markjfisher/fujinet-nio-hardware/README.md

# fujinet-nio-hardware
Hardware projects for NIO
