markjfisher/fujinet-nio-hardware/amiga/prototyping-board/fabrication/drill/report.txt

Drill report for zorro-breakout.kicad_pcb
Created on 2026-09-13T18:38:34

Copper Layer Stackup:
    =============================================================
    L1 :  F.Cu                      front
    L2 :  B.Cu                      back

Drill file 'zorro-breakout-PTH.drl' contains
    plated through holes:
    =============================================================
    T1  0.300mm  0.0118"  (136 holes))
    T2  1.000mm  0.0394"  (130 holes))

    Total plated holes count 266

Drill file 'zorro-breakout-NPTH.drl' contains
    unplated through holes:
    =============================================================

    Total unplated holes count 0
