markjfisher/fujinet-nio-hardware/amiga/integrated-a500-r5/review/front-sd/acceptance.md

# R5 single-sided component population accepted

The user approved the front-side C42/C43 candidate. Its reviewed placement,
orientation and labels are now transferred to authoritative R5.

**All 214 footprints are now front-side, enabling single-sided component
population.** Through-hole connectors/headers still require normal underside
soldering; there are no backside-mounted components.

MCP transferred the positions, rotations and labels. Its missing flip operation
was handled with native KiCad Flip for C42/C43 only, as disclosed before editing.
No routing, optimisation, schematic changes or board regeneration occurred.

Independent read-back confirms all 214 footprint records and all other board
objects match the approved candidate, including groups and locks. Only C42/C43
differ from the prior authoritative PCB. Schematic/project/library files remain
byte-identical. Native KiCad reports zero schematic parity issues and the same
reported DRC findings as the approved candidate: four existing J1 hole clearances,
199 capped text-height warnings, one intentional U30 library mismatch, and 499
capped unrouted connections. MCP DRC and audit also ran successfully; audit
findings retain the previously documented bounding-box and boundary limitations.

The approved closeups in this directory remain representative because the
complete footprint geometry and drawings match exactly. Retain the C42/C43
prospective ground vias in verification.json in place of their previous ESP/SD
review sites. No physical vias have been added. Actual copper remains subject
to routing validation.

Evidence: transfer-verification.json. The original verify.py is the pre-transfer
candidate-versus-baseline check; it was run successfully before this transfer
and its historical verification.json is retained.
