markjfisher/fujinet-nio-hardware/amiga/integrated-a500-r5/review/bus-buffers/acceptance.md

# Bus-buffer acceptance and transfer — 2026-11-11

User-approved buffer placement transferred to authoritative R5 via kicad-mcp:
U40–U47, C50–C57 and R50–R53, including reviewed reference positions.
Native KiCad transferred the eight reviewed groups and the reviewed buffer
corridor reservation setting because MCP lacks those operations. No outline,
connector, schematic, net, lock or unrelated footprint changes were made.

Read-back confirms the entire parsed authoritative PCB equals the approved
bus-buffer candidate, including all footprints and non-footprint objects.
[Transfer DRC](../host-protection/transfer-drc.json) exactly matches the accepted
baseline: four J1 hole-clearance errors, 199 text-height warnings, one intentional
U30 library-mismatch warning, 499 unrouted connections, zero parity issues.
See [verification](../host-protection/verification.json) for preservation checks.

Retain the sixteen proposed ground vias and buffer-corridor ownership check.
The current outline is not an absolute limit: propose a modest vertical extension
if later placement needs more room. Approval is required before changing it;
J40's exact mechanical geometry and mating position must remain fixed.
