markjfisher/fujinet-nio-hardware/amiga/integrated-a500-r5/review/indicators/transfer/acceptance.md

# Approved indicator transfer
The user approved the complete LED candidate as-is. Transferred its LED circuit,
11 footprints, service-header/button geometry, labels and groups to authoritative
R5. All 214 footprint S-expressions and all non-net board objects match the
approved candidate; esp.kicad_sch matches byte-for-byte. Other schematic sheets
remain unchanged. No routing.

Used MCP schematic load/save, footprint placement/movement, reference and text
operations, and 24 pad-net assignments. Used native KiCad only for unsupported
new-object identity, library/path binding and group restoration.

Native KiCad DRC with schematic parity: 0 parity issues; 4 existing J1 hole
clearances, 199 reported text-height warnings, 1 intentional U30 library mismatch,
499 reported unrouted connections. Text and unrouted reports are capped; these
counts are not a complete count of affected objects. The approved indicator
candidate already accounts for the additional 0.6 mm reference-height warnings.
Service access remains provisional for enclosure validation.
