markjfisher/fujinet-nio-hardware/amiga/integrated-a500-r4/phase1/board-and-staging.png

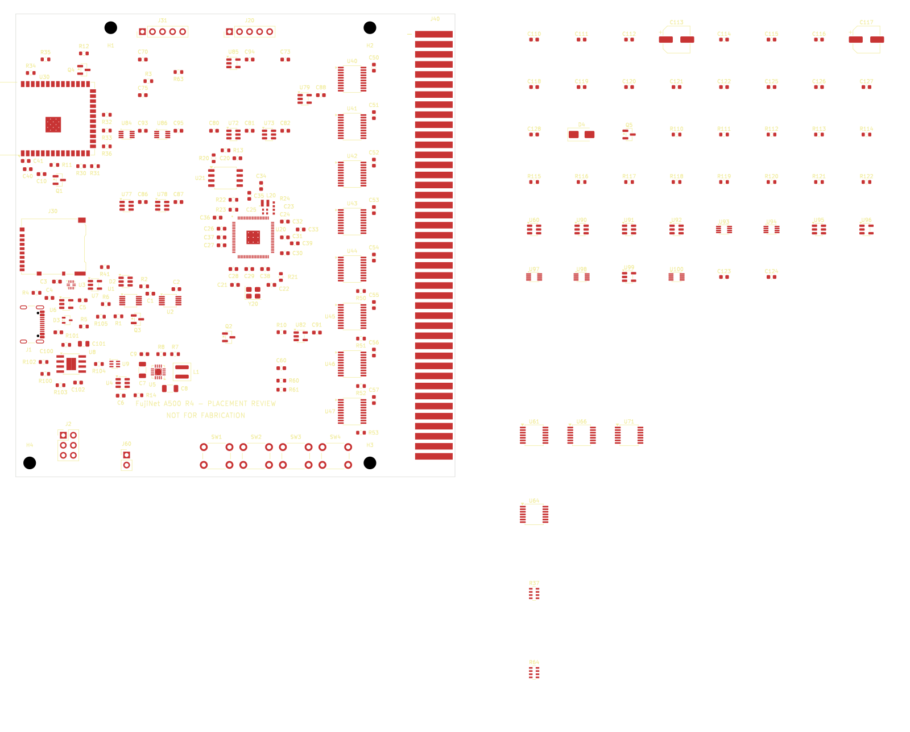
amiga/integrated-a500-r4/phase1/board-and-staging.png
