markjfisher/fujinet-nio-hardware/amiga/integrated-a500-r4/phase1/control-preview.png

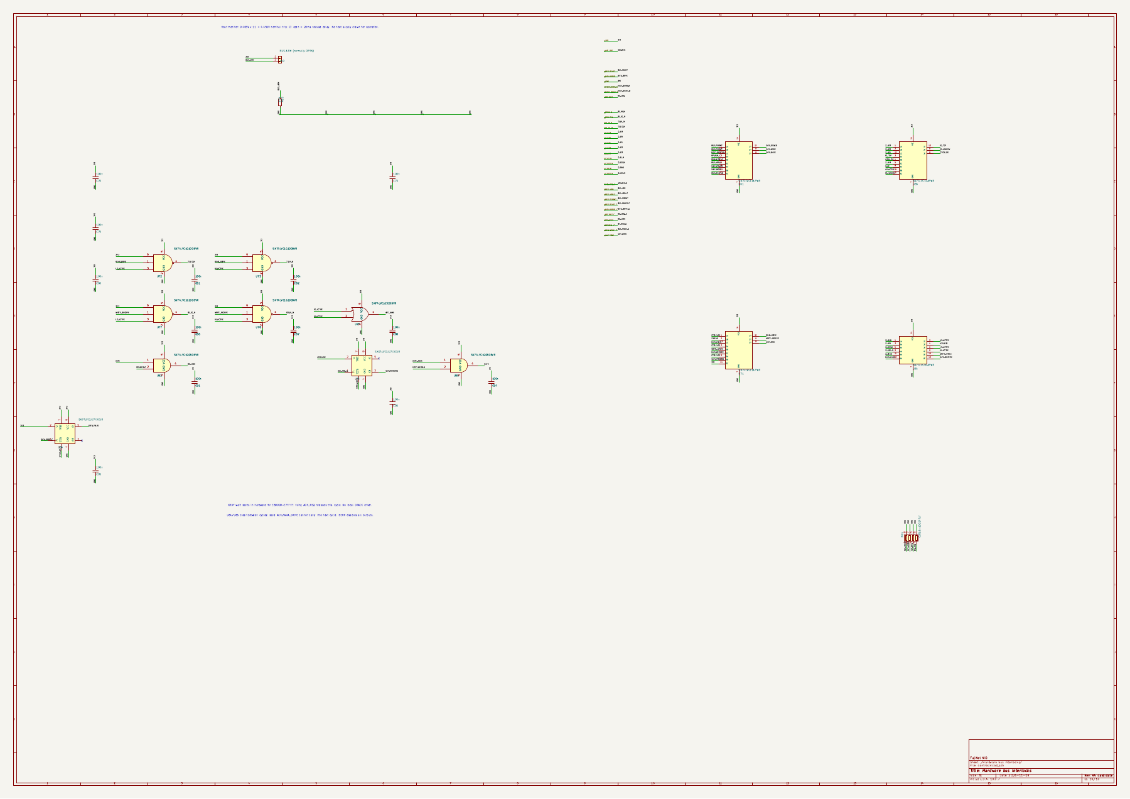
amiga/integrated-a500-r4/phase1/control-preview.png
