markjfisher/fujinet-nio-hardware/amiga/integrated-a500-r4/review/cadmust-integration/caps.png

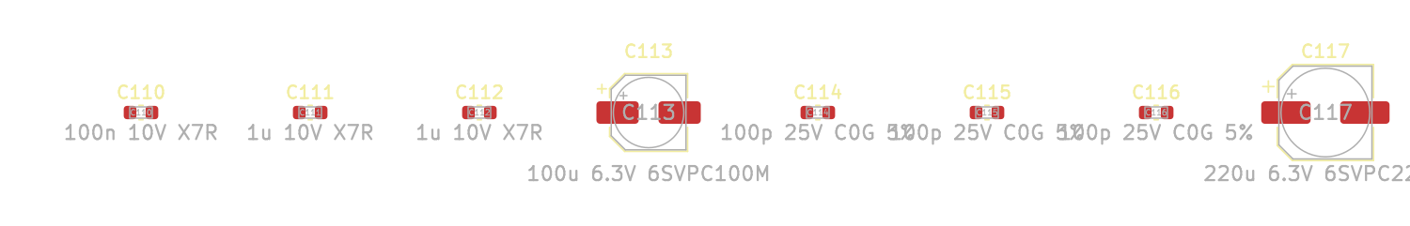
amiga/integrated-a500-r4/review/cadmust-integration/caps.png
