markjfisher/fujinet-nio-hardware/amiga/integrated-a500-r4/review/cadmust-trial-01/comparison.png

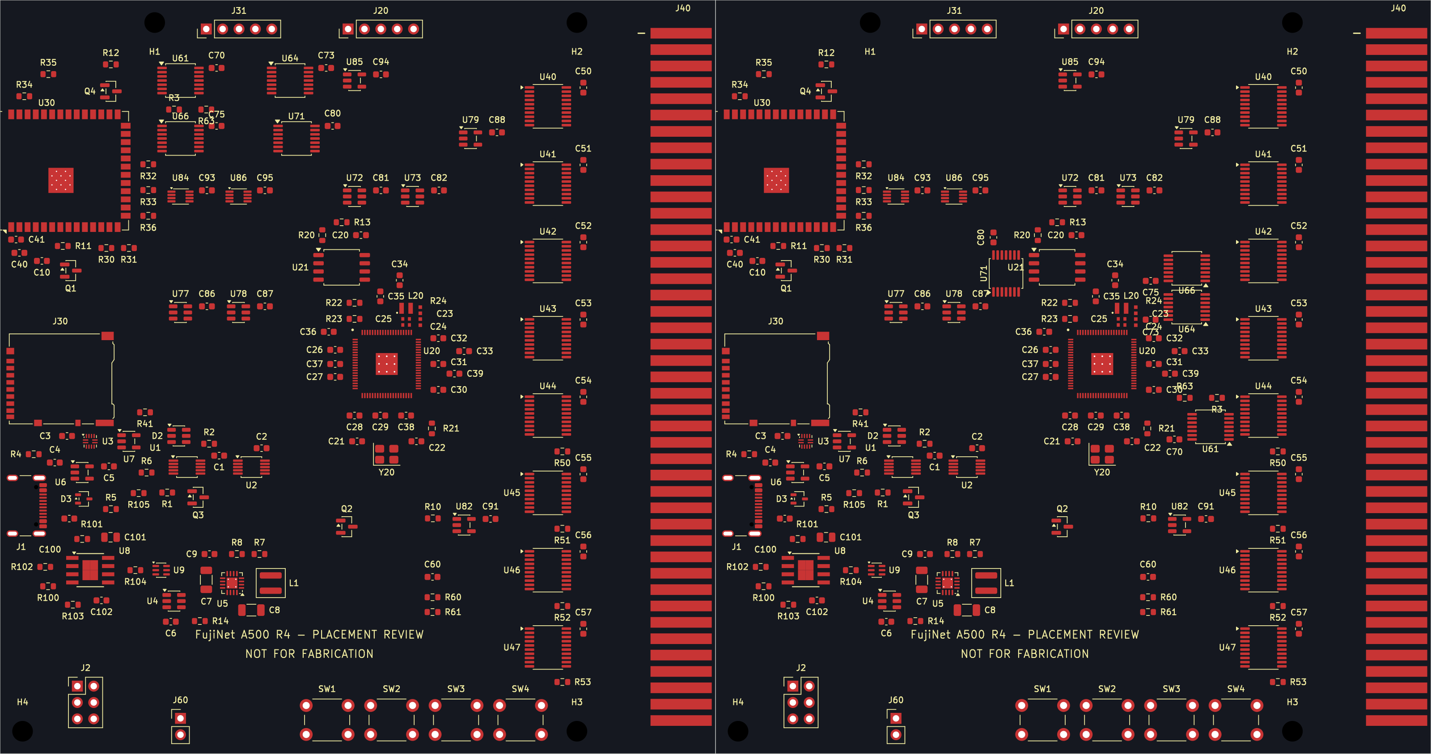
amiga/integrated-a500-r4/review/cadmust-trial-01/comparison.png
