markjfisher/fujinet-nio-hardware/amiga/integrated-a500-r4/review/placement.png

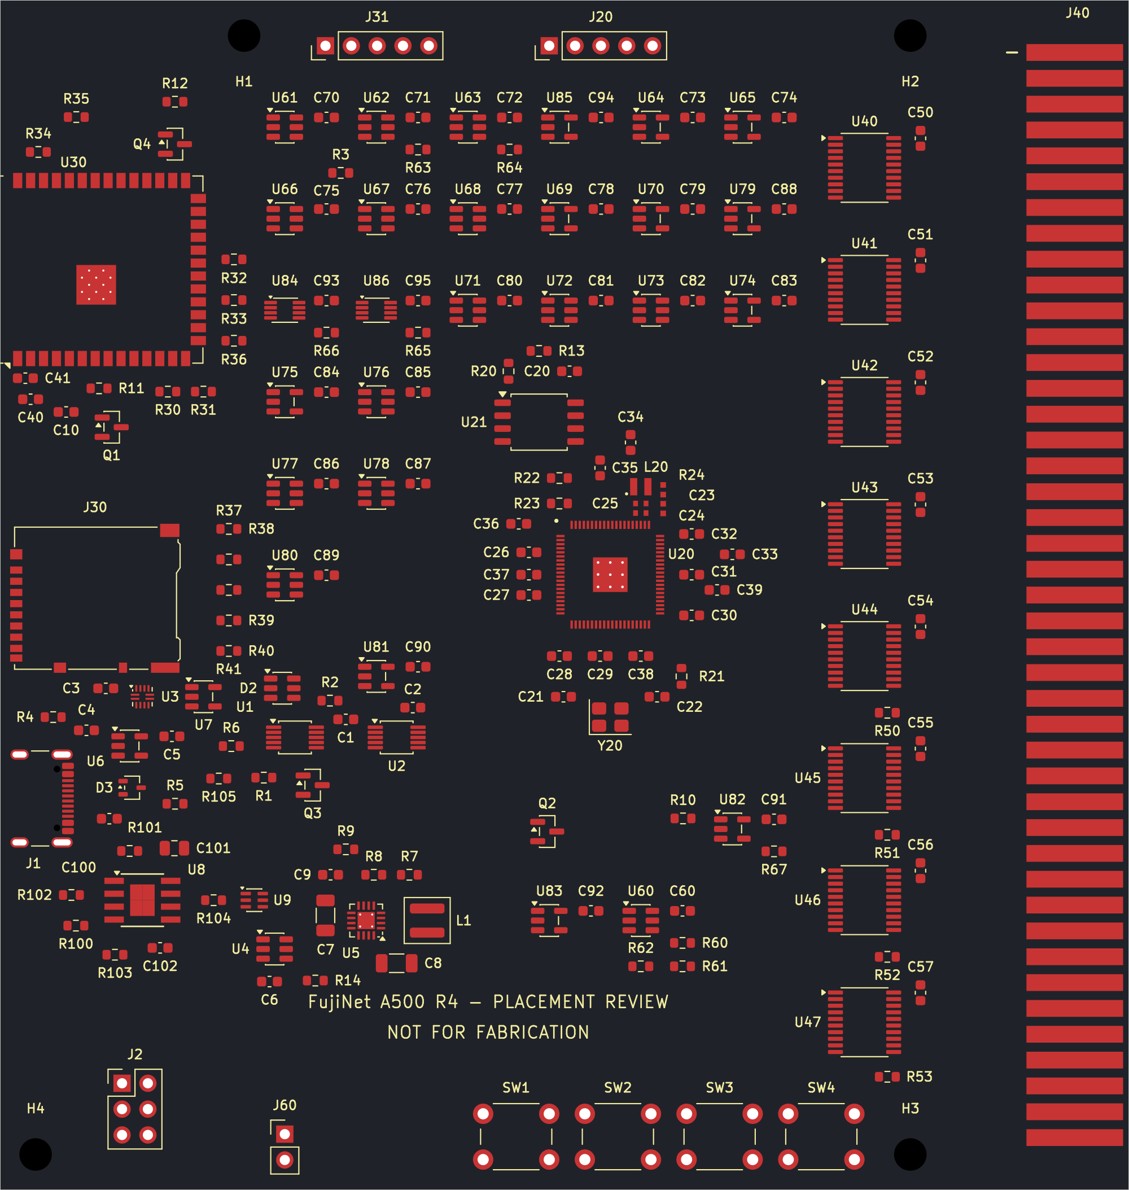
amiga/integrated-a500-r4/review/placement.png
