markjfisher/fujinet-nio-hardware/amiga/integrated-a500-r5/review/bus-buffers/address-pad-nets.png

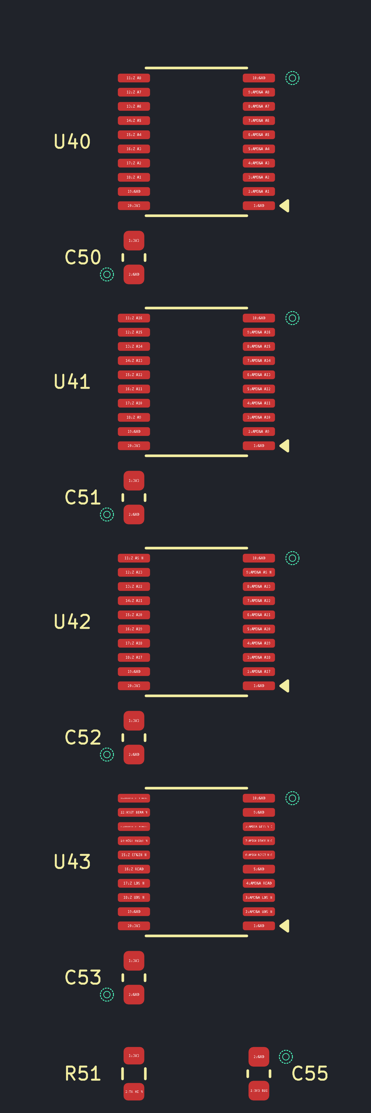
amiga/integrated-a500-r5/review/bus-buffers/address-pad-nets.png
