markjfisher/fujinet-nio-hardware/amiga/integrated-a500-r5/review/control-logic/context.png

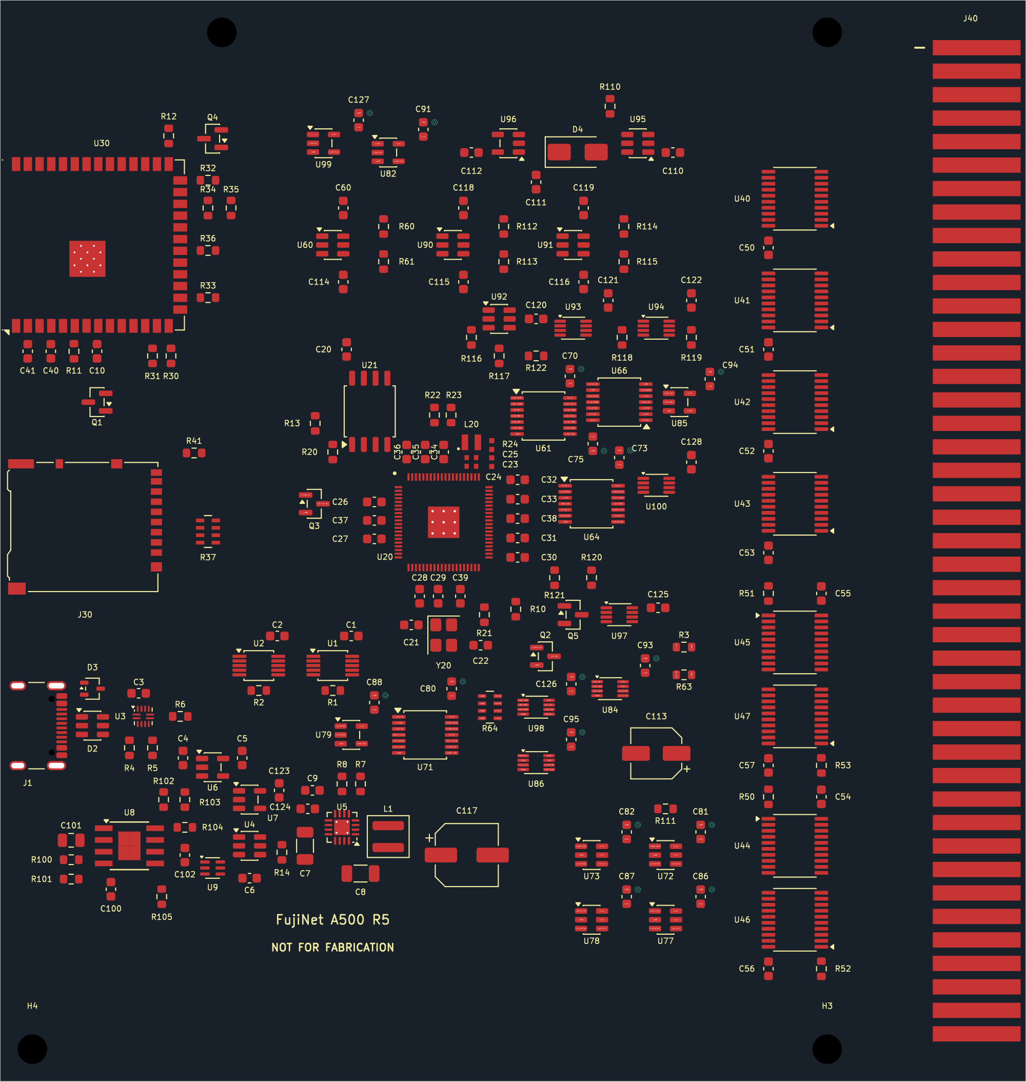
amiga/integrated-a500-r5/review/control-logic/context.png
