markjfisher/fujinet-nio-hardware/amiga/integrated-a500-r5/review/control-logic/enables-pad-nets.png

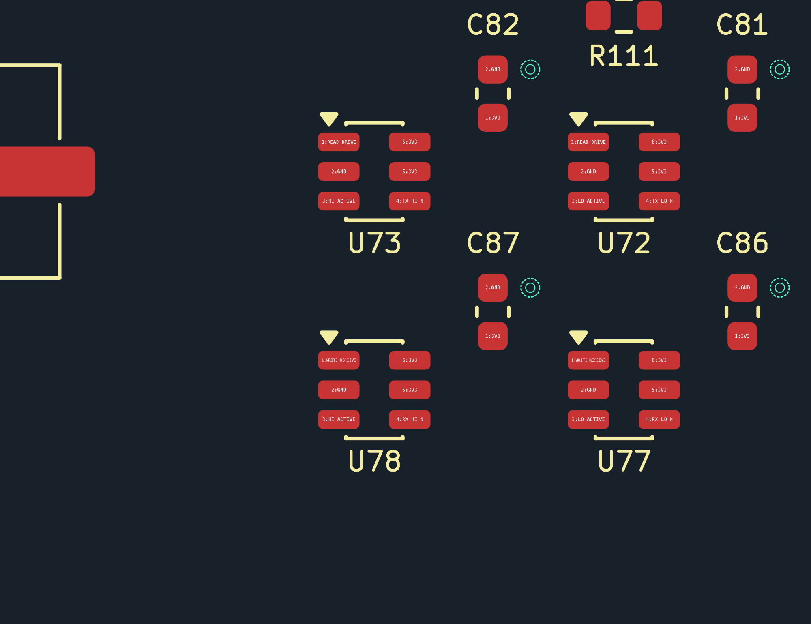
amiga/integrated-a500-r5/review/control-logic/enables-pad-nets.png
