markjfisher/fujinet-nio-hardware/amiga/integrated-a500-r5/review/control-logic/irq-pad-nets.png

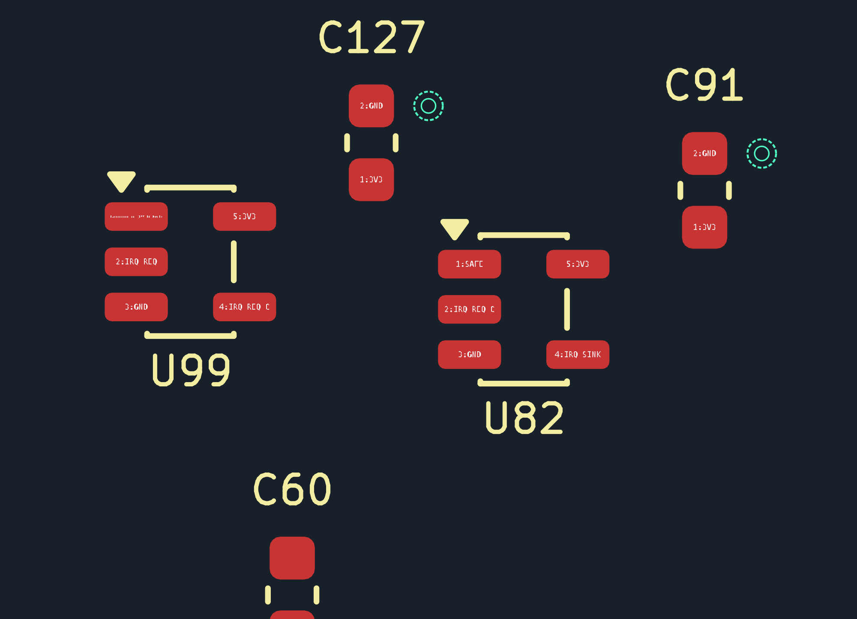
amiga/integrated-a500-r5/review/control-logic/irq-pad-nets.png
