markjfisher/fujinet-nio-hardware/amiga/integrated-a500-r5/review/control-logic/latches-pad-nets.png

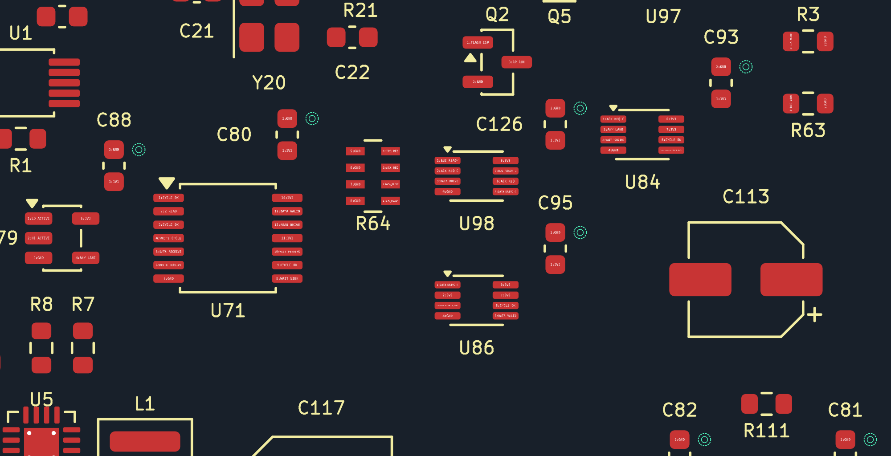
amiga/integrated-a500-r5/review/control-logic/latches-pad-nets.png
