markjfisher/fujinet-nio-hardware/amiga/integrated-a500-r5/review/control-logic/qualifier-pad-nets.png

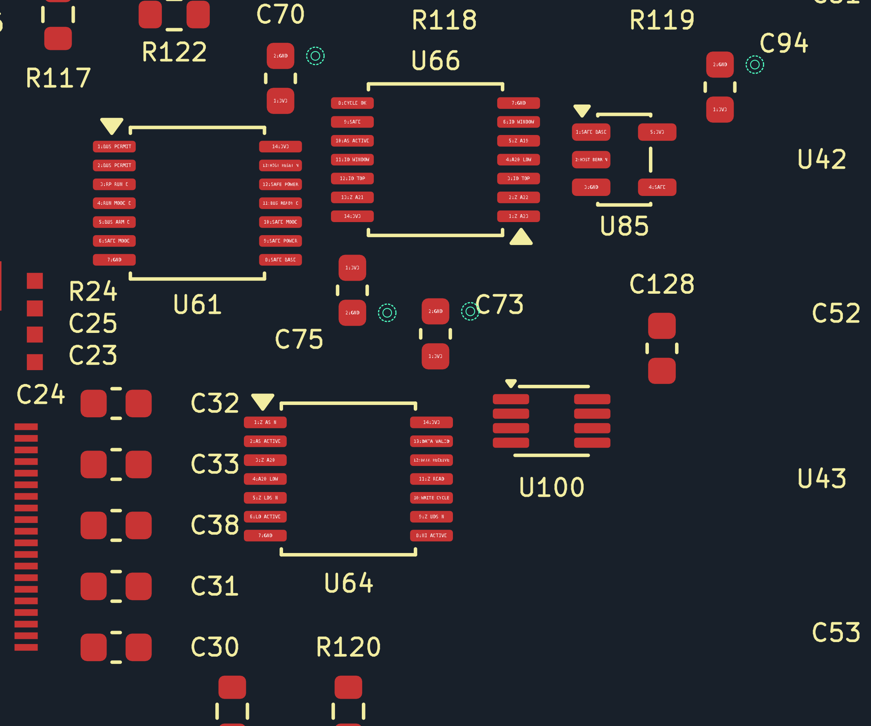
amiga/integrated-a500-r5/review/control-logic/qualifier-pad-nets.png
