markjfisher/fujinet-nio-hardware/amiga/integrated-a500-r5/review/esp-sd/back-pad-nets.png

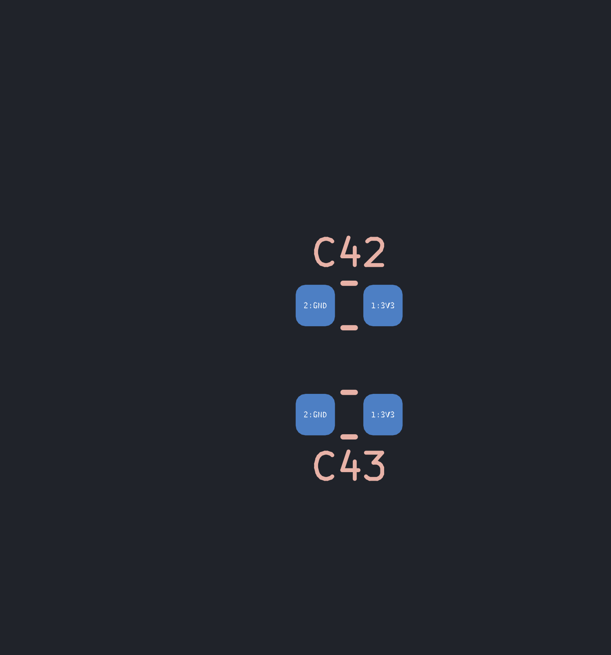
amiga/integrated-a500-r5/review/esp-sd/back-pad-nets.png
