markjfisher/fujinet-nio-hardware/amiga/integrated-a500-r5/review/esp-sd/context.png

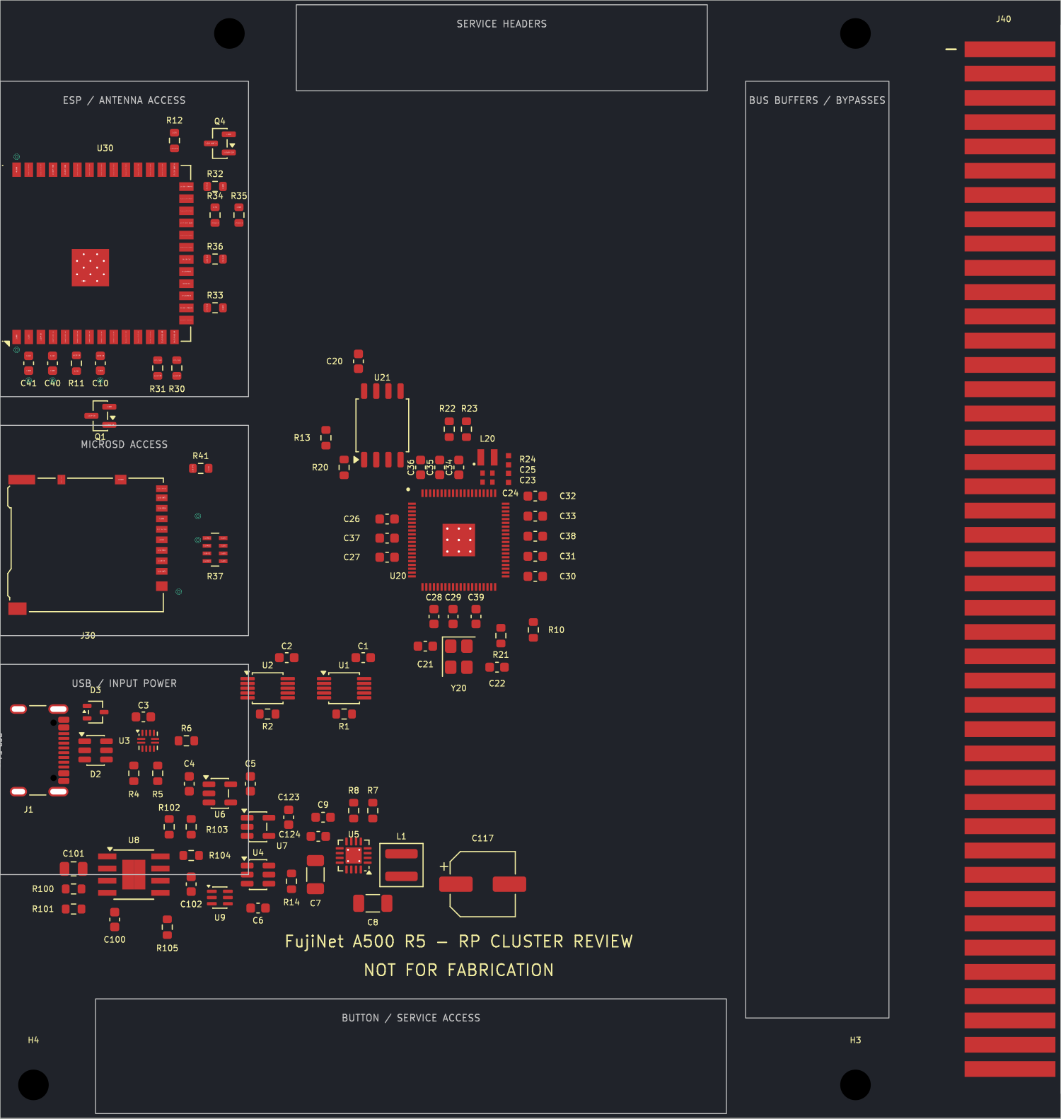
amiga/integrated-a500-r5/review/esp-sd/context.png
