markjfisher/fujinet-nio-hardware/amiga/integrated-a500-r5/review/esp-sd/pad-nets.png

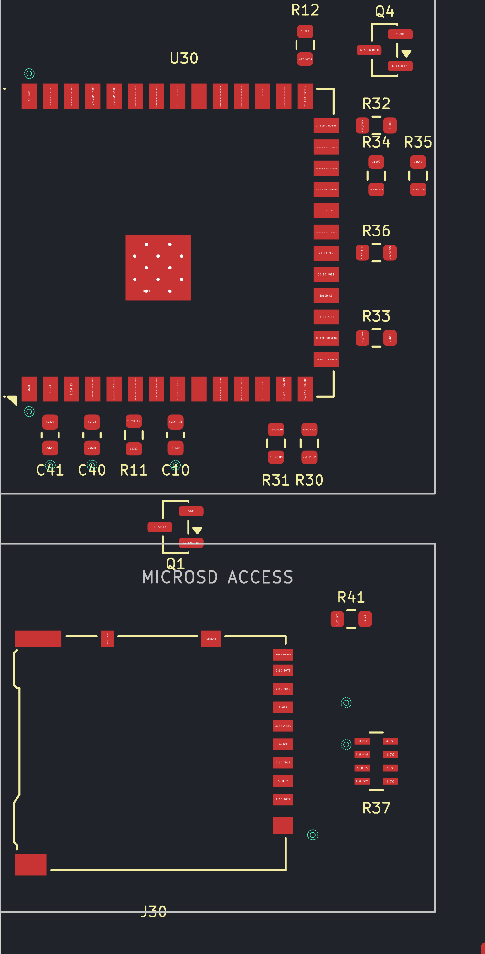
amiga/integrated-a500-r5/review/esp-sd/pad-nets.png
