markjfisher/fujinet-nio-hardware/amiga/integrated-a500-r5/review/front-sd/closeup.png

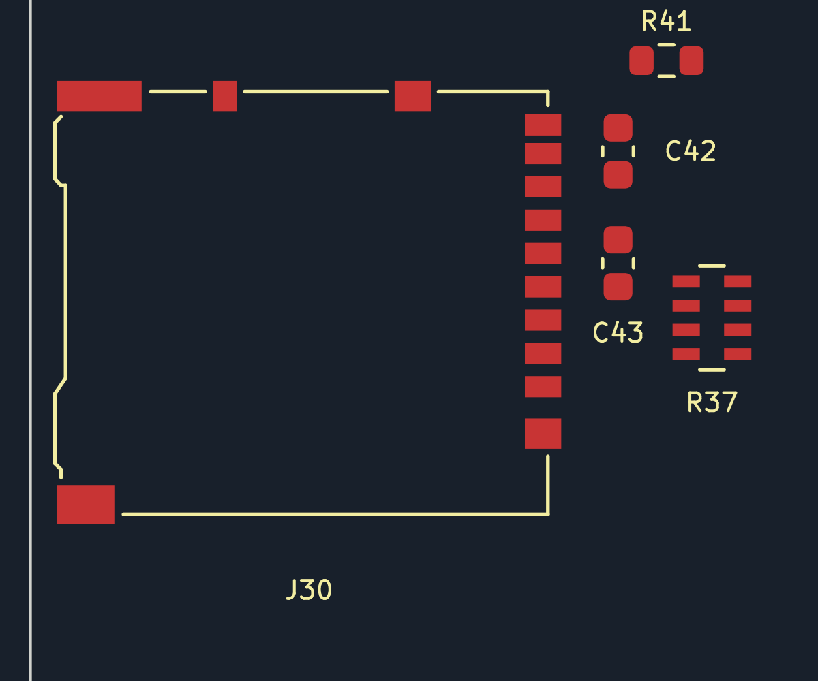
amiga/integrated-a500-r5/review/front-sd/closeup.png
