markjfisher/fujinet-nio-hardware/amiga/integrated-a500-r5/review/host-protection/context.png

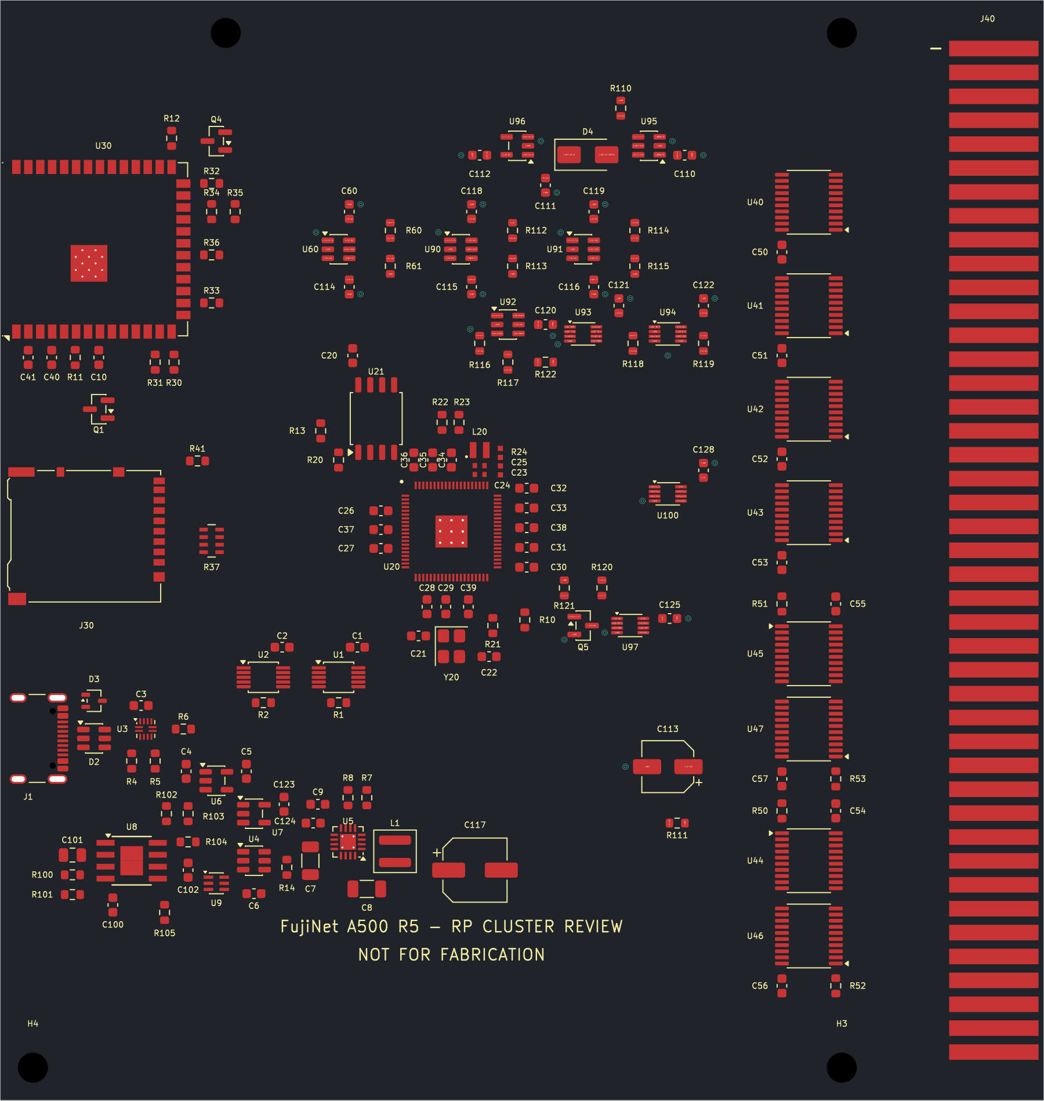
amiga/integrated-a500-r5/review/host-protection/context.png
