markjfisher/fujinet-nio-hardware/amiga/integrated-a500-r5/review/host-protection/hold-up-pad-nets.png

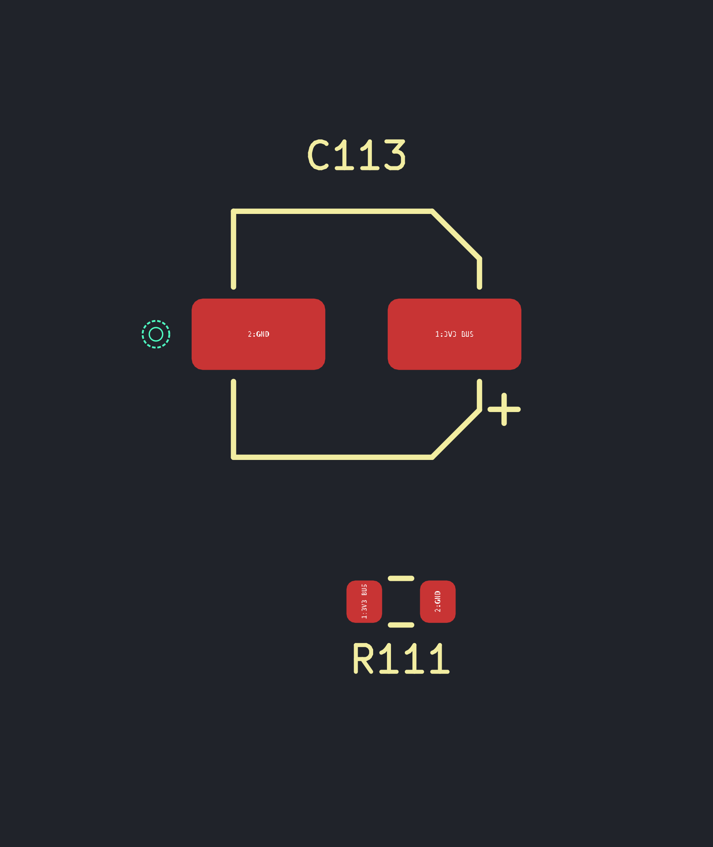
amiga/integrated-a500-r5/review/host-protection/hold-up-pad-nets.png
