markjfisher/fujinet-nio-hardware/amiga/integrated-a500-r5/review/host-protection/reset-pad-nets.png

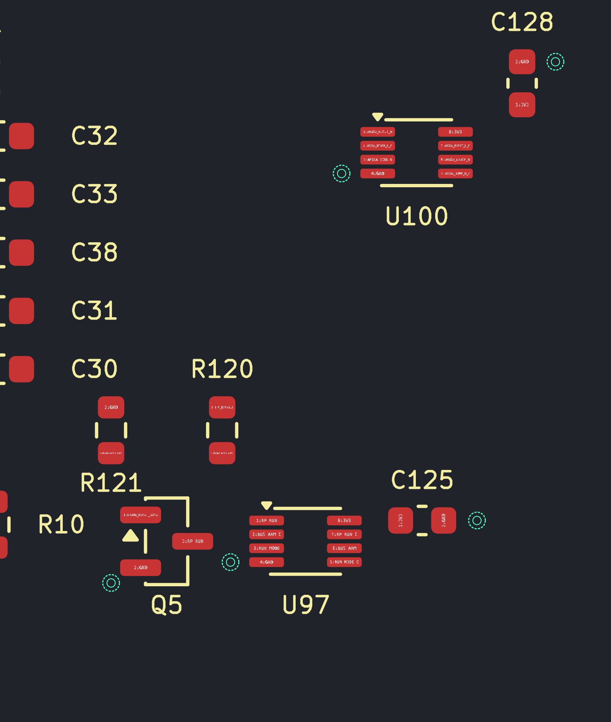
amiga/integrated-a500-r5/review/host-protection/reset-pad-nets.png
