markjfisher/fujinet-nio-hardware/amiga/integrated-a500-r5/review/host-protection/supervision-pad-nets.png

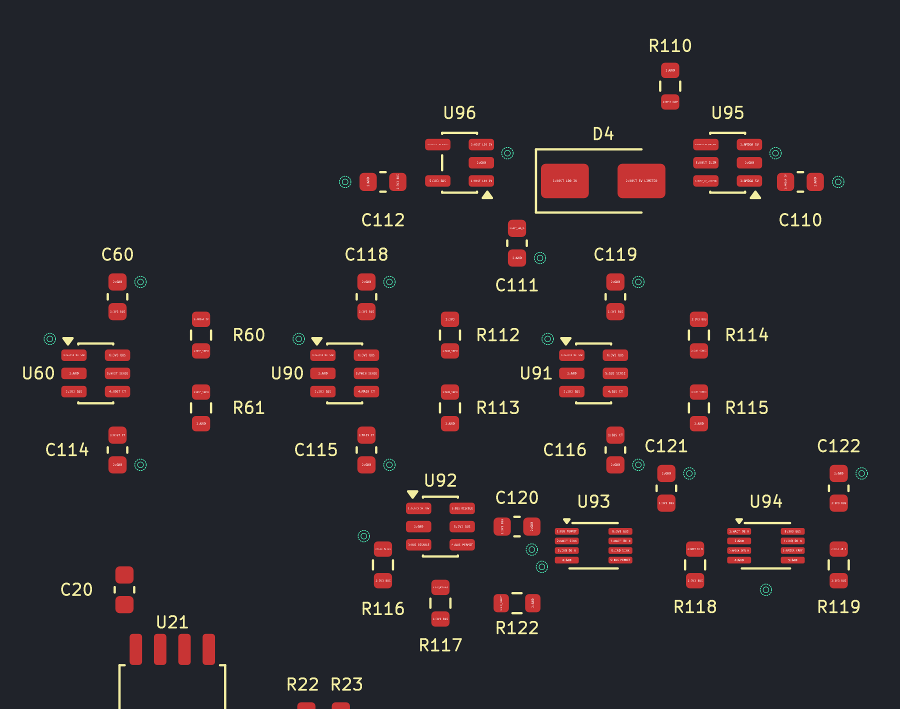
amiga/integrated-a500-r5/review/host-protection/supervision-pad-nets.png
