markjfisher/fujinet-nio-hardware/amiga/integrated-a500-r5/review/indicators/context.png

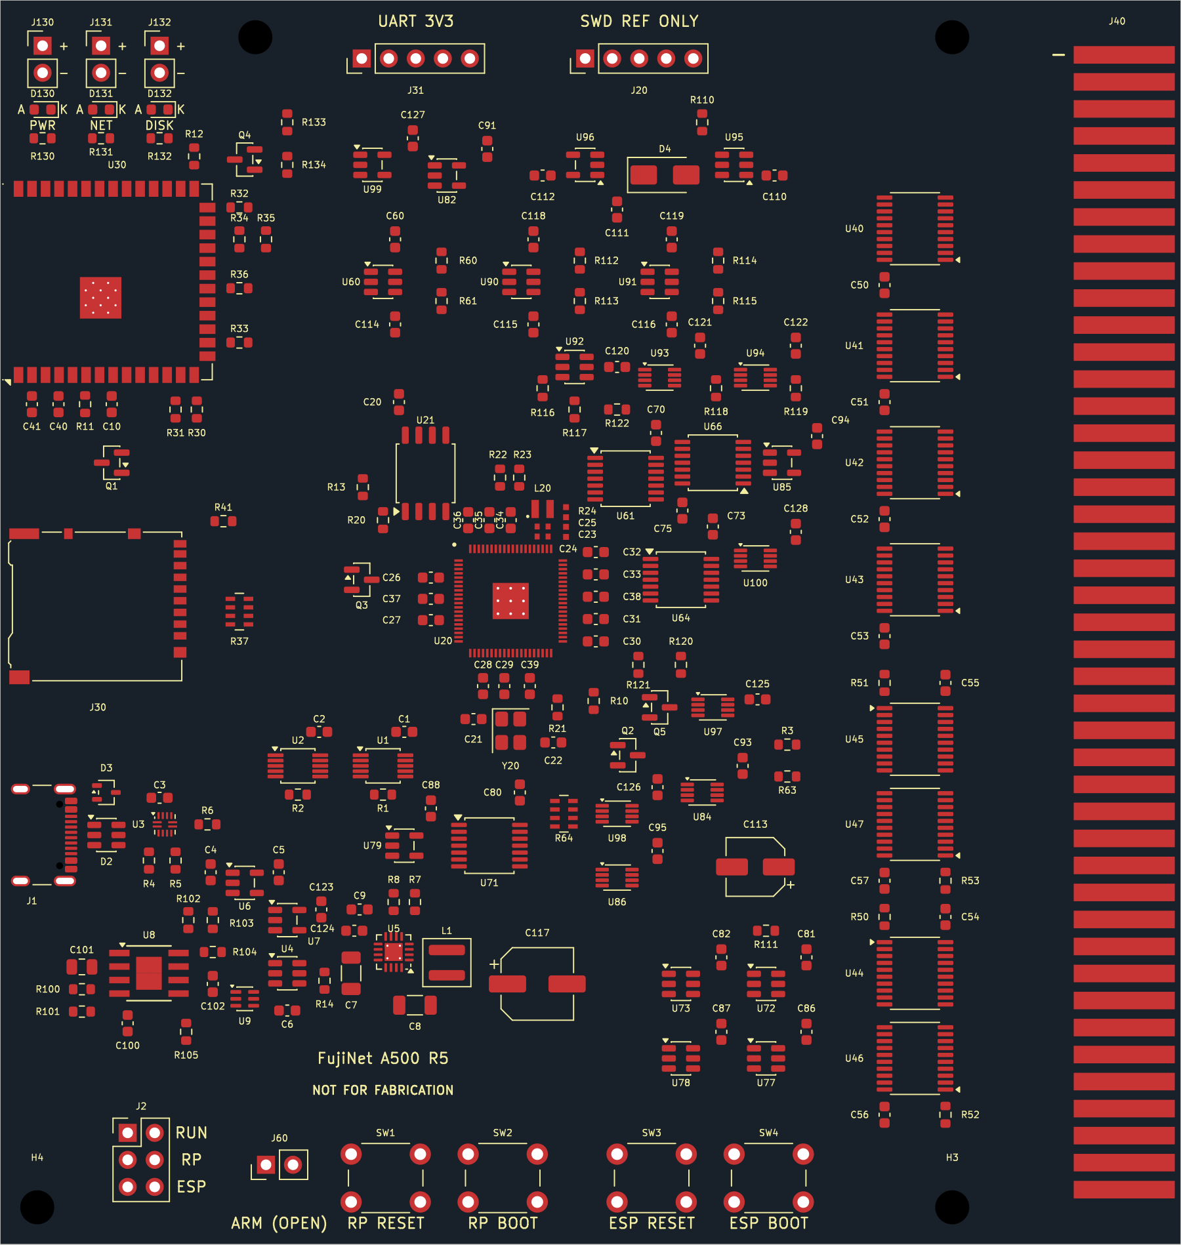
amiga/integrated-a500-r5/review/indicators/context.png
