markjfisher/fujinet-nio-hardware/amiga/integrated-a500-r5/review/indicators/schematic-closeup.png

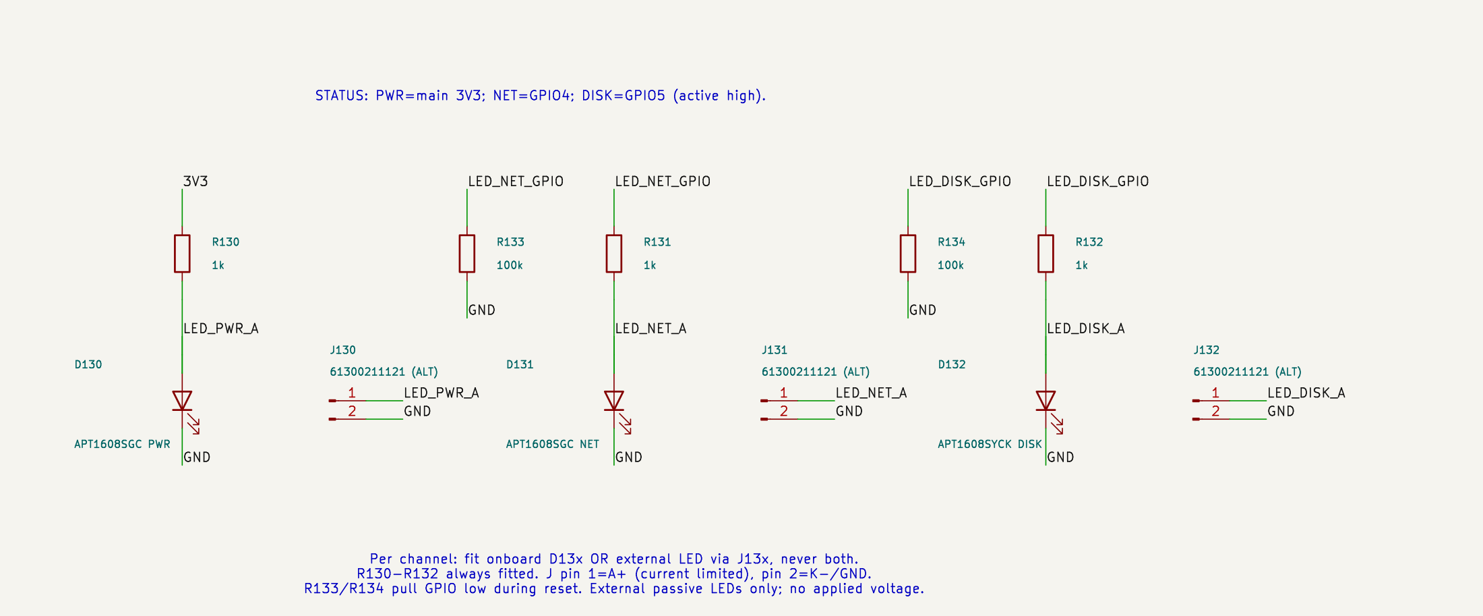
amiga/integrated-a500-r5/review/indicators/schematic-closeup.png
