markjfisher/fujinet-nio-hardware/amiga/integrated-a500-r5/review/milestone-1/overview.png

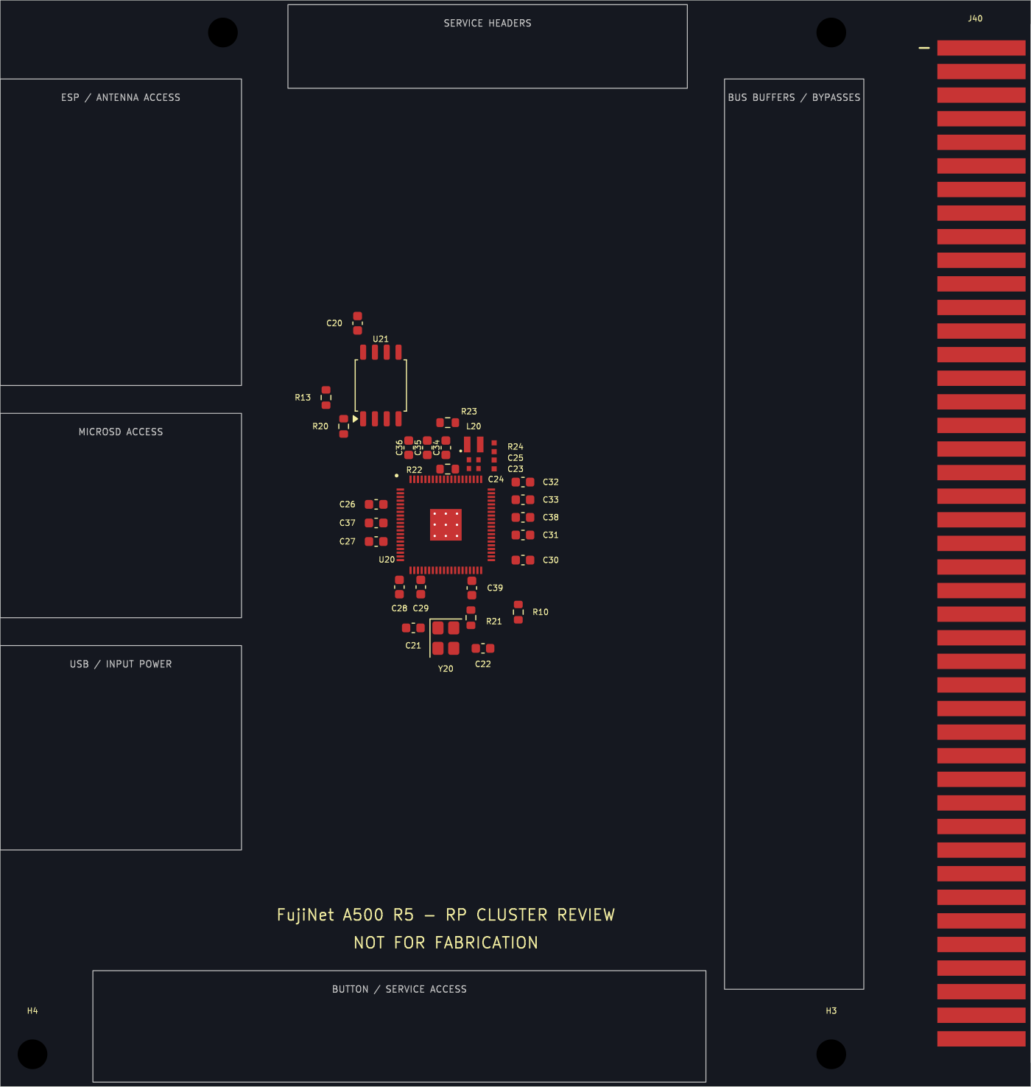
amiga/integrated-a500-r5/review/milestone-1/overview.png
