markjfisher/fujinet-nio-hardware/amiga/integrated-a500-r5/review/pad-refinement/north-pad-nets.png

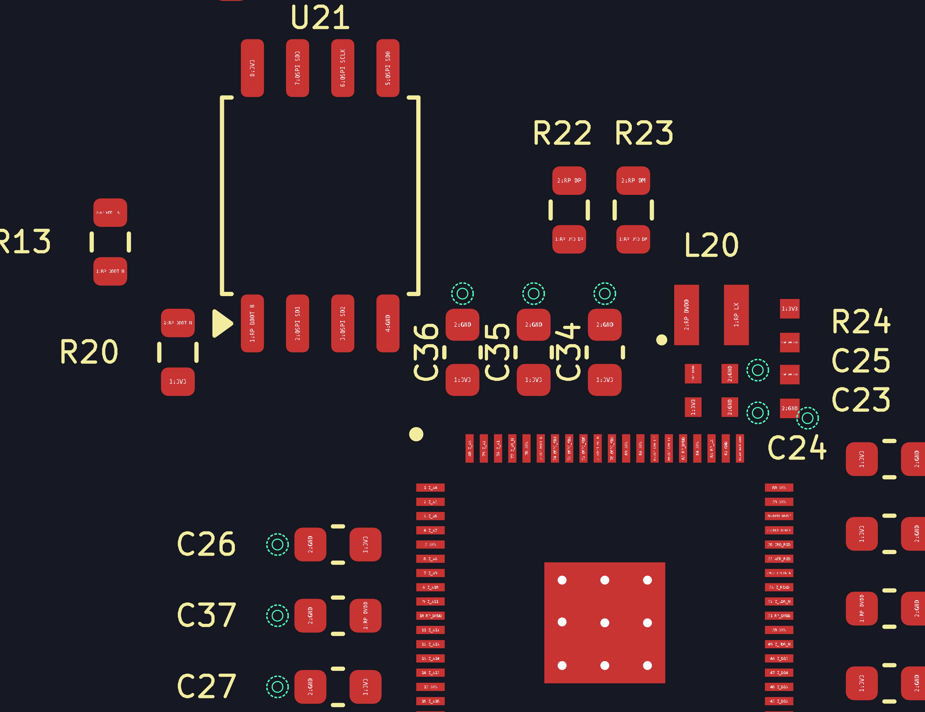
amiga/integrated-a500-r5/review/pad-refinement/north-pad-nets.png
