markjfisher/fujinet-nio-hardware/amiga/integrated-a500-r5/review/pad-refinement/pad-nets.png

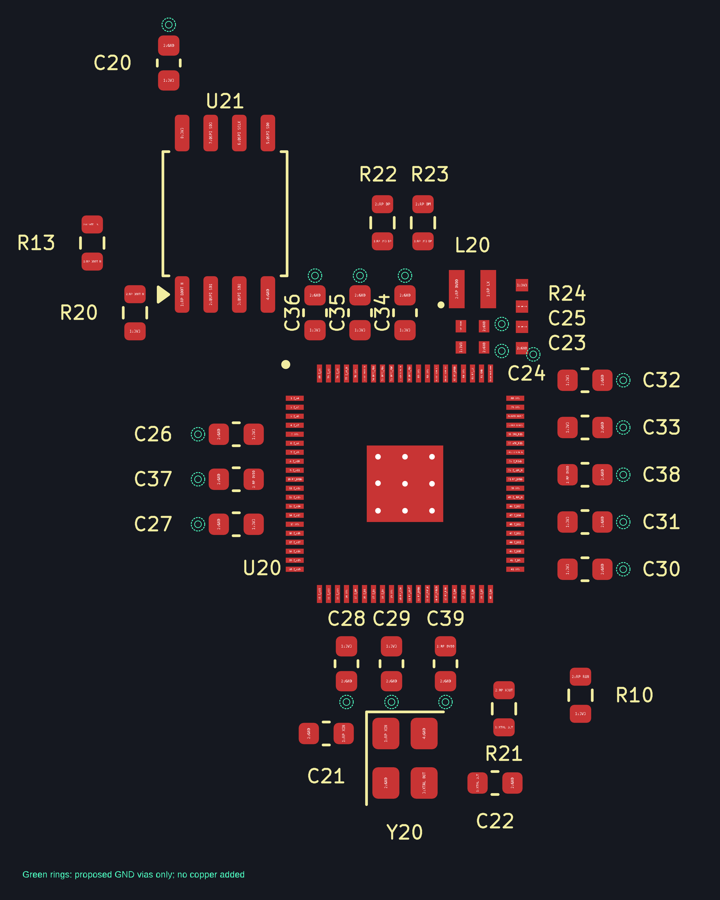
amiga/integrated-a500-r5/review/pad-refinement/pad-nets.png
