markjfisher/fujinet-nio-hardware/amiga/integrated-a500-r5/review/pad-refinement/south-pad-nets.png

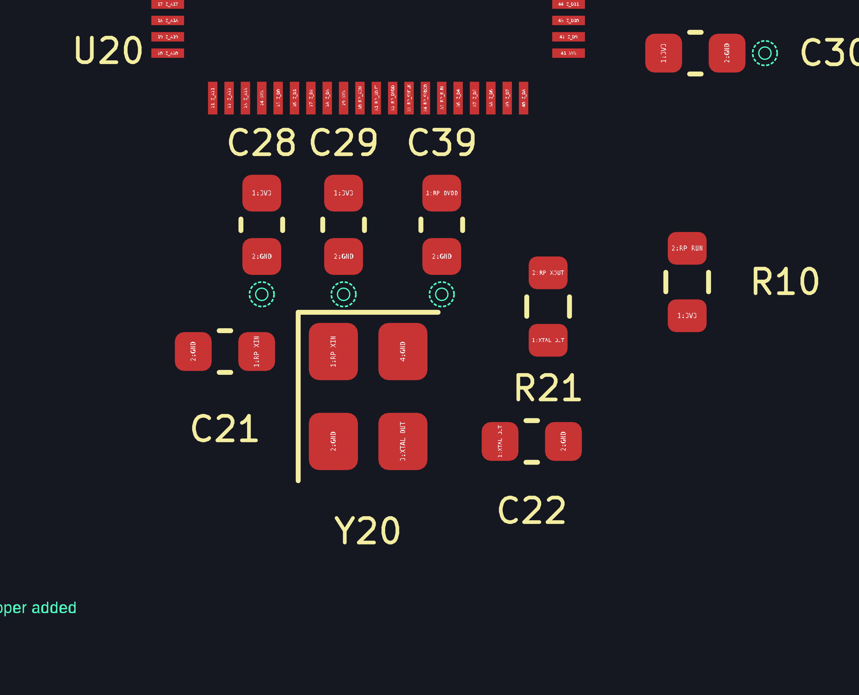
amiga/integrated-a500-r5/review/pad-refinement/south-pad-nets.png
