markjfisher/fujinet-nio-hardware/amiga/integrated-a500-r5/review/service/controls-pad-nets.png

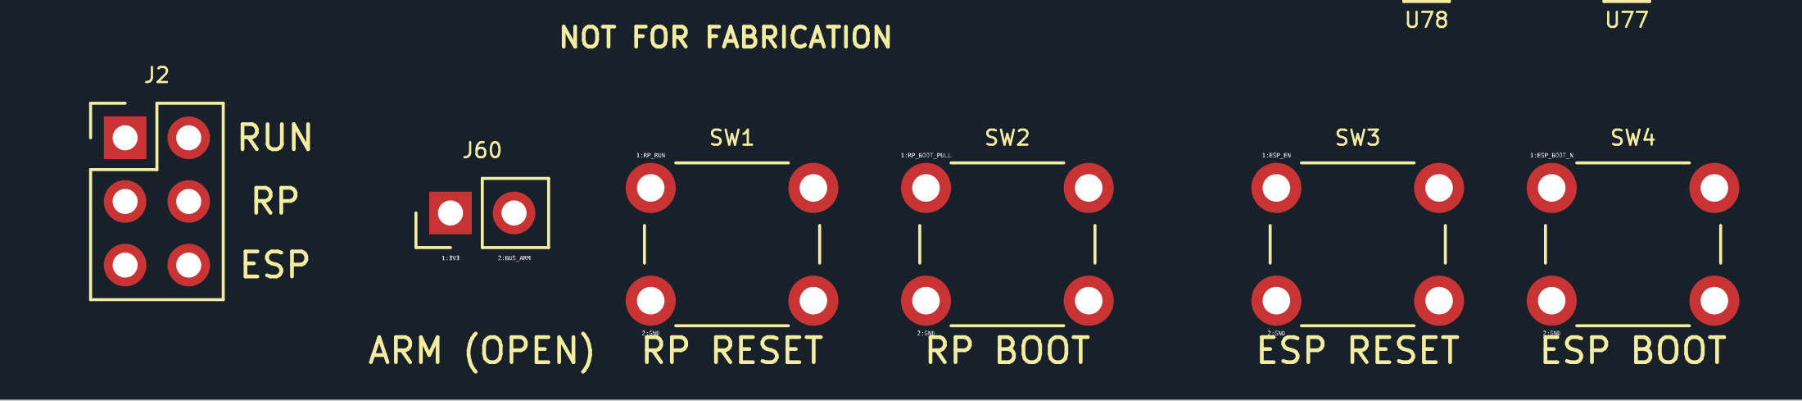
amiga/integrated-a500-r5/review/service/controls-pad-nets.png
