markjfisher/fujinet-nio-hardware/amiga/integrated-a500-r5/review/usb-mux/overview.png

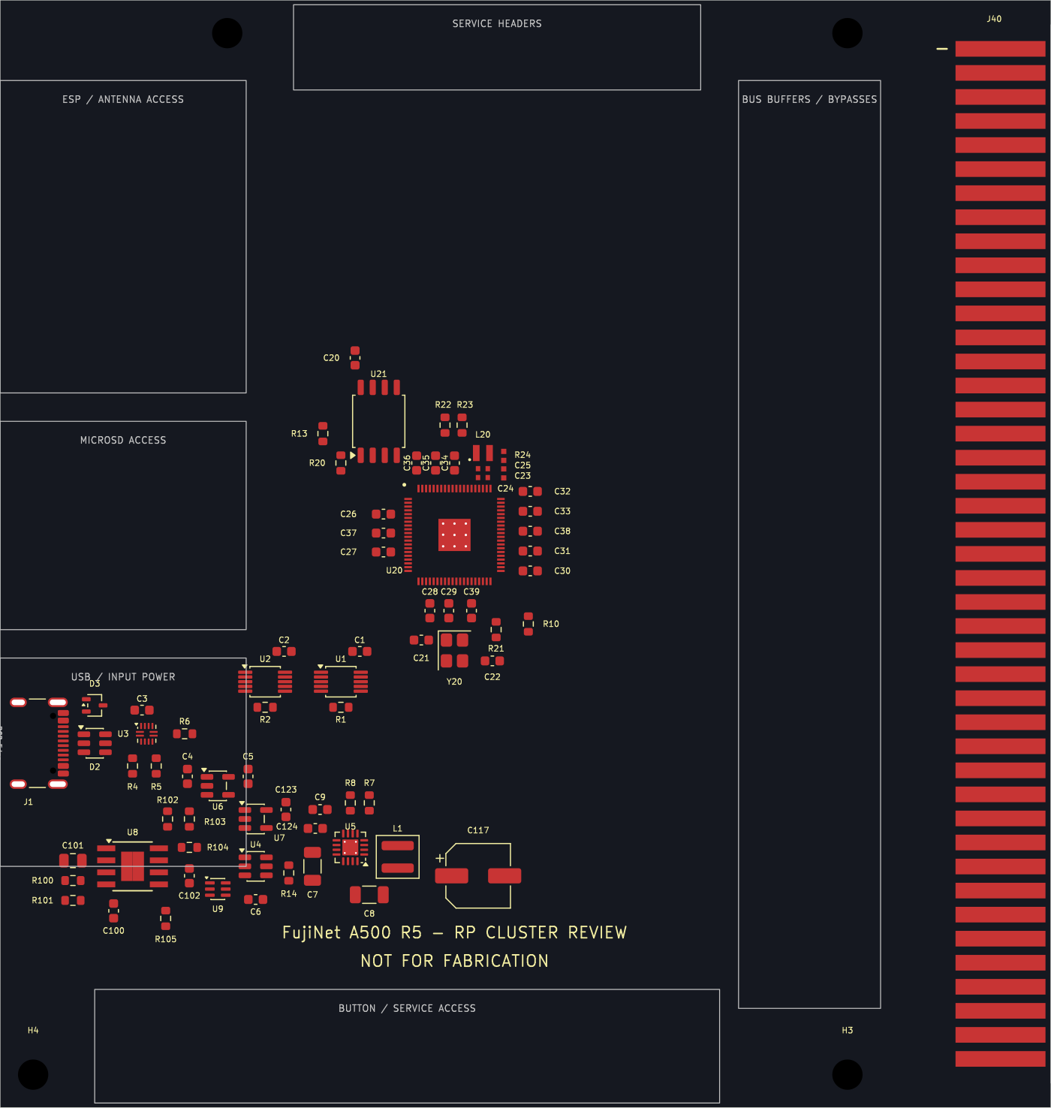
amiga/integrated-a500-r5/review/usb-mux/overview.png
