markjfisher/fujinet-nio-hardware/amiga/integrated-a500-r5/review/usb-power/buck-pad-nets.png

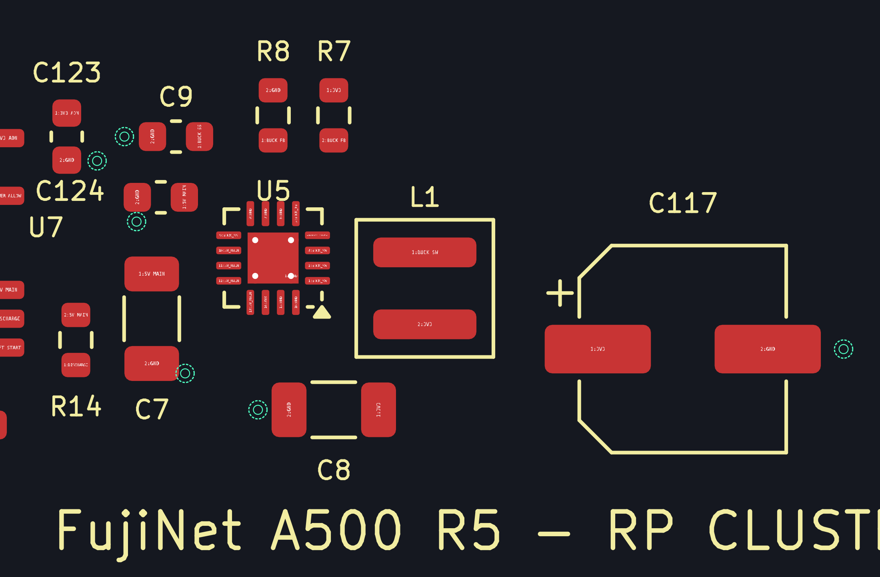
amiga/integrated-a500-r5/review/usb-power/buck-pad-nets.png
