markjfisher/fujinet-nio-hardware/amiga/integrated-a500-r5/review/usb-power/corridor/assessment.png

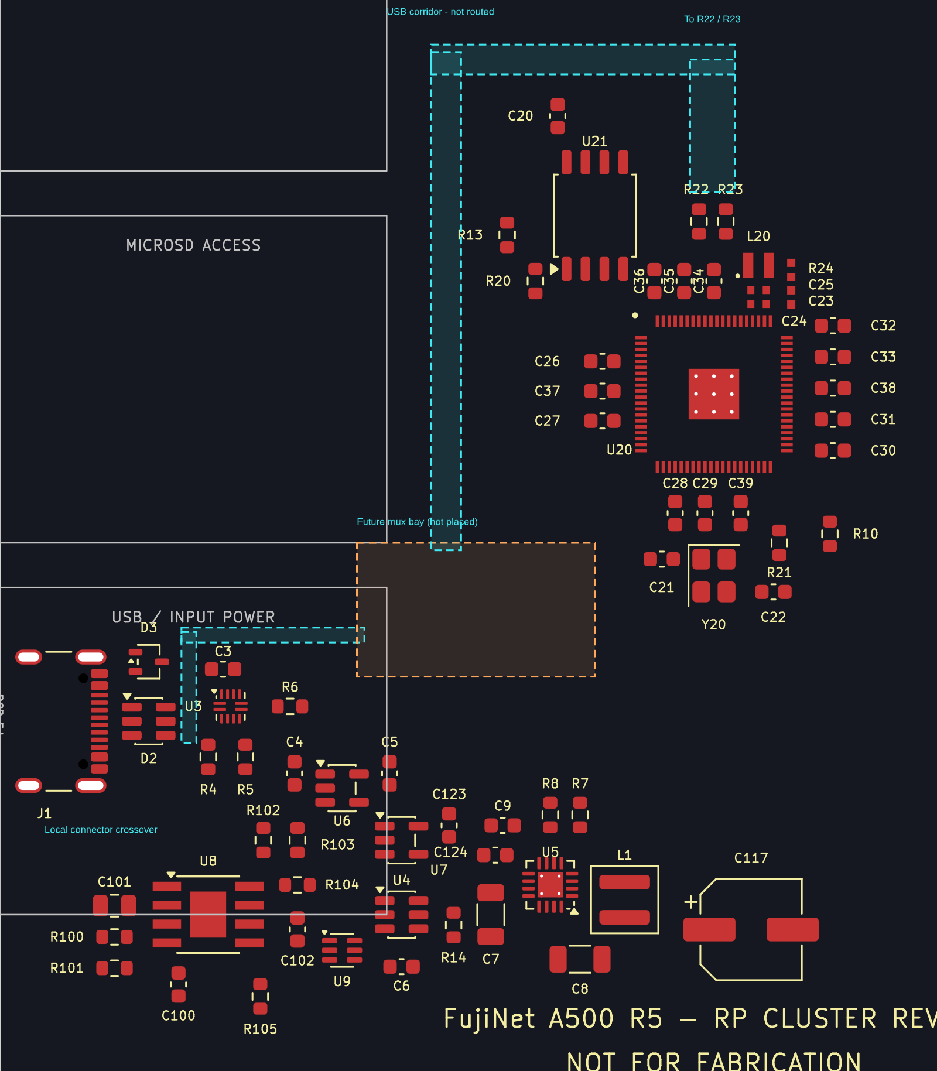
amiga/integrated-a500-r5/review/usb-power/corridor/assessment.png
