markjfisher/fujinet-nio-hardware/amiga/integrated-a500-r5/review/usb-power/input-pad-nets.png

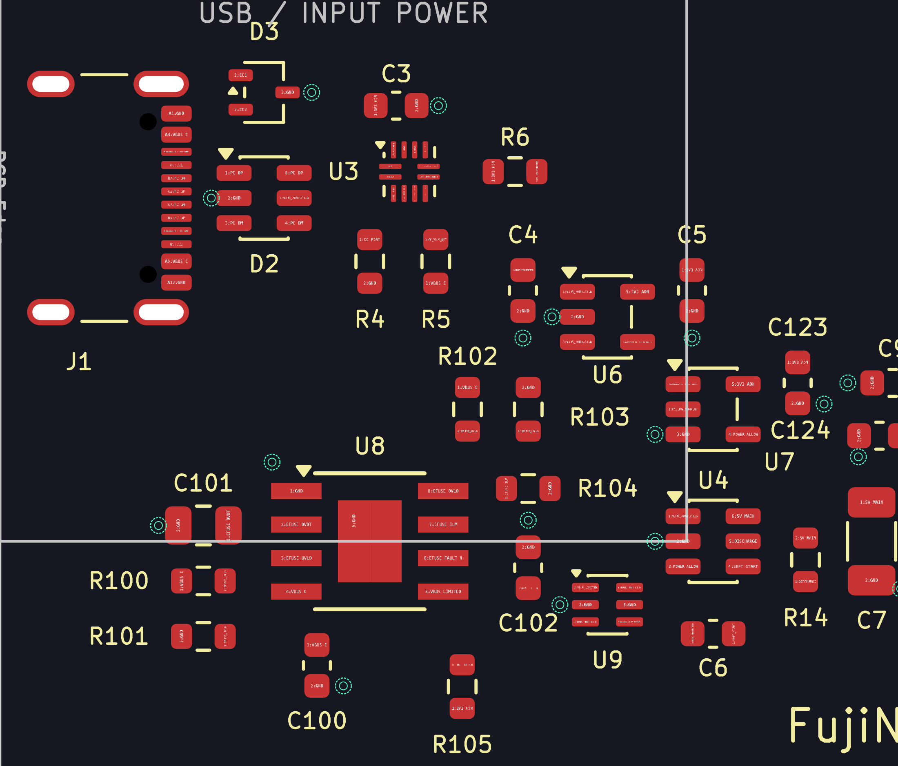
amiga/integrated-a500-r5/review/usb-power/input-pad-nets.png
