markjfisher/fujinet-nio-hardware/amiga/prototyping-board/docs/a5.png

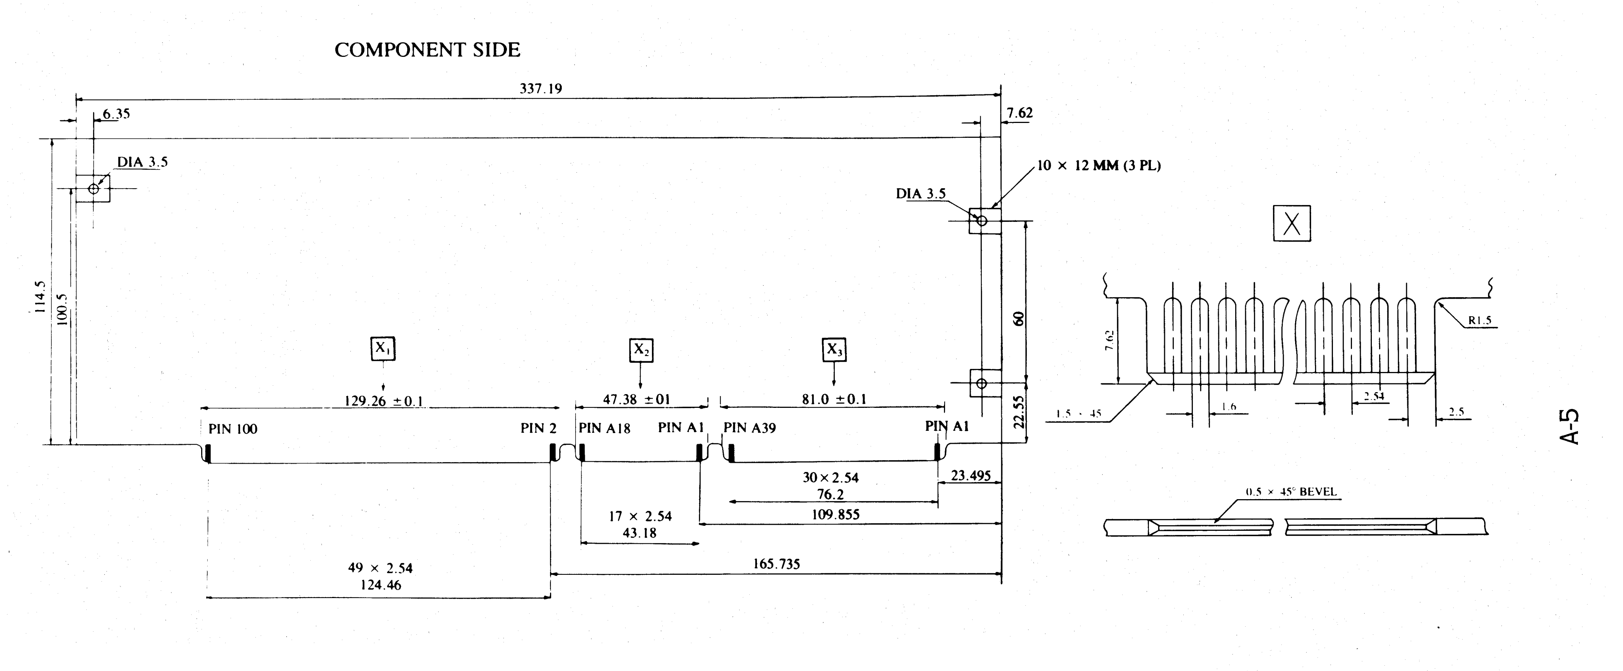
amiga/prototyping-board/docs/a5.png
