markjfisher/fujinet-nio-hardware/amiga/prototyping-board/review/layout-front.png

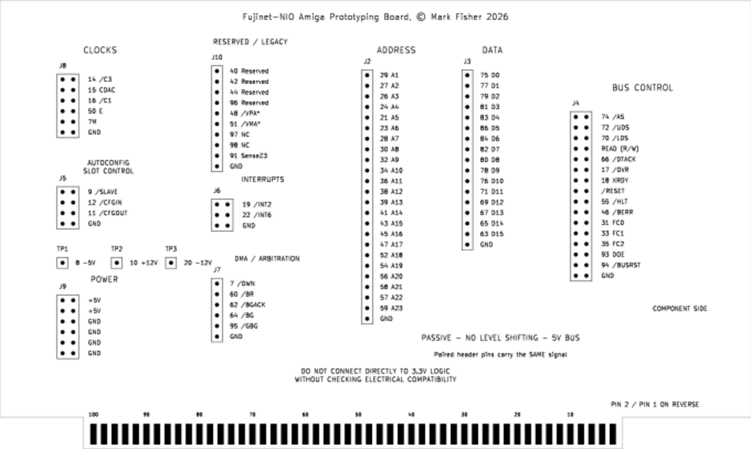
amiga/prototyping-board/review/layout-front.png
