markjfisher/fujinet-nio-hardware/amiga/integrated-a500-r5/review/service/pad-nets.csv

reference | pad | net | x_mm | y_mm
SW1 | 1 | /RP_RUN | 27.0 | 112.0
SW1 | 2 | /GND | 27.0 | 116.5
SW3 | 1 | /ESP_EN | 52.0 | 112.0
SW3 | 2 | /GND | 52.0 | 116.5
J20 | 1 | /3V3 | 49.0 | 9.0
J20 | 2 | /RP2350B and support/RP_SWDIO | 51.54 | 9.0
J20 | 3 | /GND | 54.08 | 9.0
J20 | 4 | /RP2350B and support/RP_SWCLK | 56.62 | 9.0
J20 | 5 | /RP_RUN | 59.16 | 9.0
J60 | 1 | /3V3 | 19.0 | 113.0
J60 | 2 | /BUS_ARM | 21.54 | 113.0
J2 | 1 | /3V3 | 6.0 | 110.0
J2 | 2 | /RUN_MODE | 8.54 | 110.0
J2 | 3 | /3V3 | 6.0 | 112.54
J2 | 4 | /USB routing and physical recovery/FLASH_RP | 8.54 | 112.54
J2 | 5 | /3V3 | 6.0 | 115.08
J2 | 6 | /USB routing and physical recovery/FLASH_ESP | 8.54 | 115.08
SW2 | 1 | /USB routing and physical recovery/RP_BOOT_PULL | 38.0 | 112.0
SW2 | 2 | /GND | 38.0 | 116.5
SW4 | 1 | /ESP_BOOT_N | 63.0 | 112.0
SW4 | 2 | /GND | 63.0 | 116.5
J31 | 1 | /GND | 28.0 | 9.0
J31 | 2 | /ESP32-S3 module and microSD/ESP_TXD0 | 30.54 | 9.0
J31 | 3 | /ESP32-S3 module and microSD/ESP_RXD0 | 33.08 | 9.0
J31 | 4 | /ESP_EN | 35.62 | 9.0
J31 | 5 | /ESP_BOOT_N | 38.16 | 9.0
