markjfisher/fujinet-nio-hardware/amiga/integrated-a500-r5/review/control-logic/pad-nets.csv

reference | pad | net | x_mm | y_mm
C95 | 1 | /3V3 | 55.8 | 84.275
C95 | 2 | /GND | 55.8 | 82.725
U77 | 1 | /Hardware bus interlocks/WRITE_RECEIVE | 64.8625 | 102.05
U77 | 2 | /GND | 64.8625 | 103.0
U77 | 3 | /Hardware bus interlocks/LO_ACTIVE | 64.8625 | 103.95
U77 | 4 | /RX_LO_N | 67.1375 | 103.95
U77 | 5 | /3V3 | 67.1375 | 103.0
U77 | 6 | /3V3 | 67.1375 | 102.05
U84 | 1 | /ACK_REQ_C | 58.599999999999994 | 77.25
U84 | 2 | /Hardware bus interlocks/ANY_LANE | 58.599999999999994 | 77.75
U84 | 3 | /Hardware bus interlocks/WAIT_PENDING | 58.599999999999994 | 78.25
U84 | 4 | /GND | 58.599999999999994 | 78.75
U84 | 5 | unconnected-(U84-Q-Pad5) | 61.400000000000006 | 78.75
U84 | 6 | /Hardware bus interlocks/CYCLE_OK | 61.400000000000006 | 78.25
U84 | 7 | /3V3 | 61.400000000000006 | 77.75
U84 | 8 | /3V3 | 61.400000000000006 | 77.25
U66 | 1 | /Z_A23 | 63.8625 | 48.95
U66 | 2 | /Z_A22 | 63.8625 | 48.3
U66 | 3 | /Hardware bus interlocks/IO_TOP | 63.8625 | 47.65
U66 | 4 | /Hardware bus interlocks/A20_LOW | 63.8625 | 47.0
U66 | 5 | /Z_A19 | 63.8625 | 46.35
U66 | 6 | /Hardware bus interlocks/IO_WINDOW | 63.8625 | 45.7
U66 | 7 | /GND | 63.8625 | 45.05
U66 | 8 | /Hardware bus interlocks/CYCLE_OK | 58.1375 | 45.05
U66 | 9 | /Hardware bus interlocks/SAFE | 58.1375 | 45.7
U66 | 10 | /Hardware bus interlocks/AS_ACTIVE | 58.1375 | 46.35
U66 | 11 | /Hardware bus interlocks/IO_WINDOW | 58.1375 | 47.0
U66 | 12 | /Hardware bus interlocks/IO_TOP | 58.1375 | 47.65
U66 | 13 | /Z_A21 | 58.1375 | 48.3
U66 | 14 | /3V3 | 58.1375 | 48.95
U64 | 1 | /Z_AS_N | 55.1375 | 56.05
U64 | 2 | /Hardware bus interlocks/AS_ACTIVE | 55.1375 | 56.7
U64 | 3 | /Z_A20 | 55.1375 | 57.35
U64 | 4 | /Hardware bus interlocks/A20_LOW | 55.1375 | 58.0
U64 | 5 | /Z_LDS_N | 55.1375 | 58.65
U64 | 6 | /Hardware bus interlocks/LO_ACTIVE | 55.1375 | 59.3
U64 | 7 | /GND | 55.1375 | 59.95
U64 | 8 | /Hardware bus interlocks/HI_ACTIVE | 60.8625 | 59.95
U64 | 9 | /Z_UDS_N | 60.8625 | 59.3
U64 | 10 | /Hardware bus interlocks/WRITE_CYCLE | 60.8625 | 58.65
U64 | 11 | /Z_READ | 60.8625 | 58.0
U64 | 12 | /Hardware bus interlocks/DATA_RECEIVE | 60.8625 | 57.35
U64 | 13 | /Hardware bus interlocks/DATA_VALID | 60.8625 | 56.7
U64 | 14 | /3V3 | 60.8625 | 56.05
U71 | 1 | /Hardware bus interlocks/CYCLE_OK | 37.1375 | 81.05
U71 | 2 | /Z_READ | 37.1375 | 81.7
U71 | 3 | /Hardware bus interlocks/CYCLE_OK | 37.1375 | 82.35
U71 | 4 | /Hardware bus interlocks/WRITE_CYCLE | 37.1375 | 83.0
U71 | 5 | /Hardware bus interlocks/DATA_RECEIVE | 37.1375 | 83.65
U71 | 6 | /Hardware bus interlocks/WRITE_RECEIVE | 37.1375 | 84.3
U71 | 7 | /GND | 37.1375 | 84.95
U71 | 8 | /WAIT_SINK | 42.8625 | 84.95
U71 | 9 | /Hardware bus interlocks/CYCLE_OK | 42.8625 | 84.3
U71 | 10 | /Hardware bus interlocks/WAIT_PENDING | 42.8625 | 83.65
U71 | 11 | /3V3 | 42.8625 | 83.0
U71 | 12 | /Hardware bus interlocks/READ_DRIVE | 42.8625 | 82.35
U71 | 13 | /Hardware bus interlocks/DATA_VALID | 42.8625 | 81.7
U71 | 14 | /3V3 | 42.8625 | 81.05
U73 | 1 | /Hardware bus interlocks/READ_DRIVE | 56.8625 | 95.05
U73 | 2 | /GND | 56.8625 | 96.0
U73 | 3 | /Hardware bus interlocks/HI_ACTIVE | 56.8625 | 96.95
U73 | 4 | /TX_HI_N | 59.1375 | 96.95
U73 | 5 | /3V3 | 59.1375 | 96.0
U73 | 6 | /3V3 | 59.1375 | 95.05
C127 | 1 | /3V3 | 32.799999 | 17.275
C127 | 2 | /GND | 32.799999 | 15.725
C88 | 1 | /3V3 | 34.5 | 80.275
C88 | 2 | /GND | 34.5 | 78.725
U72 | 1 | /Hardware bus interlocks/READ_DRIVE | 64.8625 | 95.05
U72 | 2 | /GND | 64.8625 | 96.0
U72 | 3 | /Hardware bus interlocks/LO_ACTIVE | 64.8625 | 96.95
U72 | 4 | /TX_LO_N | 67.1375 | 96.95
U72 | 5 | /3V3 | 67.1375 | 96.0
U72 | 6 | /3V3 | 67.1375 | 95.05
C94 | 1 | /3V3 | 70.8 | 45.275
C94 | 2 | /GND | 70.8 | 43.725
U78 | 1 | /Hardware bus interlocks/WRITE_RECEIVE | 56.8625 | 102.05
U78 | 2 | /GND | 56.8625 | 103.0
U78 | 3 | /Hardware bus interlocks/HI_ACTIVE | 56.8625 | 103.95
U78 | 4 | /RX_HI_N | 59.1375 | 103.95
U78 | 5 | /3V3 | 59.1375 | 103.0
U78 | 6 | /3V3 | 59.1375 | 102.05
U82 | 1 | /Hardware bus interlocks/SAFE | 34.8625 | 19.05
U82 | 2 | /IRQ_REQ_C | 34.8625 | 20.0
U82 | 3 | /GND | 34.8625 | 20.95
U82 | 4 | /IRQ_SINK | 37.1375 | 20.95
U82 | 5 | /3V3 | 37.1375 | 19.05
C81 | 1 | /3V3 | 69.8 | 94.275
C81 | 2 | /GND | 69.8 | 92.725
Q3 | 1 | /USB routing and physical recovery/FLASH_RP | 27.0625 | 57.05
Q3 | 2 | /GND | 27.0625 | 58.95
Q3 | 3 | /USB routing and physical recovery/RP_BOOT_PULL | 28.9375 | 58.0
U98 | 1 | /BUS_READY | 50.6 | 79.25
U98 | 2 | /ACK_REQ_C | 50.6 | 79.75
U98 | 3 | /DATA_DRIVE | 50.6 | 80.25
U98 | 4 | /GND | 50.6 | 80.75
U98 | 5 | /DATA_DRIVE_C | 53.4 | 80.75
U98 | 6 | /ACK_REQ | 53.4 | 80.25
U98 | 7 | /BUS_READY_C | 53.4 | 79.75
U98 | 8 | /3V3 | 53.4 | 79.25
C73 | 1 | /3V3 | 61.0 | 53.775
C73 | 2 | /GND | 61.0 | 52.225
C126 | 1 | /3V3 | 55.8 | 78.275
C126 | 2 | /GND | 55.8 | 76.725
Q2 | 1 | /USB routing and physical recovery/FLASH_ESP | 52.0625 | 73.55
Q2 | 2 | /GND | 52.0625 | 75.45
Q2 | 3 | /RP_RUN | 53.9375 | 74.5
R3 | 1 | /RUN_MODE | 67.175 | 73.5
R3 | 2 | /GND | 68.825 | 73.5
C70 | 1 | /3V3 | 55.6625 | 44.975
C70 | 2 | /GND | 55.6625 | 43.425
C86 | 1 | /3V3 | 69.8 | 101.275
C86 | 2 | /GND | 69.8 | 99.725
U86 | 1 | /DATA_DRIVE_C | 50.6 | 85.25
U86 | 2 | /3V3 | 50.6 | 85.75
U86 | 3 | unconnected-(U86-~{Q}-Pad3) | 50.6 | 86.25
U86 | 4 | /GND | 50.6 | 86.75
U86 | 5 | /Hardware bus interlocks/DATA_VALID | 53.4 | 86.75
U86 | 6 | /Hardware bus interlocks/CYCLE_OK | 53.4 | 86.25
U86 | 7 | /3V3 | 53.4 | 85.75
U86 | 8 | /3V3 | 53.4 | 85.25
R64 | 1 | /BUS_READY | 47.85 | 81.2
R64 | 2 | /DATA_DRIVE | 47.85 | 80.4
R64 | 3 | /ACK_REQ | 47.85 | 79.6
R64 | 4 | /IRQ_REQ | 47.85 | 78.8
R64 | 5 | /GND | 46.15 | 78.8
R64 | 6 | /GND | 46.15 | 79.6
R64 | 7 | /GND | 46.15 | 80.4
R64 | 8 | /GND | 46.15 | 81.2
C75 | 1 | /3V3 | 58.1375 | 50.725
C75 | 2 | /GND | 58.1375 | 52.275
U61 | 1 | /BUS_PERMIT | 49.9375 | 46.55
U61 | 2 | /BUS_PERMIT | 49.9375 | 47.2
U61 | 3 | /RP_RUN_C | 49.9375 | 47.85
U61 | 4 | /RUN_MODE_C | 49.9375 | 48.5
U61 | 5 | /BUS_ARM_C | 49.9375 | 49.15
U61 | 6 | /Hardware bus interlocks/SAFE_MODE | 49.9375 | 49.8
U61 | 7 | /GND | 49.9375 | 50.45
U61 | 8 | /Hardware bus interlocks/SAFE_BASE | 55.6625 | 50.45
U61 | 9 | /Hardware bus interlocks/SAFE_POWER | 55.6625 | 49.8
U61 | 10 | /Hardware bus interlocks/SAFE_MODE | 55.6625 | 49.15
U61 | 11 | /BUS_READY_C | 55.6625 | 48.5
U61 | 12 | /Hardware bus interlocks/SAFE_POWER | 55.6625 | 47.85
U61 | 13 | /HOST_RESET_N | 55.6625 | 47.2
U61 | 14 | /3V3 | 55.6625 | 46.55
R63 | 1 | /BUS_ARM | 67.175 | 76.5
R63 | 2 | /GND | 68.825 | 76.5
C93 | 1 | /3V3 | 63.8 | 76.275
C93 | 2 | /GND | 63.8 | 74.725
C87 | 1 | /3V3 | 61.8 | 101.275
C87 | 2 | /GND | 61.8 | 99.725
U99 | 1 | unconnected-(U99-NC-Pad1) | 27.862499999999997 | 18.05
U99 | 2 | /IRQ_REQ | 27.862499999999997 | 19.0
U99 | 3 | /GND | 27.862499999999997 | 19.95
U99 | 4 | /IRQ_REQ_C | 30.137500000000003 | 19.95
U99 | 5 | /3V3 | 30.137500000000003 | 18.05
U79 | 1 | /Hardware bus interlocks/LO_ACTIVE | 30.862499999999997 | 82.05
U79 | 2 | /Hardware bus interlocks/HI_ACTIVE | 30.862499999999997 | 83.0
U79 | 3 | /GND | 30.862499999999997 | 83.95
U79 | 4 | /Hardware bus interlocks/ANY_LANE | 33.1375 | 83.95
U79 | 5 | /3V3 | 33.1375 | 82.05
C82 | 1 | /3V3 | 61.8 | 94.275
C82 | 2 | /GND | 61.8 | 92.725
C80 | 1 | /3V3 | 42.8625 | 78.775
C80 | 2 | /GND | 42.8625 | 77.225
C91 | 1 | /3V3 | 39.8 | 18.275
C91 | 2 | /GND | 39.8 | 16.725
U85 | 1 | /Hardware bus interlocks/SAFE_BASE | 66.3625 | 46.05
U85 | 2 | /HOST_BERR_N | 66.3625 | 47.0
U85 | 3 | /GND | 66.3625 | 47.95
U85 | 4 | /Hardware bus interlocks/SAFE | 68.6375 | 47.95
U85 | 5 | /3V3 | 68.6375 | 46.05
