markjfisher/fujinet-nio-hardware/amiga/integrated-a500-r5/review/host-protection/pad-nets.csv

reference | pad | net | x_mm | y_mm
C128 | 1 | /3V3 | 68.8 | 54.275
C128 | 2 | /GND | 68.8 | 52.725
C113 | 1 | /3V3_BUS | 67.2 | 85.0
C113 | 2 | /GND | 62.8 | 85.0
R113 | 1 | /Host interface power guard/MAIN_SENSE | 48.5 | 30.975
R113 | 2 | /GND | 48.5 | 32.625
C112 | 1 | /3V3_BUS | 45.775 | 20.0
C112 | 2 | /GND | 44.225 | 20.0
R122 | 1 | /BUS_PERMIT | 51.175 | 42.0
R122 | 2 | /GND | 52.825 | 42.0
R120 | 1 | /BUS_DISABLE | 58.0 | 65.175
R120 | 2 | /Host interface power guard/GUARD_RESET_BASE | 58.0 | 66.825
D4 | 1 | /Host interface power guard/HOST_LDO_IN | 54.5 | 19.95
D4 | 2 | /Host interface power guard/HOST_5V_LIMITED | 58.5 | 19.95
R110 | 1 | /Host interface power guard/HOST_ILIM | 60.0 | 15.825
R110 | 2 | /GND | 60.0 | 14.175
C110 | 1 | /AMIGA_5V | 66.025 | 20.0
C110 | 2 | /GND | 67.575 | 20.0
C116 | 1 | /Host interface power guard/BUS_CT | 57.1375 | 33.225
C116 | 2 | /GND | 57.1375 | 34.775
C119 | 1 | /3V3_BUS | 57.1375 | 26.775
C119 | 2 | /GND | 57.1375 | 25.225
U93 | 1 | /BUS_PERMIT | 54.6 | 38.25
U93 | 2 | /WAIT_SINK | 54.6 | 38.75
U93 | 3 | /Host interface power guard/IRQ_OE_N | 54.6 | 39.25
U93 | 4 | /GND | 54.6 | 39.75
U93 | 5 | /BUS_PERMIT | 57.4 | 39.75
U93 | 6 | /IRQ_SINK | 57.4 | 39.25
U93 | 7 | /Host interface power guard/WAIT_OE_N | 57.4 | 38.75
U93 | 8 | /3V3_BUS | 57.4 | 38.25
Q5 | 1 | /Host interface power guard/GUARD_RESET_BASE | 55.0625 | 69.05
Q5 | 2 | /GND | 55.0625 | 70.95
Q5 | 3 | /RP_RUN | 56.9375 | 70.0
C111 | 1 | /Host interface power guard/HOST_LDO_IN | 52.0 | 22.425
C111 | 2 | /GND | 52.0 | 23.975
C122 | 1 | /3V3_BUS | 68.8 | 36.775
C122 | 2 | /GND | 68.8 | 35.225
R114 | 1 | /3V3_BUS | 61.5 | 27.175
R114 | 2 | /Host interface power guard/BUS_SENSE | 61.5 | 28.825
C115 | 1 | /Host interface power guard/MAIN_CT | 44.1375 | 33.225
C115 | 2 | /GND | 44.1375 | 34.775
C60 | 1 | /3V3_BUS | 31.137500000000003 | 26.775
C60 | 2 | /GND | 31.137500000000003 | 25.225
C114 | 1 | /Host interface power guard/HOST_CT | 31.137500000000003 | 33.225
C114 | 2 | /GND | 31.137500000000003 | 34.775
U95 | 1 | /AMIGA_5V | 64.1375 | 19.95
U95 | 2 | /GND | 64.1375 | 19.0
U95 | 3 | /AMIGA_5V | 64.1375 | 18.05
U95 | 4 | unconnected-(U95-~{FAULT}-Pad4) | 61.8625 | 18.05
U95 | 5 | /Host interface power guard/HOST_ILIM | 61.8625 | 19.0
U95 | 6 | /Host interface power guard/HOST_5V_LIMITED | 61.8625 | 19.95
U94 | 1 | /Host interface power guard/WAIT_OE_N | 63.599999999999994 | 38.25
U94 | 2 | /GND | 63.599999999999994 | 38.75
U94 | 3 | /AMIGA_INT2_N | 63.599999999999994 | 39.25
U94 | 4 | /GND | 63.599999999999994 | 39.75
U94 | 5 | /GND | 66.4 | 39.75
U94 | 6 | /AMIGA_XRDY | 66.4 | 39.25
U94 | 7 | /Host interface power guard/IRQ_OE_N | 66.4 | 38.75
U94 | 8 | /3V3_BUS | 66.4 | 38.25
R121 | 1 | /Host interface power guard/GUARD_RESET_BASE | 54.0 | 66.825
R121 | 2 | /GND | 54.0 | 65.175
U100 | 1 | /AMIGA_RESET_N | 63.599999999999994 | 55.25
U100 | 2 | /AMIGA_DTACK_N_C | 63.599999999999994 | 55.75
U100 | 3 | /AMIGA_BERR_N | 63.599999999999994 | 56.25
U100 | 4 | /GND | 63.599999999999994 | 56.75
U100 | 5 | /AMIGA_BERR_N_C | 66.4 | 56.75
U100 | 6 | /AMIGA_DTACK_N | 66.4 | 56.25
U100 | 7 | /AMIGA_RESET_N_C | 66.4 | 55.75
U100 | 8 | /3V3 | 66.4 | 55.25
U90 | 1 | /Host interface power guard/GUARD_OK_RAW | 41.8625 | 29.05
U90 | 2 | /GND | 41.8625 | 30.0
U90 | 3 | /3V3_BUS | 41.8625 | 30.95
U90 | 4 | /Host interface power guard/MAIN_CT | 44.1375 | 30.95
U90 | 5 | /Host interface power guard/MAIN_SENSE | 44.1375 | 30.0
U90 | 6 | /3V3_BUS | 44.1375 | 29.05
R119 | 1 | /3V3_BUS | 68.8 | 40.825
R119 | 2 | /Host interface power guard/IRQ_OE_N | 68.8 | 39.175
R116 | 1 | /3V3_BUS | 45.0 | 40.825
R116 | 2 | /Host interface power guard/GUARD_OK_RAW | 45.0 | 39.175
C120 | 1 | /3V3_BUS | 51.225 | 38.0
C120 | 2 | /GND | 52.775 | 38.0
R60 | 1 | /AMIGA_5V | 35.5 | 27.175
R60 | 2 | /Host interface power guard/HOST_SENSE | 35.5 | 28.825
U97 | 1 | /RP_RUN | 59.599999999999994 | 69.25
U97 | 2 | /BUS_ARM_C | 59.599999999999994 | 69.75
U97 | 3 | /RUN_MODE | 59.599999999999994 | 70.25
U97 | 4 | /GND | 59.599999999999994 | 70.75
U97 | 5 | /RUN_MODE_C | 62.400000000000006 | 70.75
U97 | 6 | /BUS_ARM | 62.400000000000006 | 70.25
U97 | 7 | /RP_RUN_C | 62.400000000000006 | 69.75
U97 | 8 | /3V3 | 62.400000000000006 | 69.25
C121 | 1 | /3V3_BUS | 59.8 | 36.775
C121 | 2 | /GND | 59.8 | 35.225
U60 | 1 | /Host interface power guard/GUARD_OK_RAW | 28.862499999999997 | 29.05
U60 | 2 | /GND | 28.862499999999997 | 30.0
U60 | 3 | /3V3_BUS | 28.862499999999997 | 30.95
U60 | 4 | /Host interface power guard/HOST_CT | 31.137500000000003 | 30.95
U60 | 5 | /Host interface power guard/HOST_SENSE | 31.137500000000003 | 30.0
U60 | 6 | /3V3_BUS | 31.137500000000003 | 29.05
R115 | 1 | /Host interface power guard/BUS_SENSE | 61.5 | 30.975
R115 | 2 | /GND | 61.5 | 32.625
R118 | 1 | /3V3_BUS | 61.3 | 40.825
R118 | 2 | /Host interface power guard/WAIT_OE_N | 61.3 | 39.175
U92 | 1 | /Host interface power guard/GUARD_OK_RAW | 46.8625 | 37.05
U92 | 2 | /GND | 46.8625 | 38.0
U92 | 3 | /BUS_DISABLE | 46.8625 | 38.95
U92 | 4 | /BUS_PERMIT | 49.1375 | 38.95
U92 | 5 | /3V3_BUS | 49.1375 | 38.0
U92 | 6 | /BUS_DISABLE | 49.1375 | 37.05
R111 | 1 | /3V3_BUS | 65.175 | 91.0
R111 | 2 | /GND | 66.825 | 91.0
C125 | 1 | /3V3 | 64.425 | 69.25
C125 | 2 | /GND | 65.975 | 69.25
R117 | 1 | /3V3_BUS | 48.0 | 42.825
R117 | 2 | /BUS_DISABLE | 48.0 | 41.175
R112 | 1 | /3V3 | 48.5 | 27.175
R112 | 2 | /Host interface power guard/MAIN_SENSE | 48.5 | 28.825
U96 | 1 | /Host interface power guard/HOST_LDO_IN | 50.1375 | 19.95
U96 | 2 | /GND | 50.1375 | 19.0
U96 | 3 | /Host interface power guard/HOST_LDO_IN | 50.1375 | 18.05
U96 | 4 | unconnected-(U96-NC-Pad4) | 47.8625 | 18.05
U96 | 5 | /3V3_BUS | 47.8625 | 19.95
U91 | 1 | /Host interface power guard/GUARD_OK_RAW | 54.8625 | 29.05
U91 | 2 | /GND | 54.8625 | 30.0
U91 | 3 | /3V3_BUS | 54.8625 | 30.95
U91 | 4 | /Host interface power guard/BUS_CT | 57.1375 | 30.95
U91 | 5 | /Host interface power guard/BUS_SENSE | 57.1375 | 30.0
U91 | 6 | /3V3_BUS | 57.1375 | 29.05
R61 | 1 | /Host interface power guard/HOST_SENSE | 35.5 | 30.975
R61 | 2 | /GND | 35.5 | 32.625
C118 | 1 | /3V3_BUS | 44.1375 | 26.775
C118 | 2 | /GND | 44.1375 | 25.225
