markjfisher/fujinet-nio-hardware/amiga/integrated-a500-r5/review/esp-sd/pad-nets.csv

reference | pad | net | x_mm | y_mm
R31 | 1 | /ESP32-S3 module and microSD/ESP_USB_DM | 10.5 | 41.175
R31 | 2 | /ESP_DM | 10.5 | 42.825
U30 | 1 | /GND | -4.26 | 38.75
U30 | 2 | /3V3 | -2.99 | 38.75
U30 | 3 | /ESP_EN | -1.7199999999999998 | 38.75
U30 | 4 | unconnected-(U30-IO4-Pad4) | -0.4500000000000002 | 38.75
U30 | 5 | unconnected-(U30-IO5-Pad5) | 0.8200000000000003 | 38.75
U30 | 6 | unconnected-(U30-IO6-Pad6) | 2.09 | 38.75
U30 | 7 | unconnected-(U30-IO7-Pad7) | 3.3599999999999994 | 38.75
U30 | 8 | unconnected-(U30-IO15-Pad8) | 4.629999999999999 | 38.75
U30 | 9 | unconnected-(U30-IO16-Pad9) | 5.9 | 38.75
U30 | 10 | unconnected-(U30-IO17-Pad10) | 7.17 | 38.75
U30 | 11 | unconnected-(U30-IO18-Pad11) | 8.44 | 38.75
U30 | 12 | unconnected-(U30-IO8-Pad12) | 9.71 | 38.75
U30 | 13 | /ESP32-S3 module and microSD/ESP_USB_DM | 10.98 | 38.75
U30 | 14 | /ESP32-S3 module and microSD/ESP_USB_DP | 12.25 | 38.75
U30 | 15 | unconnected-(U30-IO3-Pad15) | 13.5 | 36.985
U30 | 16 | /ESP32-S3 module and microSD/ESP_STRAP46 | 13.5 | 35.715
U30 | 17 | /ESP32-S3 module and microSD/SD_MISO | 13.5 | 34.445
U30 | 18 | /ESP32-S3 module and microSD/SD_CS | 13.5 | 33.175
U30 | 19 | /ESP32-S3 module and microSD/SD_MOSI | 13.5 | 31.905
U30 | 20 | /ESP32-S3 module and microSD/SD_CLK | 13.5 | 30.635
U30 | 21 | unconnected-(U30-IO13-Pad21) | 13.5 | 29.365
U30 | 22 | unconnected-(U30-IO14-Pad22) | 13.5 | 28.095
U30 | 23 | /ESP32-S3 module and microSD/ESP_VBUS_VALID | 13.5 | 26.825
U30 | 24 | unconnected-(U30-IO47-Pad24) | 13.5 | 25.555
U30 | 25 | unconnected-(U30-IO48-Pad25) | 13.5 | 24.285
U30 | 26 | /ESP32-S3 module and microSD/ESP_STRAP45 | 13.5 | 23.015
U30 | 27 | /ESP_BOOT_N | 12.25 | 21.25
U30 | 28 | unconnected-(U30-IO35-Pad28) | 10.98 | 21.25
U30 | 29 | unconnected-(U30-IO36-Pad29) | 9.71 | 21.25
U30 | 30 | unconnected-(U30-IO37-Pad30) | 8.44 | 21.25
U30 | 31 | unconnected-(U30-IO38-Pad31) | 7.17 | 21.25
U30 | 32 | unconnected-(U30-IO39-Pad32) | 5.9 | 21.25
U30 | 33 | unconnected-(U30-IO40-Pad33) | 4.629999999999999 | 21.25
U30 | 34 | unconnected-(U30-IO41-Pad34) | 3.3599999999999994 | 21.25
U30 | 35 | unconnected-(U30-IO42-Pad35) | 2.09 | 21.25
U30 | 36 | /ESP32-S3 module and microSD/ESP_RXD0 | 0.8200000000000003 | 21.25
U30 | 37 | /ESP32-S3 module and microSD/ESP_TXD0 | -0.4500000000000002 | 21.25
U30 | 38 | unconnected-(U30-IO2-Pad38) | -1.7199999999999998 | 21.25
U30 | 39 | unconnected-(U30-IO1-Pad39) | -2.99 | 21.25
U30 | 40 | /GND | -4.26 | 21.25
U30 | 41 | /GND | 2.76 | 32.9
R33 | 1 | /ESP32-S3 module and microSD/ESP_STRAP46 | 15.675 | 35.7
R33 | 2 | /GND | 17.325 | 35.7
R35 | 1 | /ESP32-S3 module and microSD/ESP_VBUS_VALID | 19.0 | 26.825
R35 | 2 | /GND | 19.0 | 25.175
R12 | 1 | /3V3 | 12.25 | 17.375
R12 | 2 | /ESP_BOOT_N | 12.25 | 19.025
R36 | 1 | /ESP32-S3 module and microSD/SD_CLK | 15.675 | 30.6
R36 | 2 | /ESP32-S3 module and microSD/SD_CLK_CARD | 17.325 | 30.6
J30 | 1 | /ESP32-S3 module and microSD/SD_DAT2 | 10.925 | 63.275
J30 | 2 | /ESP32-S3 module and microSD/SD_CS | 10.925 | 62.175
J30 | 3 | /ESP32-S3 module and microSD/SD_MOSI | 10.925 | 61.075
J30 | 4 | /3V3 | 10.925 | 59.975
J30 | 5 | /ESP32-S3 module and microSD/SD_CLK_CARD | 10.925 | 58.875
J30 | 6 | /GND | 10.925 | 57.775
J30 | 7 | /ESP32-S3 module and microSD/SD_MISO | 10.925 | 56.675
J30 | 8 | /ESP32-S3 module and microSD/SD_DAT1 | 10.925 | 55.575
J30 | 9 | unconnected-(J30-DET_B-Pad9) | 10.925 | 54.625
J30 | 10 | unconnected-(J30-DET_A-Pad10) | 0.4249999999999998 | 53.675
J30 | SH | /GND | 6.625 | 53.675
R11 | 1 | /3V3 | 2.0 | 42.325
R11 | 2 | /ESP_EN | 2.0 | 40.675
Q1 | 1 | /USB routing and physical recovery/FLASH_RP | 5.4375 | 47.95
Q1 | 2 | /GND | 5.4375 | 46.05
Q1 | 3 | /ESP_EN | 3.5625 | 47.0
Q4 | 1 | /USB routing and physical recovery/FLASH_ESP | 17.9375 | 19.45
Q4 | 2 | /GND | 17.9375 | 17.55
Q4 | 3 | /ESP_BOOT_N | 16.0625 | 18.5
R30 | 1 | /ESP32-S3 module and microSD/ESP_USB_DP | 12.5 | 41.175
R30 | 2 | /ESP_DP | 12.5 | 42.825
R34 | 1 | /3V3 | 16.5 | 25.175
R34 | 2 | /ESP32-S3 module and microSD/ESP_VBUS_VALID | 16.5 | 26.825
R32 | 1 | /ESP32-S3 module and microSD/ESP_STRAP45 | 15.675 | 23.0
R32 | 2 | /GND | 17.325 | 23.0
R41 | 1 | /3V3 | 15.825 | 52.5
R41 | 2 | /ESP32-S3 module and microSD/SD_DAT1 | 14.175 | 52.5
C40 | 1 | /3V3 | -0.5 | 40.725
C40 | 2 | /GND | -0.5 | 42.275
C41 | 1 | /3V3 | -3.0 | 40.725
C41 | 2 | /GND | -3.0 | 42.275
R37 | 1 | /3V3 | 17.35 | 62.2
R37 | 2 | /3V3 | 17.35 | 61.4
R37 | 3 | /3V3 | 17.35 | 60.6
R37 | 4 | /3V3 | 17.35 | 59.8
R37 | 5 | /ESP32-S3 module and microSD/SD_MISO | 15.649999999999999 | 59.8
R37 | 6 | /ESP32-S3 module and microSD/SD_MOSI | 15.649999999999999 | 60.6
R37 | 7 | /ESP32-S3 module and microSD/SD_CS | 15.649999999999999 | 61.4
R37 | 8 | /ESP32-S3 module and microSD/SD_DAT2 | 15.649999999999999 | 62.2
C10 | 1 | /ESP_EN | 4.5 | 40.725
C10 | 2 | /GND | 4.5 | 42.275
