markjfisher/fujinet-nio-hardware/amiga/integrated-a500-r5/review/pad-refinement/pad-nets.csv

reference | pad | full_net | x_mm | y_mm
U21 | 1 | /RP_BOOT_N | 32.095 | 51.5875
U21 | 2 | /RP2350B and support/QSPI_SD1 | 33.365 | 51.5875
U21 | 3 | /RP2350B and support/QSPI_SD2 | 34.635 | 51.5875
U21 | 4 | /GND | 35.905 | 51.5875
U21 | 5 | /RP2350B and support/QSPI_SD0 | 35.905 | 44.4125
U21 | 6 | /RP2350B and support/QSPI_SCLK | 34.635 | 44.4125
U21 | 7 | /RP2350B and support/QSPI_SD3 | 33.365 | 44.4125
U21 | 8 | /3V3 | 32.095 | 44.4125
C31 | 1 | /3V3 | 49.225 | 61.7
C31 | 2 | /GND | 50.775 | 61.7
L20 | 1 | /RP2350B and support/RP_LX | 45.7 | 51.35
L20 | 2 | /RP2350B and support/RP_DVDD | 44.3 | 51.35
C27 | 1 | /3V3 | 35.275 | 61.8
C27 | 2 | /GND | 33.725 | 61.8
C26 | 1 | /3V3 | 35.275 | 57.8
C26 | 2 | /GND | 33.725 | 57.8
C21 | 1 | /RP2350B and support/RP_XIN | 39.275 | 71.1
C21 | 2 | /GND | 37.725 | 71.1
R10 | 1 | /3V3 | 49.8 | 70.225
R10 | 2 | /RP_RUN | 49.8 | 68.575
C22 | 1 | /RP2350B and support/XTAL_OUT | 45.225 | 73.3
C22 | 2 | /GND | 46.775 | 73.3
C28 | 1 | /3V3 | 39.4 | 67.225
C28 | 2 | /GND | 39.4 | 68.775
R24 | 1 | /3V3 | 47.2 | 51.175
R24 | 2 | /RP2350B and support/RP_VREG_AVDD | 47.2 | 52.125
Y20 | 1 | /RP2350B and support/RP_XIN | 41.15 | 71.1
Y20 | 2 | /GND | 41.15 | 73.3
Y20 | 3 | /RP2350B and support/XTAL_OUT | 42.85 | 73.3
Y20 | 4 | /GND | 42.85 | 71.1
C37 | 1 | /RP2350B and support/RP_DVDD | 35.275 | 59.8
C37 | 2 | /GND | 33.725 | 59.8
R23 | 1 | /RP2350B and support/RP_USB_DM | 42.8 | 49.225
R23 | 2 | /RP_DM | 42.8 | 47.575
C29 | 1 | /3V3 | 41.4 | 67.225
C29 | 2 | /GND | 41.4 | 68.775
R21 | 1 | /RP2350B and support/XTAL_OUT | 46.4 | 70.825
R21 | 2 | /RP2350B and support/RP_XOUT | 46.4 | 69.175
C34 | 1 | /3V3 | 42.0 | 53.175
C34 | 2 | /GND | 42.0 | 51.625
C25 | 1 | /RP2350B and support/RP_DVDD | 44.485 | 53.0
C25 | 2 | /GND | 45.515 | 53.0
R13 | 1 | /RP_BOOT_N | 28.1 | 50.125
R13 | 2 | /USB routing and physical recovery/RP_BOOT_PULL | 28.1 | 48.475
C30 | 1 | /3V3 | 49.225 | 63.8
C30 | 2 | /GND | 50.775 | 63.8
C32 | 1 | /3V3 | 49.225 | 55.4
C32 | 2 | /GND | 50.775 | 55.4
C23 | 1 | /RP2350B and support/RP_VREG_AVDD | 47.2 | 53.025
C23 | 2 | /GND | 47.2 | 53.975
C38 | 1 | /RP2350B and support/RP_DVDD | 49.225 | 59.6
C38 | 2 | /GND | 50.775 | 59.6
R22 | 1 | /RP2350B and support/RP_USB_DP | 41.0 | 49.225
R22 | 2 | /RP_DP | 41.0 | 47.575
C39 | 1 | /RP2350B and support/RP_DVDD | 43.8 | 67.225
C39 | 2 | /GND | 43.8 | 68.775
C36 | 1 | /3V3 | 38.0 | 53.175
C36 | 2 | /GND | 38.0 | 51.625
C33 | 1 | /3V3 | 49.225 | 57.5
C33 | 2 | /GND | 50.775 | 57.5
C24 | 1 | /3V3 | 44.485 | 53.94
C24 | 2 | /GND | 45.515 | 53.94
R20 | 1 | /3V3 | 30.0 | 53.225
R20 | 2 | /RP_BOOT_N | 30.0 | 51.575
U20 | 1 | /Z_A4 | 37.1 | 56.2
U20 | 2 | /Z_A5 | 37.1 | 56.6
U20 | 3 | /Z_A6 | 37.1 | 57.0
U20 | 4 | /Z_A7 | 37.1 | 57.4
U20 | 5 | /3V3 | 37.1 | 57.8
U20 | 6 | /Z_A8 | 37.1 | 58.2
U20 | 7 | /Z_A9 | 37.1 | 58.6
U20 | 8 | /Z_A10 | 37.1 | 59.0
U20 | 9 | /Z_A11 | 37.1 | 59.4
U20 | 10 | /RP2350B and support/RP_DVDD | 37.1 | 59.8
U20 | 11 | /Z_A12 | 37.1 | 60.2
U20 | 12 | /Z_A13 | 37.1 | 60.6
U20 | 13 | /Z_A14 | 37.1 | 61.0
U20 | 14 | /Z_A15 | 37.1 | 61.4
U20 | 15 | /3V3 | 37.1 | 61.8
U20 | 16 | /Z_A16 | 37.1 | 62.2
U20 | 17 | /Z_A17 | 37.1 | 62.6
U20 | 18 | /Z_A18 | 37.1 | 63.0
U20 | 19 | /Z_A19 | 37.1 | 63.4
U20 | 20 | /Z_A20 | 37.1 | 63.8
U20 | 21 | /Z_A21 | 38.2 | 64.9
U20 | 22 | /Z_A22 | 38.6 | 64.9
U20 | 23 | /Z_A23 | 39.0 | 64.9
U20 | 24 | /3V3 | 39.4 | 64.9
U20 | 25 | /Z_D0 | 39.8 | 64.9
U20 | 26 | /Z_D1 | 40.2 | 64.9
U20 | 27 | /Z_D2 | 40.6 | 64.9
U20 | 28 | /Z_D3 | 41.0 | 64.9
U20 | 29 | /3V3 | 41.4 | 64.9
U20 | 30 | /RP2350B and support/RP_XIN | 41.8 | 64.9
U20 | 31 | /RP2350B and support/RP_XOUT | 42.2 | 64.9
U20 | 32 | /RP2350B and support/RP_DVDD | 42.6 | 64.9
U20 | 33 | /RP2350B and support/RP_SWCLK | 43.0 | 64.9
U20 | 34 | /RP2350B and support/RP_SWDIO | 43.4 | 64.9
U20 | 35 | /RP_RUN | 43.8 | 64.9
U20 | 36 | /Z_D4 | 44.2 | 64.9
U20 | 37 | /Z_D5 | 44.6 | 64.9
U20 | 38 | /Z_D6 | 45.0 | 64.9
U20 | 39 | /Z_D7 | 45.4 | 64.9
U20 | 40 | /Z_D8 | 45.8 | 64.9
U20 | 41 | /3V3 | 46.9 | 63.8
U20 | 42 | /Z_D9 | 46.9 | 63.4
U20 | 43 | /Z_D10 | 46.9 | 63.0
U20 | 44 | /Z_D11 | 46.9 | 62.6
U20 | 45 | /Z_D12 | 46.9 | 62.2
U20 | 46 | /Z_D13 | 46.9 | 61.8
U20 | 47 | /Z_D14 | 46.9 | 61.4
U20 | 48 | /Z_D15 | 46.9 | 61.0
U20 | 49 | /Z_UDS_N | 46.9 | 60.6
U20 | 50 | /3V3 | 46.9 | 60.2
U20 | 51 | /RP2350B and support/RP_DVDD | 46.9 | 59.8
U20 | 52 | /Z_LDS_N | 46.9 | 59.4
U20 | 53 | /Z_READ | 46.9 | 59.0
U20 | 54 | /Z_CFGIN_N | 46.9 | 58.6
U20 | 55 | /ACK_REQ | 46.9 | 58.2
U20 | 56 | /IRQ_REQ | 46.9 | 57.8
U20 | 57 | /BUS_READY | 46.9 | 57.4
U20 | 58 | /DATA_DRIVE | 46.9 | 57.0
U20 | 59 | /3V3 | 46.9 | 56.6
U20 | 60 | /3V3 | 46.9 | 56.2
U20 | 61 | /RP2350B and support/RP_VREG_AVDD | 45.8 | 55.1
U20 | 62 | /GND | 45.4 | 55.1
U20 | 63 | /RP2350B and support/RP_LX | 45.0 | 55.1
U20 | 64 | /3V3 | 44.6 | 55.1
U20 | 65 | /RP2350B and support/RP_DVDD | 44.2 | 55.1
U20 | 66 | /RP2350B and support/RP_USB_DM | 43.8 | 55.1
U20 | 67 | /RP2350B and support/RP_USB_DP | 43.4 | 55.1
U20 | 68 | /3V3 | 43.0 | 55.1
U20 | 69 | /3V3 | 42.6 | 55.1
U20 | 70 | /RP2350B and support/QSPI_SD3 | 42.2 | 55.1
U20 | 71 | /RP2350B and support/QSPI_SCLK | 41.8 | 55.1
U20 | 72 | /RP2350B and support/QSPI_SD0 | 41.4 | 55.1
U20 | 73 | /RP2350B and support/QSPI_SD2 | 41.0 | 55.1
U20 | 74 | /RP2350B and support/QSPI_SD1 | 40.6 | 55.1
U20 | 75 | /RP_BOOT_N | 40.2 | 55.1
U20 | 76 | /3V3 | 39.8 | 55.1
U20 | 77 | /Z_AS_N | 39.4 | 55.1
U20 | 78 | /Z_A1 | 39.0 | 55.1
U20 | 79 | /Z_A2 | 38.6 | 55.1
U20 | 80 | /Z_A3 | 38.2 | 55.1
U20 | 81 | /GND | 40.8 | 58.8
C20 | 1 | /3V3 | 31.5 | 42.075
C20 | 2 | /GND | 31.5 | 40.525
C35 | 1 | /3V3 | 40.0 | 53.175
C35 | 2 | /GND | 40.0 | 51.625
