markjfisher/fujinet-nio-hardware/amiga/prototyping-board/data/verification.csv

physical_pin | zorro_ii_signal | schematic_net_name | pcb_footprint_pad | header_testpoint_references | category
1 | GND | GND | J1.1 | J2.24;J3.17;J4.31;J4.32;J5.7;J5.8;J6.5;J6.6;J7.6;J8.11;J8.12;J9.5;J9.6;J9.7;J9.8;J9.9;J9.10;J9.11;J9.12;J10.10 | POWER
2 | GND | GND | J1.2 | J2.24;J3.17;J4.31;J4.32;J5.7;J5.8;J6.5;J6.6;J7.6;J8.11;J8.12;J9.5;J9.6;J9.7;J9.8;J9.9;J9.10;J9.11;J9.12;J10.10 | POWER
3 | GND | GND | J1.3 | J2.24;J3.17;J4.31;J4.32;J5.7;J5.8;J6.5;J6.6;J7.6;J8.11;J8.12;J9.5;J9.6;J9.7;J9.8;J9.9;J9.10;J9.11;J9.12;J10.10 | POWER
4 | GND | GND | J1.4 | J2.24;J3.17;J4.31;J4.32;J5.7;J5.8;J6.5;J6.6;J7.6;J8.11;J8.12;J9.5;J9.6;J9.7;J9.8;J9.9;J9.10;J9.11;J9.12;J10.10 | POWER
5 | +5V | +5V | J1.5 | J9.1;J9.2;J9.3;J9.4 | POWER
6 | +5V | +5V | J1.6 | J9.1;J9.2;J9.3;J9.4 | POWER
7 | /OWN | OWN_N | J1.7 | J7.1 | DMA / ARBITRATION
8 | -5V | -5V | J1.8 | TP1.1 | POWER
9 | /SLAVE | SLAVE_N | J1.9 | J5.1;J5.2 | AUTOCONFIG / SLOT CONTROL
10 | +12V | +12V | J1.10 | TP2.1 | POWER
11 | /CFGOUT | CFGOUT_N | J1.11 | J5.5;J5.6 | AUTOCONFIG / SLOT CONTROL
12 | /CFGIN | CFGIN_N | J1.12 | J5.3;J5.4 | AUTOCONFIG / SLOT CONTROL
13 | GND | GND | J1.13 | J2.24;J3.17;J4.31;J4.32;J5.7;J5.8;J6.5;J6.6;J7.6;J8.11;J8.12;J9.5;J9.6;J9.7;J9.8;J9.9;J9.10;J9.11;J9.12;J10.10 | POWER
14 | /C3 | C3_N | J1.14 | J8.1;J8.2 | CLOCKS
15 | CDAC | CDAC | J1.15 | J8.3;J8.4 | CLOCKS
16 | /C1 | C1_N | J1.16 | J8.5;J8.6 | CLOCKS
17 | /OVR | OVR_N | J1.17 | J4.11;J4.12 | BUS CONTROL
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
91 | GND in Zorro-II | SENSEZ3_91 | J1.91 | J10.9 | RESERVED / LEGACY
92 | E7M | CLK7M | J1.92 | J8.9;J8.10 | CLOCKS
93 | DOE | DOE | J1.93 | J4.27;J4.28 | BUS CONTROL
94 | /BUSRST | BUSRST_N | J1.94 | J4.29;J4.30 | BUS CONTROL
95 | /GBG | GBG_N | J1.95 | J7.5 | DMA / ARBITRATION
96 | Reserved | RESERVED_96 | J1.96 | J10.4 | RESERVED / LEGACY
97 | NC | NC_97 | J1.97 | J10.7 | RESERVED / LEGACY
98 | NC | NC_98 | J1.98 | J10.8 | RESERVED / LEGACY
99 | GND | GND | J1.99 | J2.24;J3.17;J4.31;J4.32;J5.7;J5.8;J6.5;J6.6;J7.6;J8.11;J8.12;J9.5;J9.6;J9.7;J9.8;J9.9;J9.10;J9.11;J9.12;J10.10 | POWER
100 | GND | GND | J1.100 | J2.24;J3.17;J4.31;J4.32;J5.7;J5.8;J6.5;J6.6;J7.6;J8.11;J8.12;J9.5;J9.6;J9.7;J9.8;J9.9;J9.10;J9.11;J9.12;J10.10 | POWER
