markjfisher/fujinet-nio-hardware/amiga/integrated-a500-r4/review/schematic.pdf

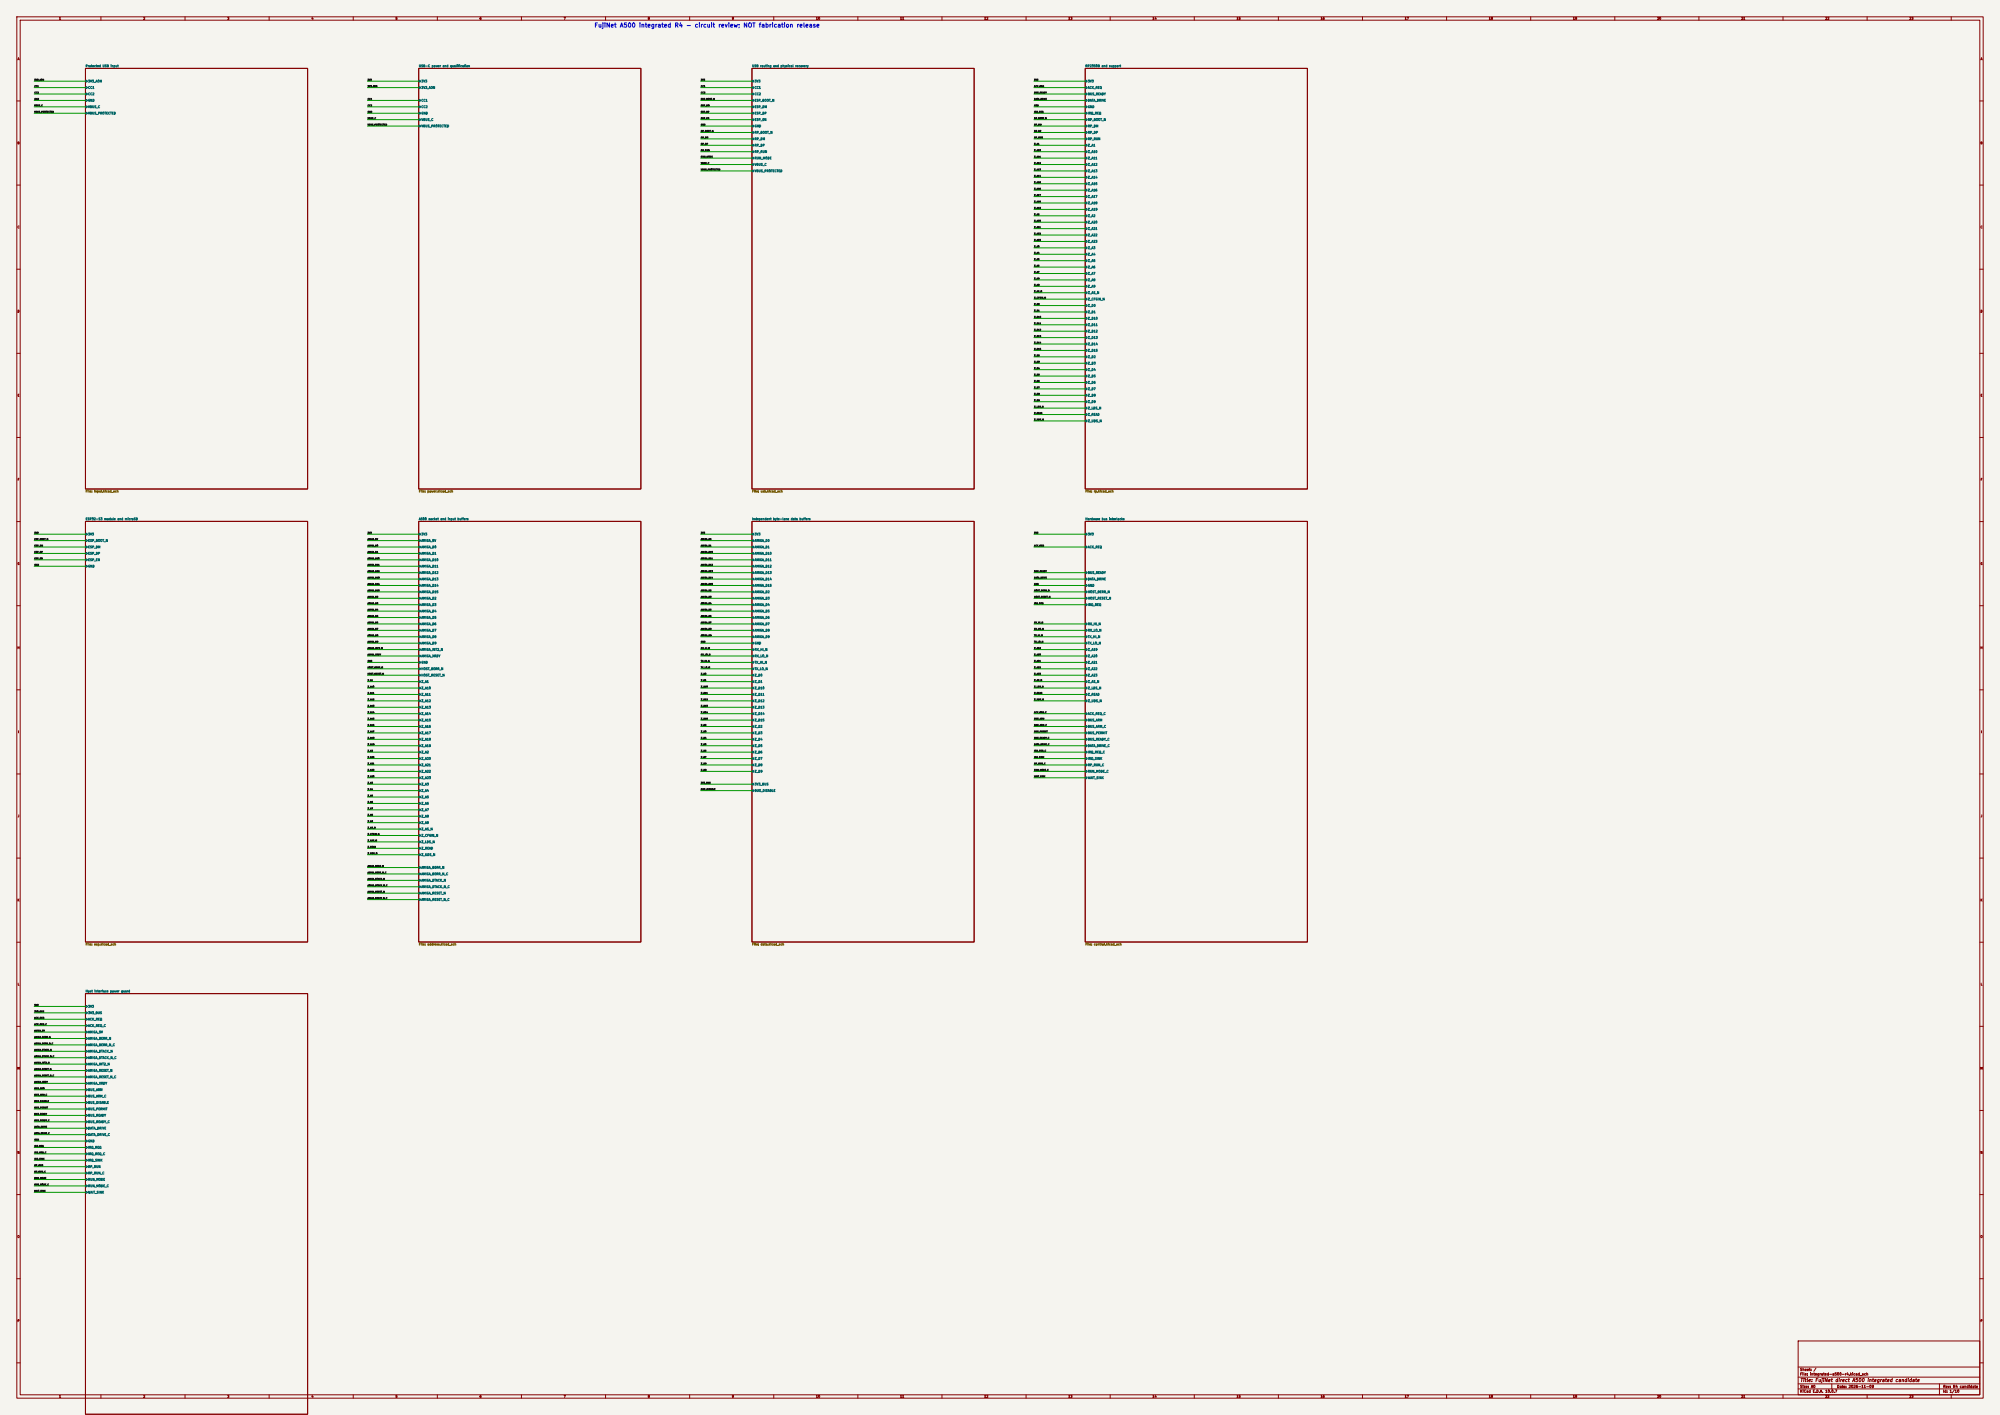
[picture p38: page 1]

FujiNet A500 integrated R4 - circuit review; NOT fabrication release

VBUS_PROTECTED USB-C power and qualification

VBUS_PROTECTED USB routing and physical recovery

A500 socket and input buffers

Independent byte-lane data buffers

Host interface power guard

Sheet: /
File: integrated-a500-r4.kicad_sch
Title: FujiNet direct A500 integrated candidate

Size: A0 | Rev: R4 candidate
KiCad E.D.A. 10.0.7 | Id: 1/10

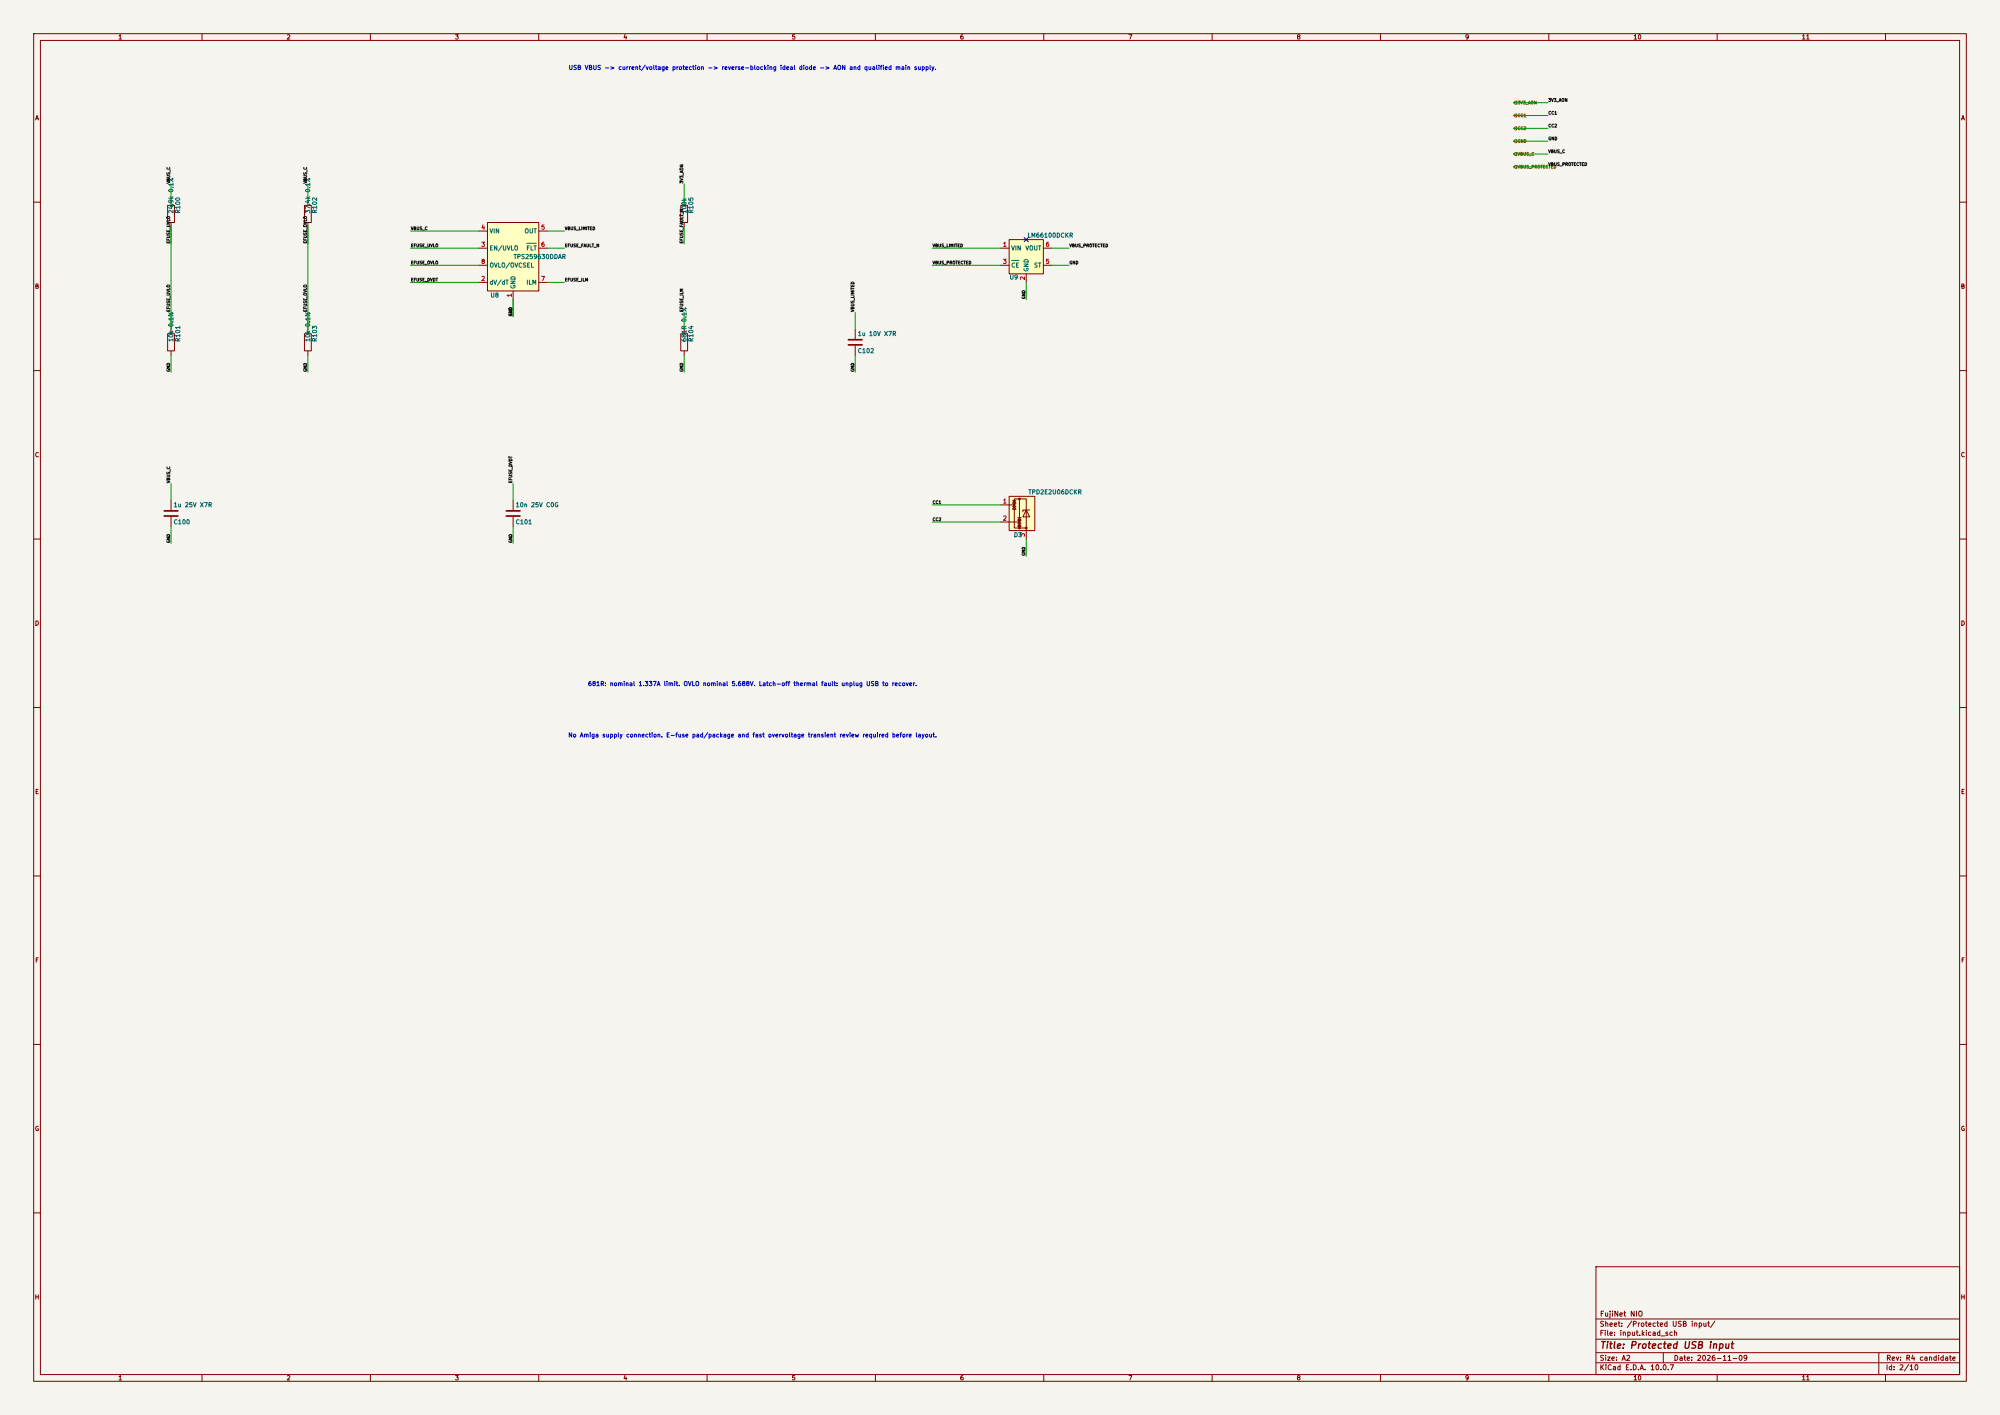
[picture p39: page 2]

USB VBUS -> current/voltage protection -> reverse-blocking ideal diode -> AON and qualified main supply.

CC1 VBUS_LIMITED No Amiga supply connection. E-fuse pad/package and fast overvoltage transient review required before layout. 681R: nominal 1.337A limit. OVLO nominal 5.688V. Latch-off thermal fault: unplug USB to recover.

FujiNet NIO
Sheet: /Protected USB input/
File: input.kicad_sch
Title: Protected USB input

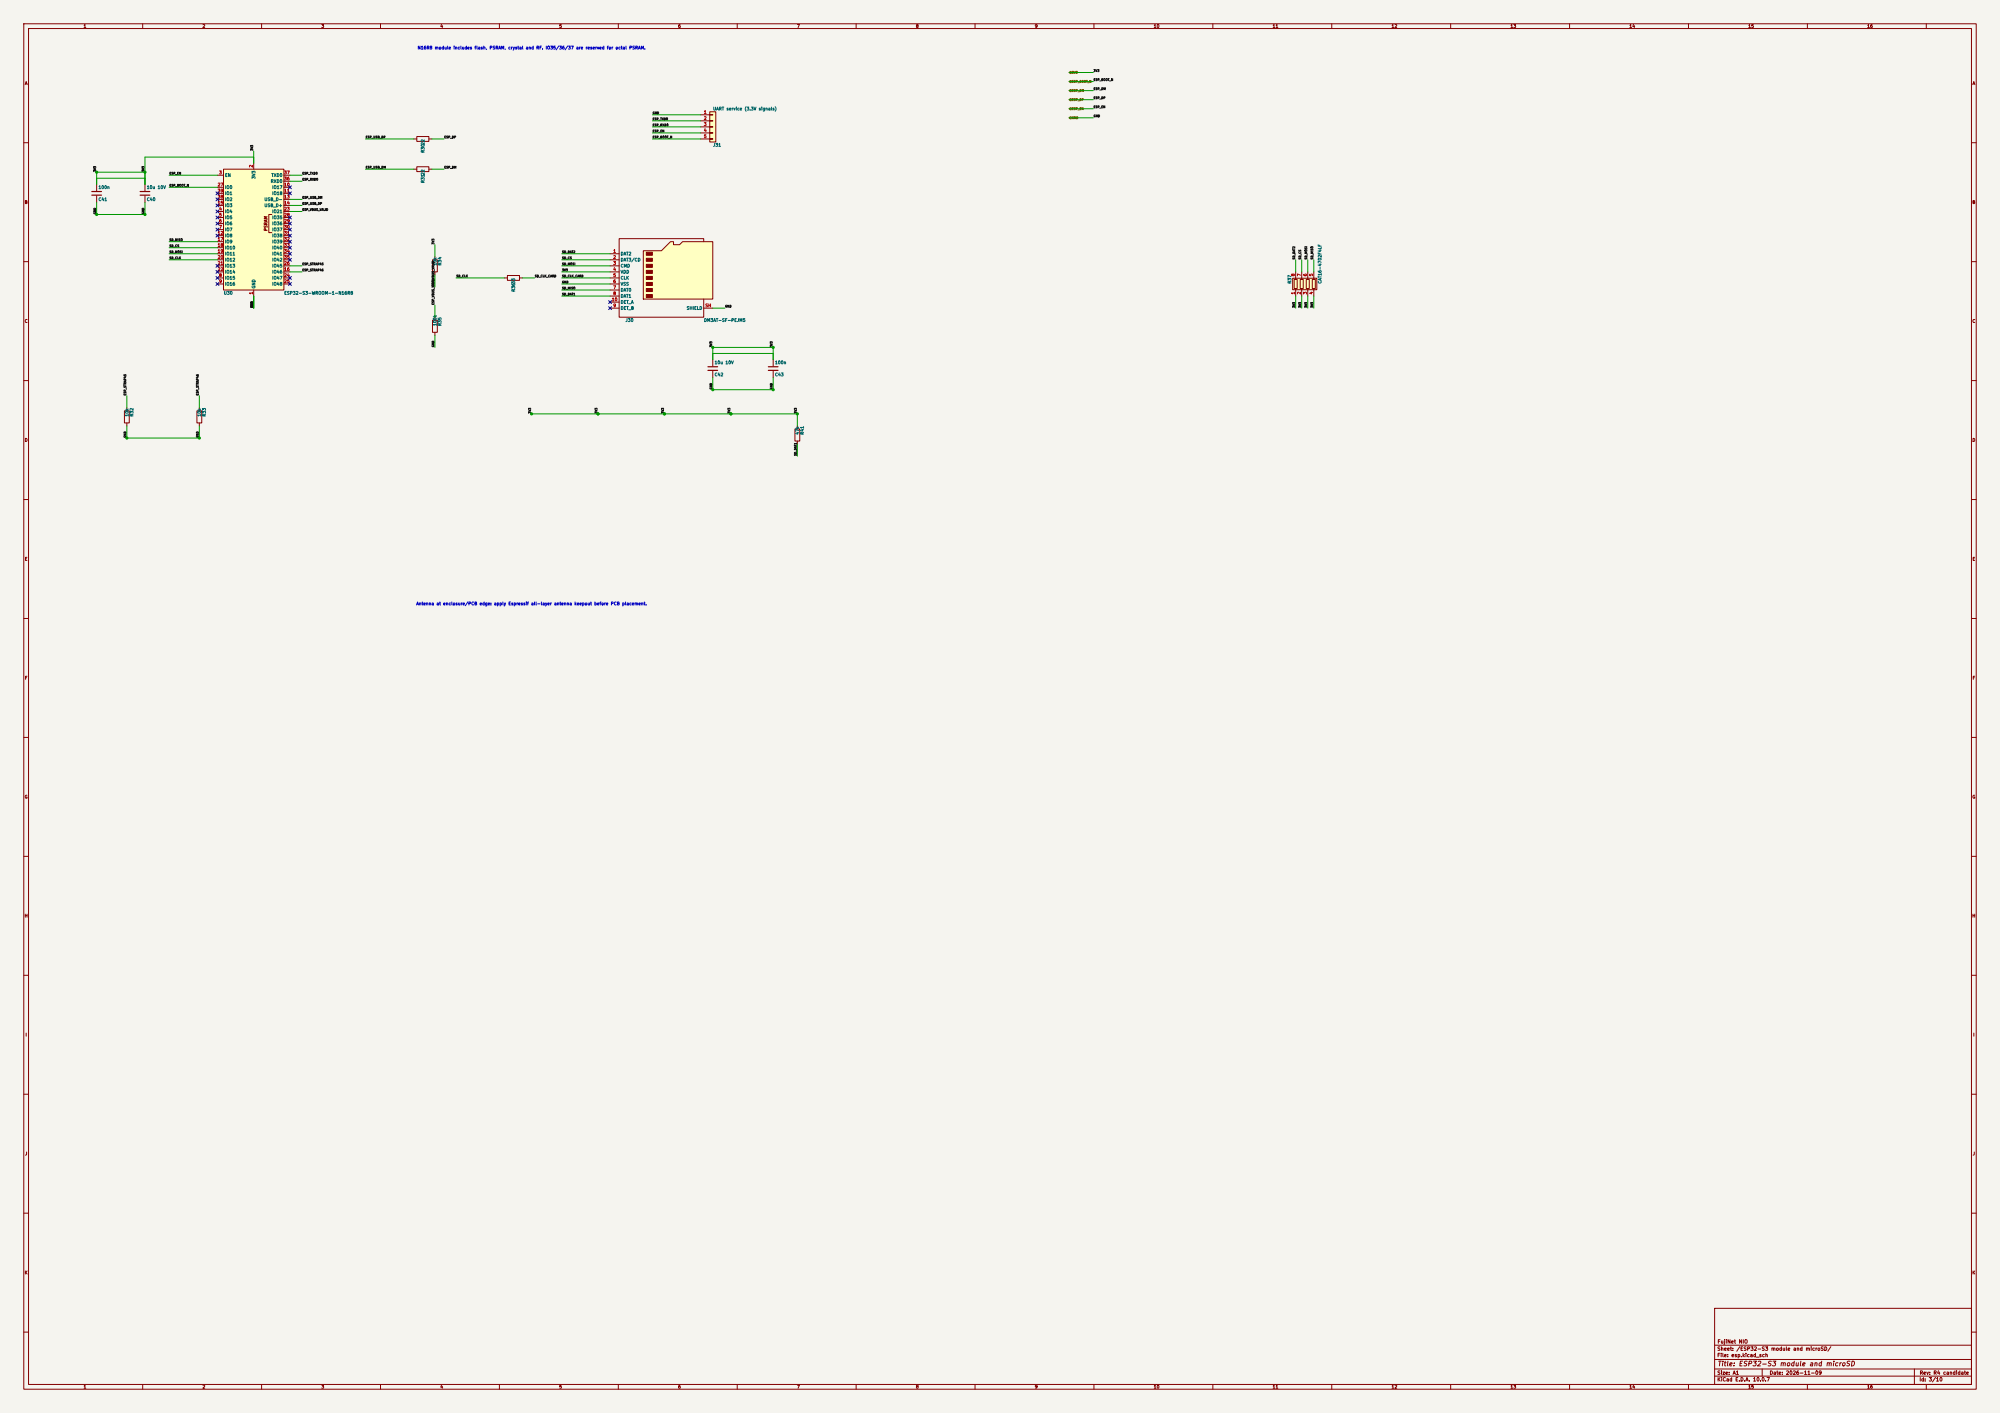
[picture p40: page 3]

N16R8 module includes flash, PSRAM, crystal and RF. IO35/36/37 are reserved for octal PSRAM.

Antenna at enclosure/PCB edge: apply Espressif all-layer antenna keepout before PCB placement.

Sheet: /ESP32-S3 module and microSD/
File: esp.kicad_sch
Title: ESP32-S3 module and microSD

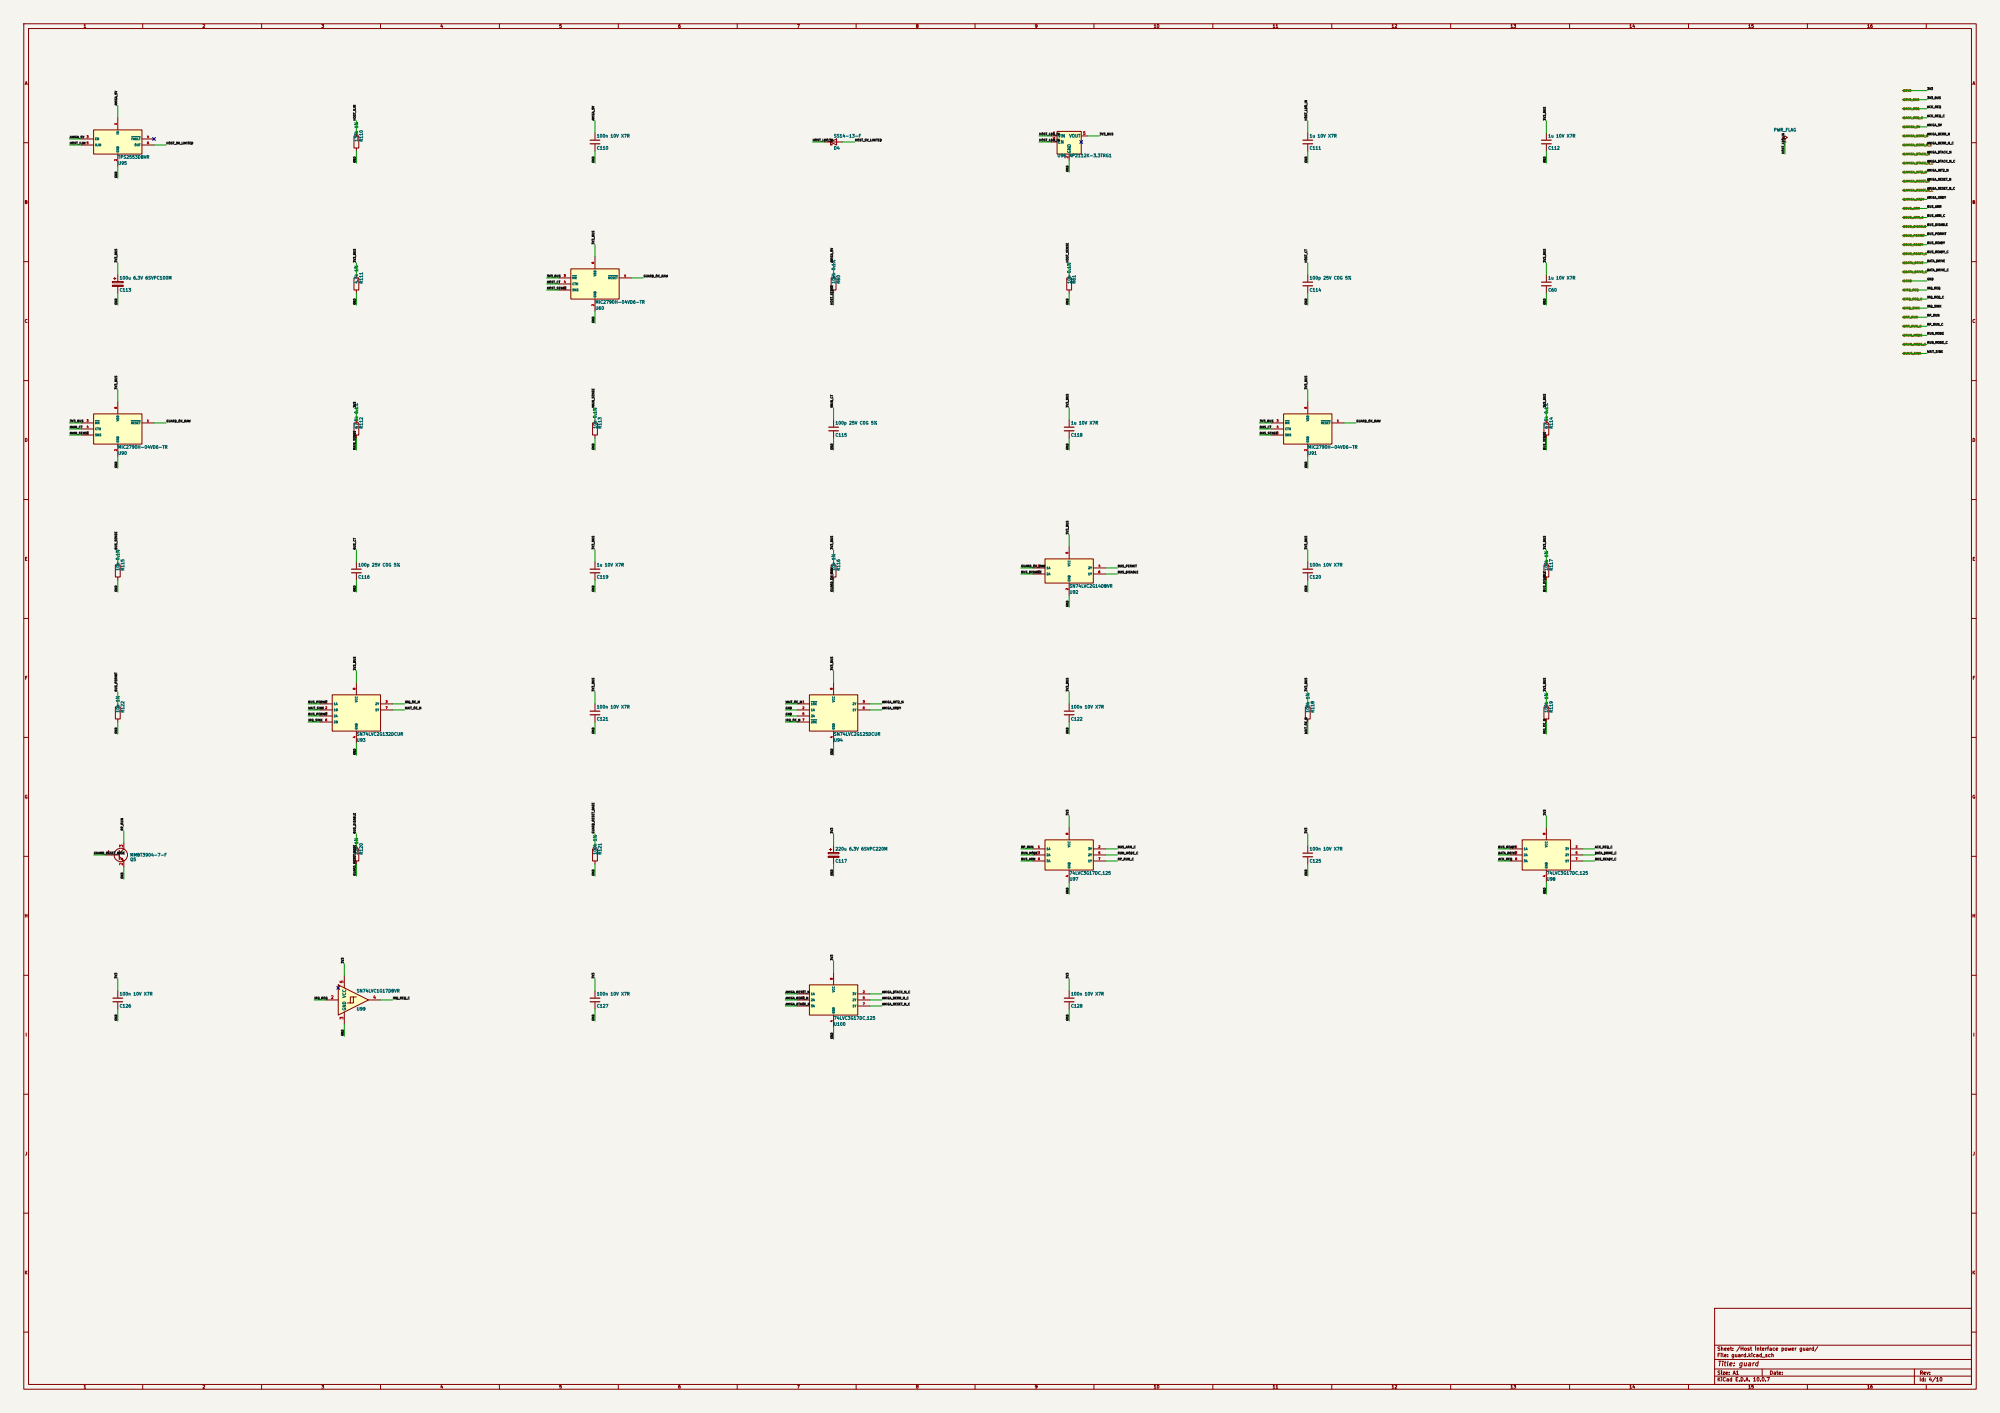
[picture p41: page 4]

Sheet: /Host interface power guard/ 100k R121 1%

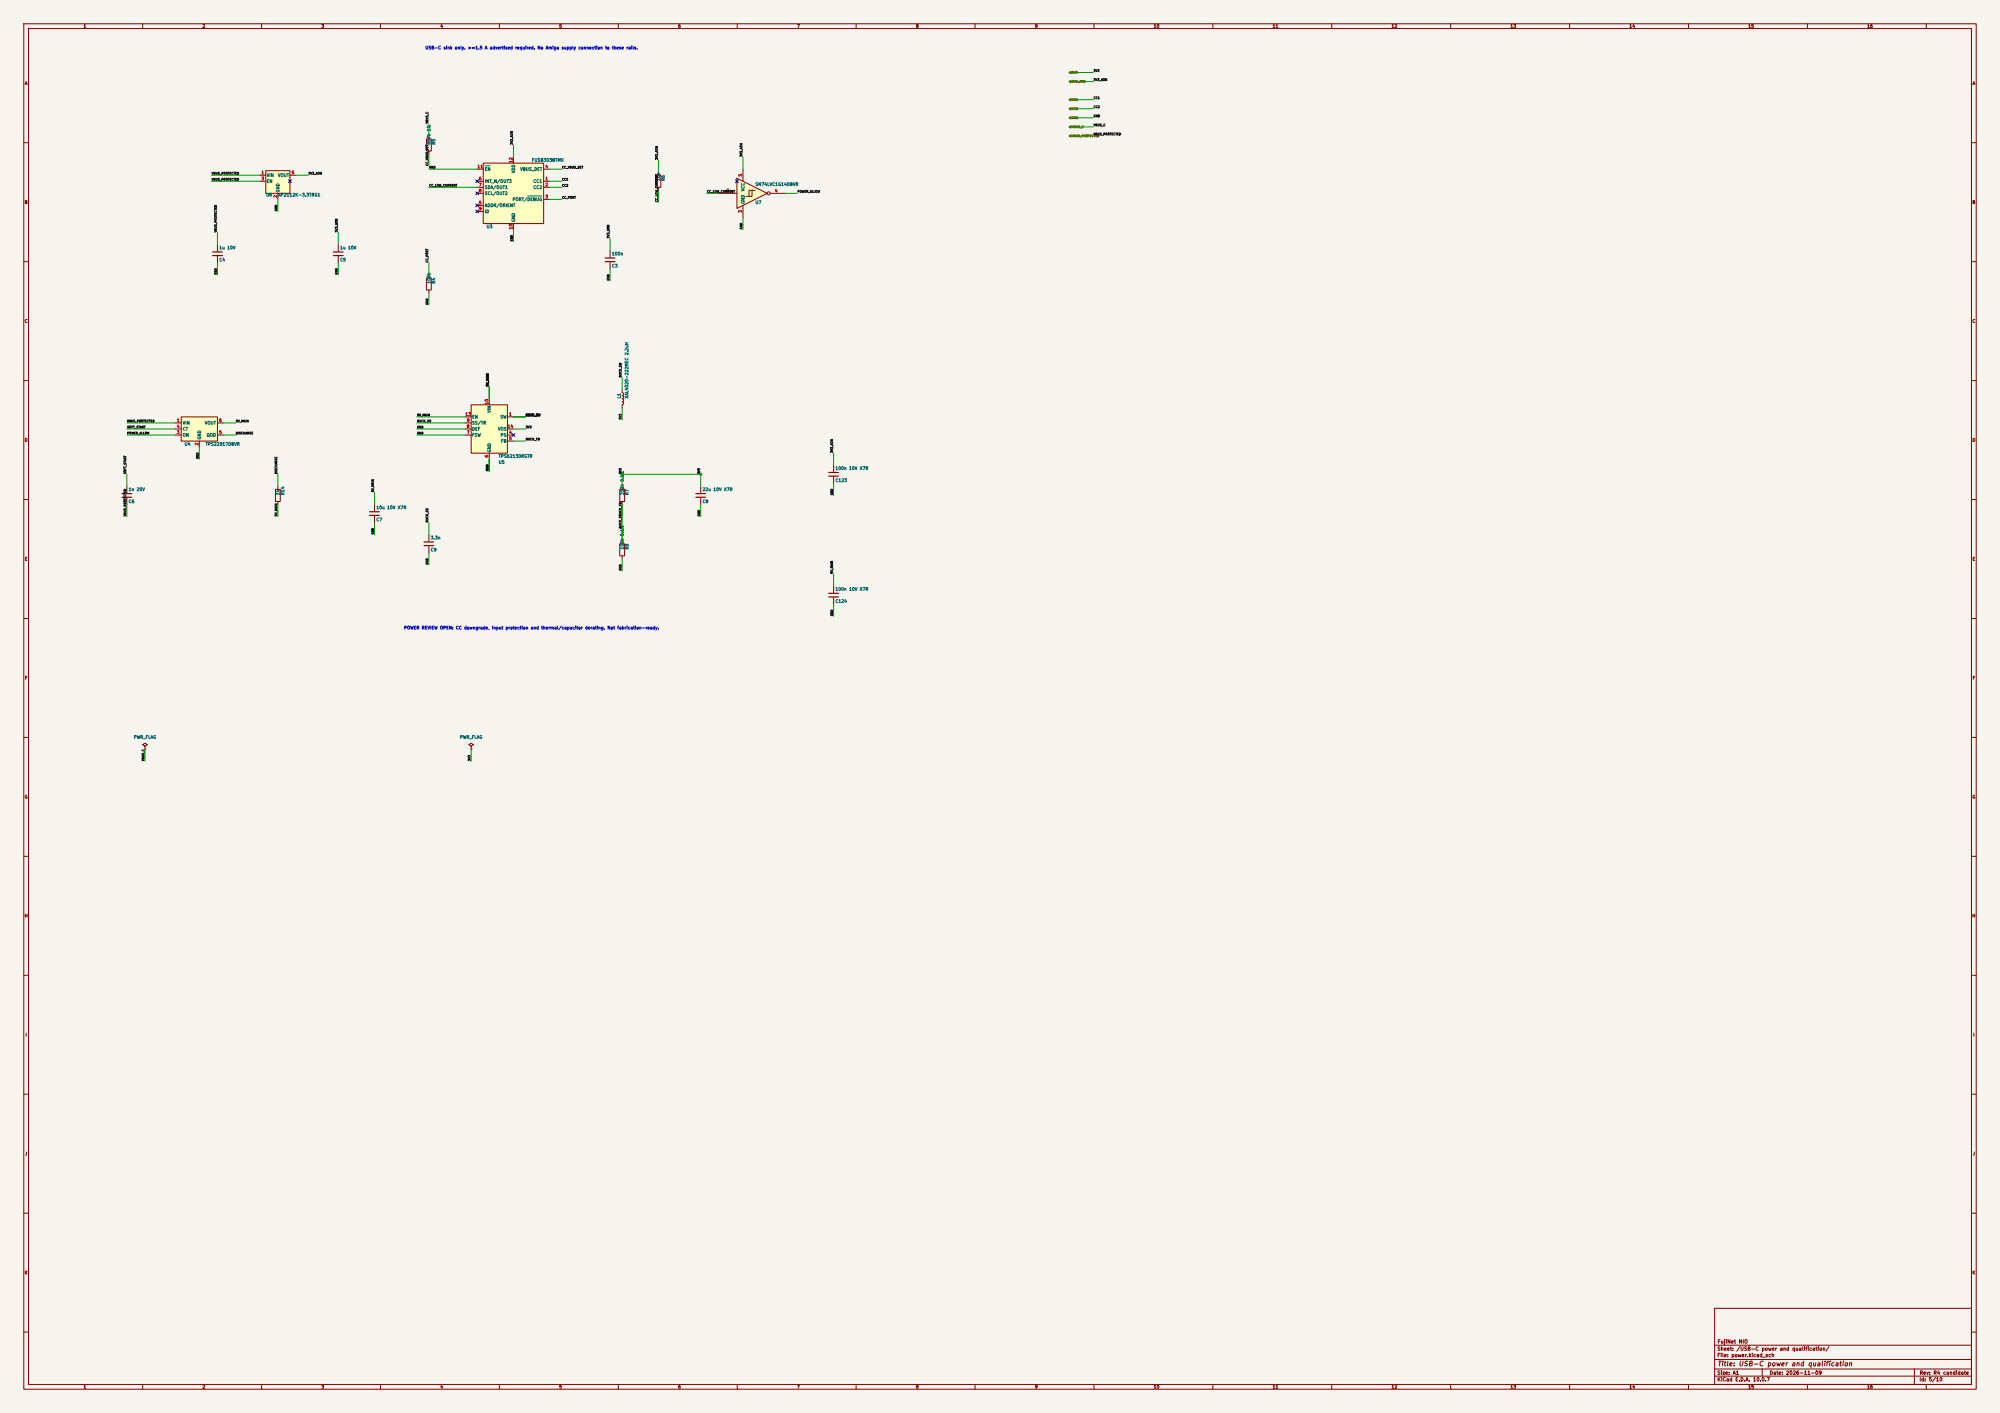
[picture p42: page 5]

USB-C sink only. >=1.5 A advertised required. No Amiga supply connection to these rails.
GND 5V_MAIN

Sheet: /USB-C power and qualification/
File: power.kicad_sch
Title: USB-C power and qualification

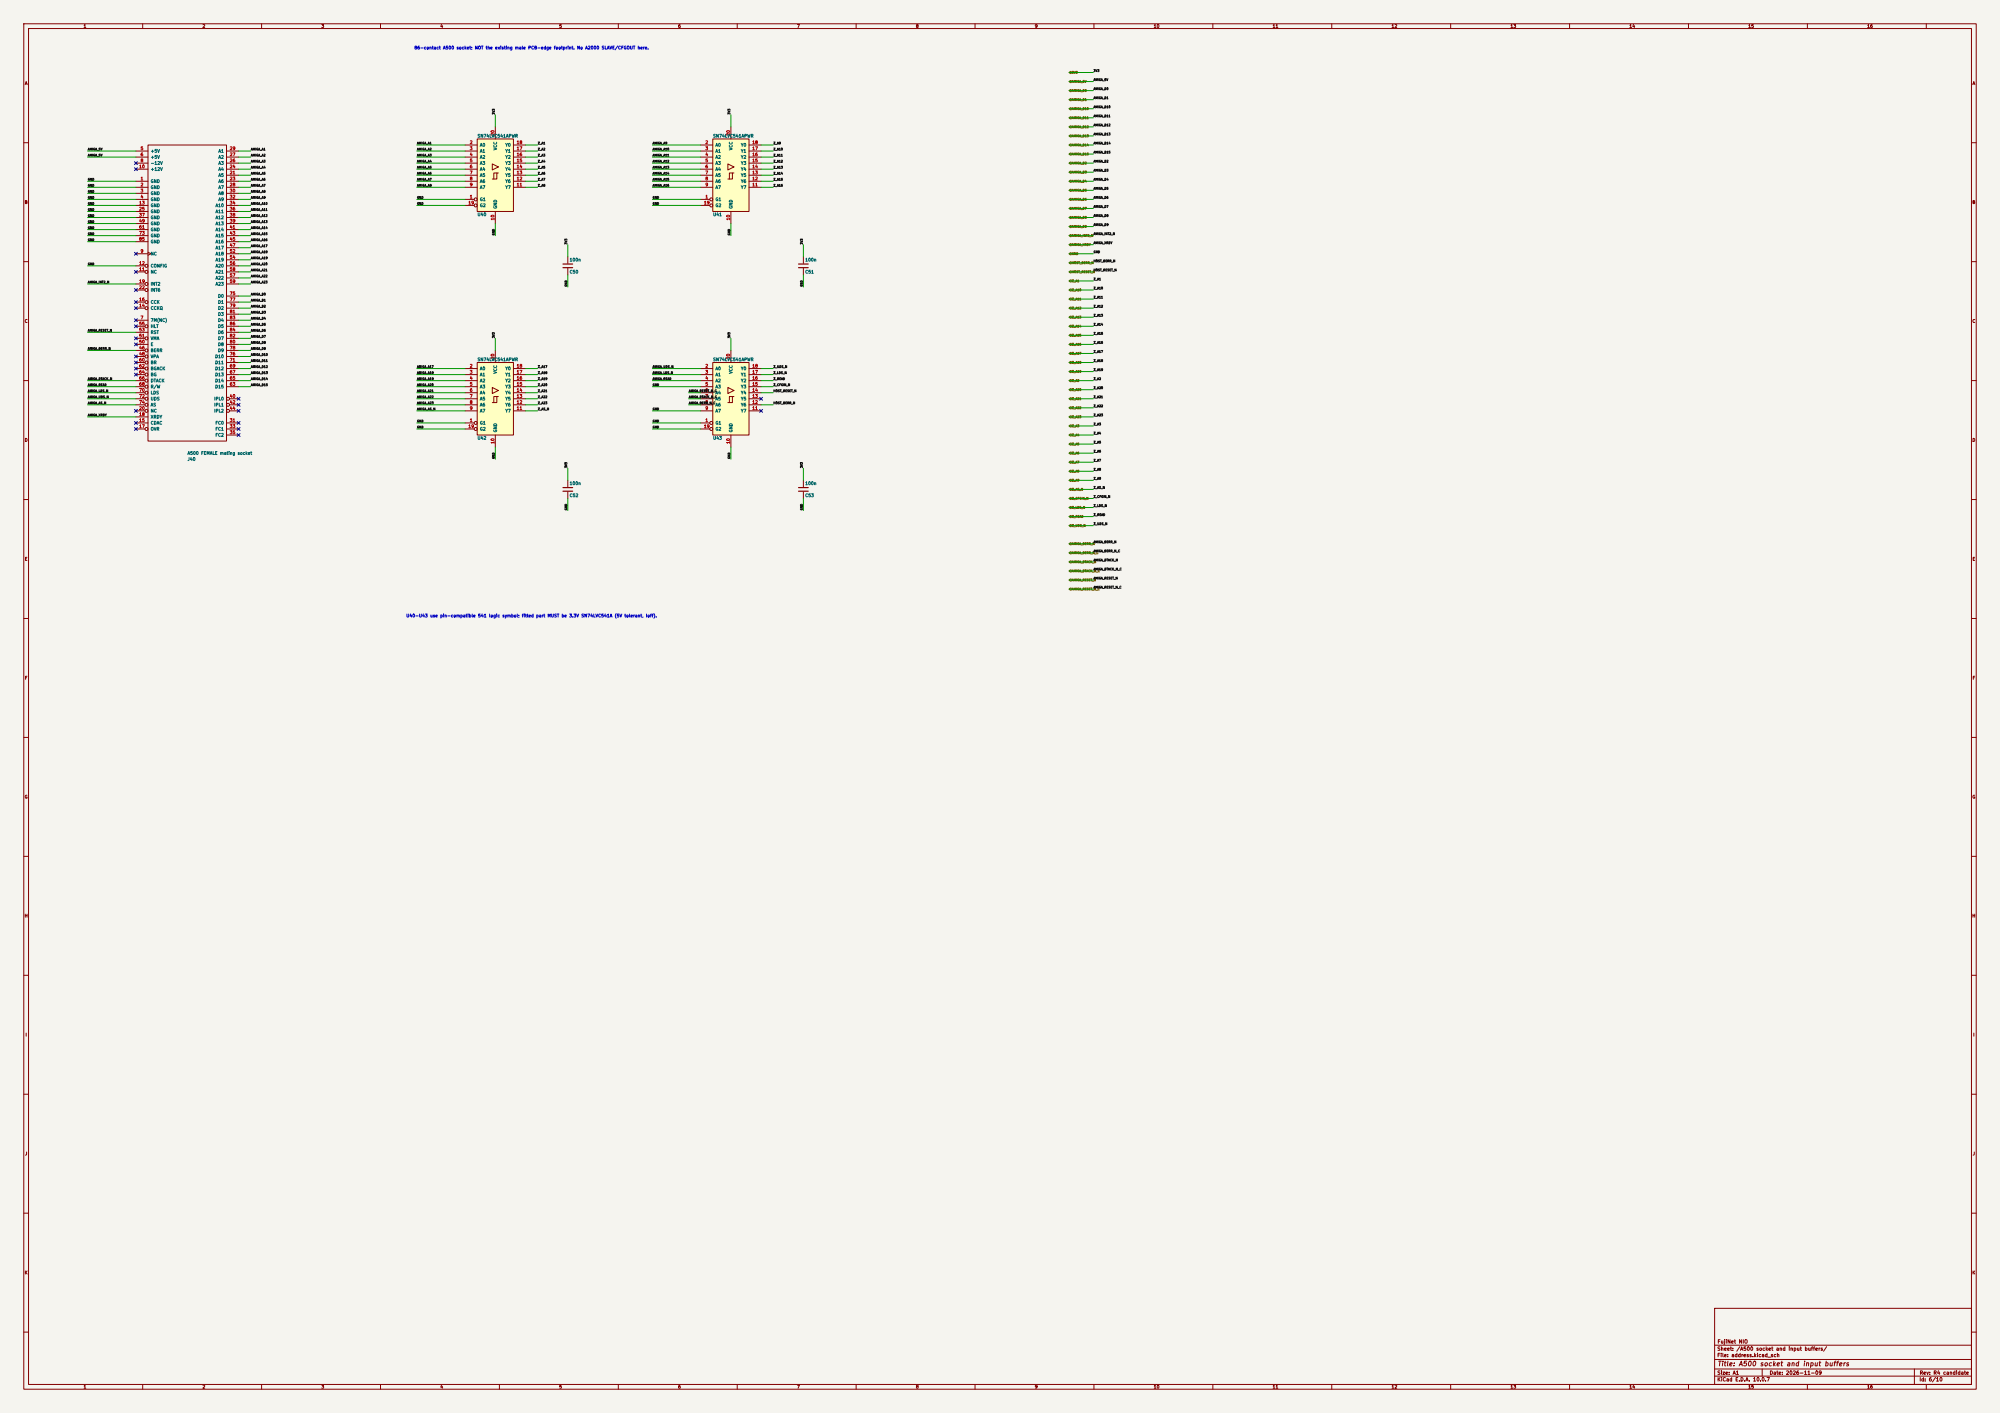
[picture p43: page 6]

U40-U43 use pin-compatible 541 logic symbol; fitted part MUST be 3.3V SN74LVC541A (5V tolerant, Ioff).

Sheet: /A500 socket and input buffers/
File: address.kicad_sch
Title: A500 socket and input buffers

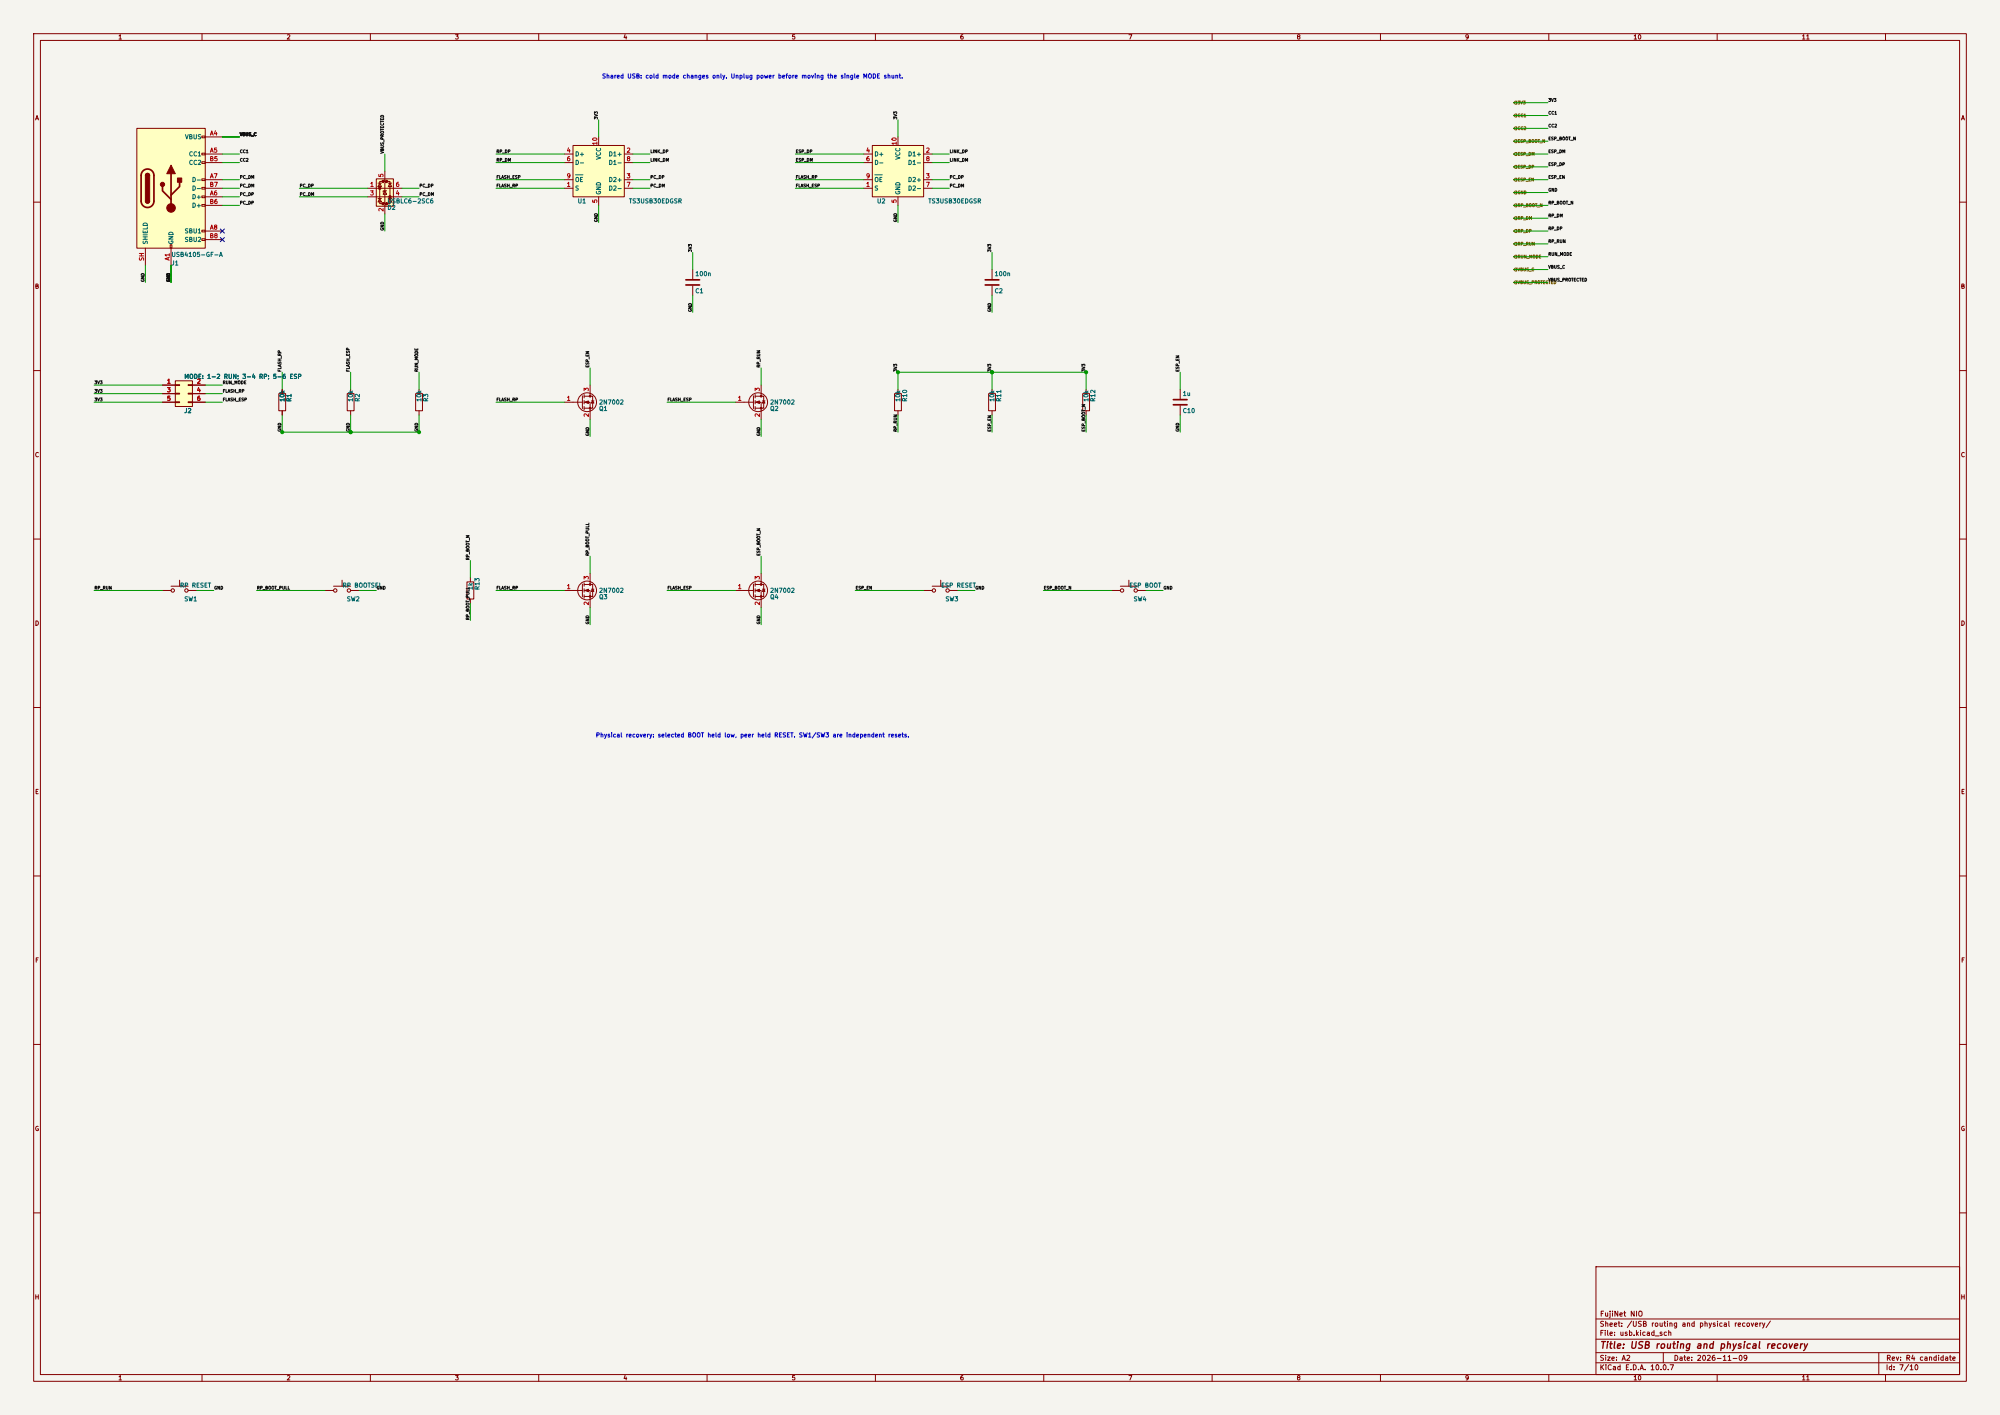
[picture p44: page 7]

Physical recovery: selected BOOT held low, peer held RESET. SW1/SW3 are independent resets.

Sheet: /USB routing and physical recovery/
File: usb.kicad_sch
Title: USB routing and physical recovery

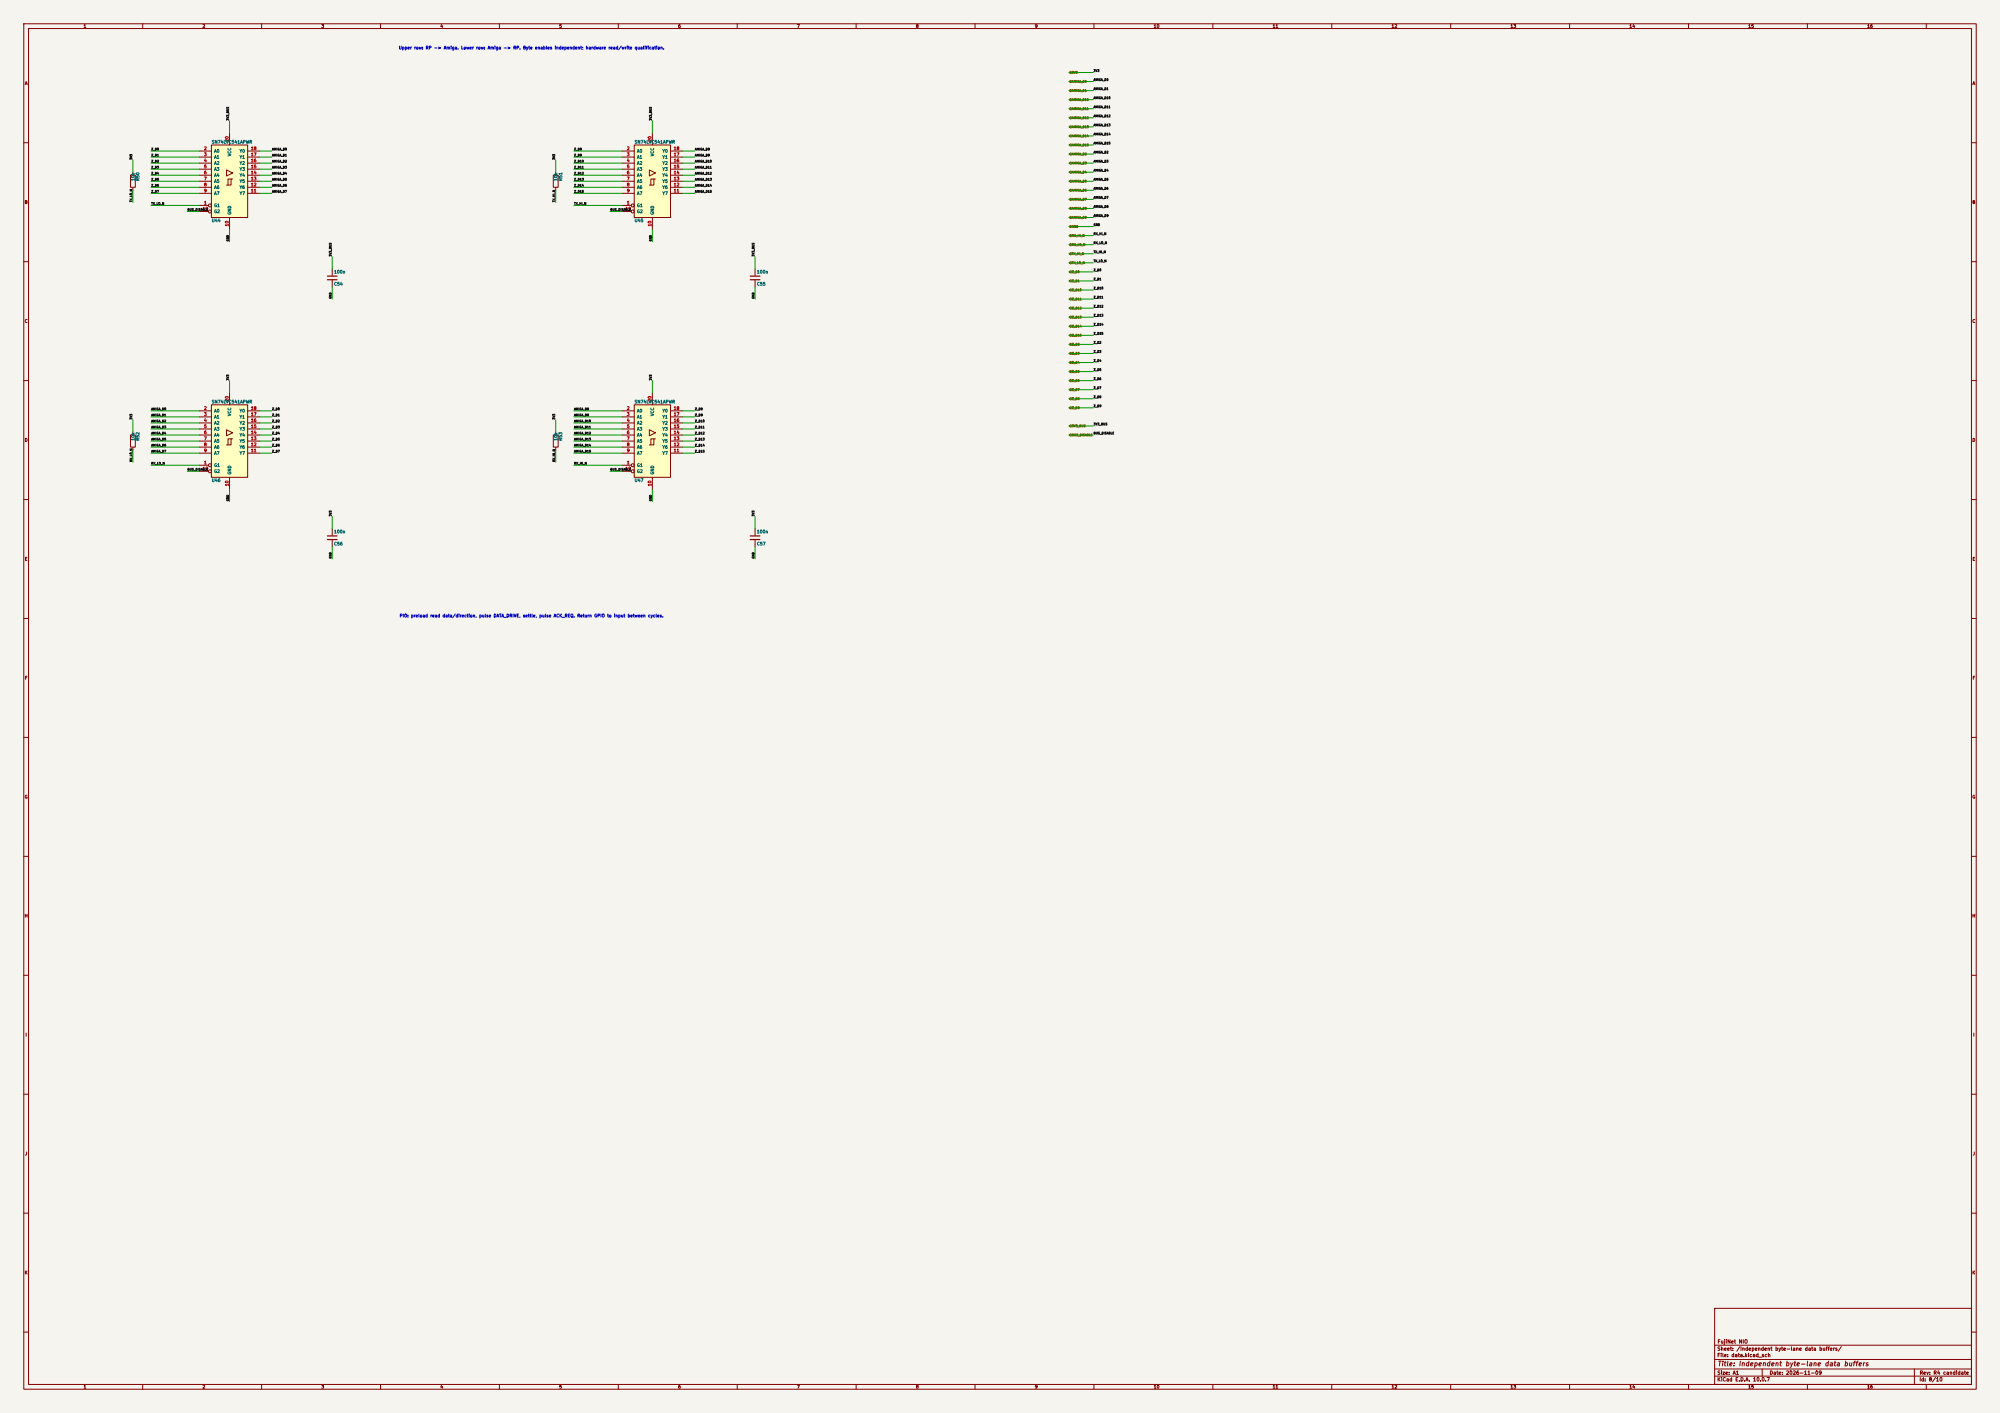
[picture p45: page 8]

Upper row: RP -> Amiga. Lower row: Amiga -> RP. Byte enables independent; hardware read/write qualification.

PIO: preload read data/direction, pulse DATA_DRIVE, settle, pulse ACK_REQ. Return GPIO to input between cycles.

Sheet: /Independent byte-lane data buffers/
File: data.kicad_sch
Title: Independent byte-lane data buffers

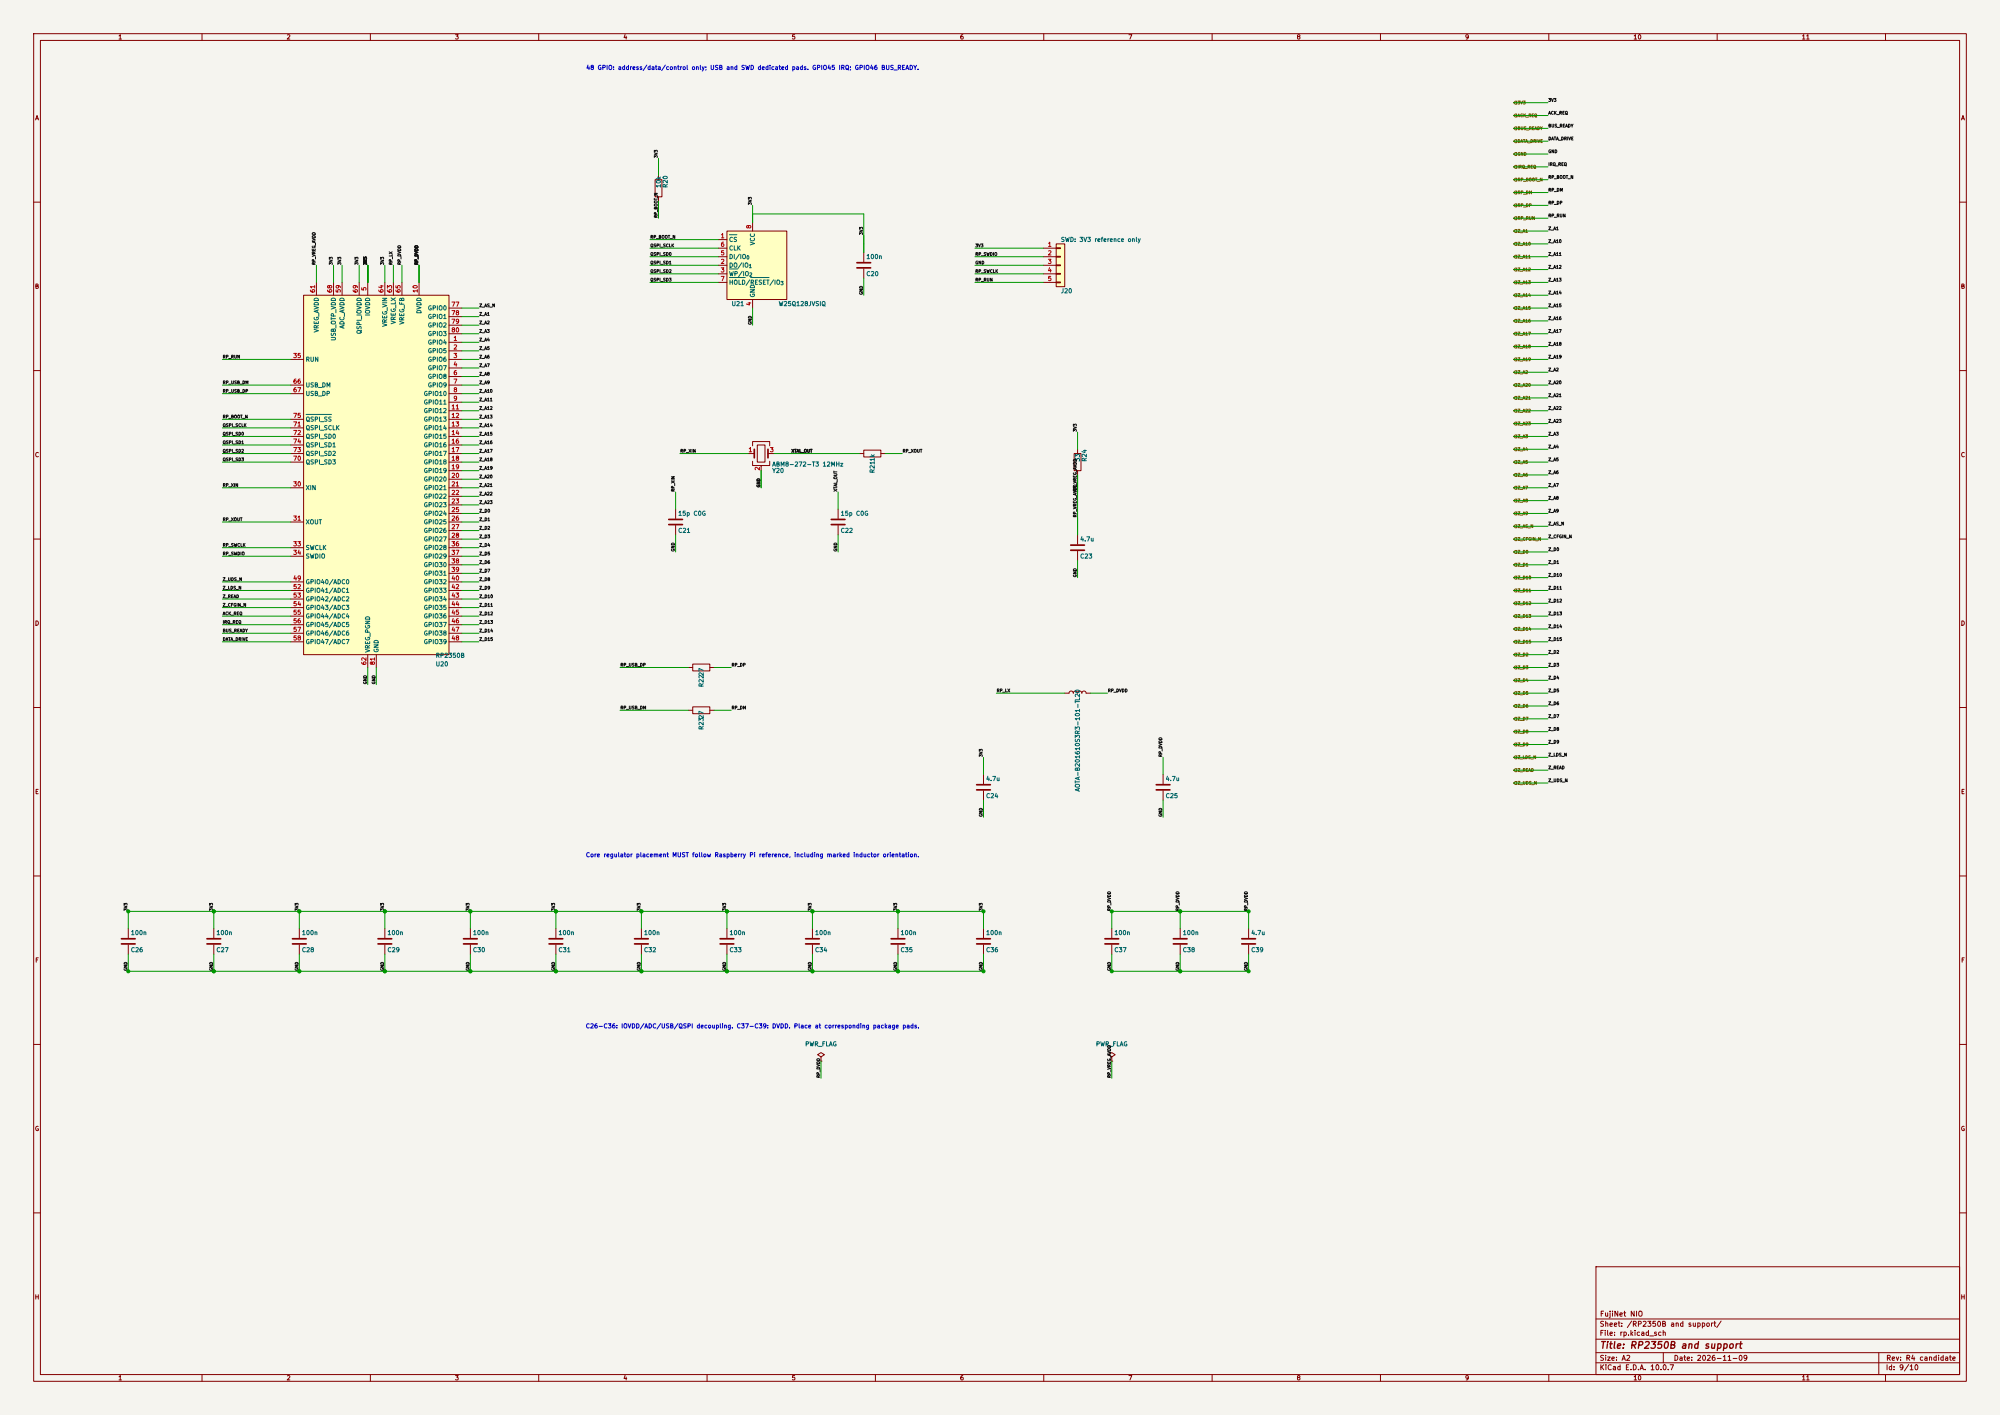
[picture p46: page 9]

48 GPIO: address/data/control only; USB and SWD dedicated pads. GPIO45 IRQ; GPIO46 BUS_READY.
SWD: 3V3 reference only L20 AOTA-B201610S3R3-101-T C36

C26-C36: IOVDD/ADC/USB/QSPI decoupling. C37-C39: DVDD. Place at corresponding package pads.

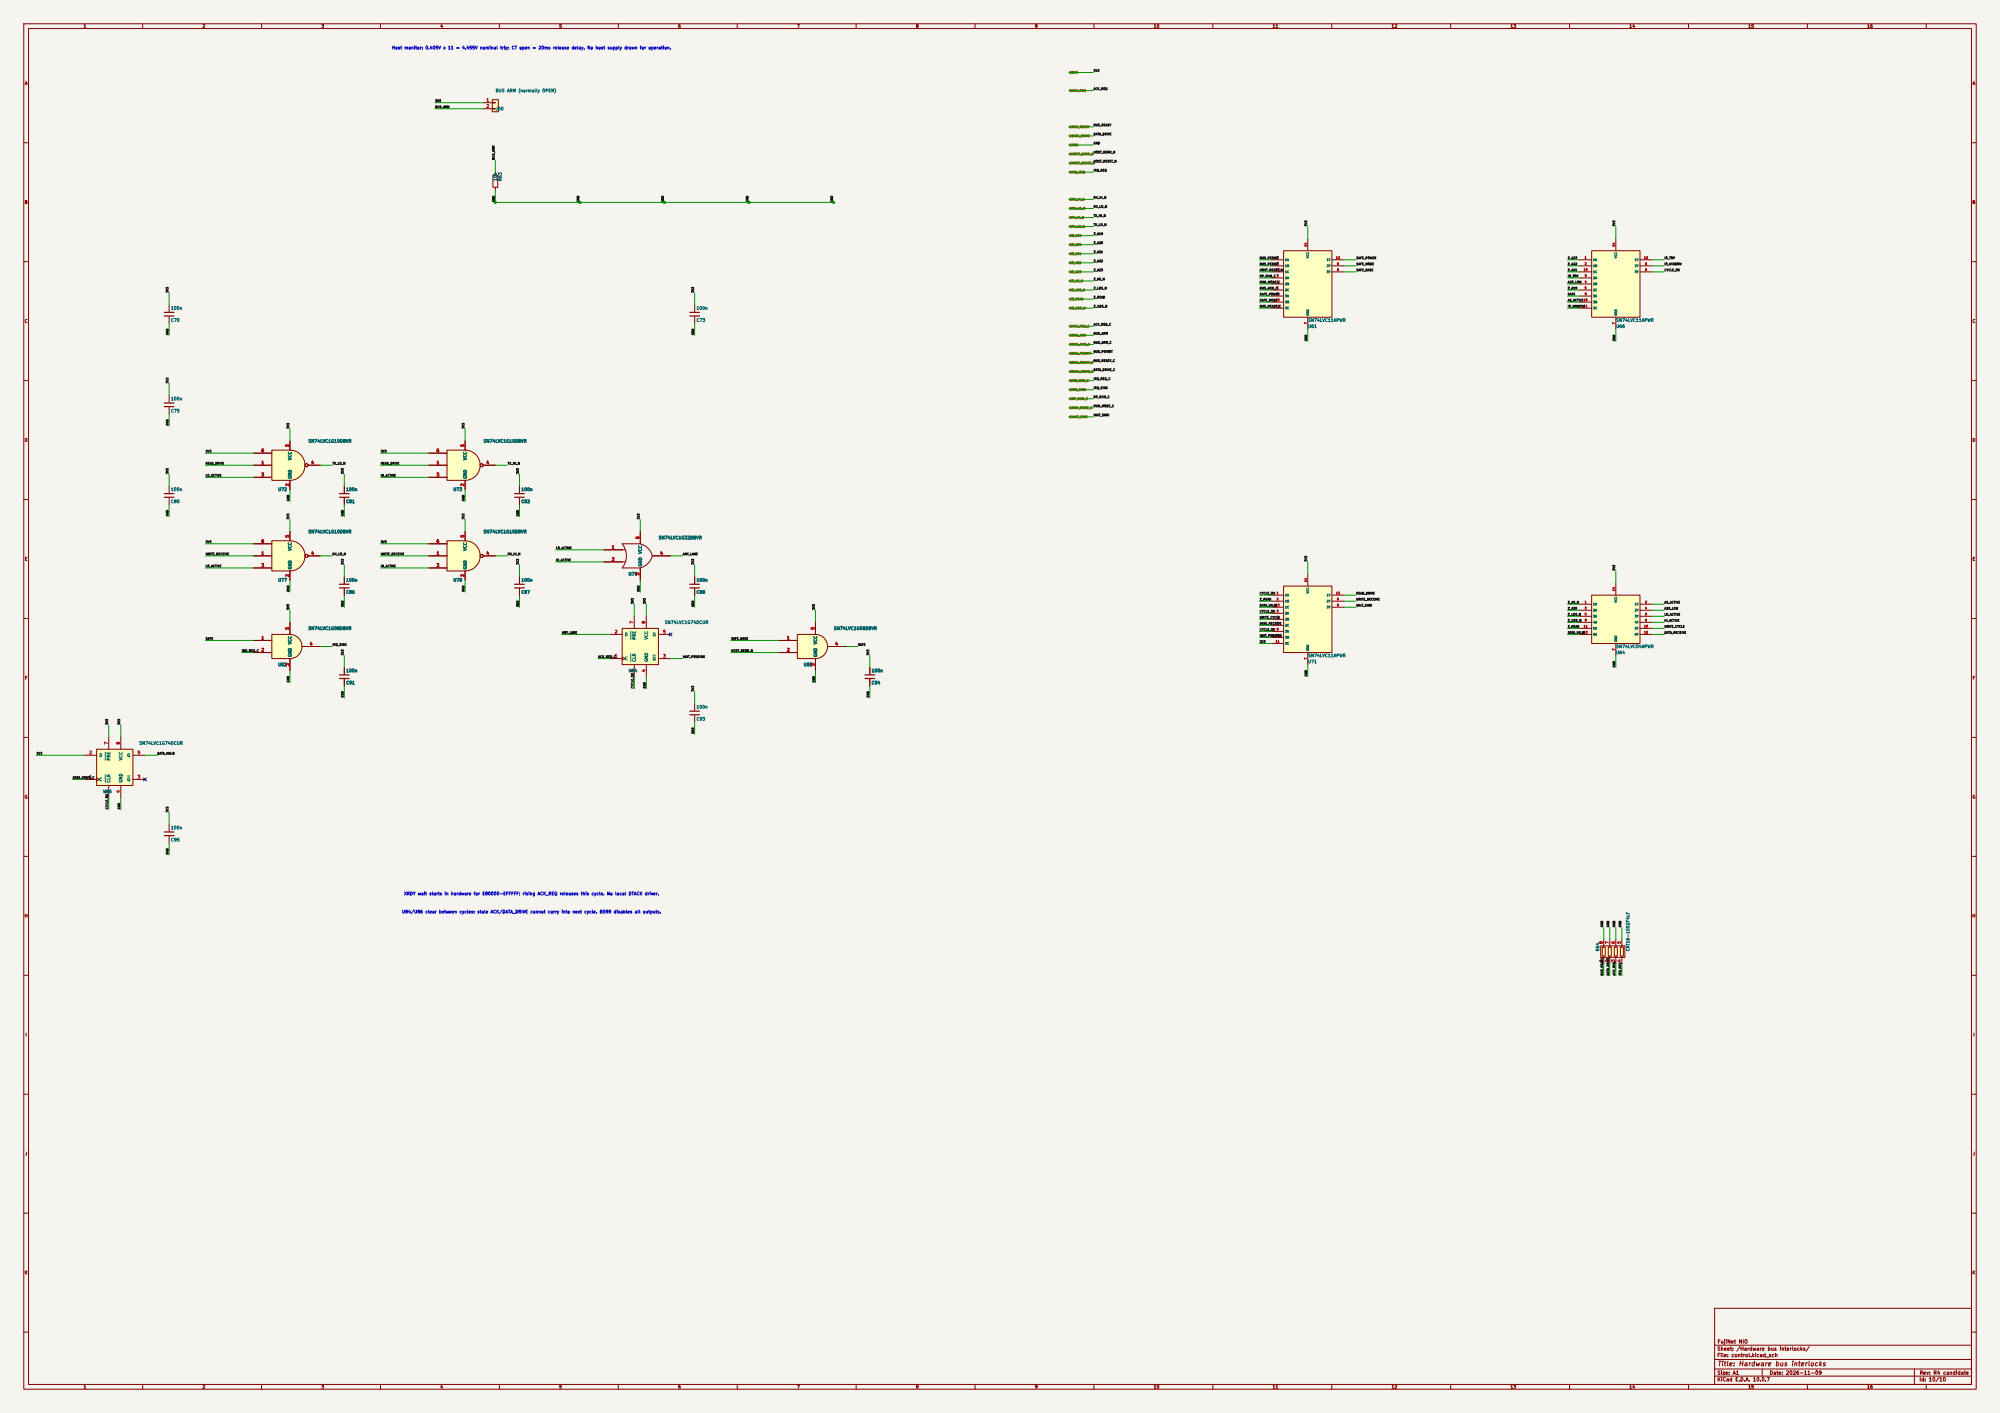
[picture p47: page 10]

Host monitor: 0.405V x 11 = 4.455V nominal trip; CT open = 20ms release delay. No host supply drawn for operation.
SN74LVC1G74DCUR 10k R63

J60 BUS ARM (normally OPEN) C70

XRDY wait starts in hardware for E80000-EFFFFF; rising ACK_REQ releases this cycle. No local DTACK driver.

U84/U86 clear between cycles: stale ACK/DATA_DRIVE cannot carry into next cycle. BERR disables all outputs.

Sheet: /Hardware bus interlocks/
File: control.kicad_sch
Title: Hardware bus interlocks
