markjfisher/fujinet-nio-hardware/amiga/prototyping-board/review/schematic.pdf

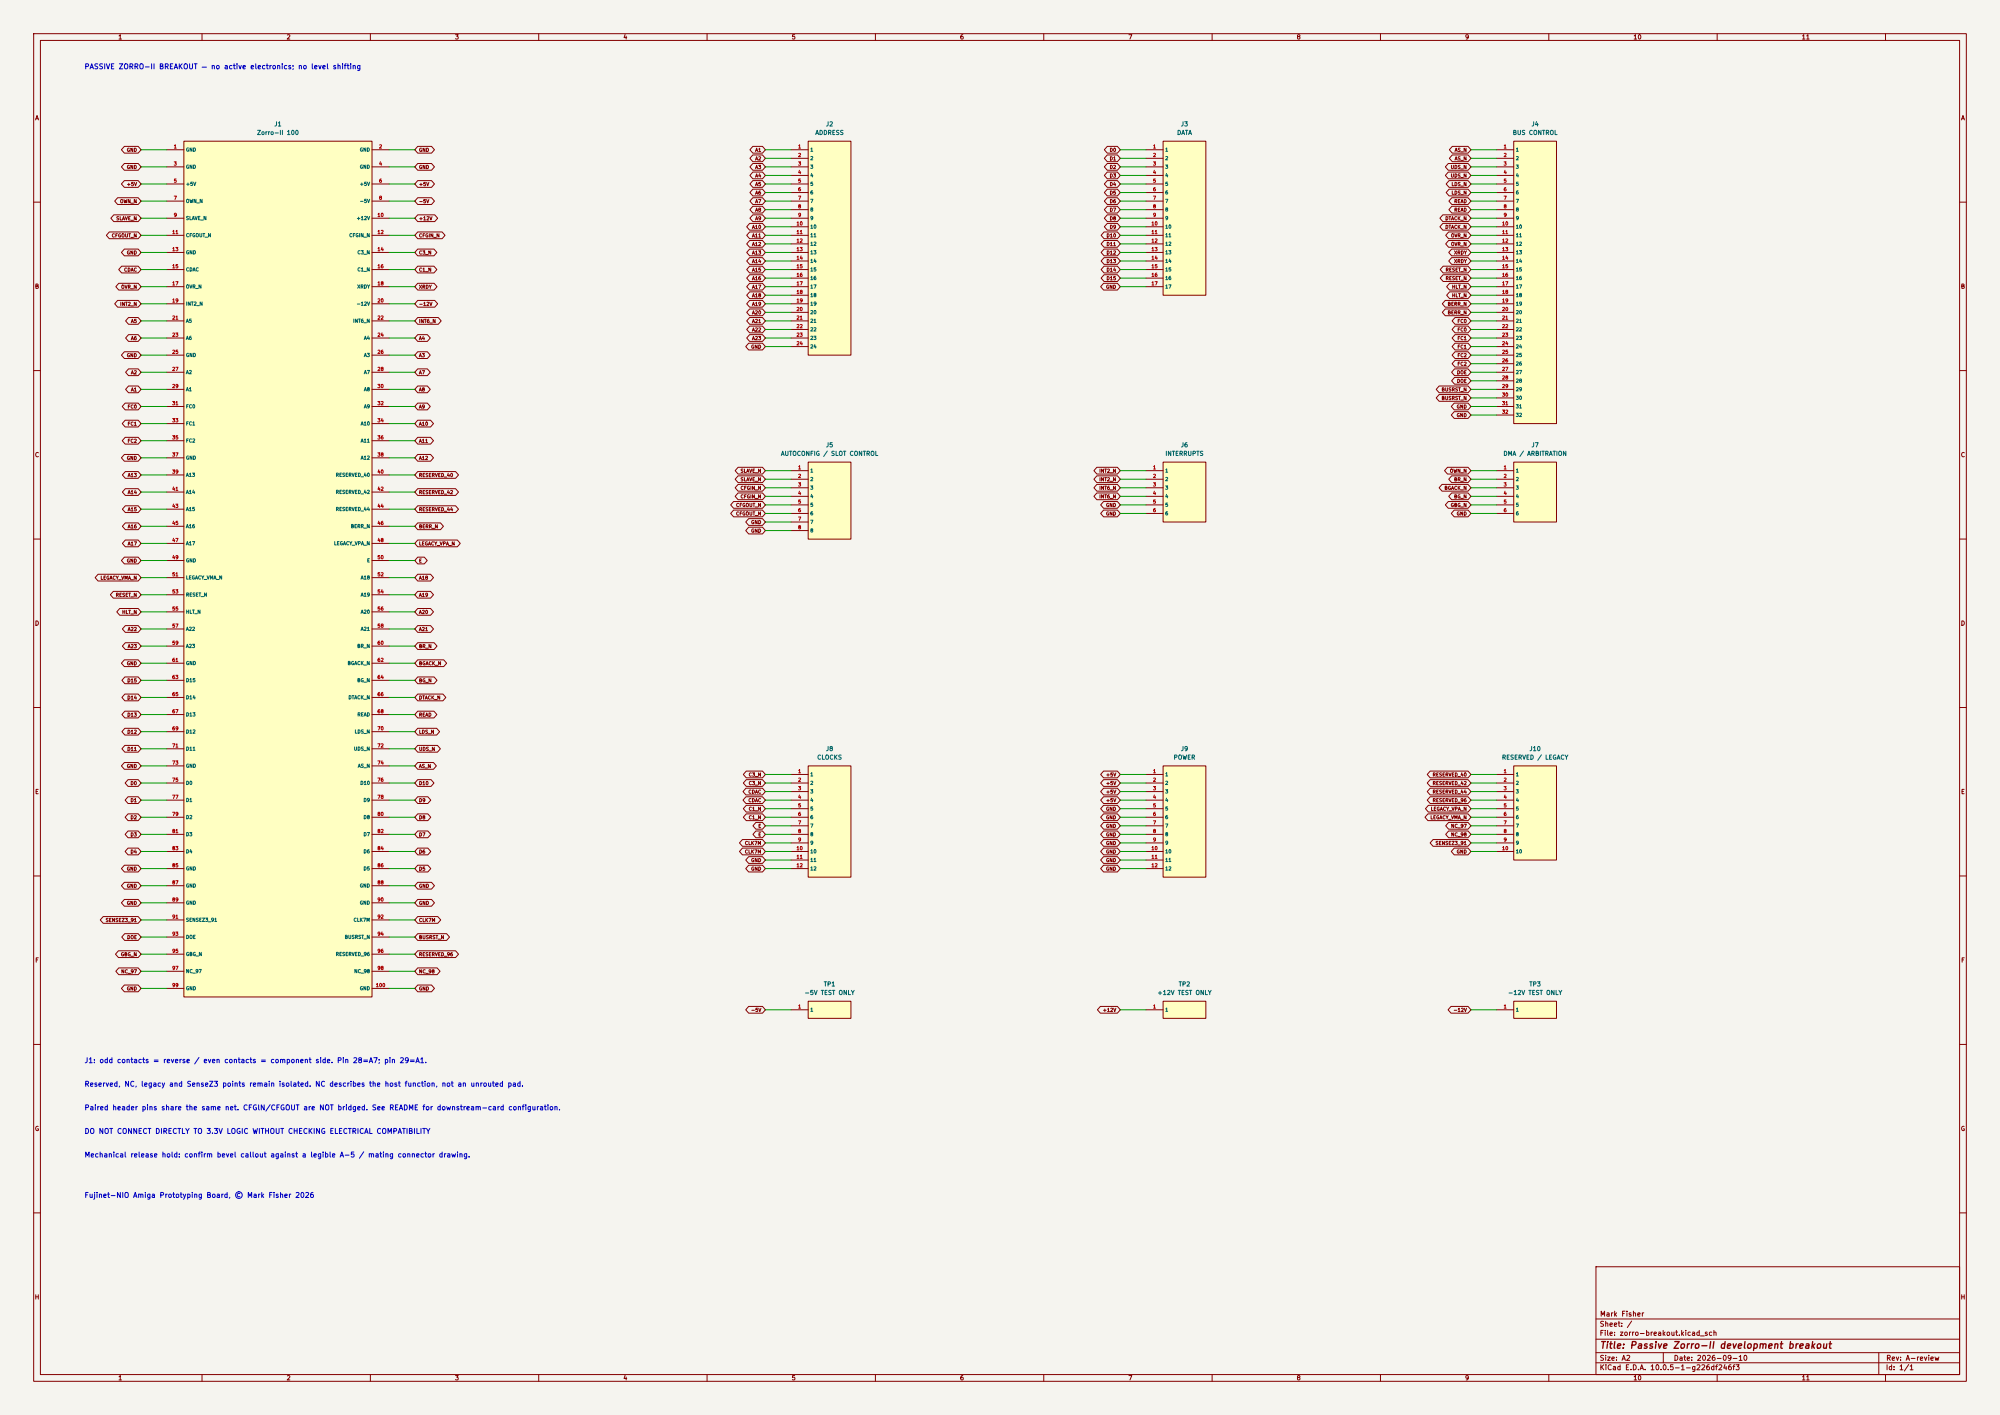
[picture p48: page 1]

PASSIVE ZORRO-II BREAKOUT — no active electronics; no level shifting

A19 Reserved, NC, legacy and SenseZ3 points remain isolated. NC describes the host function, not an unrouted pad.

J1: odd contacts = reverse / even contacts = component side. Pin 28=A7; pin 29=A1.

Paired header pins share the same net. CFGlN/CFGOUT are NOT bridged. See README for downstream-card configuration.

DO NOT CONNECT DIRECTLY TO 3.3V LOGIC WITHOUT CHECKING ELECTRICAL COMPATIBILITY

Mechanical release hold: confirm bevel callout against a legible A-5 / mating connector drawing.

Fujinet-NIO Amiga Prototyping Board, © Mark Fisher 2026

Mark Fisher
Sheet: /
File: zorro-breakout.kicad_sch
Title: Passive Zorro-II development breakout

Size: A2 | Rev: A-review
KiCad E.D.A. 10.0.5-1-g226df246f3 | Id: 1/1
