markjfisher/fujinet-nio-hardware/amiga/integrated-a500-r3/review/schematic.pdf

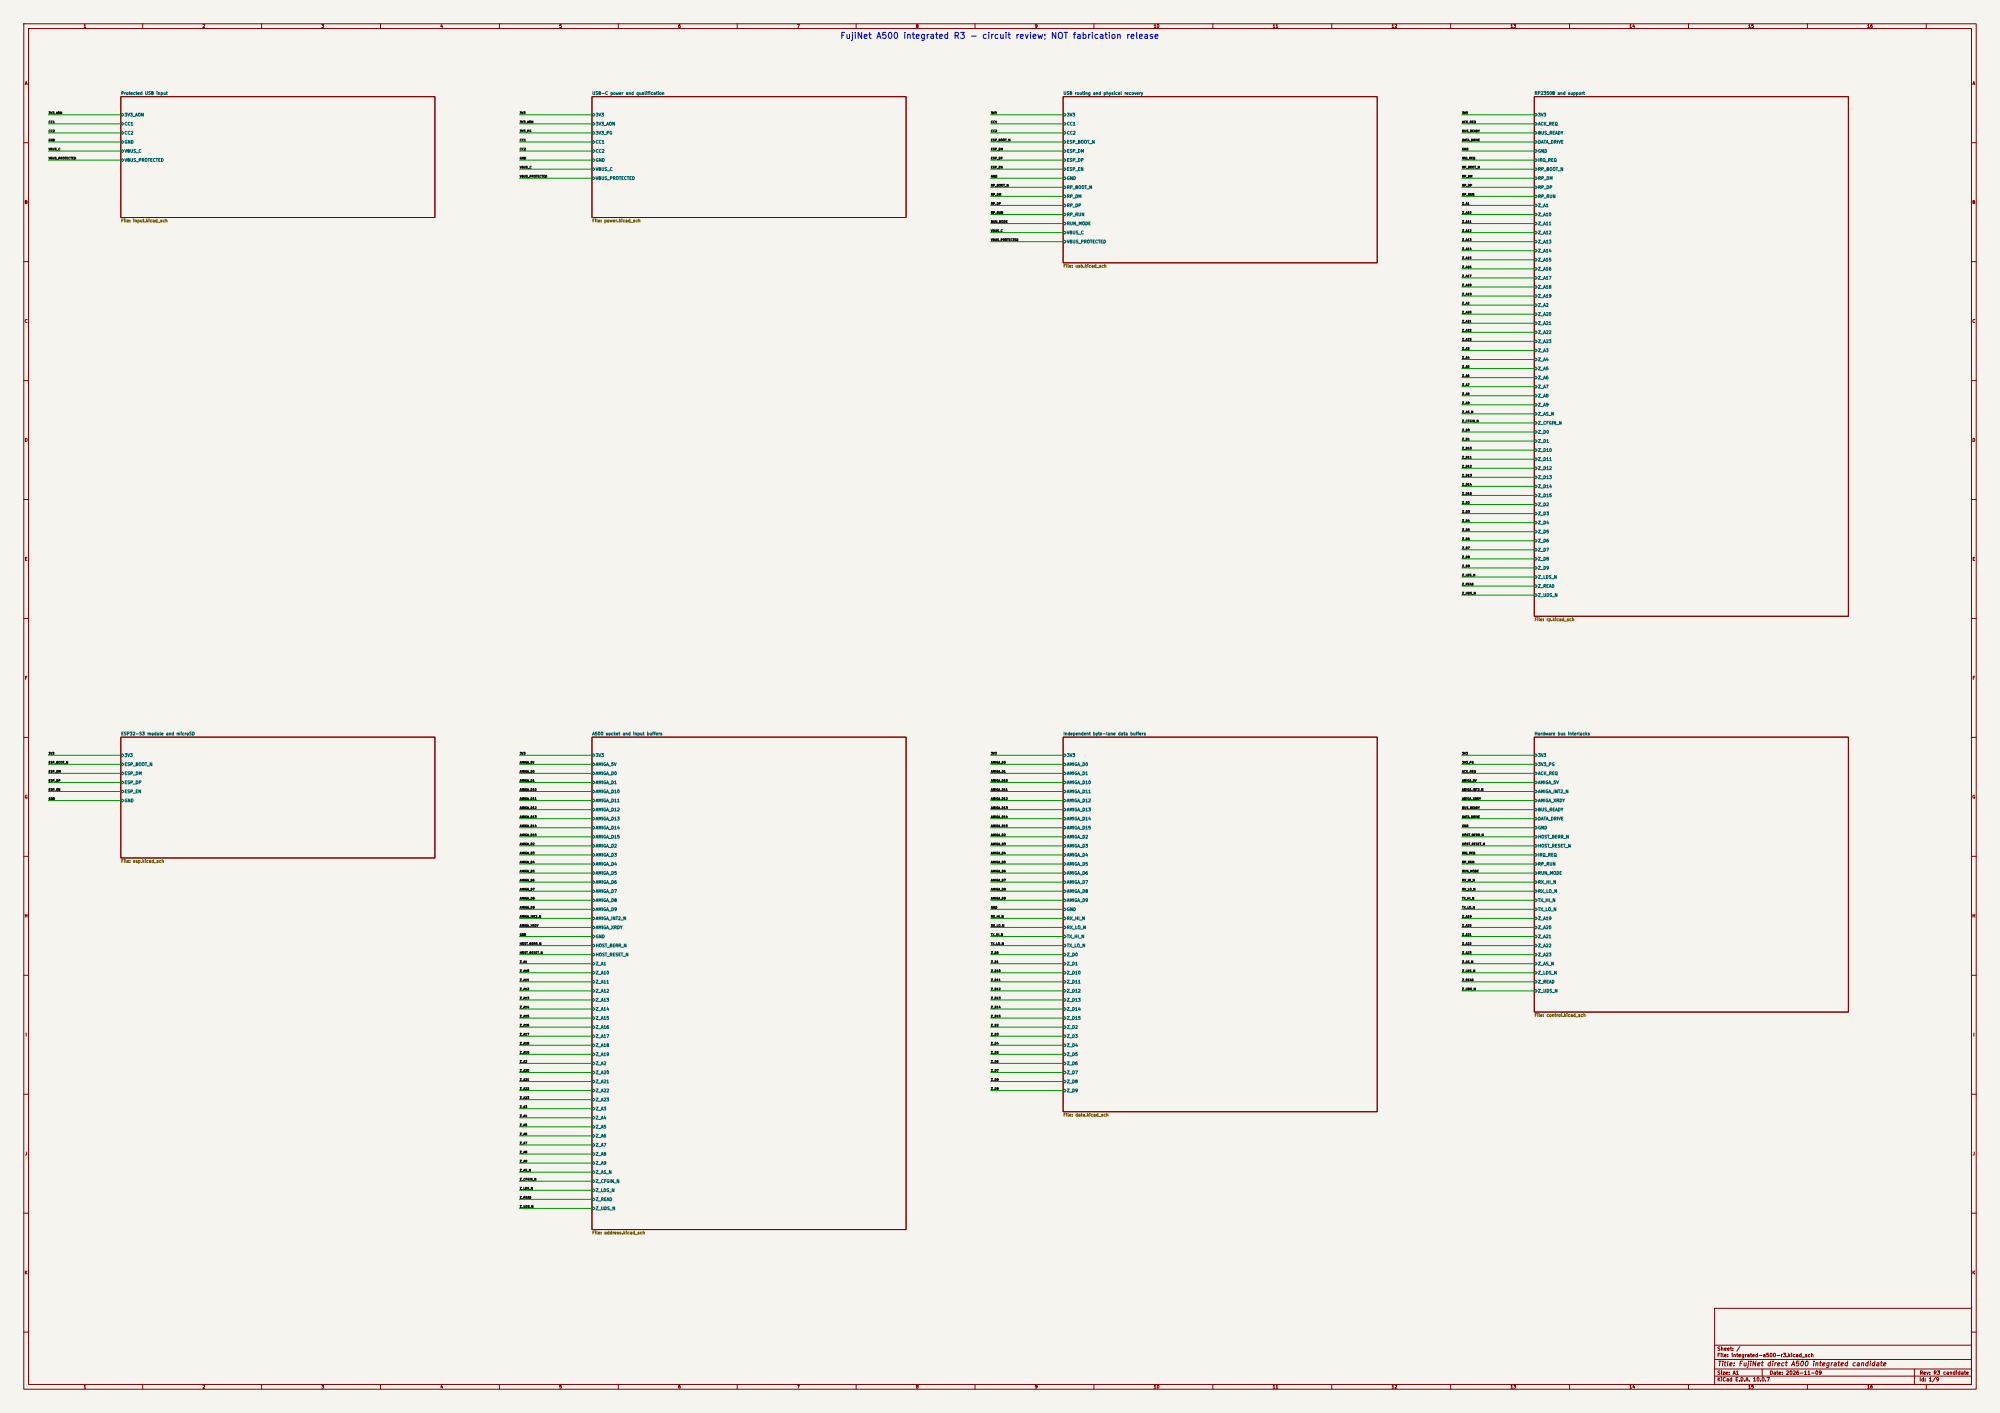
[picture p49: page 1]

Protected USB input File: input.kicad_sch

GND FujiNet A500 integrated R3 - circuit review; NOT fabrication release
VBUS_PROTECTED USB routing and physical recovery File: usb.kicad_sch

VBUS_PROTECTED USB-C power and qualification

A500 socket and input buffers

Independent byte-lane data buffers

Sheet: /
File: integrated-a500-r3.kicad_sch
Title: FujiNet direct A500 integrated candidate

Size: A1 | Rev: R3 candidate
KiCad E.D.A. 10.0.7 | Id: 1/9

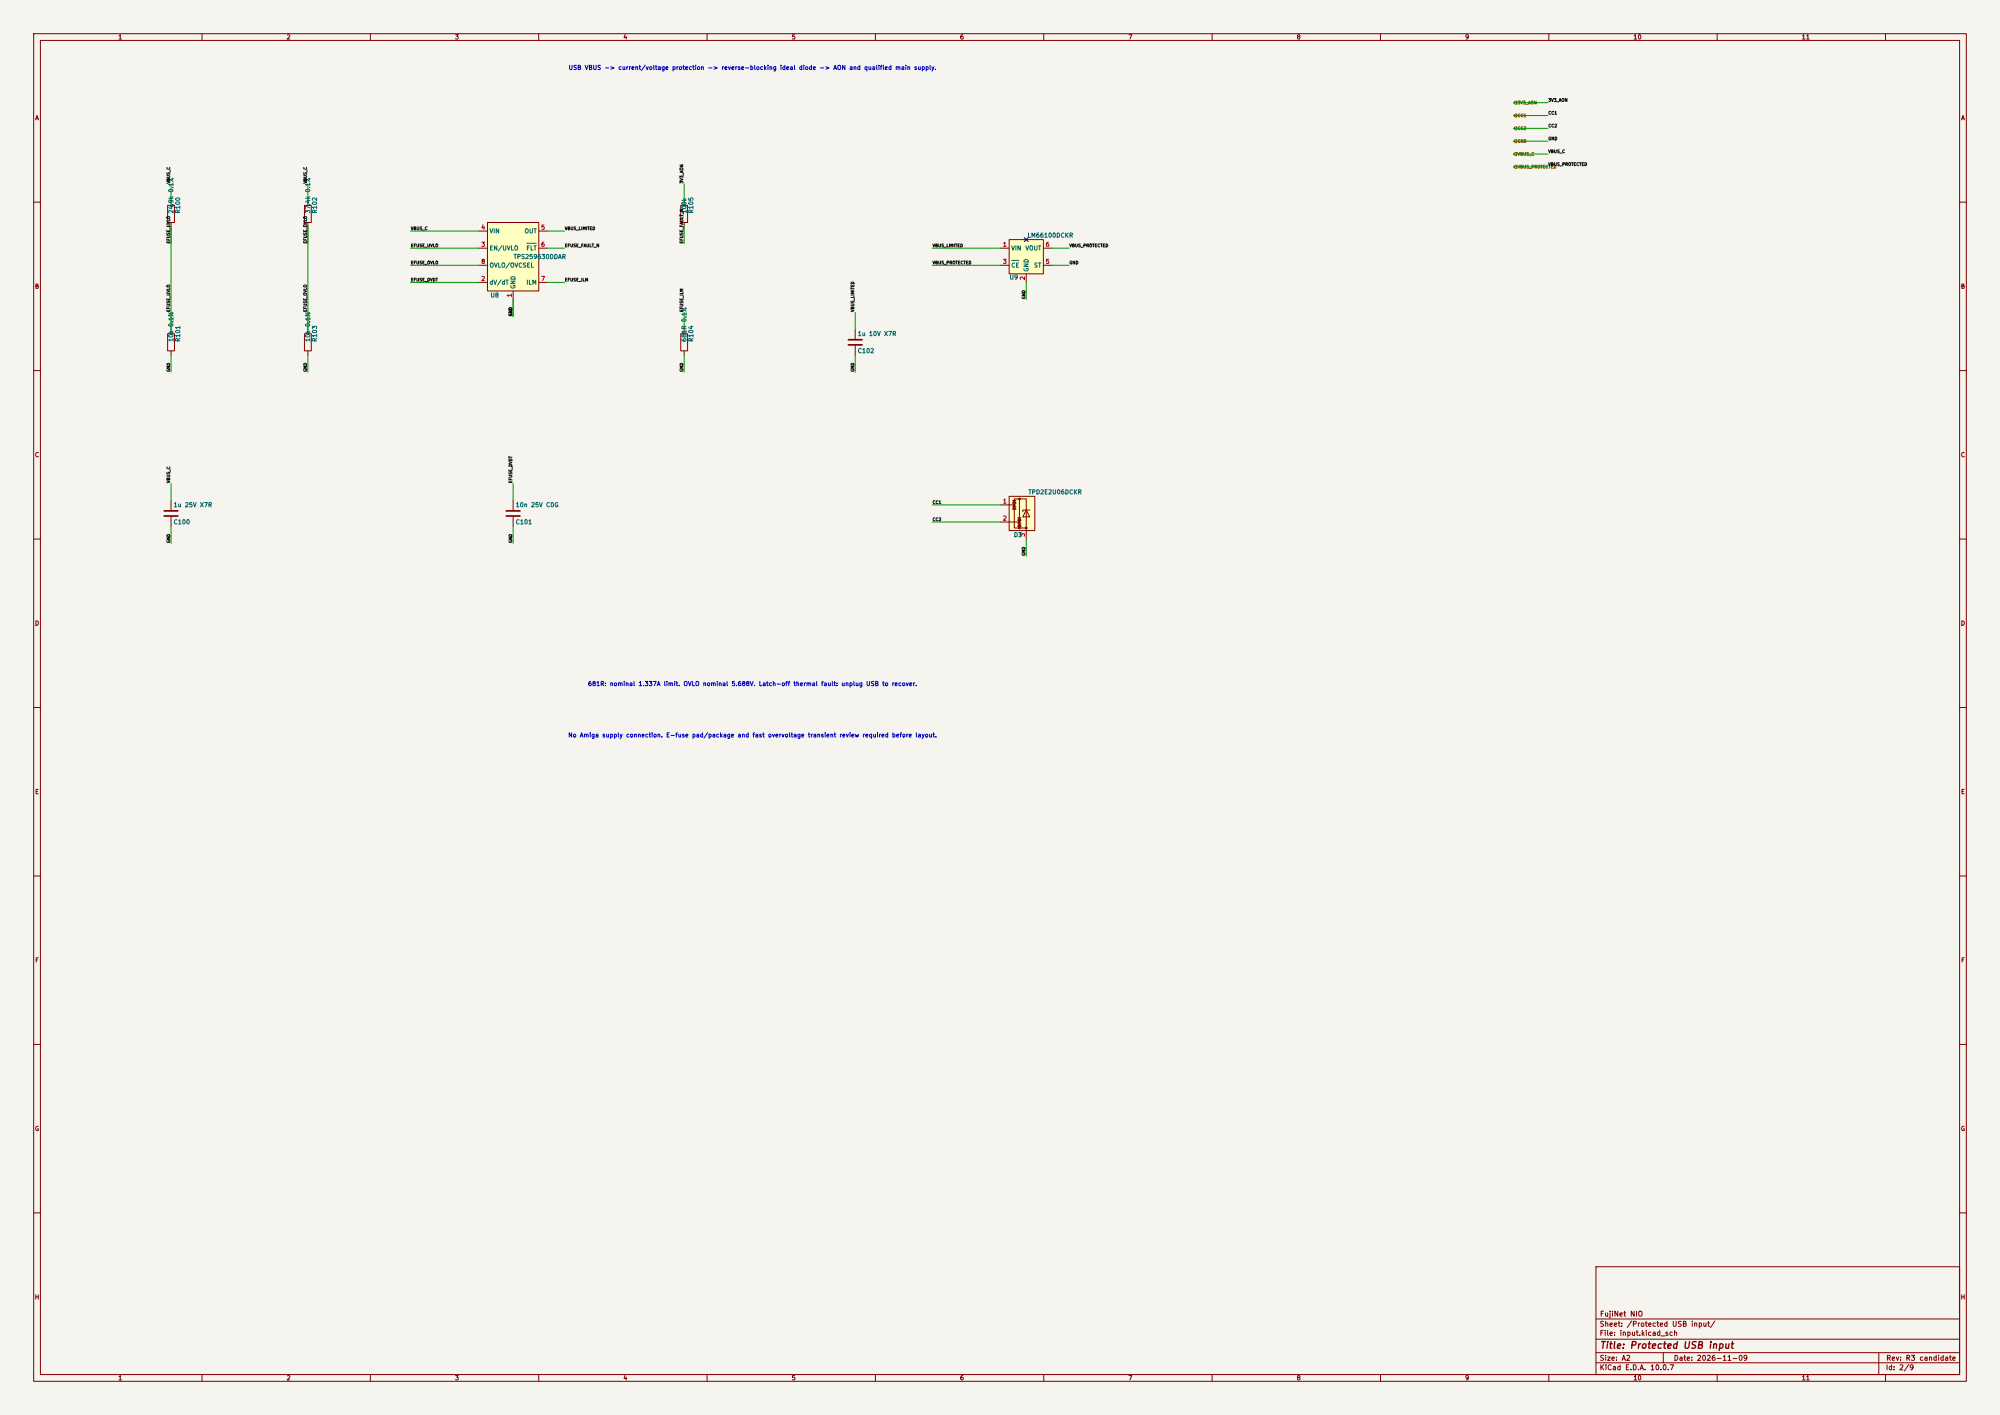
[picture p50: page 2]

USB VBUS -> current/voltage protection -> reverse-blocking ideal diode -> AON and qualified main supply.

CC1 VBUS_LIMITED No Amiga supply connection. E-fuse pad/package and fast overvoltage transient review required before layout. 681R: nominal 1.337A limit. OVLO nominal 5.688V. Latch-off thermal fault: unplug USB to recover.

FujiNet NIO
Sheet: /Protected USB input/
File: input.kicad_sch
Title: Protected USB input

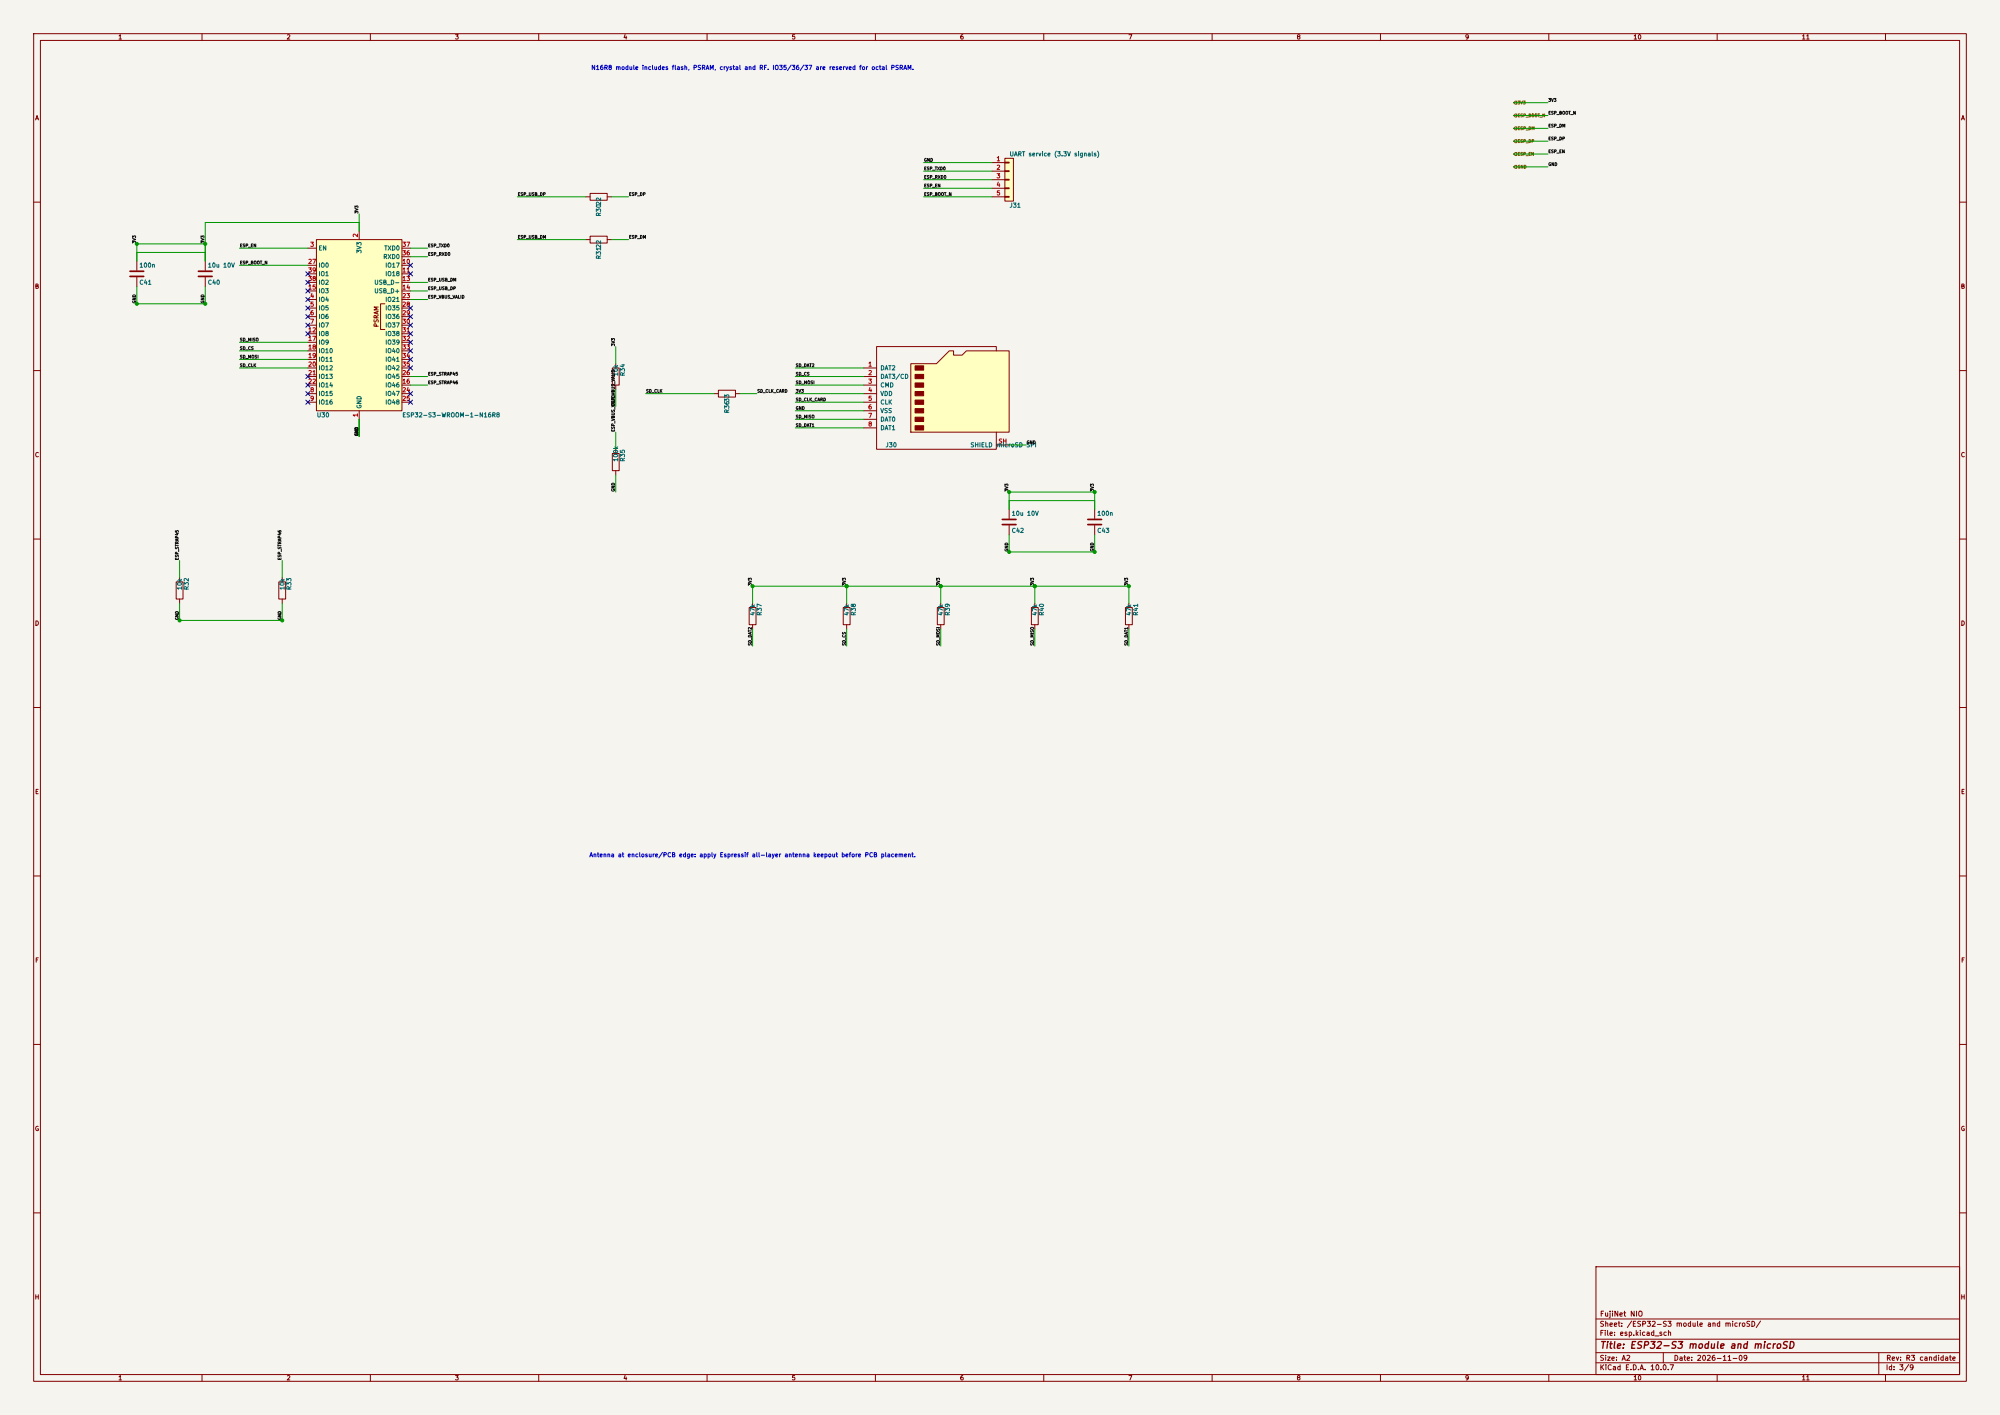
[picture p51: page 3]

N16R8 module includes flash, PSRAM, crystal and RF. IO35/36/37 are reserved for octal PSRAM.
ESP_BOOT_N SD_DAT2 3V3

Antenna at enclosure/PCB edge: apply Espressif all-layer antenna keepout before PCB placement.

Sheet: /ESP32-S3 module and microSD/
File: esp.kicad_sch
Title: ESP32-S3 module and microSD

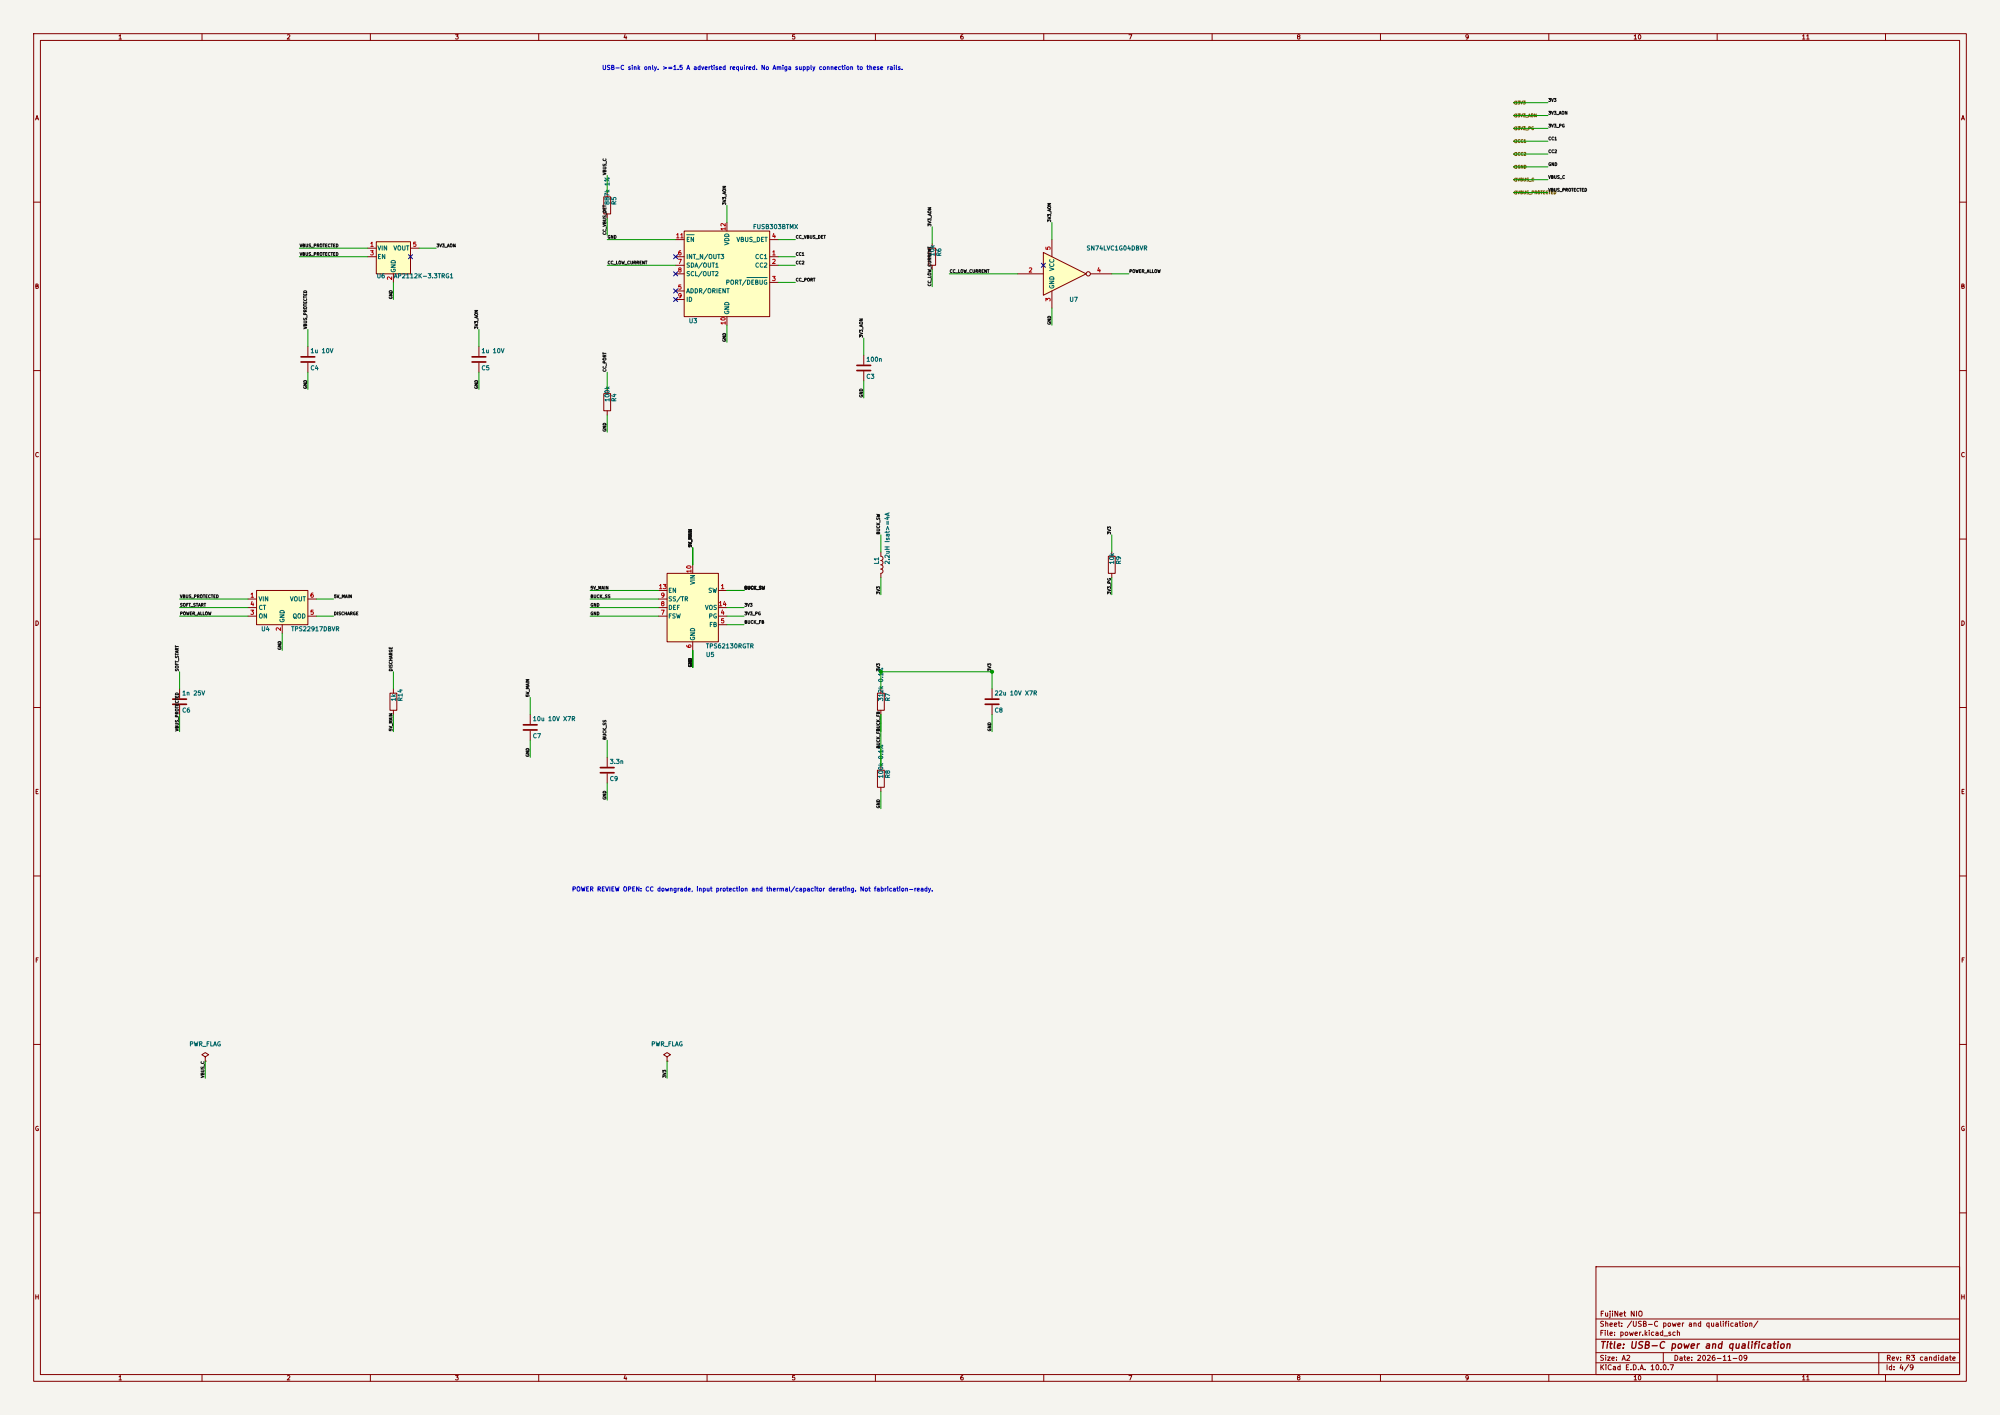
[picture p52: page 4]

USB-C sink only. >=1.5 A advertised required. No Amiga supply connection to these rails.
TPS62130RGTR 887k R5 1% C9

POWER REVIEW OPEN: CC downgrade, input protection and thermal/capacitor derating. Not fabrication-ready.

Sheet: /USB-C power and qualification/
File: power.kicad_sch
Title: USB-C power and qualification

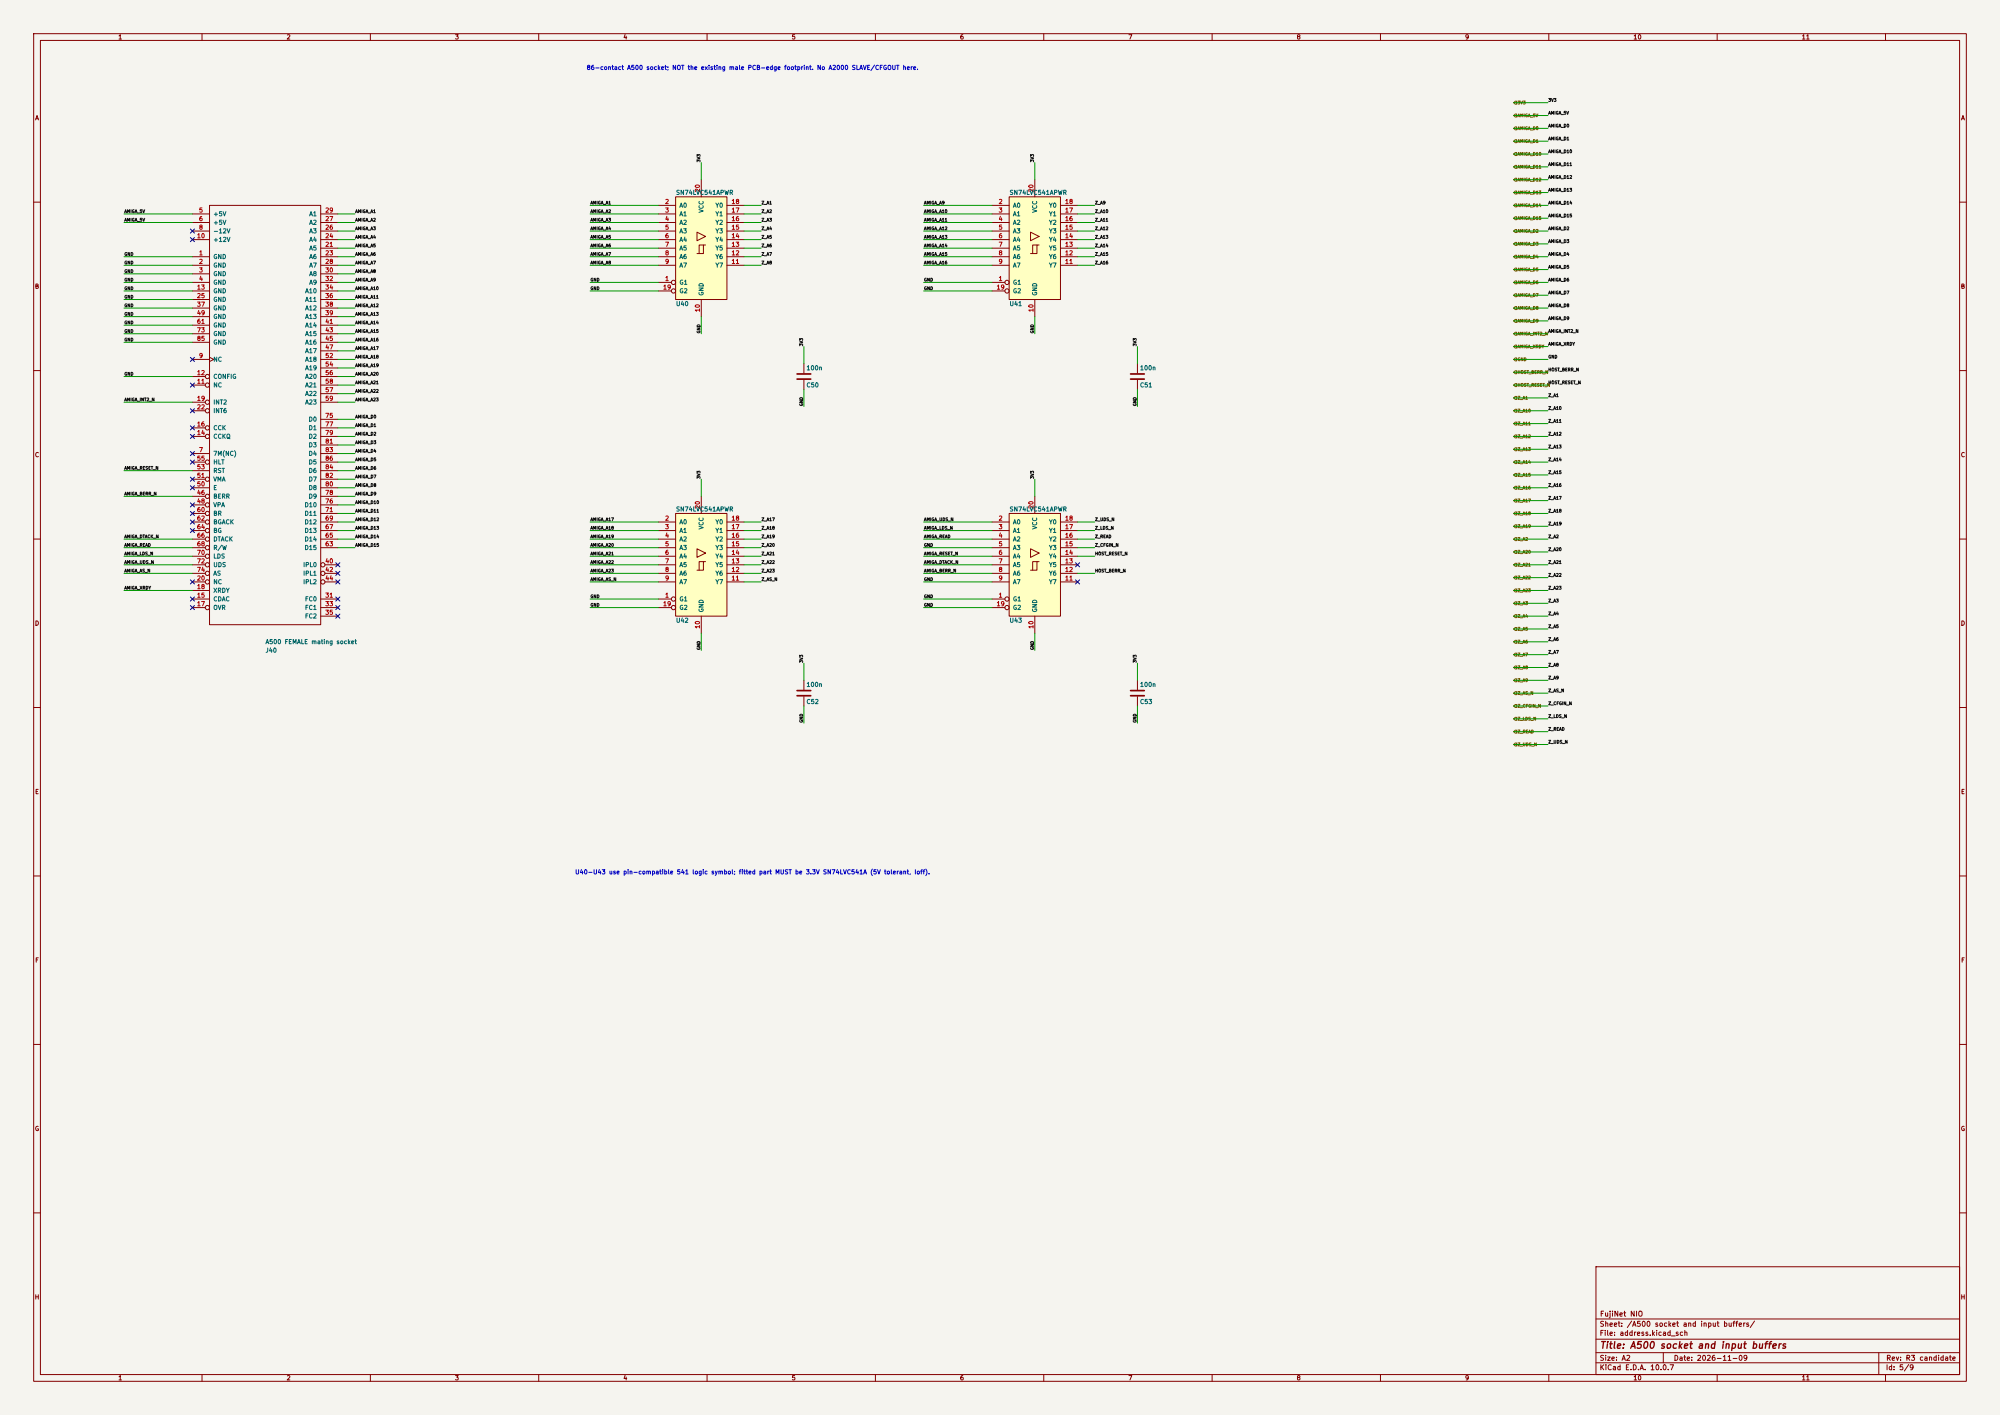
[picture p53: page 5]

86-contact A500 socket; NOT the existing male PCB-edge footprint. No A2000 SLAVE/CFGOUT here.

U40-U43 use pin-compatible 541 logic symbol; fitted part MUST be 3.3V SN74LVC541A (5V tolerant, Ioff).

Sheet: /A500 socket and input buffers/
File: address.kicad_sch
Title: A500 socket and input buffers

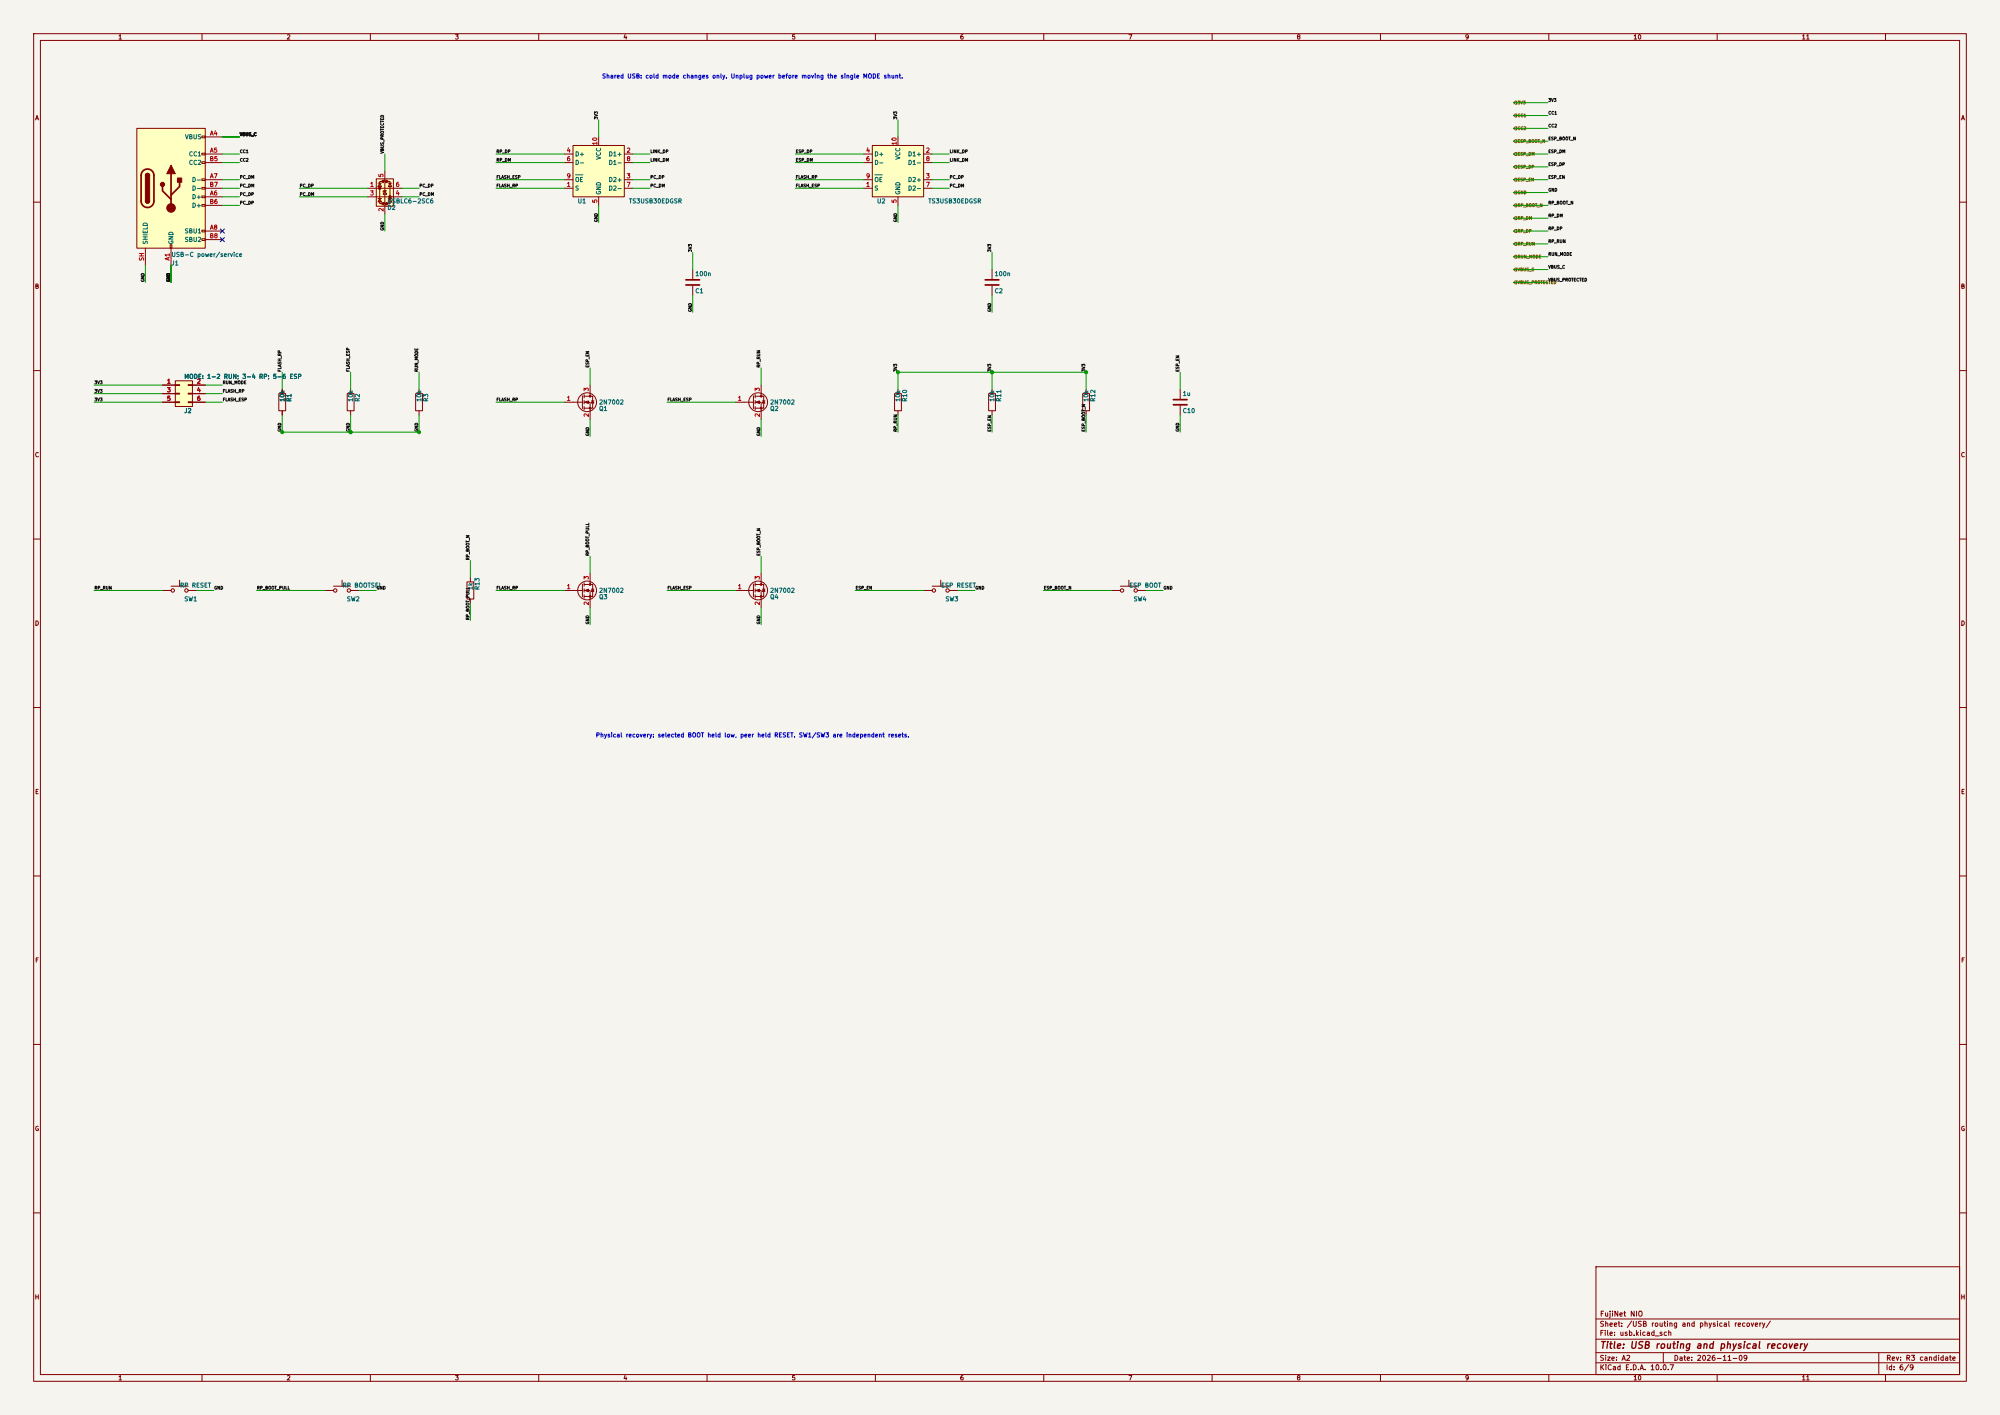
[picture p54: page 6]

Shared USB: cold mode changes only. Unplug power before moving the single MODE shunt. 10k R1

Physical recovery: selected BOOT held low, peer held RESET. SW1/SW3 are independent resets.

Sheet: /USB routing and physical recovery/
File: usb.kicad_sch
Title: USB routing and physical recovery

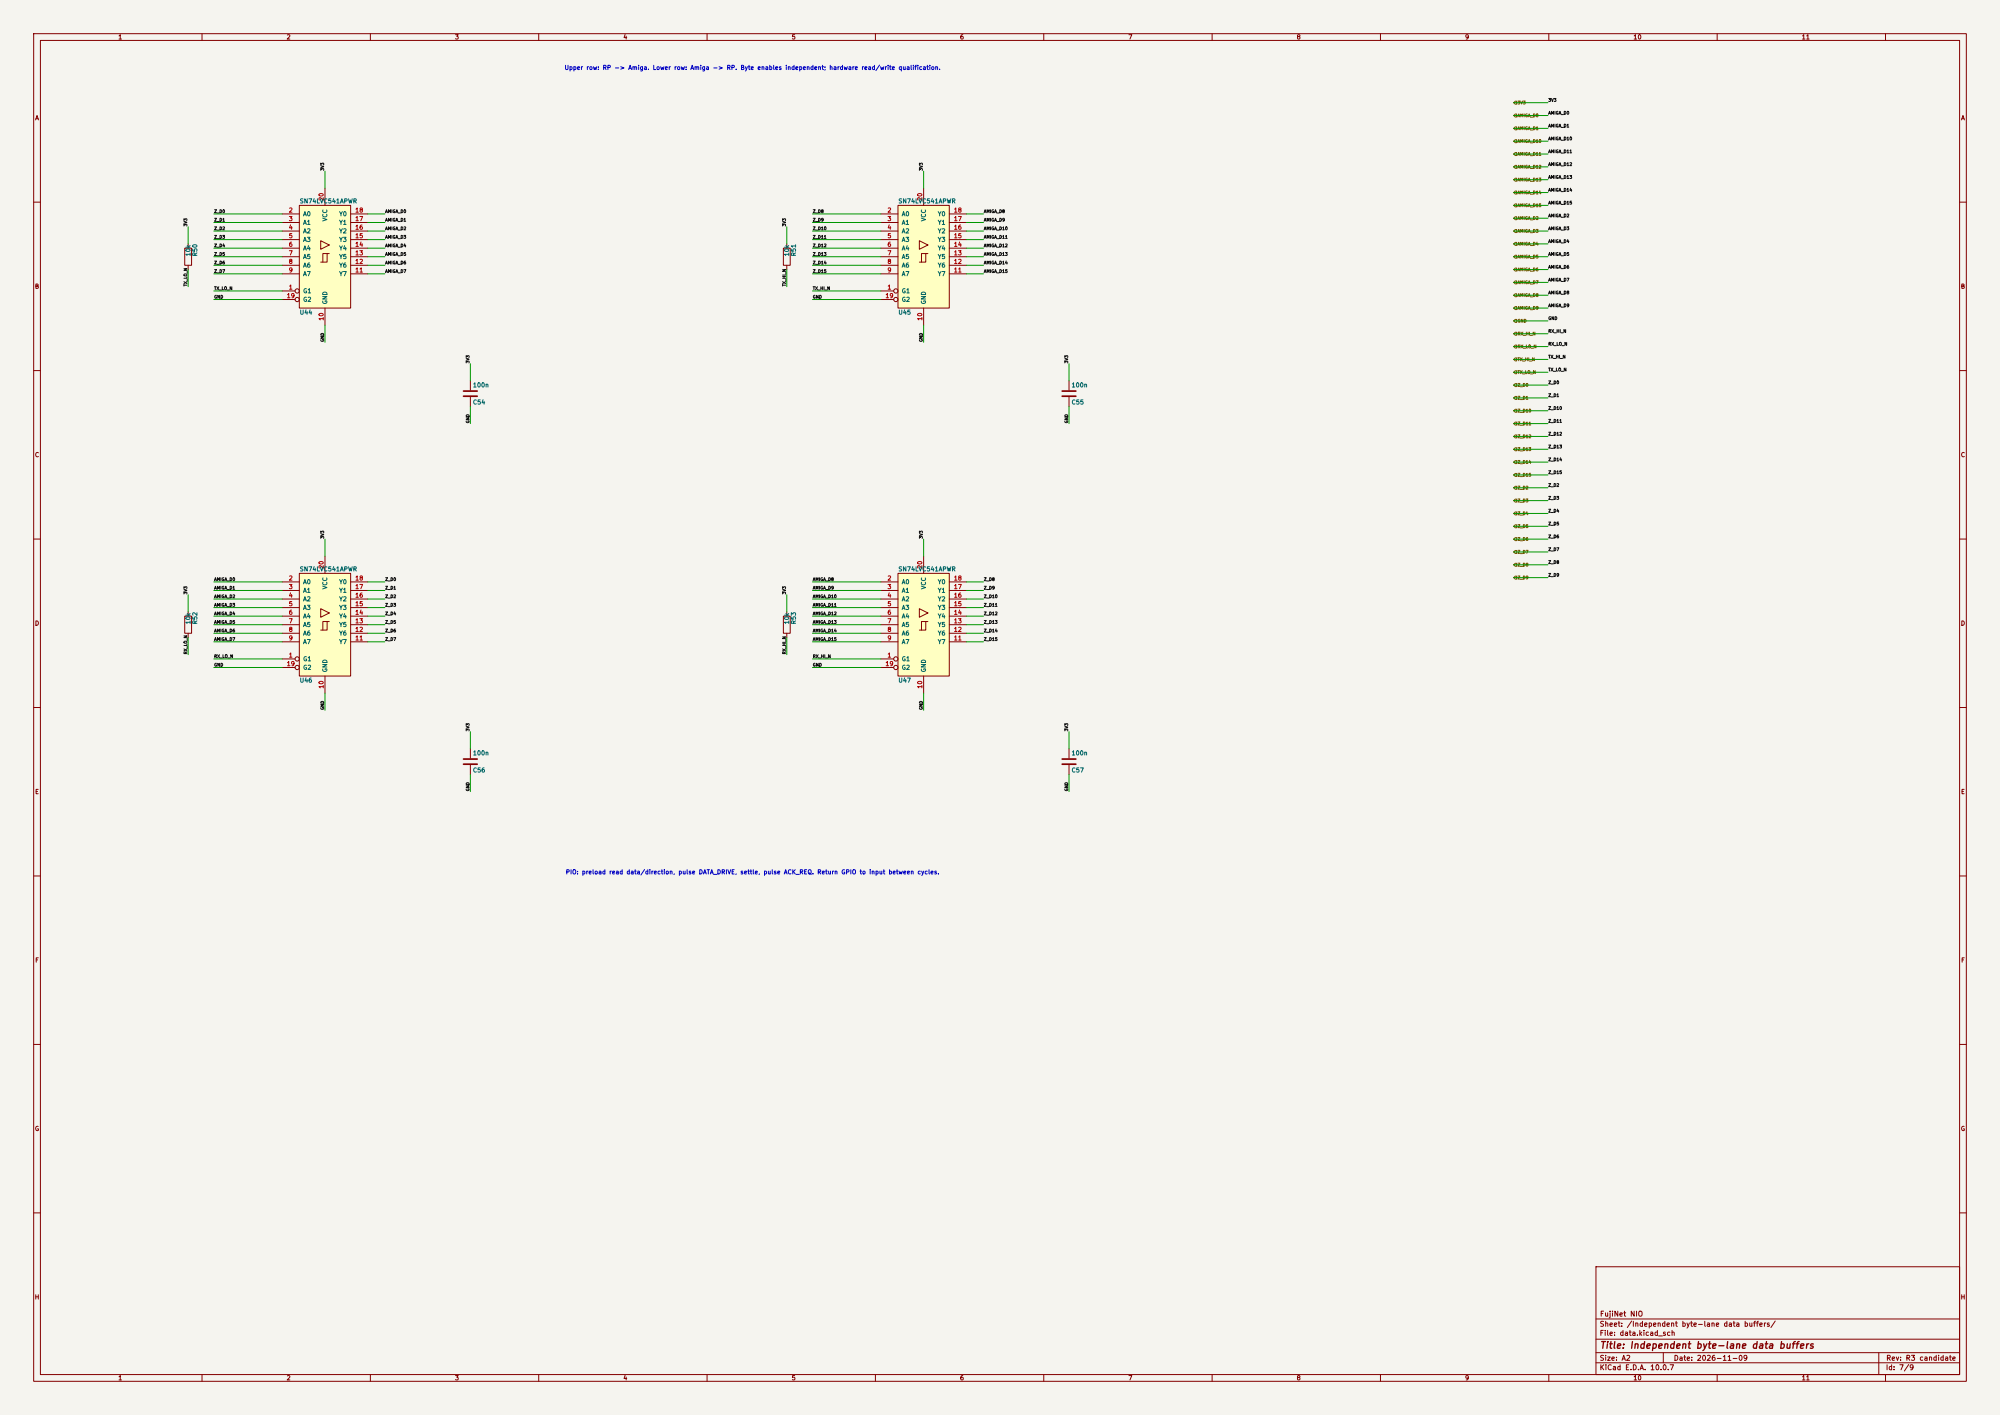
[picture p55: page 7]

Upper row: RP -> Amiga. Lower row: Amiga -> RP. Byte enables independent; hardware read/write qualification.

PIO: preload read data/direction, pulse DATA_DRIVE, settle, pulse ACK_REQ. Return GPIO to input between cycles.

Sheet: /Independent byte-lane data buffers/
File: data.kicad_sch
Title: Independent byte-lane data buffers

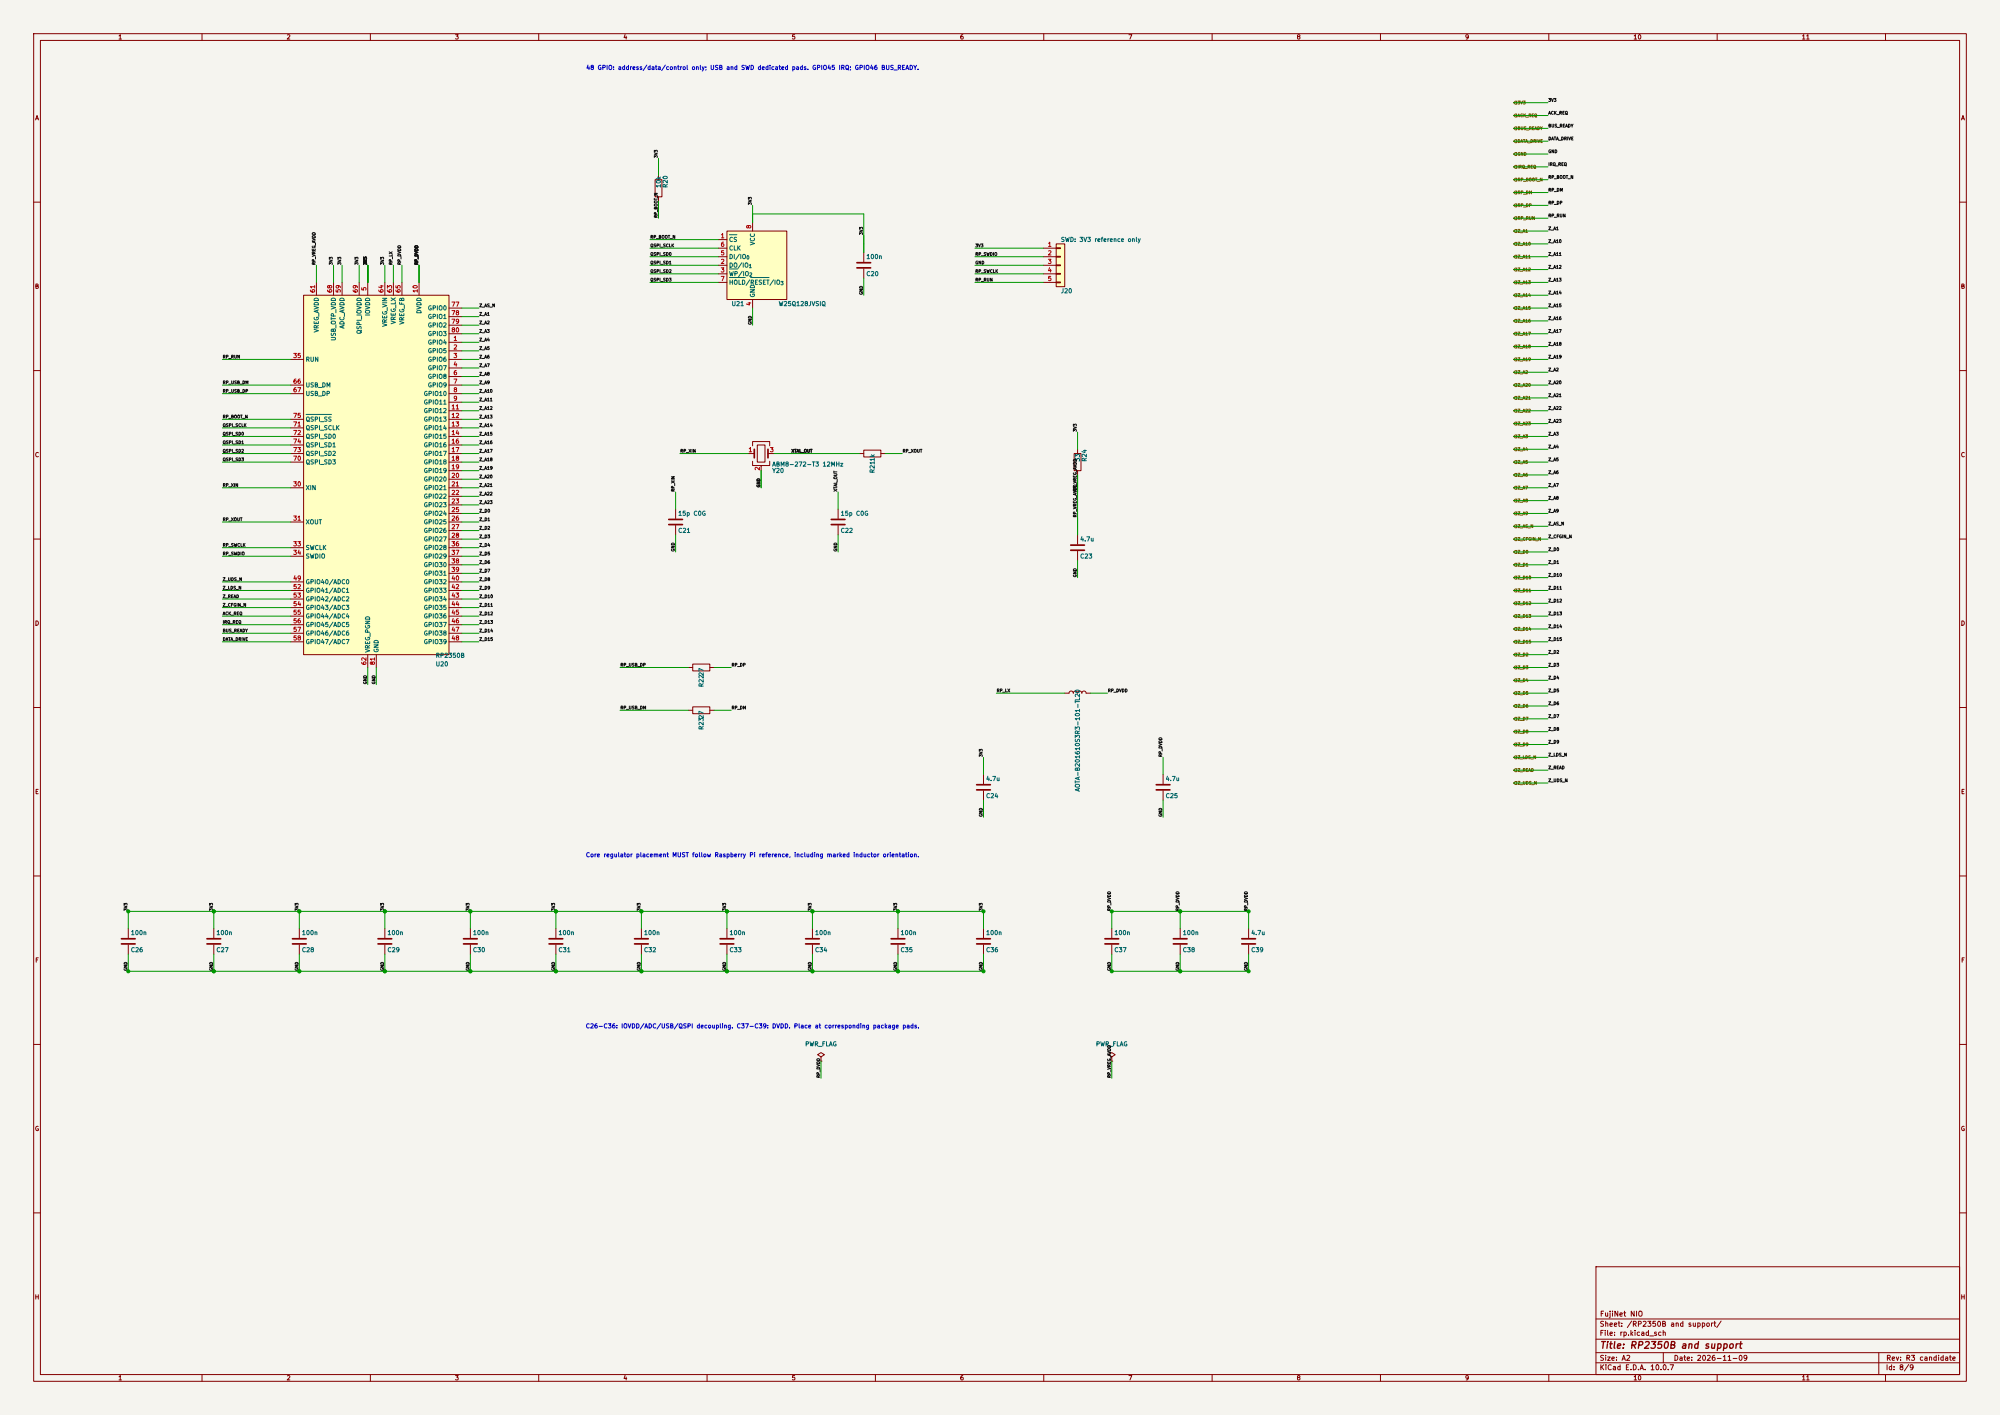
[picture p56: page 8]

48 GPIO: address/data/control only; USB and SWD dedicated pads. GPIO45 IRQ; GPIO46 BUS_READY.
SWD: 3V3 reference only L20 AOTA-B201610S3R3-101-T C36

C26-C36: IOVDD/ADC/USB/QSPI decoupling. C37-C39: DVDD. Place at corresponding package pads.

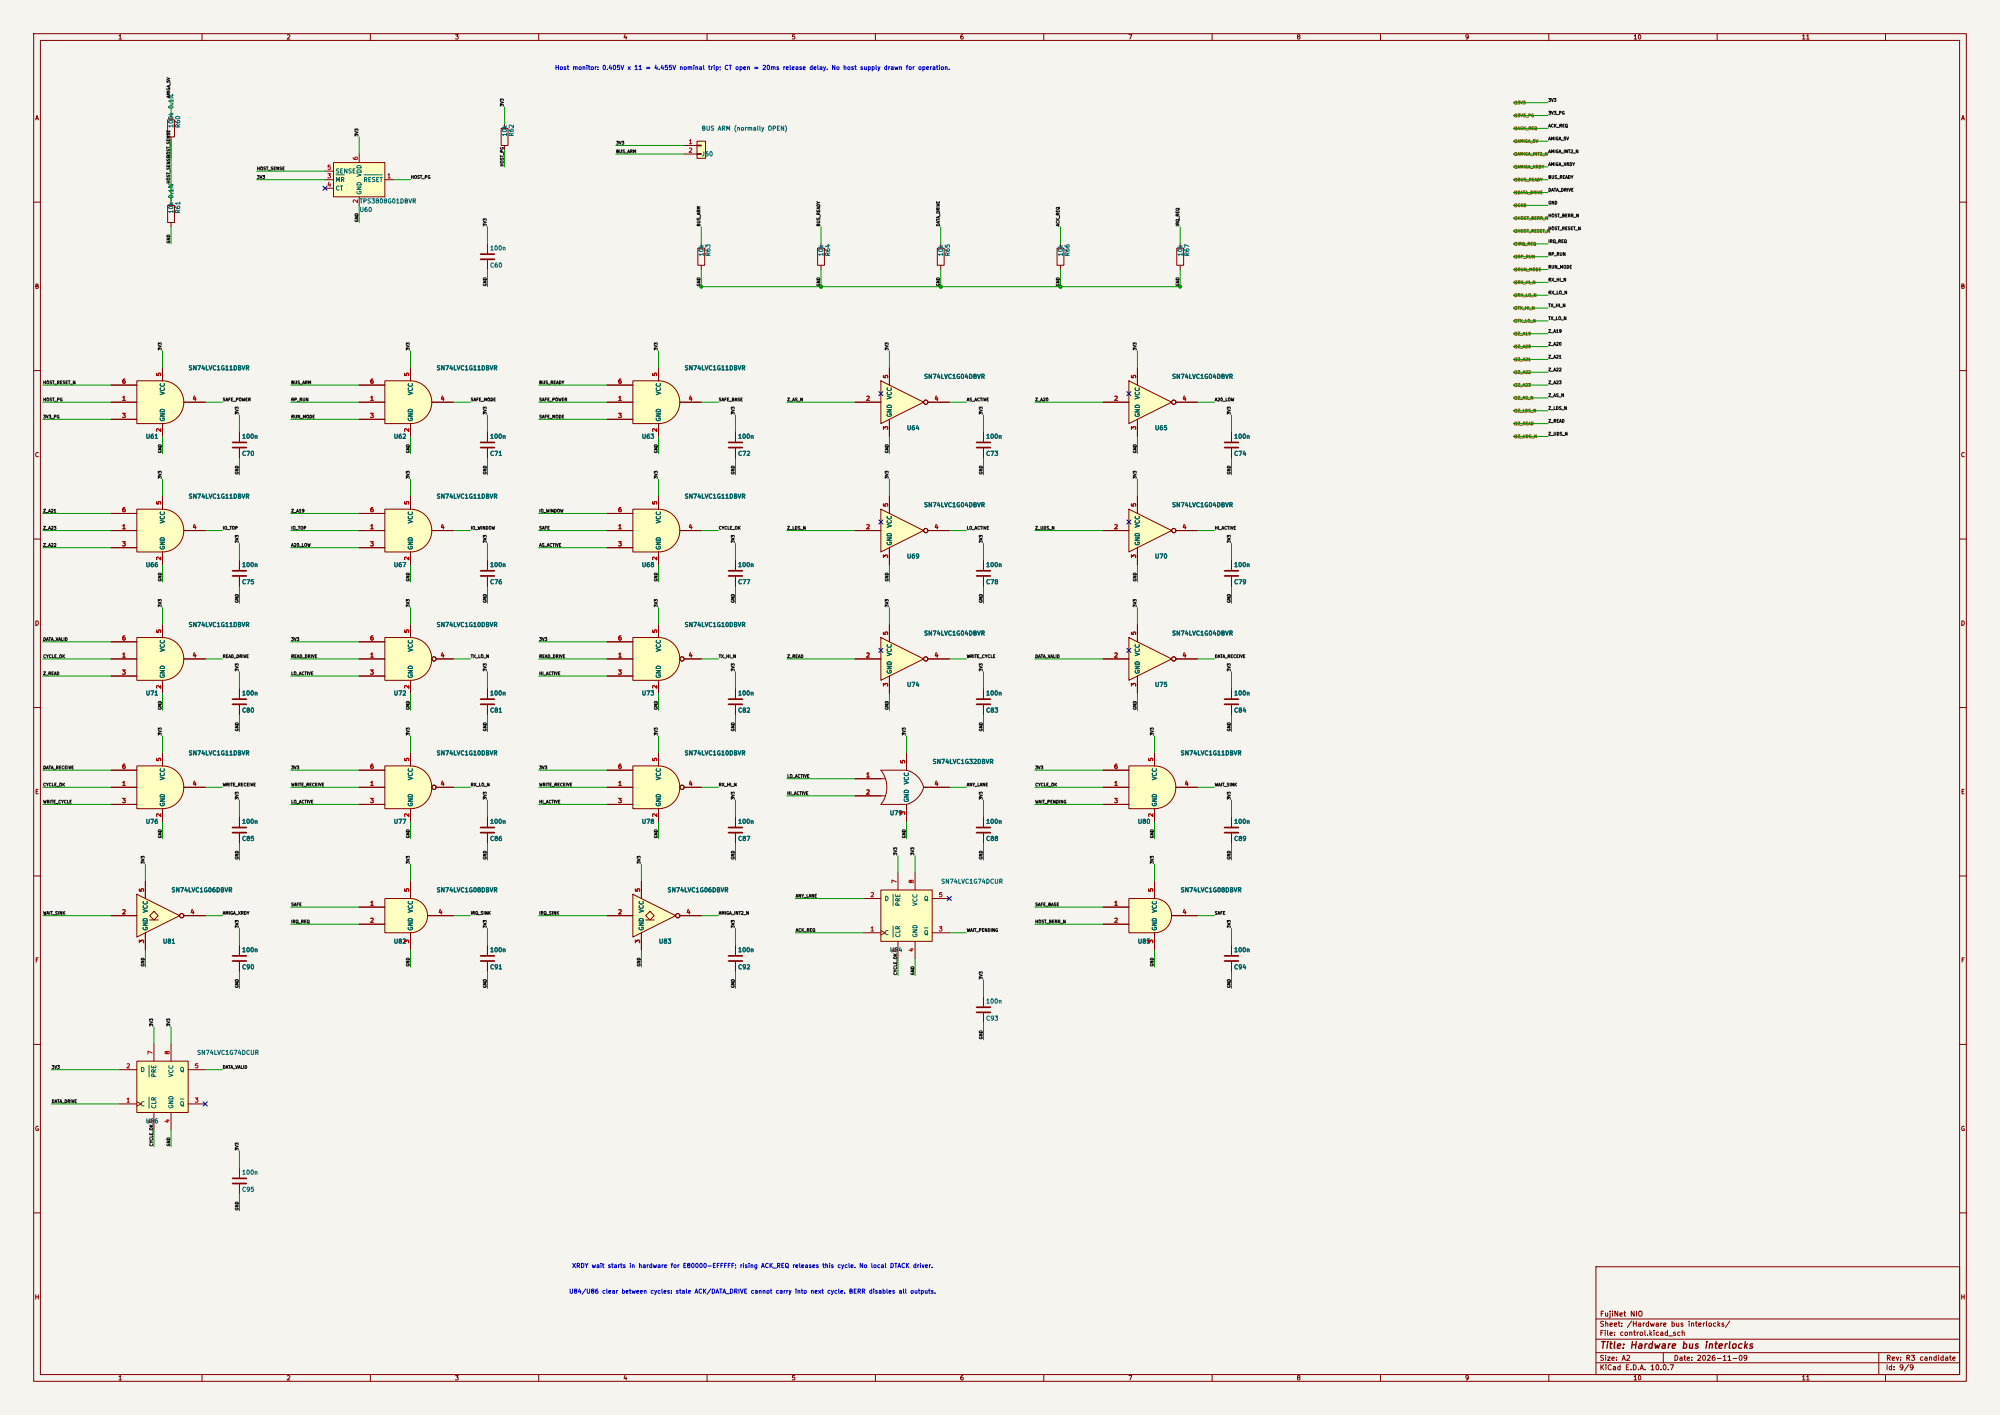
[picture p57: page 9]

Host monitor: 0.405V x 11 = 4.455V nominal trip; CT open = 20ms release delay. No host supply drawn for operation.

U84/U86 clear between cycles: stale ACK/DATA_DRIVE cannot carry into next cycle. BERR disables all outputs. XRDY wait starts in hardware for E80000-EFFFFF; rising ACK_REQ releases this cycle. No local DTACK driver.

Sheet: /Hardware bus interlocks/
File: control.kicad_sch
Title: Hardware bus interlocks
