markjfisher/fujinet-nio-hardware/amiga/integrated-a500-r1/review/schematic.pdf

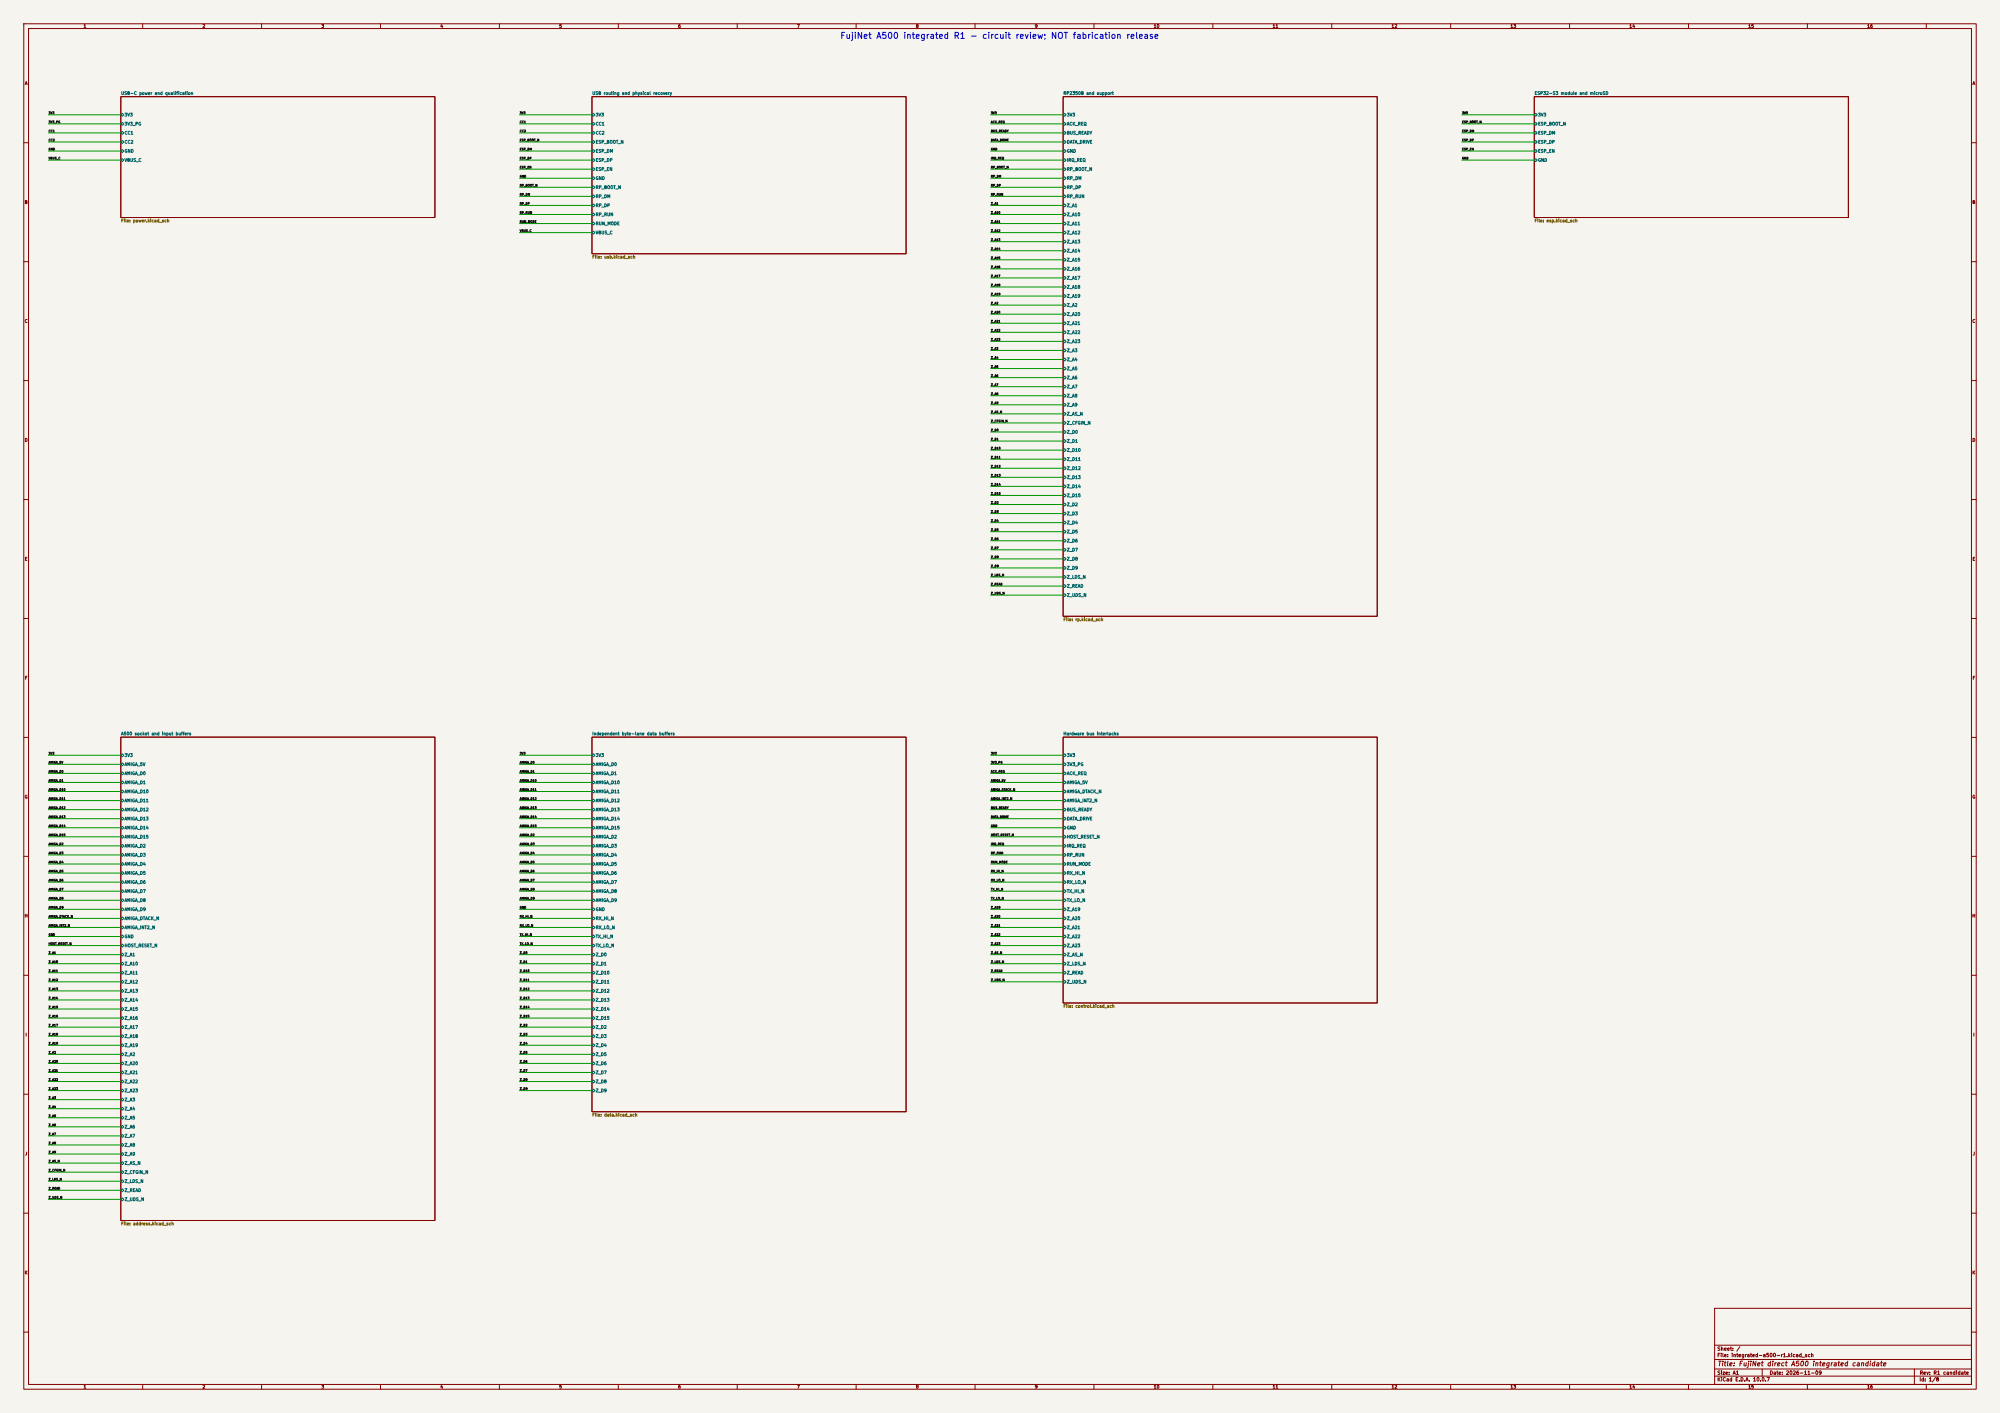
[picture p66: page 1]

FujiNet A500 integrated R1 - circuit review; NOT fabrication release

VBUS_C USB-C power and qualification

VBUS_C USB routing and physical recovery File: usb.kicad_sch

A500 socket and input buffers

Independent byte-lane data buffers

Sheet: /
File: integrated-a500-r1.kicad_sch
Title: FujiNet direct A500 integrated candidate

Size: A1 | Rev: R1 candidate
KiCad E.D.A. 10.0.7 | Id: 1/8

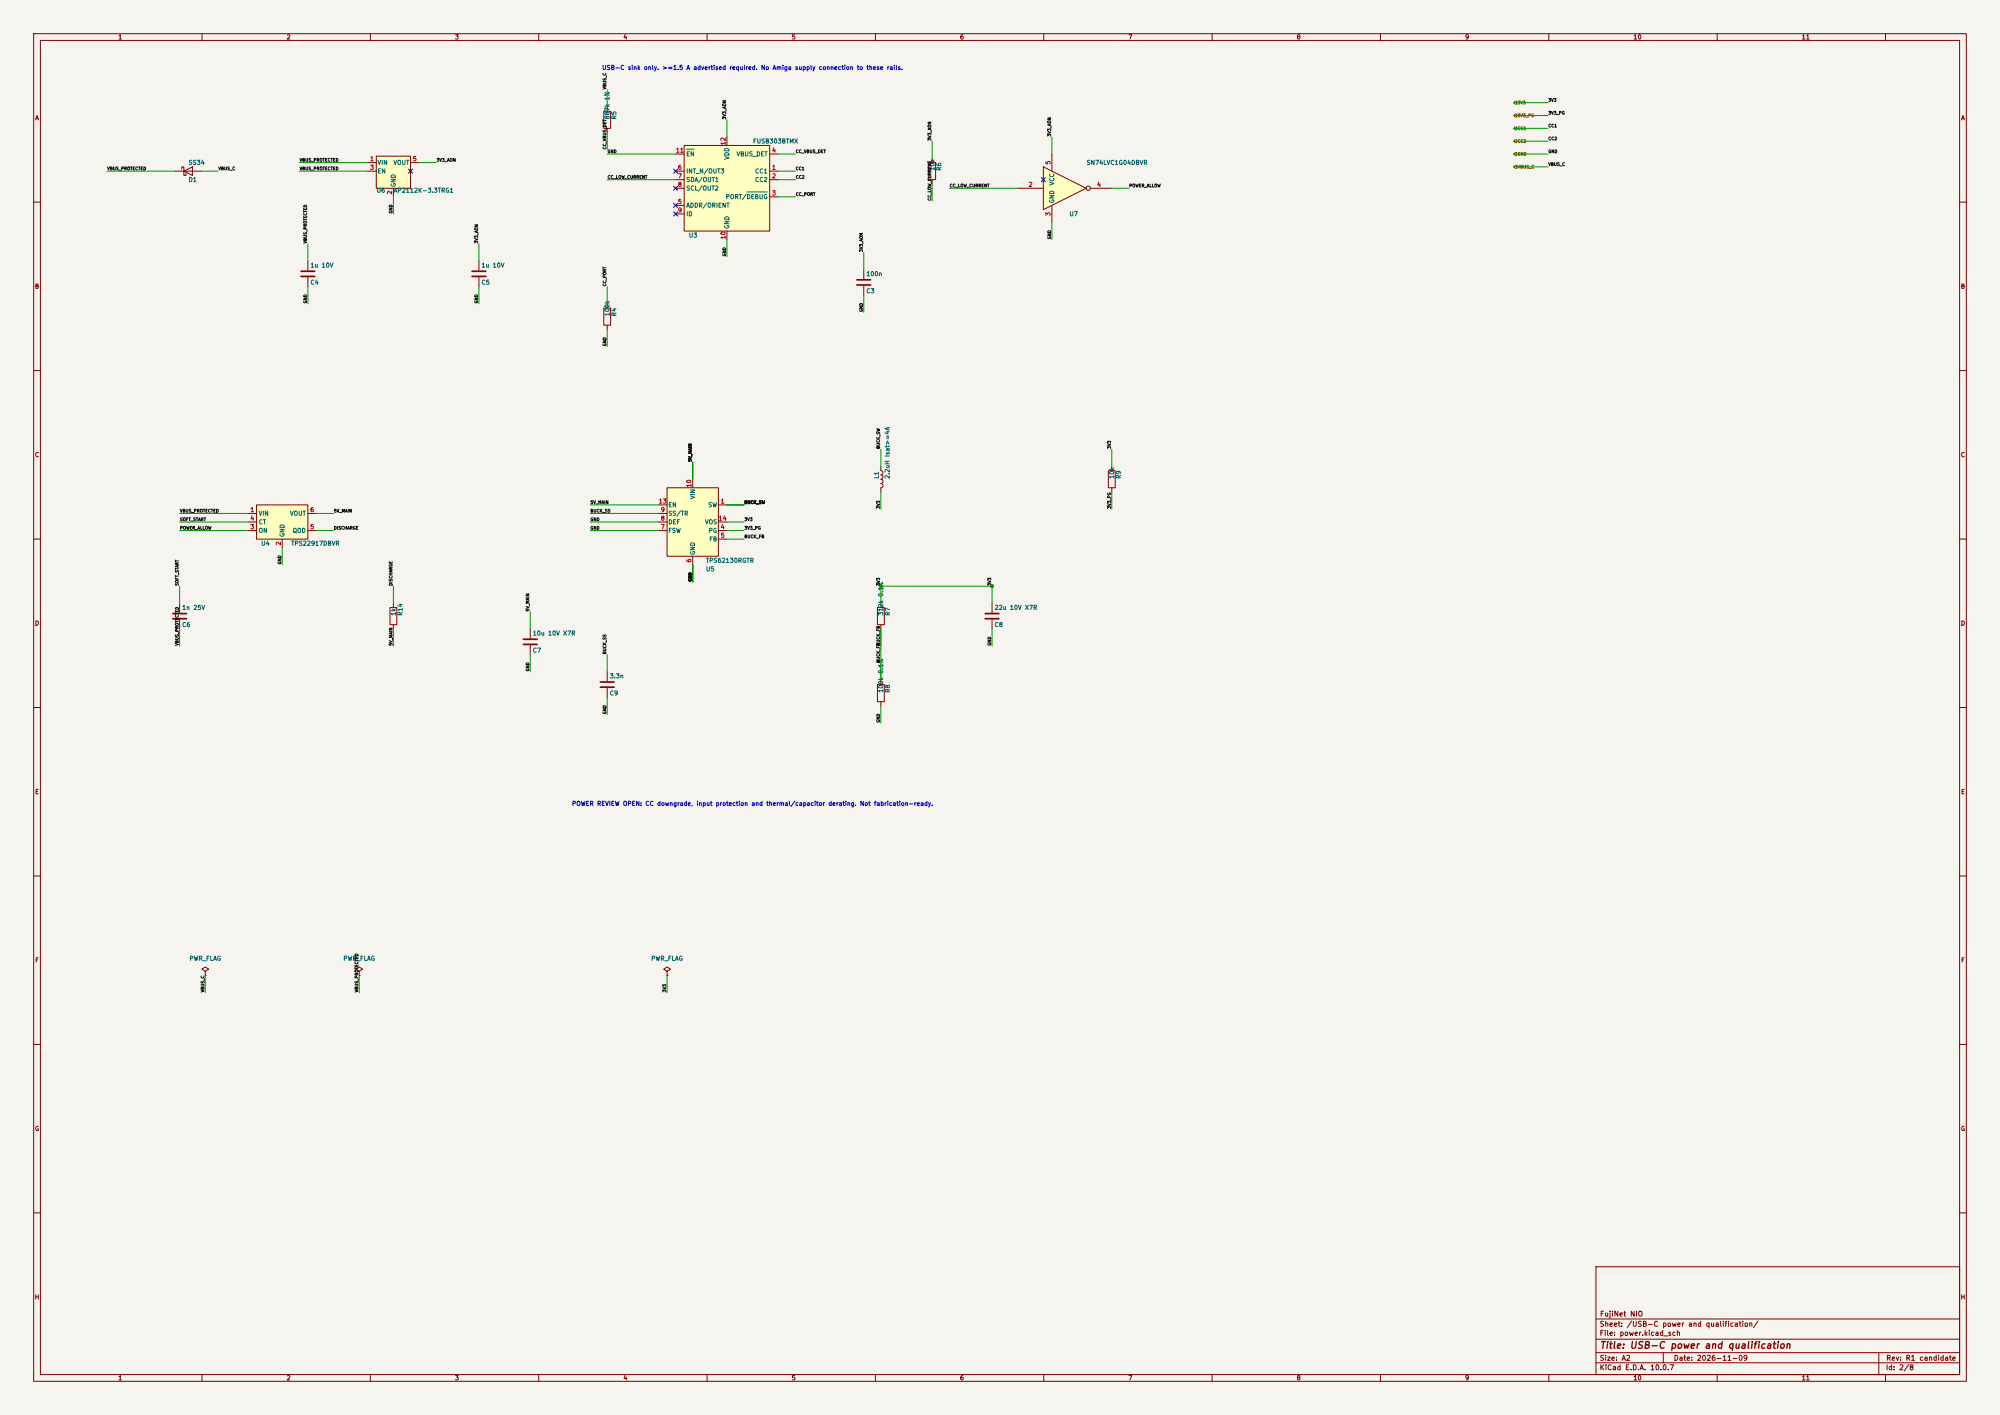
[picture p67: page 2]

USB-C sink only. >=1.5 A advertised required. No Amiga supply connection to these rails.
TPS62130RGTR 887k R5 1%

3V3_PG POWER REVIEW OPEN: CC downgrade, input protection and thermal/capacitor derating. Not fabrication-ready.

FujiNet NIO
Sheet: /USB-C power and qualification/
File: power.kicad_sch
Title: USB-C power and qualification

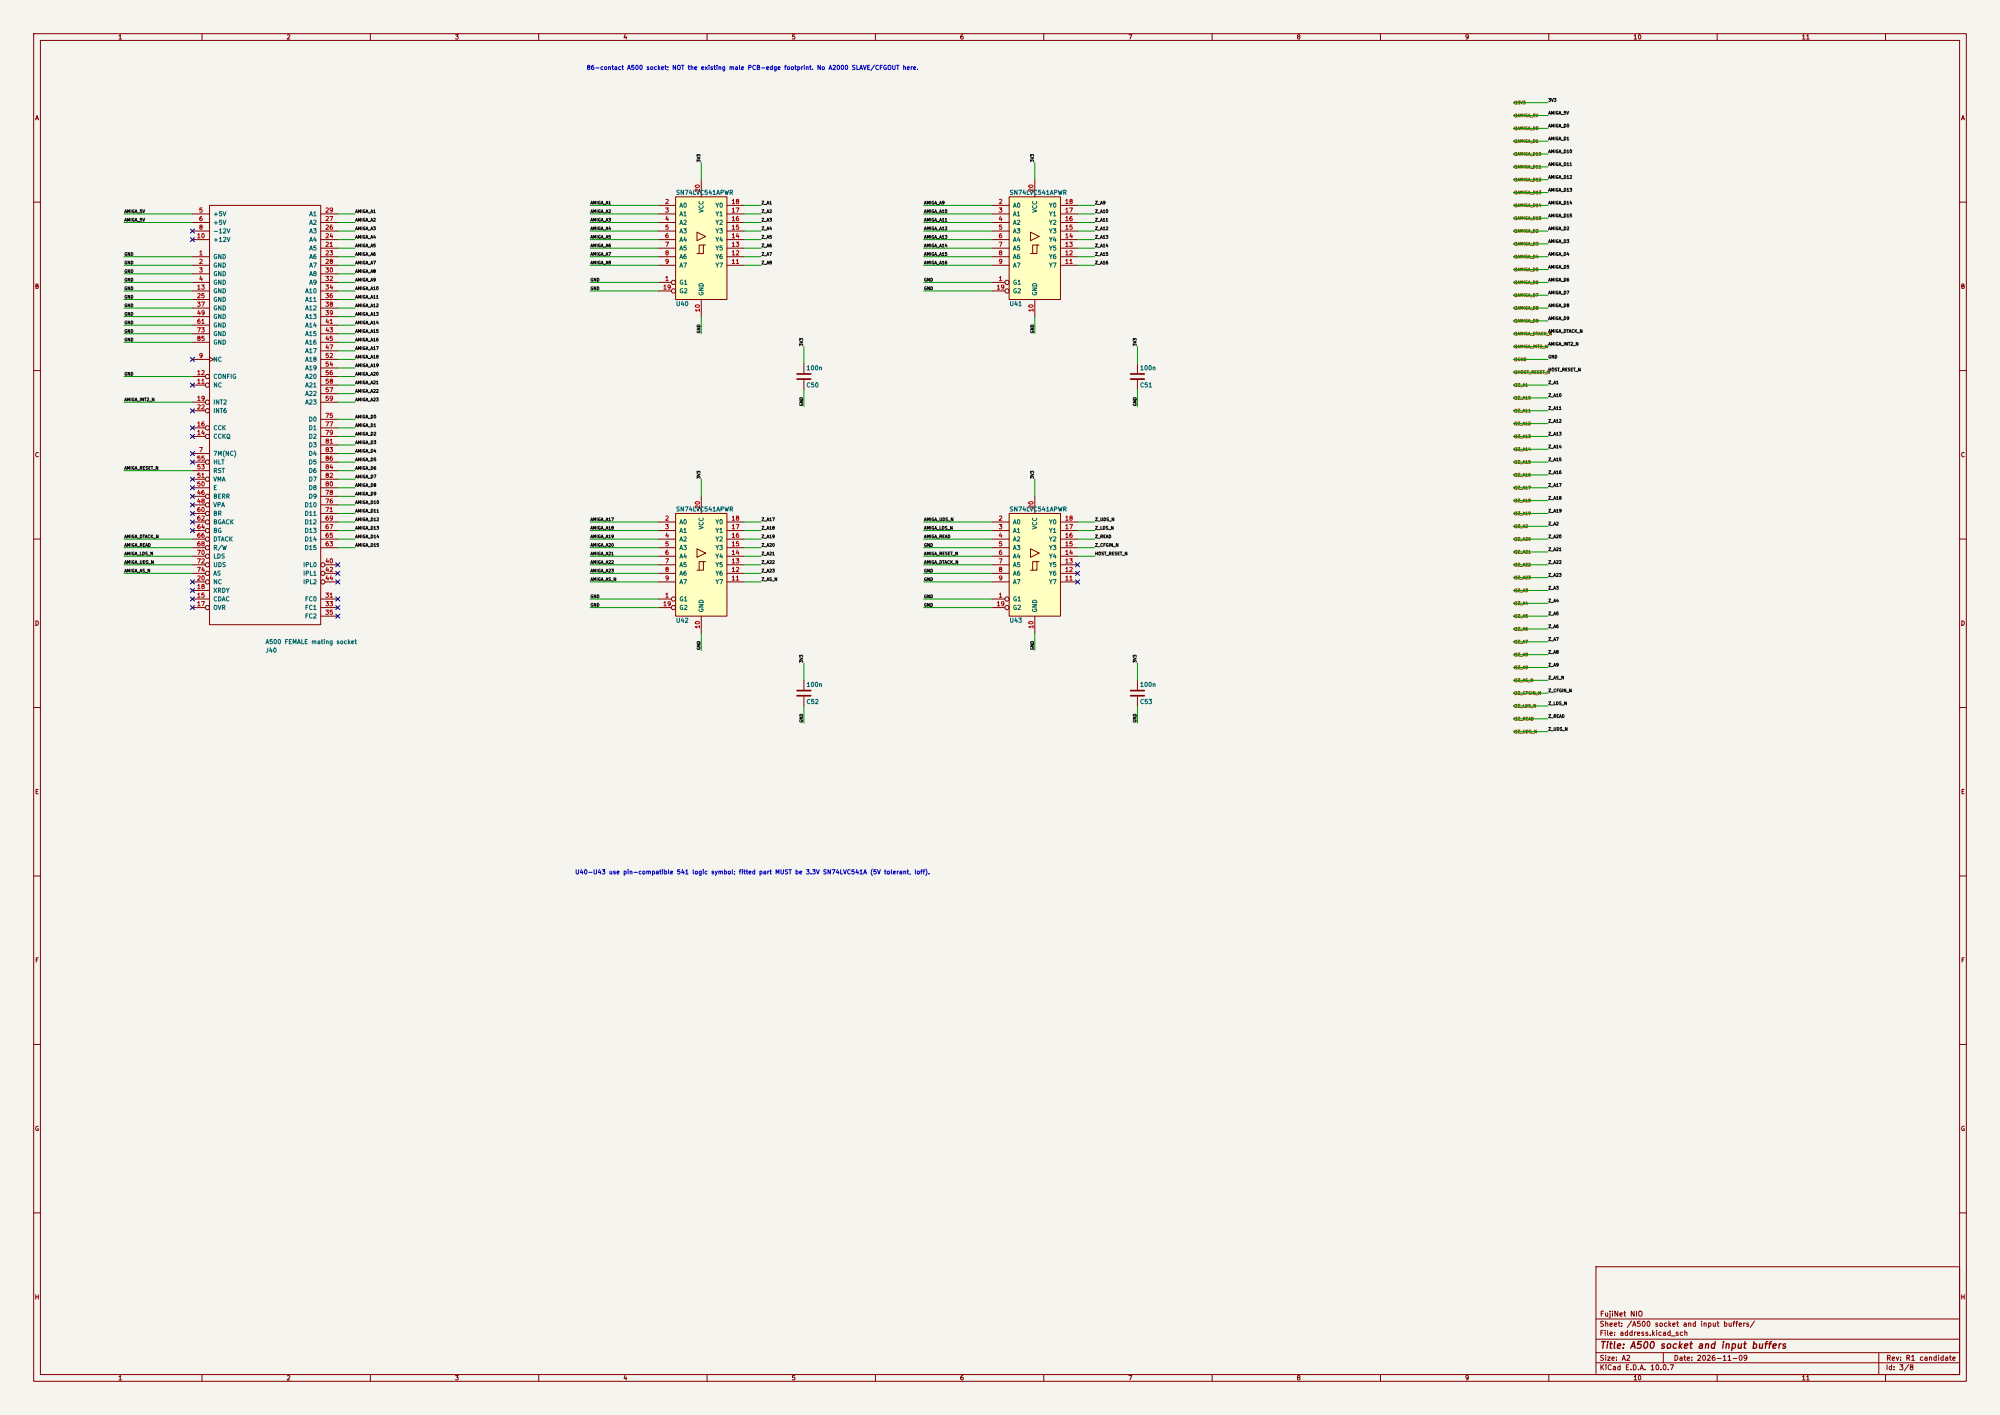
[picture p68: page 3]

86-contact A500 socket; NOT the existing male PCB-edge footprint. No A2000 SLAVE/CFGOUT here.

U40-U43 use pin-compatible 541 logic symbol; fitted part MUST be 3.3V SN74LVC541A (5V tolerant, Ioff).

Sheet: /A500 socket and input buffers/
File: address.kicad_sch
Title: A500 socket and input buffers

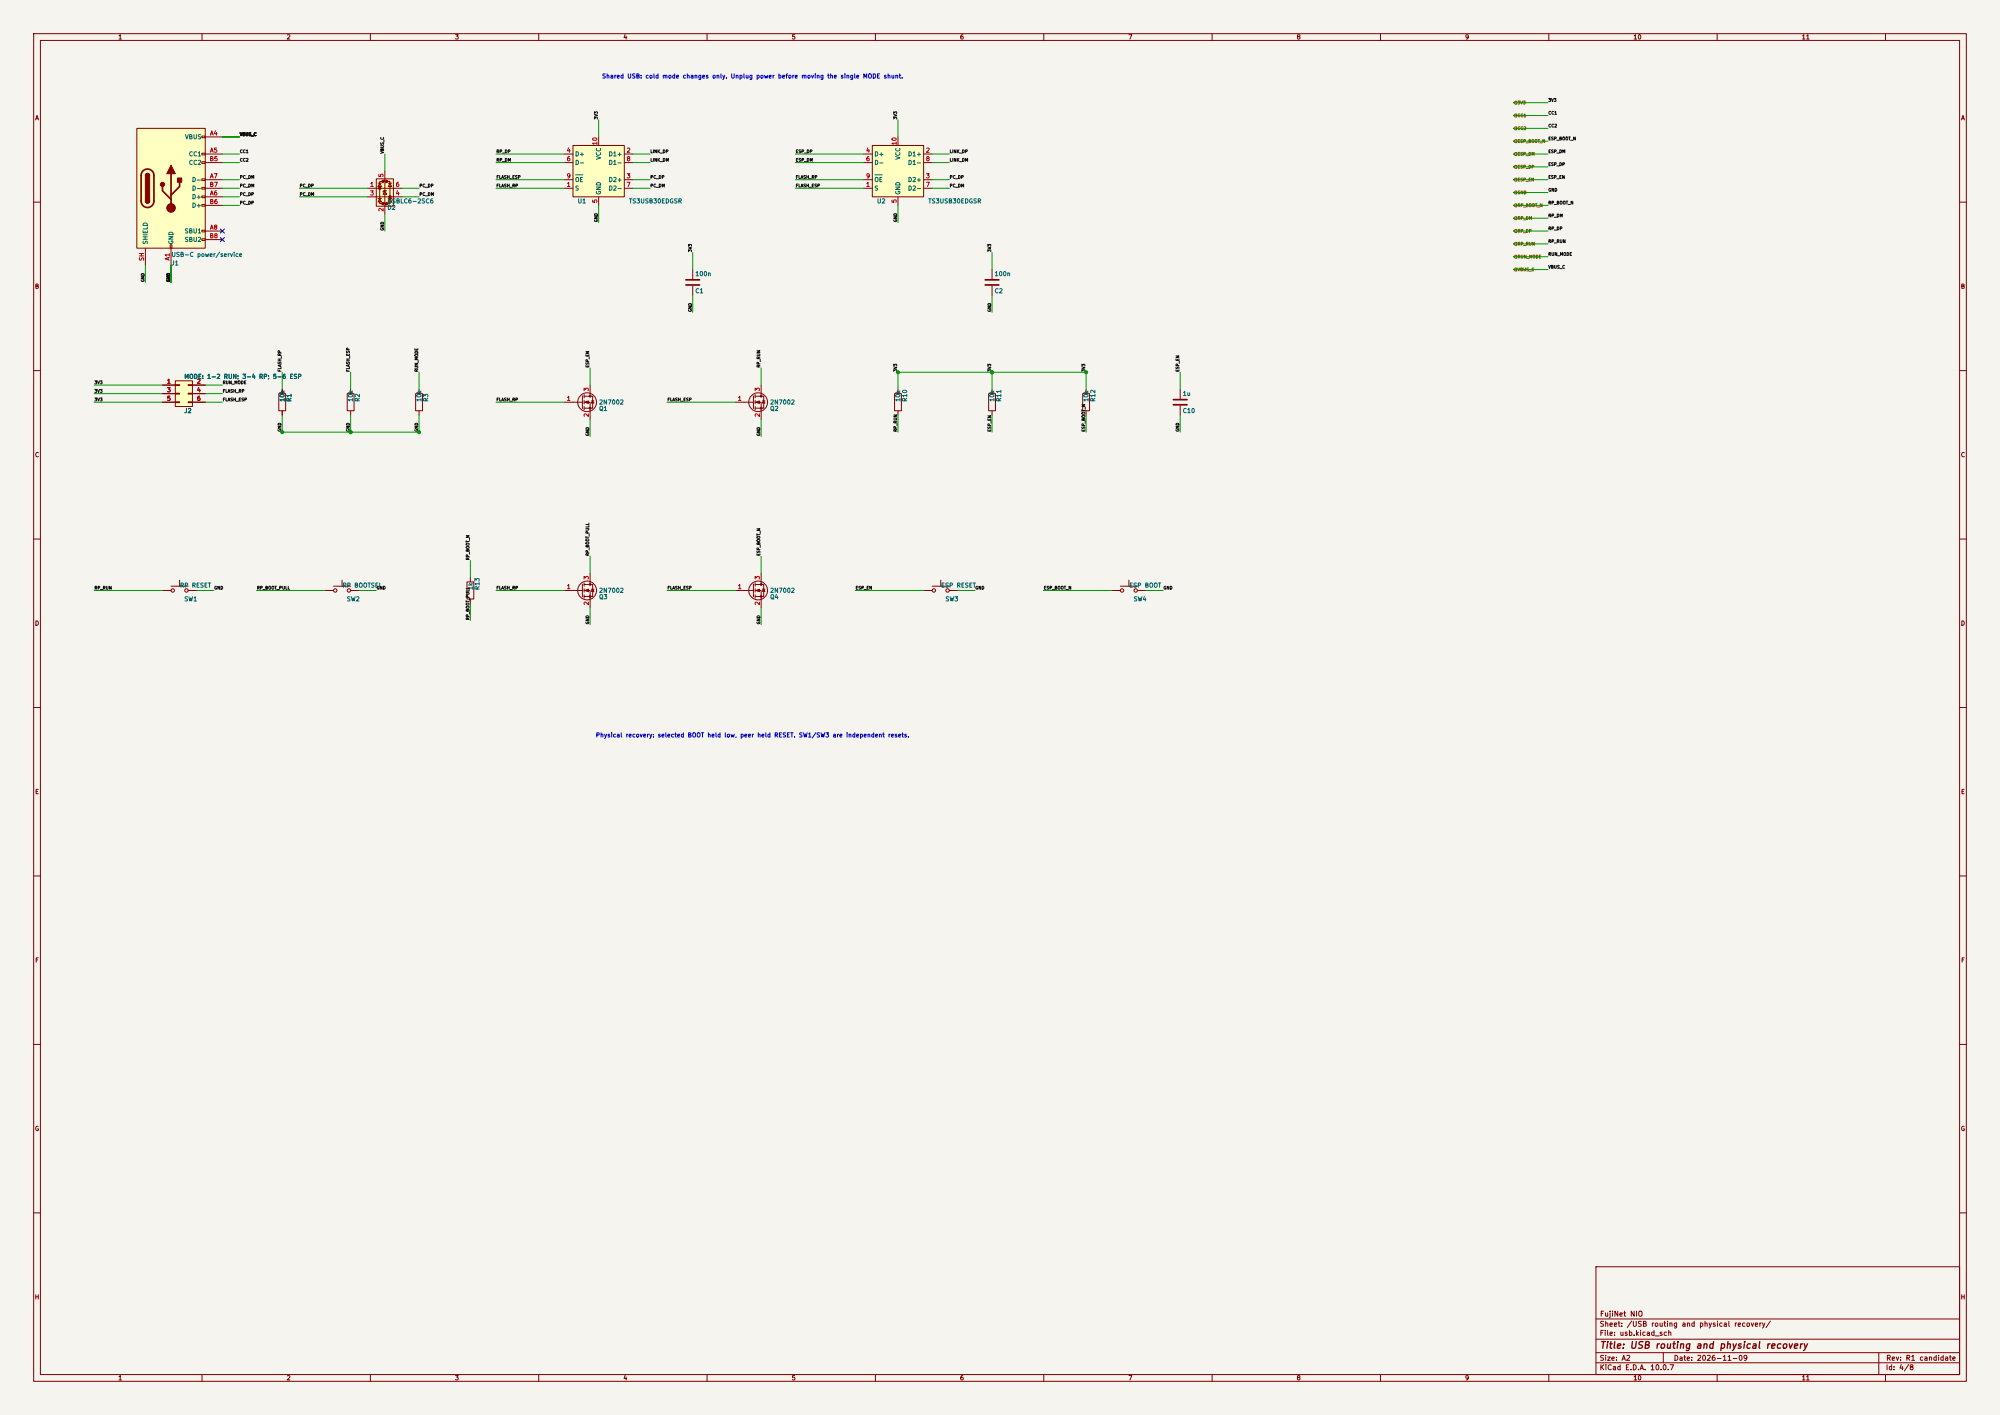
[picture p69: page 4]

Shared USB: cold mode changes only. Unplug power before moving the single MODE shunt. 10k R1

Physical recovery: selected BOOT held low, peer held RESET. SW1/SW3 are independent resets.

Sheet: /USB routing and physical recovery/
File: usb.kicad_sch
Title: USB routing and physical recovery

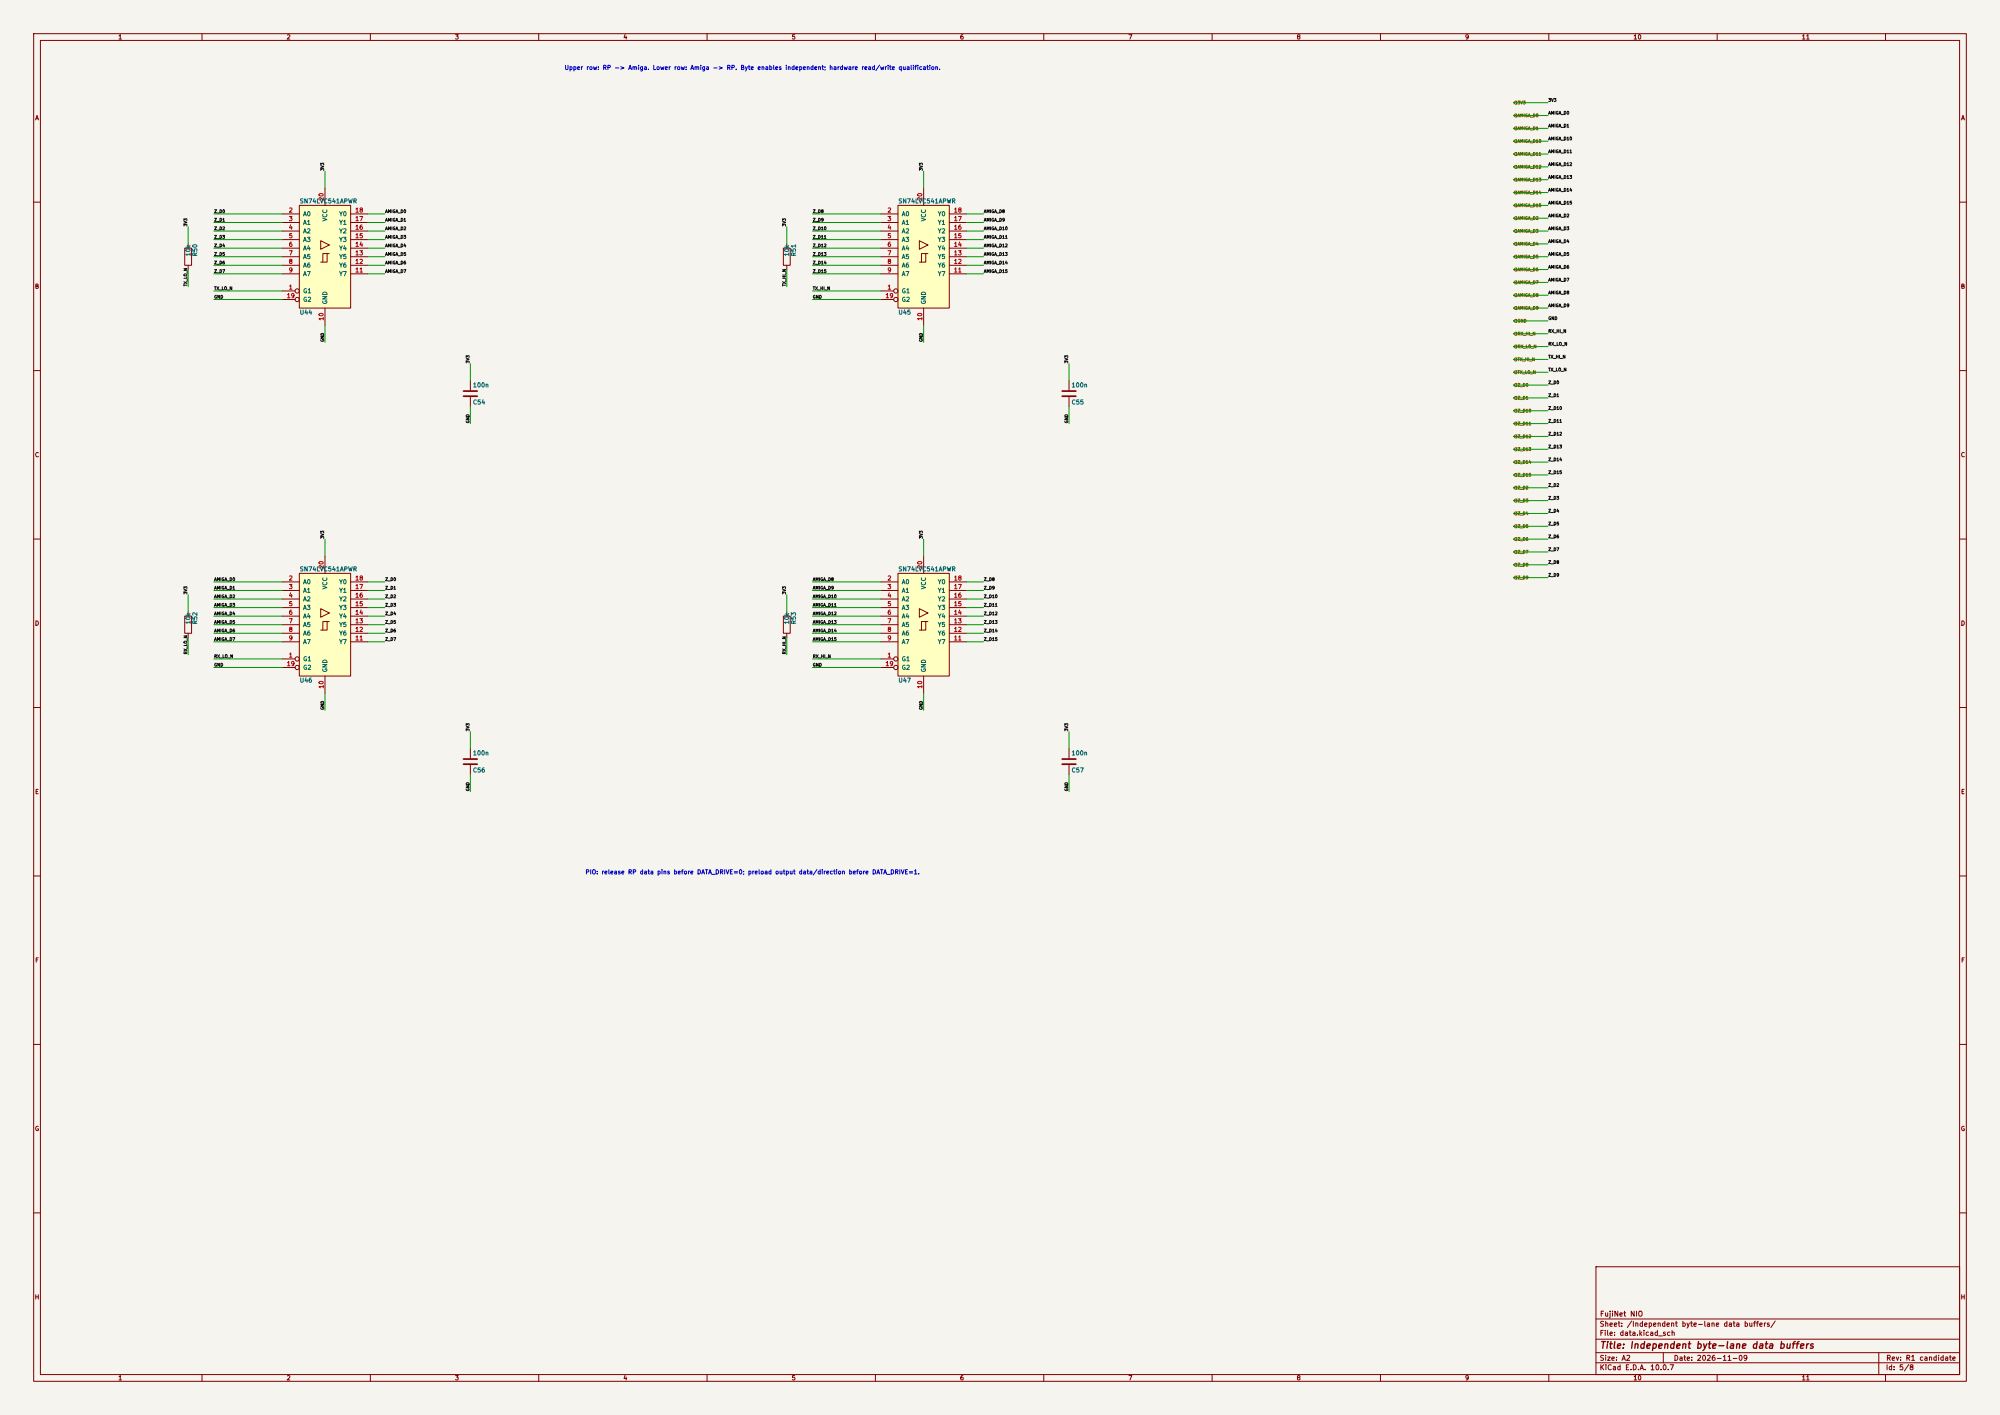
[picture p70: page 5]

Upper row: RP -> Amiga. Lower row: Amiga -> RP. Byte enables independent; hardware read/write qualification.

PIO: release RP data pins before DATA_DRIVE=0; preload output data/direction before DATA_DRIVE=1.

Sheet: /Independent byte-lane data buffers/
File: data.kicad_sch
Title: Independent byte-lane data buffers

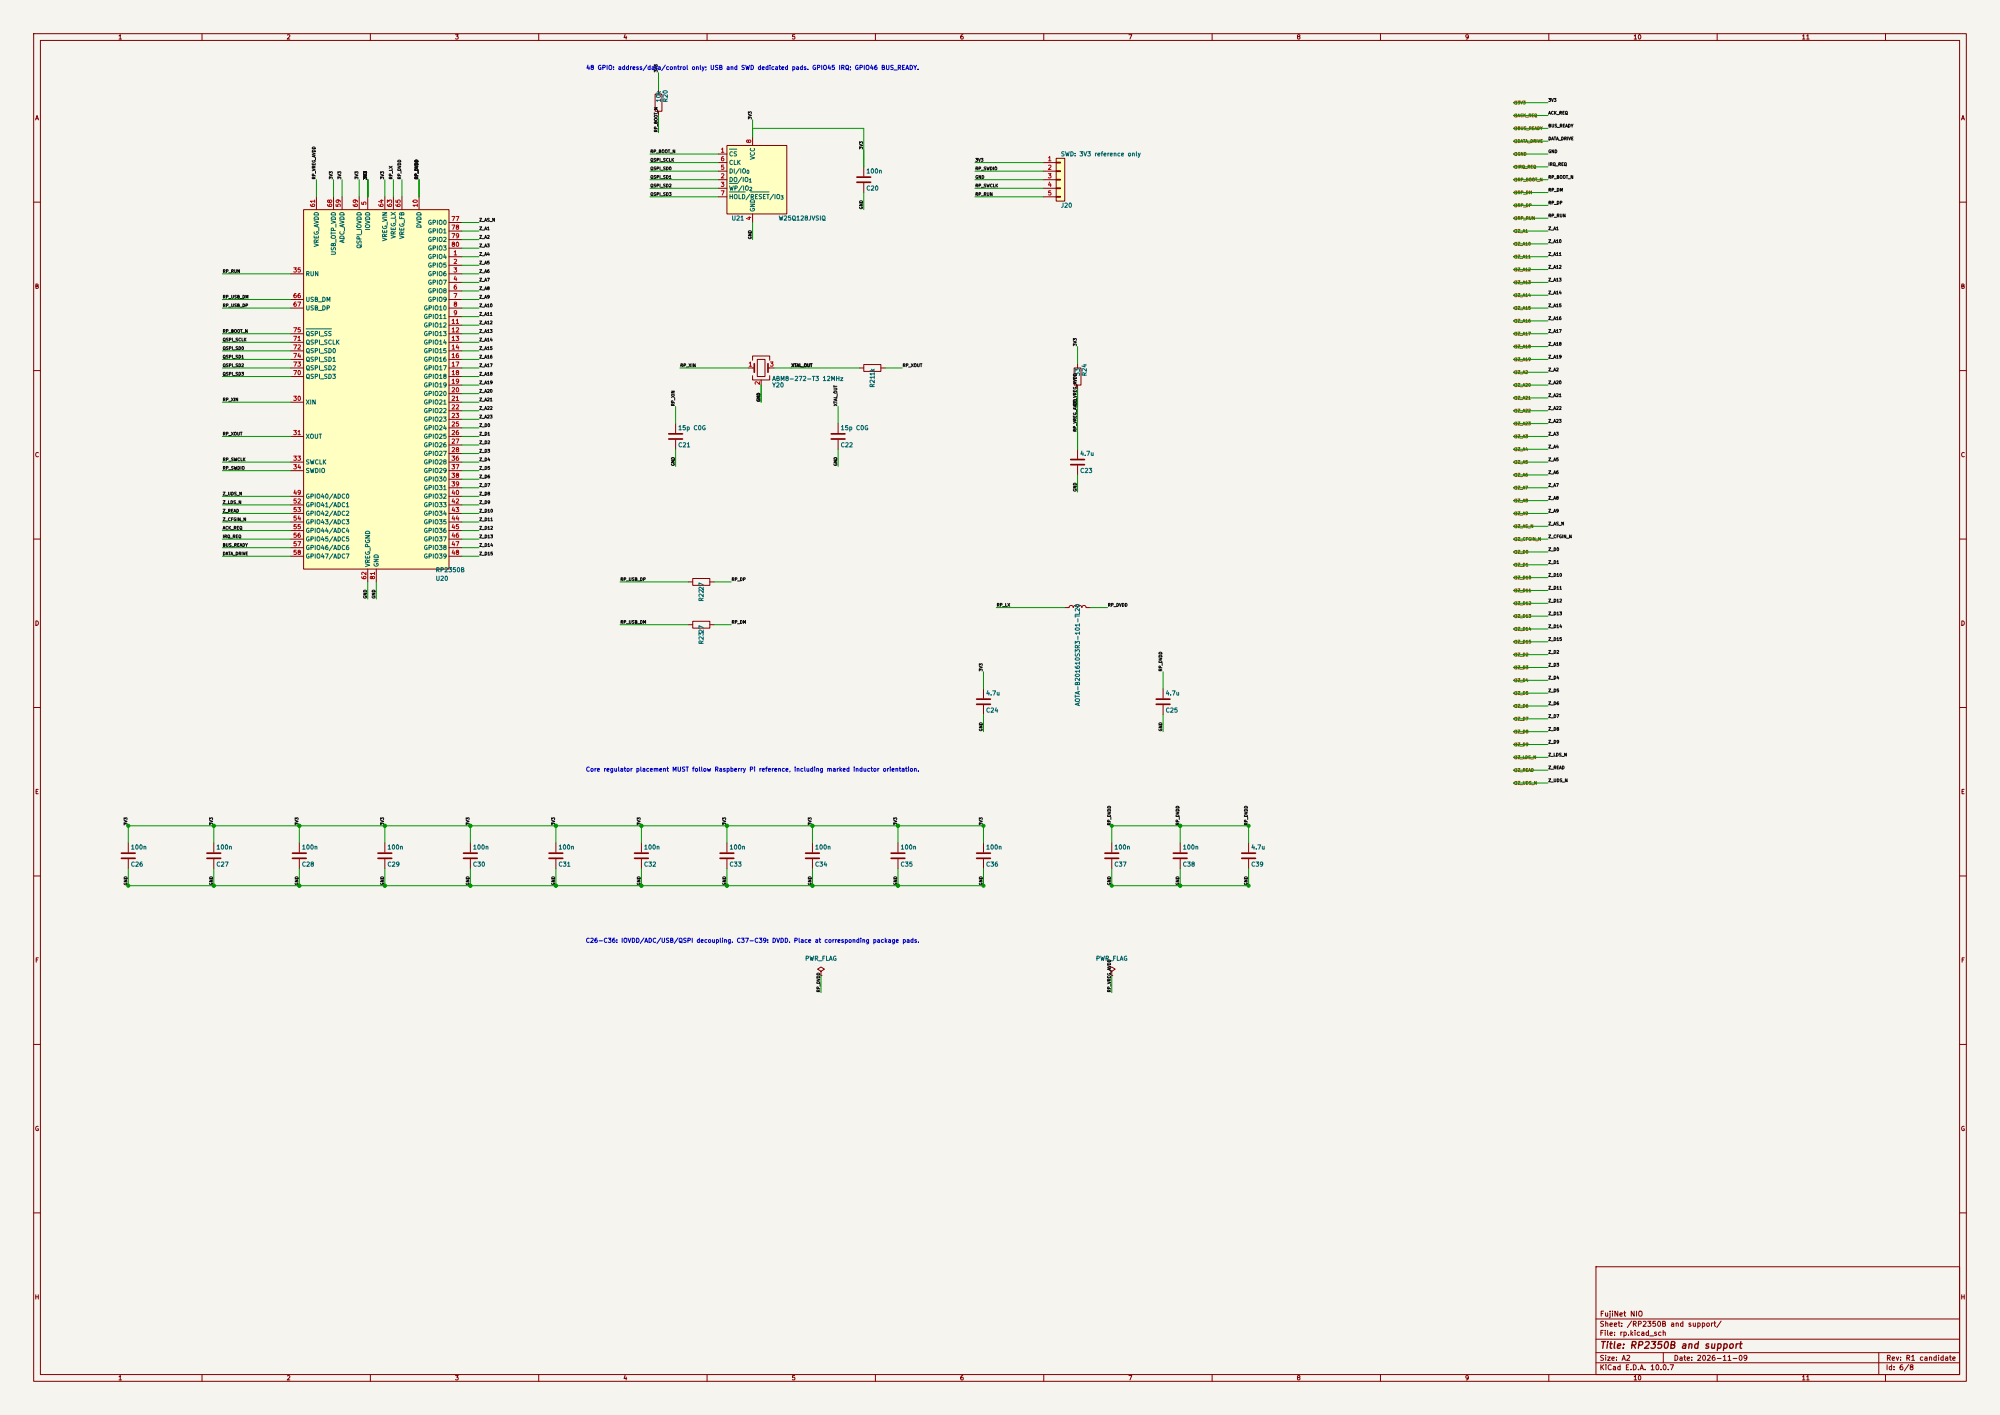
[picture p71: page 6]

48 GPIO: address/data/control only; USB and SWD dedicated pads. GPIO45 IRQ; GPIO46 BUS_READY.

Core regulator placement MUST follow Raspberry Pi reference, including marked inductor orientation.

C26-C36: IOVDD/ADC/USB/QSPI decoupling. C37-C39: DVDD. Place at corresponding package pads.

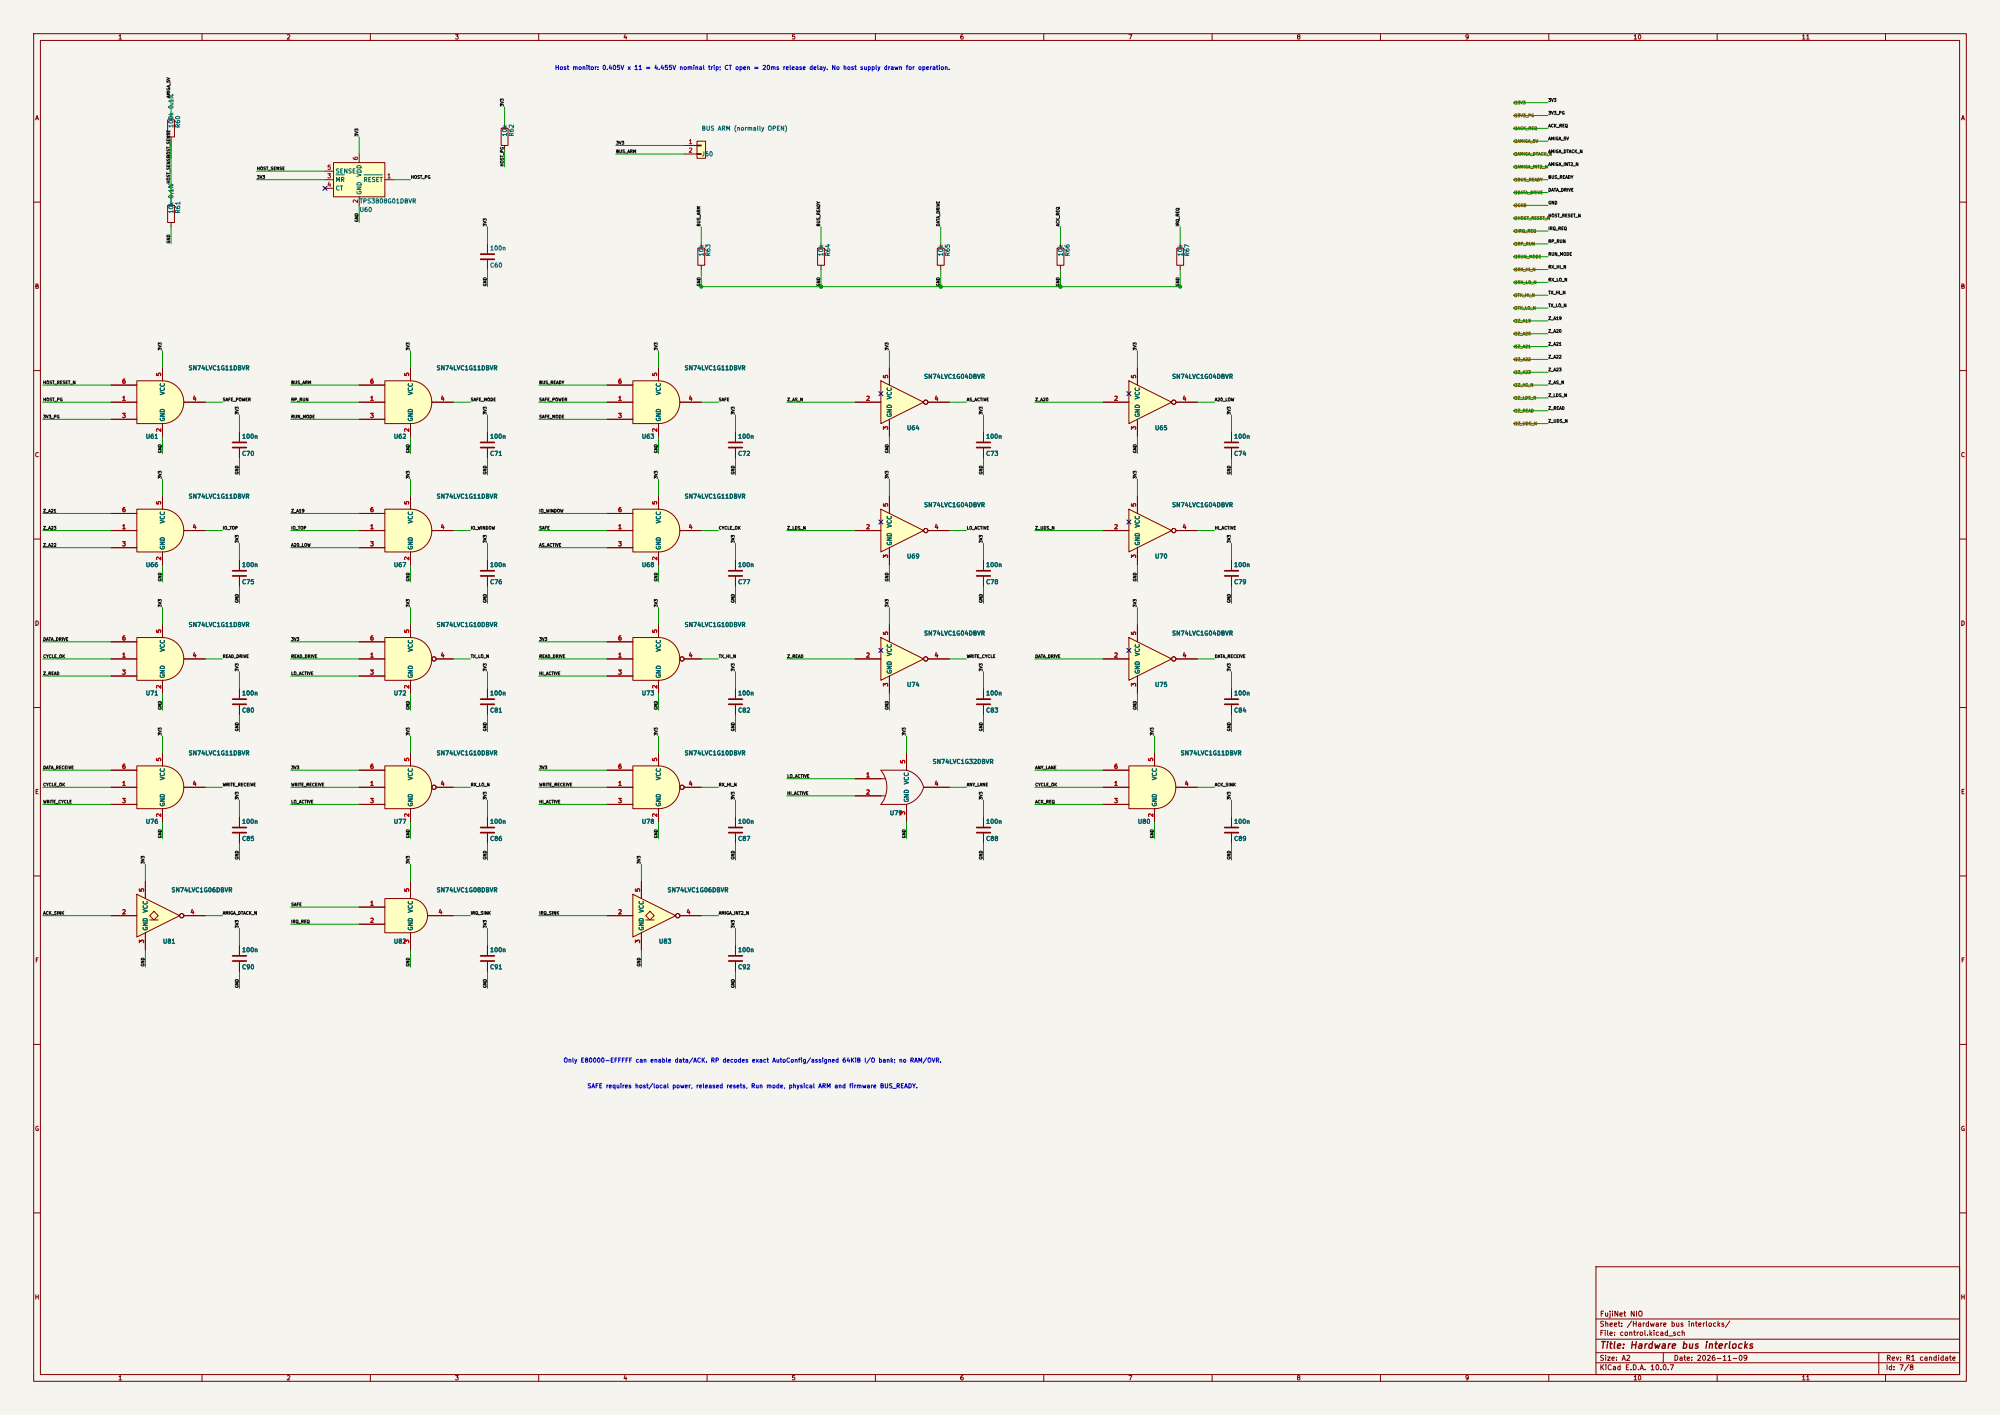
[picture p72: page 7]

Host monitor: 0.405V x 11 = 4.455V nominal trip; CT open = 20ms release delay. No host supply drawn for operation.
IRQ_SINK GND 3V3
SN74LVC1G06DBVR 10k R61 0.1%

Sheet: /Hardware bus interlocks/
File: control.kicad_sch
Title: Hardware bus interlocks

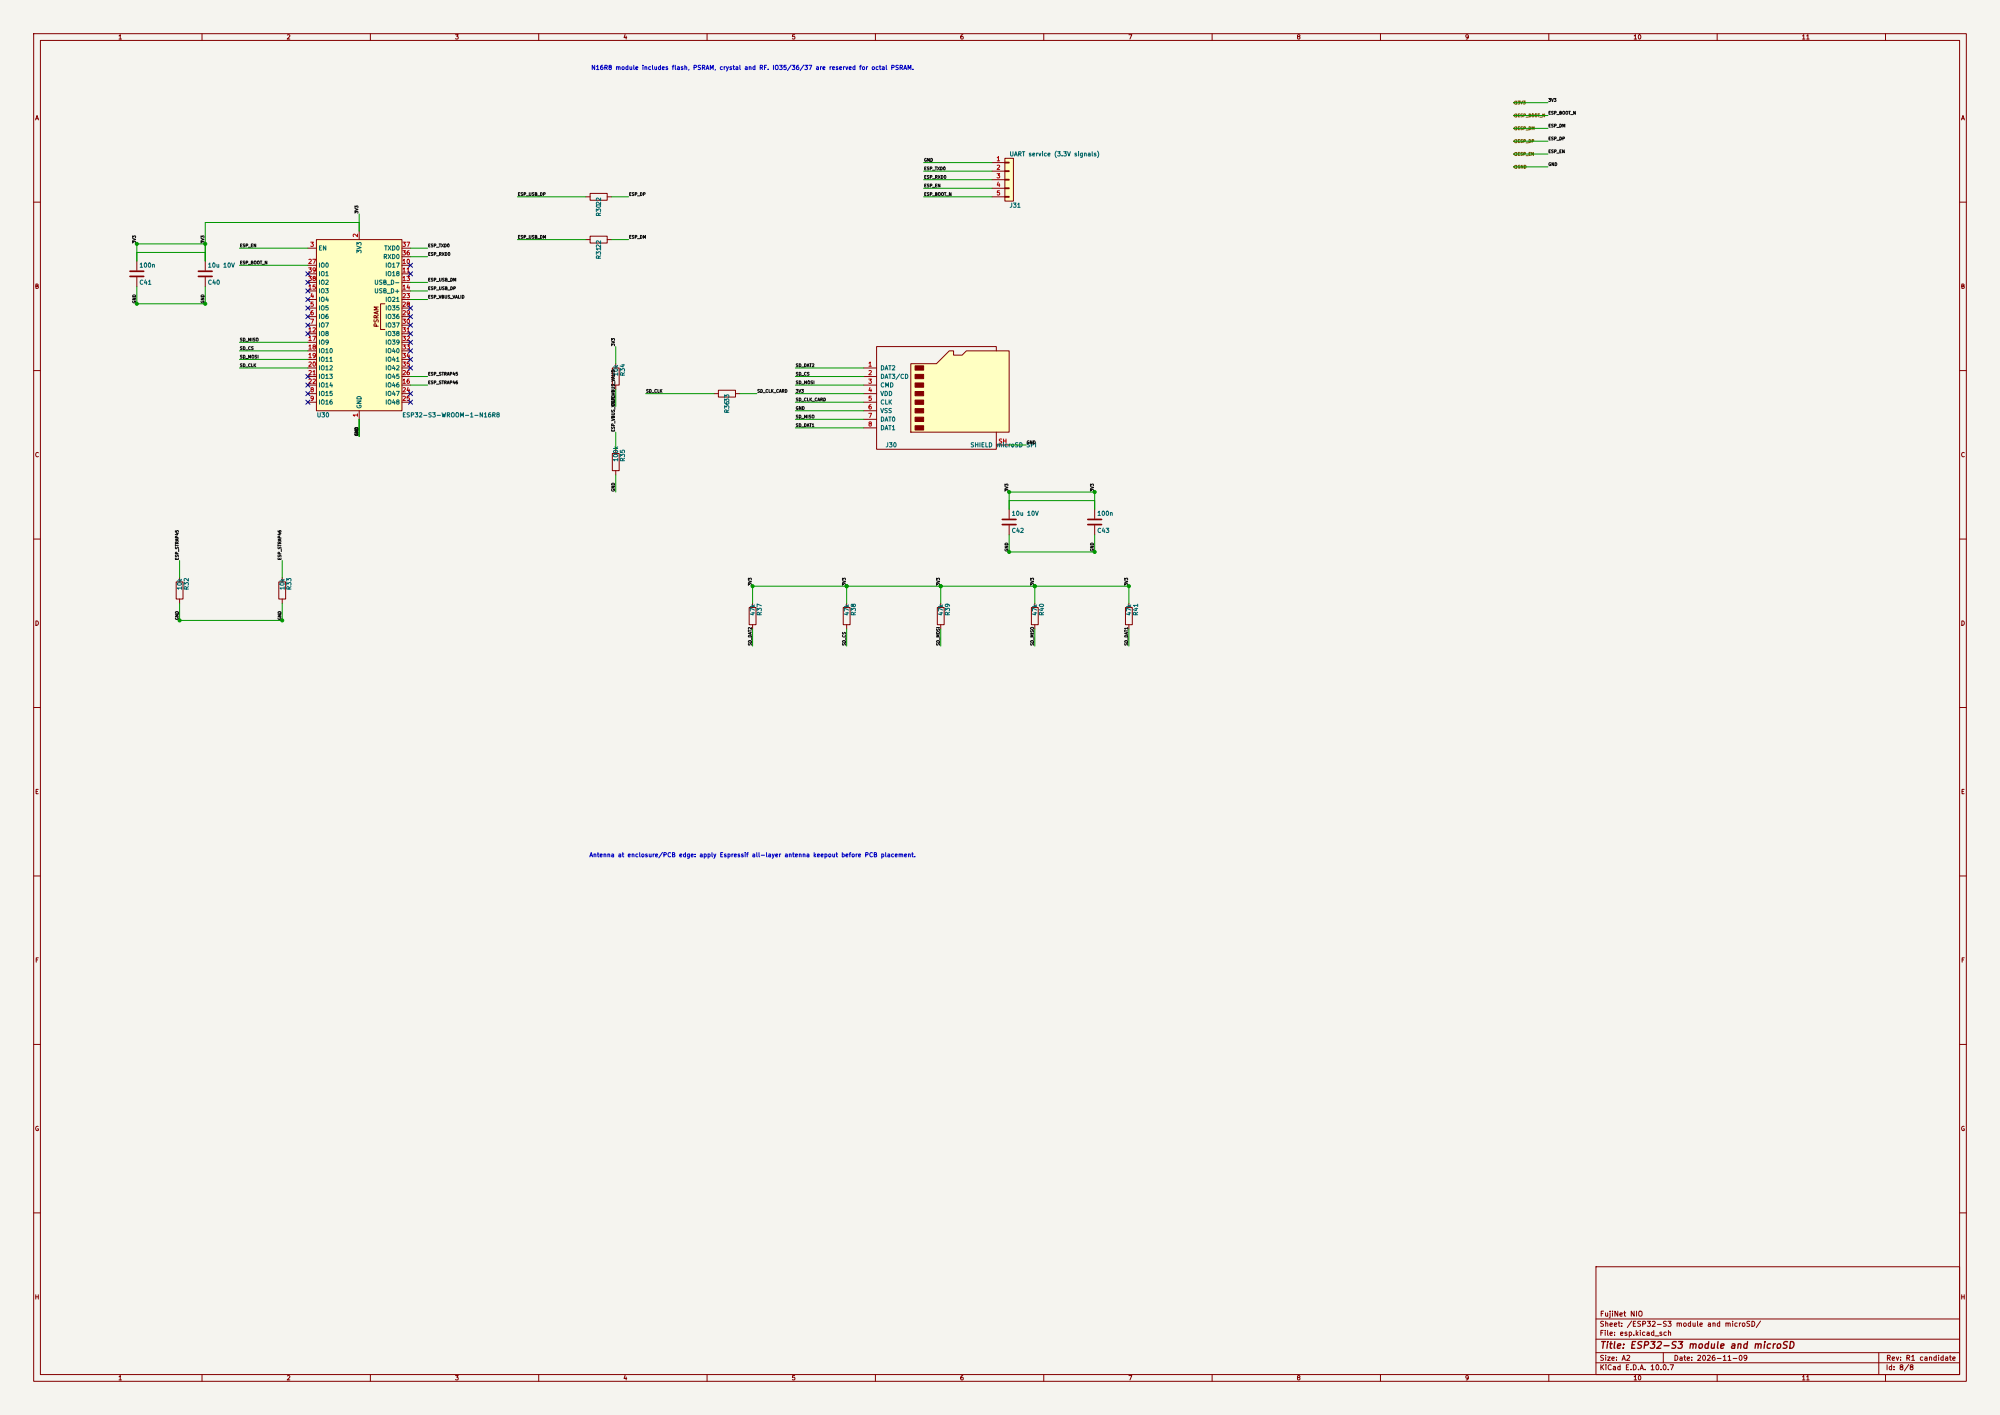
[picture p73: page 8]

N16R8 module includes flash, PSRAM, crystal and RF. IO35/36/37 are reserved for octal PSRAM.
ESP_BOOT_N SD_DAT2 3V3

Antenna at enclosure/PCB edge: apply Espressif all-layer antenna keepout before PCB placement.

Sheet: /ESP32-S3 module and microSD/
File: esp.kicad_sch
Title: ESP32-S3 module and microSD
