markjfisher/fujinet-nio-hardware/amiga/integrated-r0/review/schematic.pdf

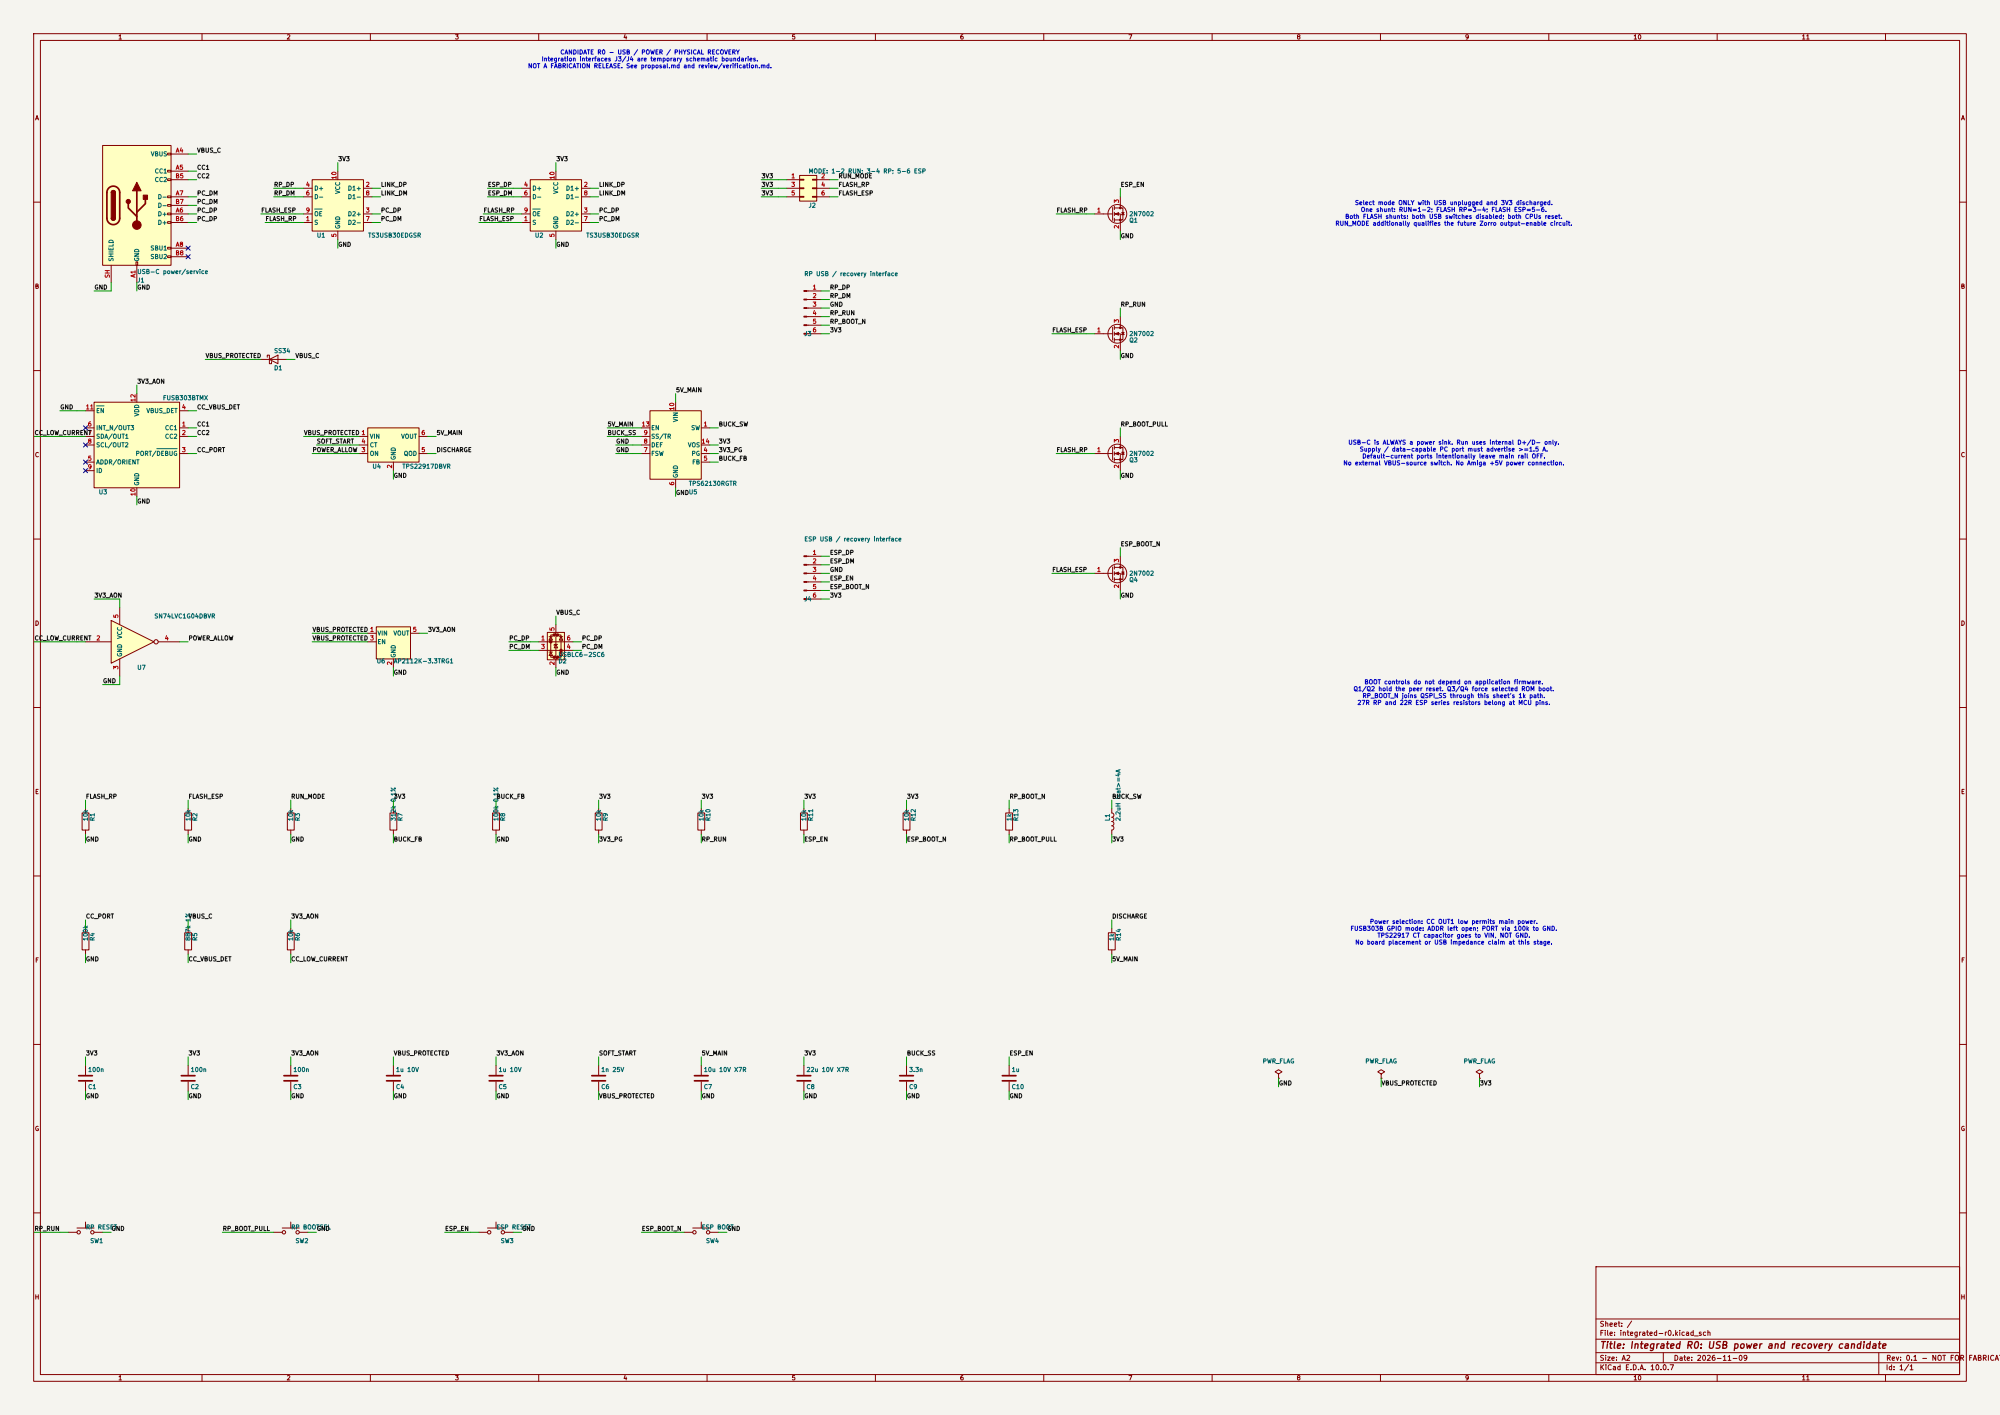
[picture p74: page 1]

Select mode ONLY with USB unplugged and 3V3 discharged. One shunt: RUN=1-2; FLASH RP=3-4; FLASH ESP=5-6. Both FLASH shunts: both USB switches disabled; both CPUs reset. RUN_MODE additionally qualifies the future Zorro output-enable circuit. CANDIDATE R0 - USB / POWER / PHYSICAL RECOVERY

Integration interfaces J3/J4 are temporary schematic boundaries. NOT A FABRICATION RELEASE. See proposal.md and review/verification.md.

USB-C is ALWAYS a power sink. Run uses internal D+/D- only.
Supply / data-capable PC port must advertise >=1.5 A. Default-current ports intentionally leave main rail OFF. No external VBUS-source switch. No Amiga +5V power connection.

ESP USB / recovery interface

BOOT controls do not depend on application firmware. Q1/Q2 hold the peer reset. Q3/Q4 force selected ROM boot. RP_BOOT_N joins QSPI_SS through this sheet's 1k path. 27R RP and 22R ESP series resistors belong at MCU pins.

Power selection: CC OUT1 low permits main power. FUSB303B GPIO mode: ADDR left open; PORT via 100k to GND. TPS22917 CT capacitor goes to VIN, NOT GND. No board placement or USB impedance claim at this stage.

Sheet: /
File: integrated-r0.kicad_sch
Title: Integrated R0: USB power and recovery candidate
