markjfisher/fujinet-nio-hardware/(list of files, drawings)

Other design files:
amiga/integrated-a500-r4/review/pcb-audit.json
amiga/integrated-a500-r4/review/pcb-checks.json
amiga/prototyping-board/routing/zorro-breakout.dsn
