markjfisher/fujinet-nio-hardware/amiga/integrated-a500-r4/integrated-a500-r4.kicad_pcb

## KiCad design amiga/integrated-a500-r4/integrated-a500-r4.kicad_pcb (2026-11-10)

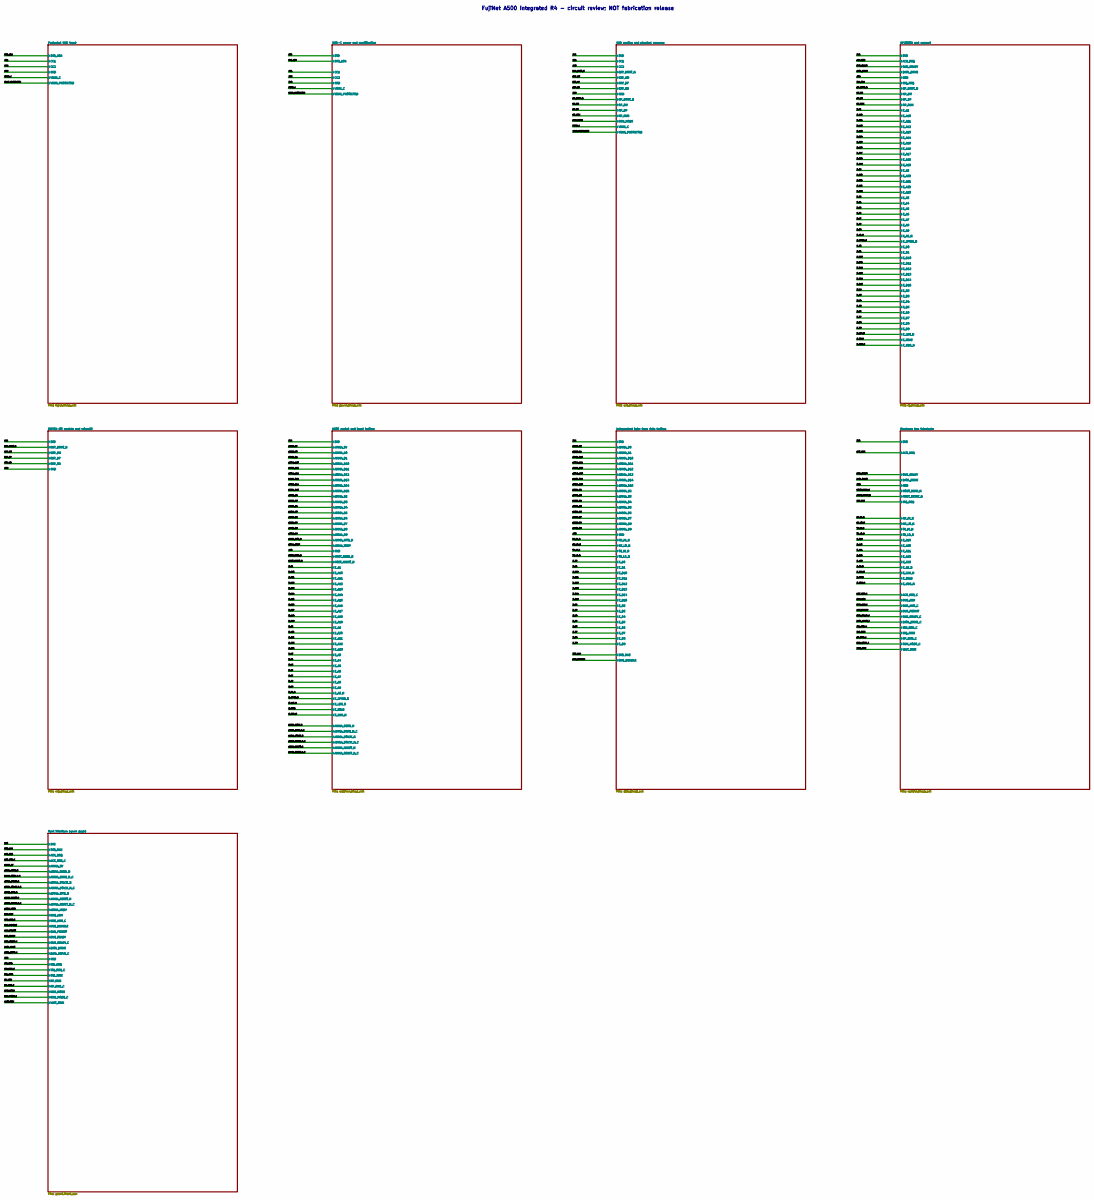
[picture p75: schematic integrated-a500-r4.kicad_sch, FujiNet direct A500 integrated candidate]

Notes on the sheet:
FujiNet A500 integrated R4 - circuit review; NOT fabrication release

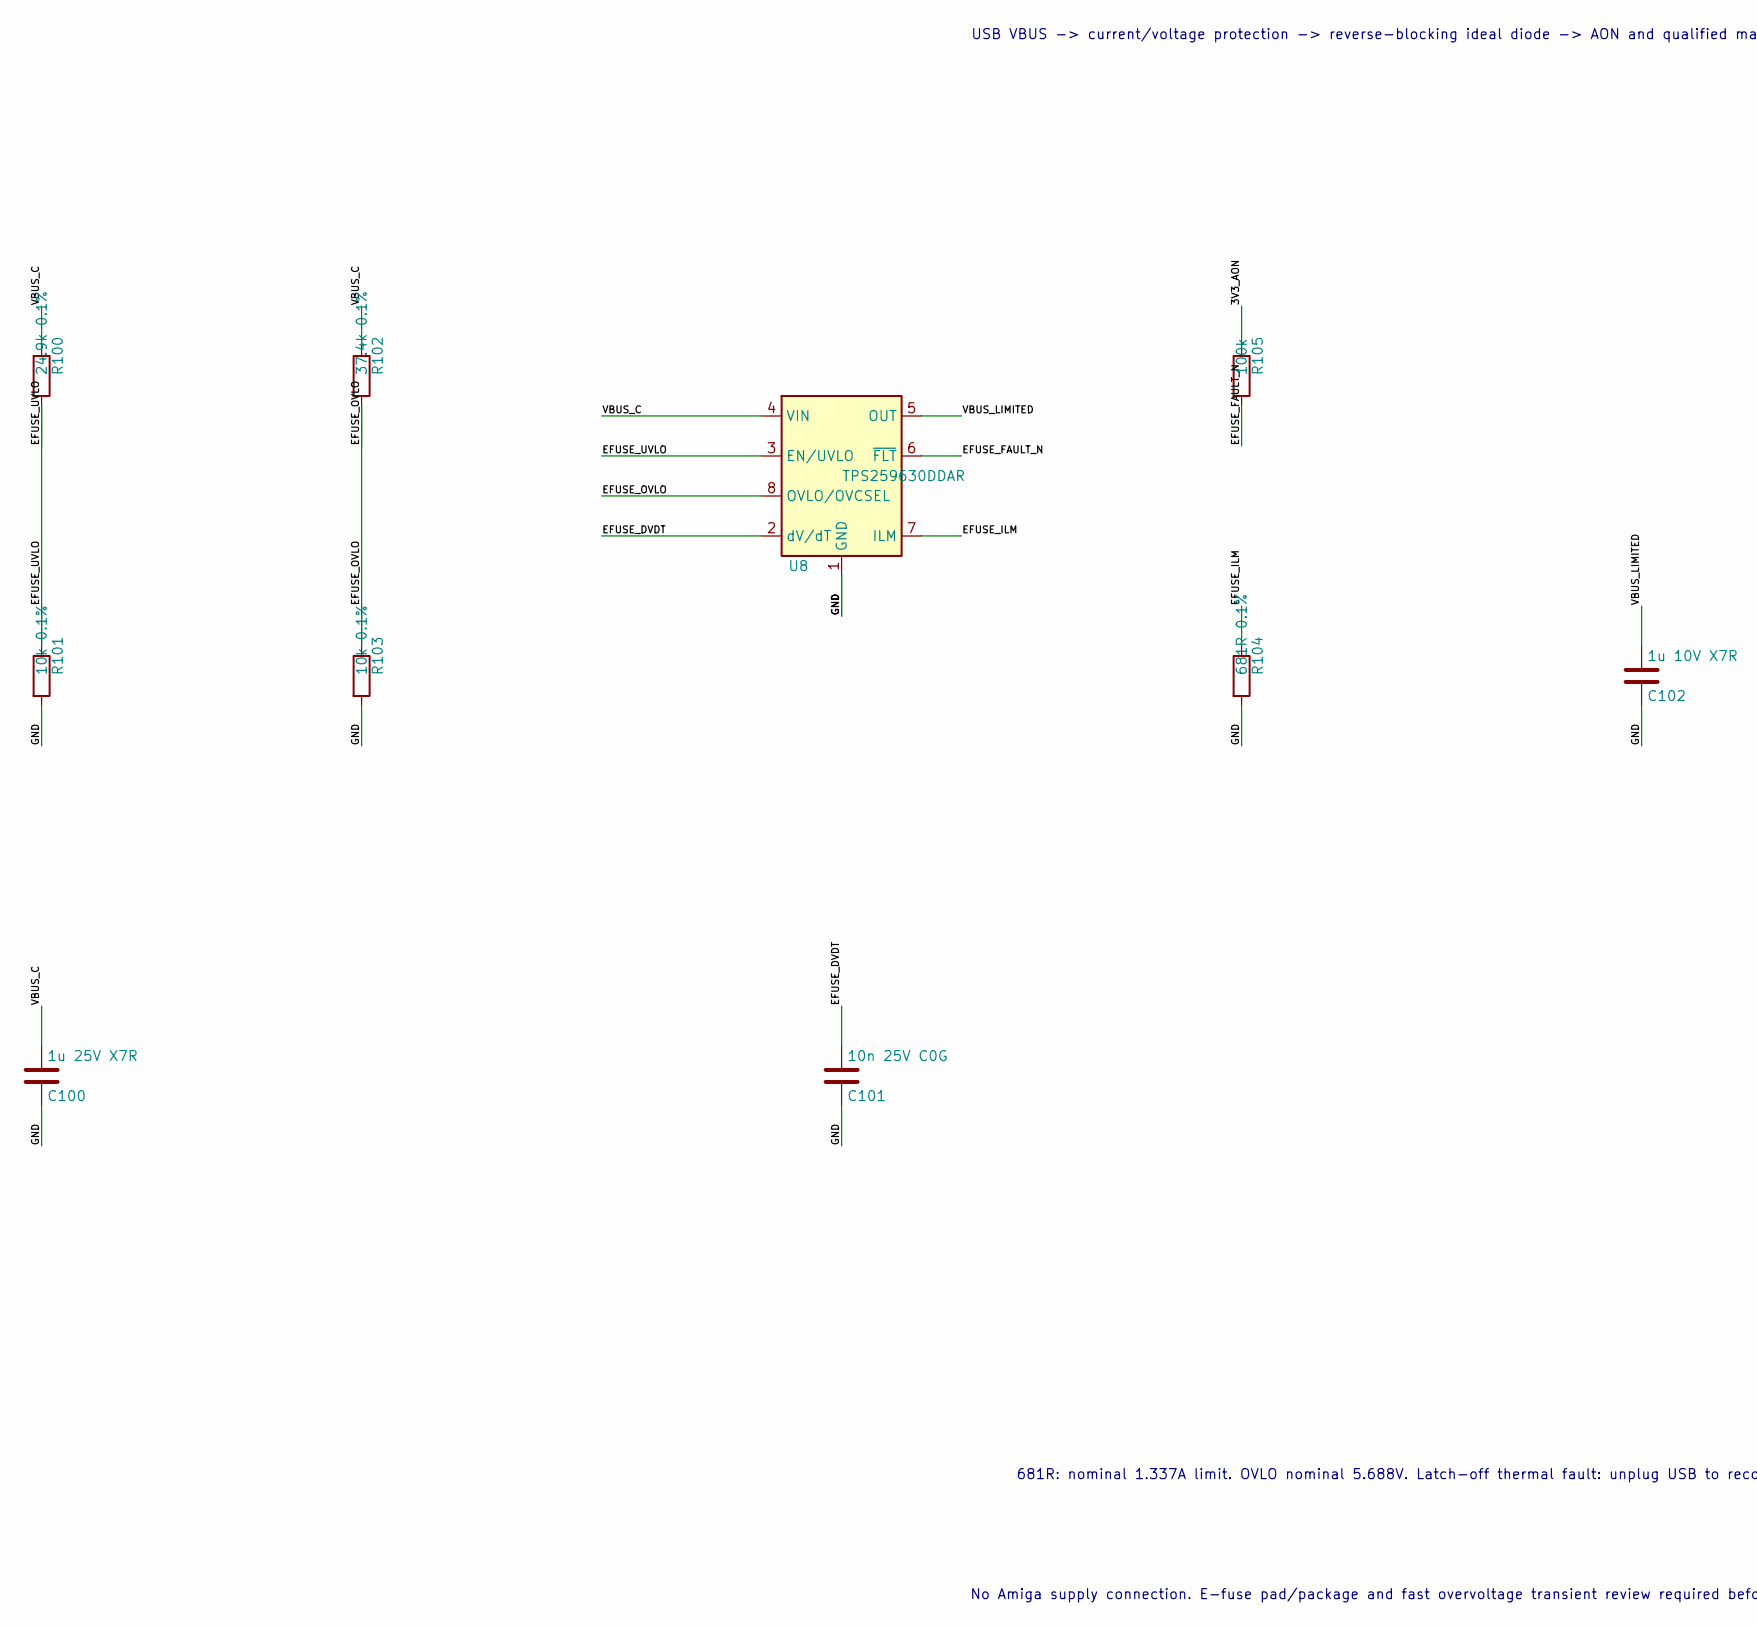
[picture p76: schematic input.kicad_sch, Protected USB input, part in row 1, column 1]

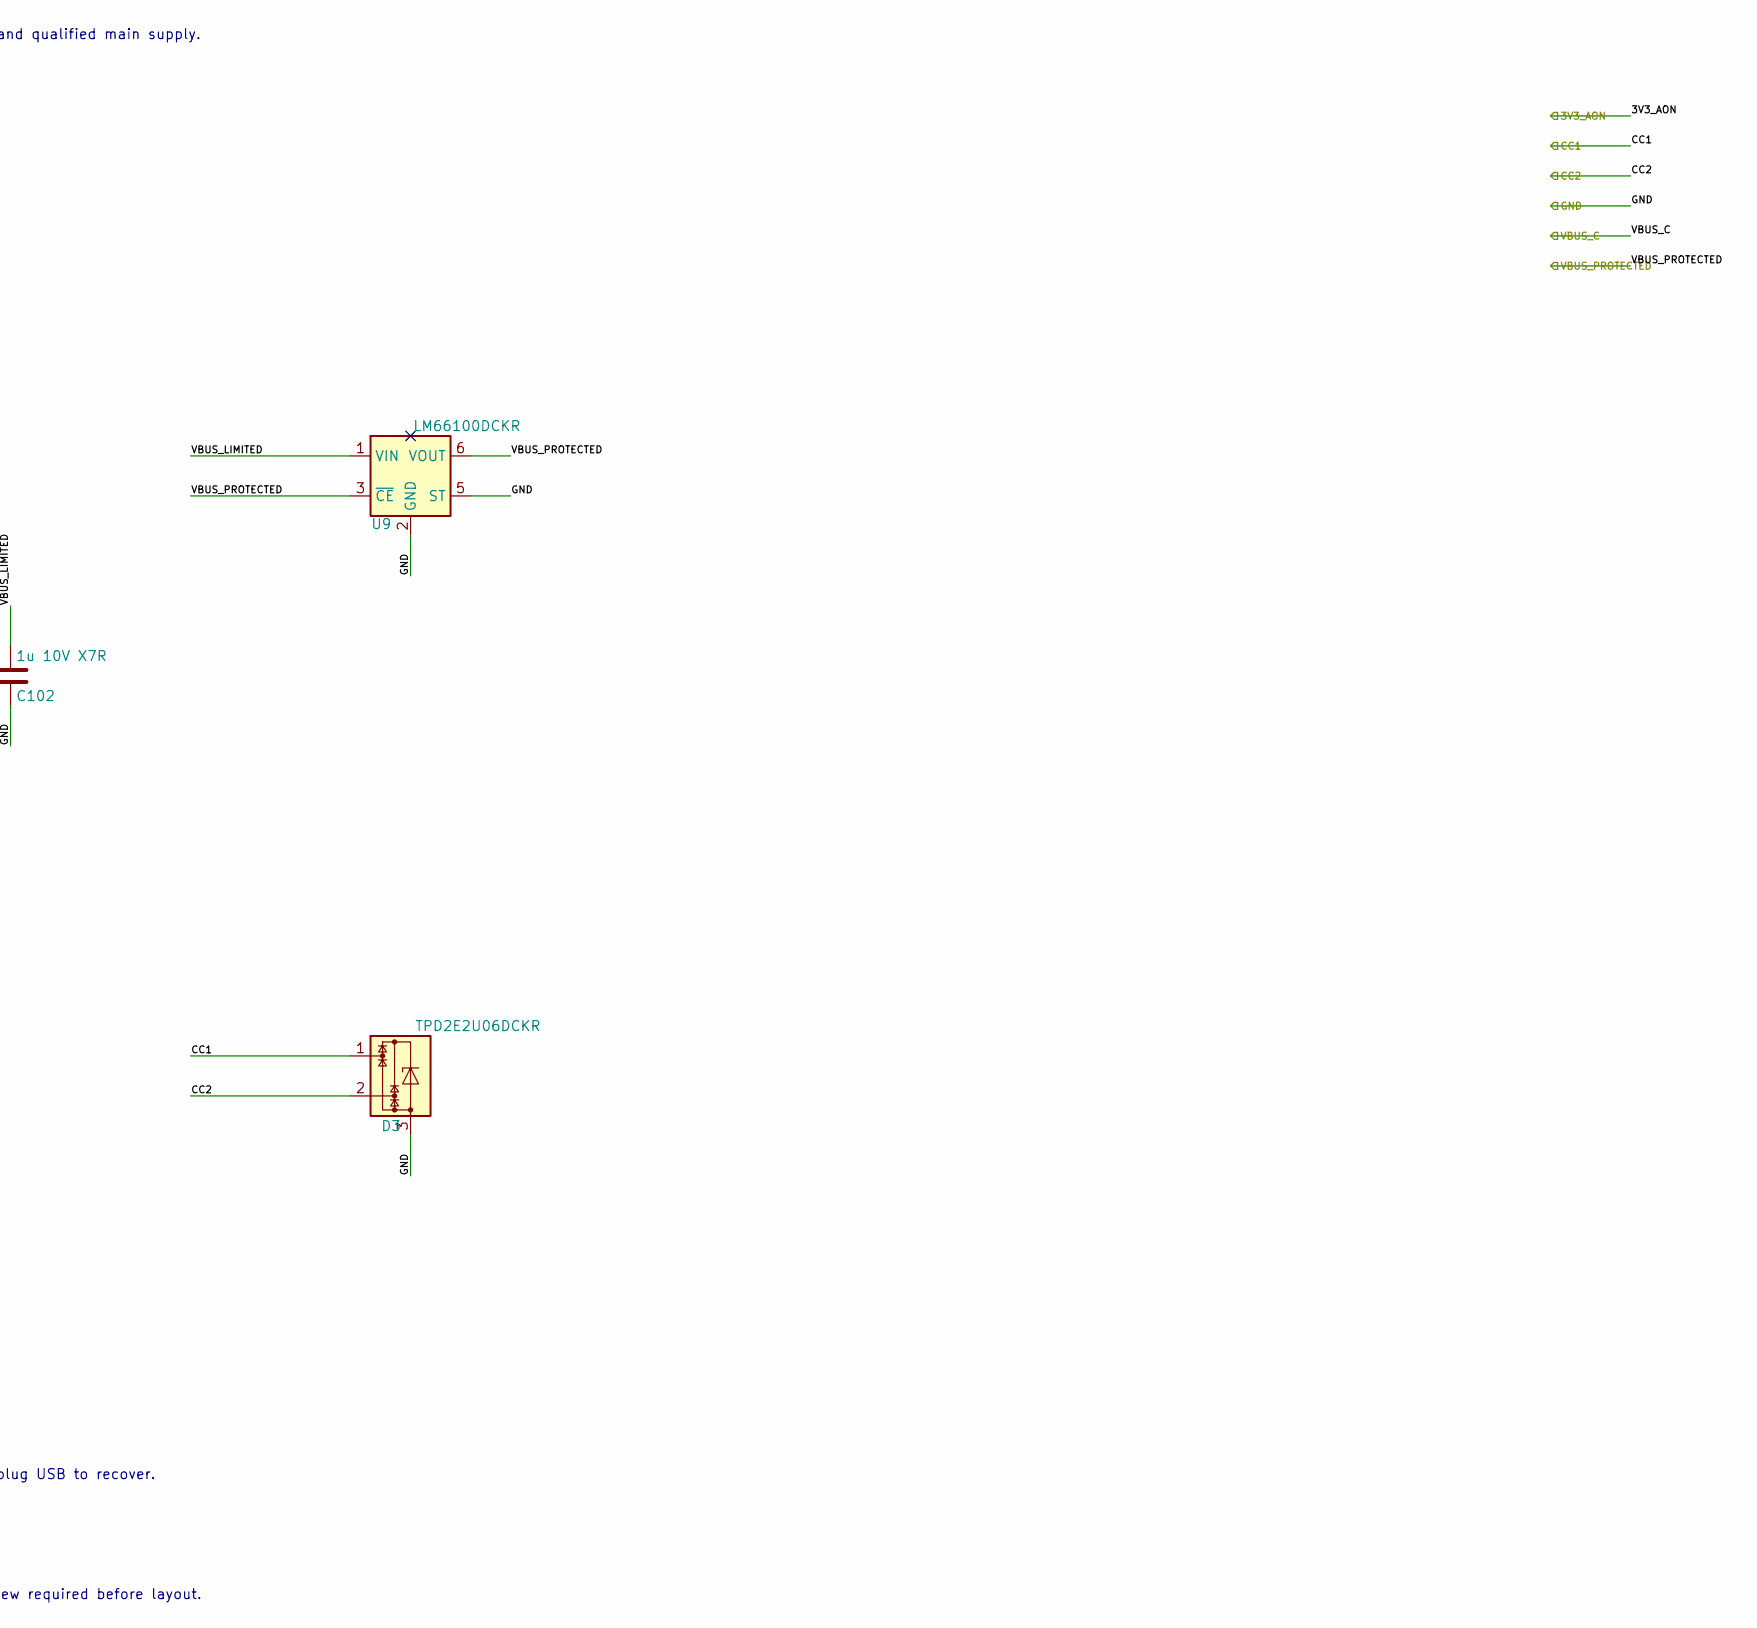
[picture p77: schematic input.kicad_sch, Protected USB input, part in row 1, column 2]

Parts:
C100: 1u 25V X7R; C_0603_1608Metric
C101: 10n 25V C0G; C_0805_2012Metric
C102: 1u 10V X7R; C_0603_1608Metric
D3: TPD2E2U06DCKR; SOT-323_SC-70
R100: 24.9k 0.1%; R_0603_1608Metric
R101, R103: 10k 0.1%; R_0603_1608Metric
R102: 37.4k 0.1%; R_0603_1608Metric
R104: 681R 0.1%; R_0603_1608Metric
R105: 100k; R_0603_1608Metric
U8: TPS259630DDAR; TI_SO-PowerPAD-8
U9: LM66100DCKR; SOT-363_SC-70-6

Connections:
/3V3_AON: R105.1; also elsewhere on the board
/CC1: D3.1; also elsewhere on the board
/CC2: D3.2; also elsewhere on the board
/Protected USB input/EFUSE_DVDT: C101.1, U8.2 (dV/dT)
/Protected USB input/EFUSE_FAULT_N: R105.2, U8.6 (~FLT)
/Protected USB input/EFUSE_ILM: R104.1, U8.7 (ILM)
/Protected USB input/EFUSE_OVLO: R102.2, R103.1, U8.8 (OVLO/OVCSEL)
/Protected USB input/EFUSE_UVLO: R100.2, R101.1, U8.3 (EN/UVLO)
/Protected USB input/VBUS_LIMITED: C102.1, U8.5 (OUT), U9.1 (VIN)

Notes on the sheet:
USB VBUS -> current/voltage protection -> reverse-blocking ideal diode -> AON and qualified main supply.
681R: nominal 1.337A limit. OVLO nominal 5.688V. Latch-off thermal fault: unplug USB to recover.
No Amiga supply connection. E-fuse pad/package and fast overvoltage transient review required before layout.

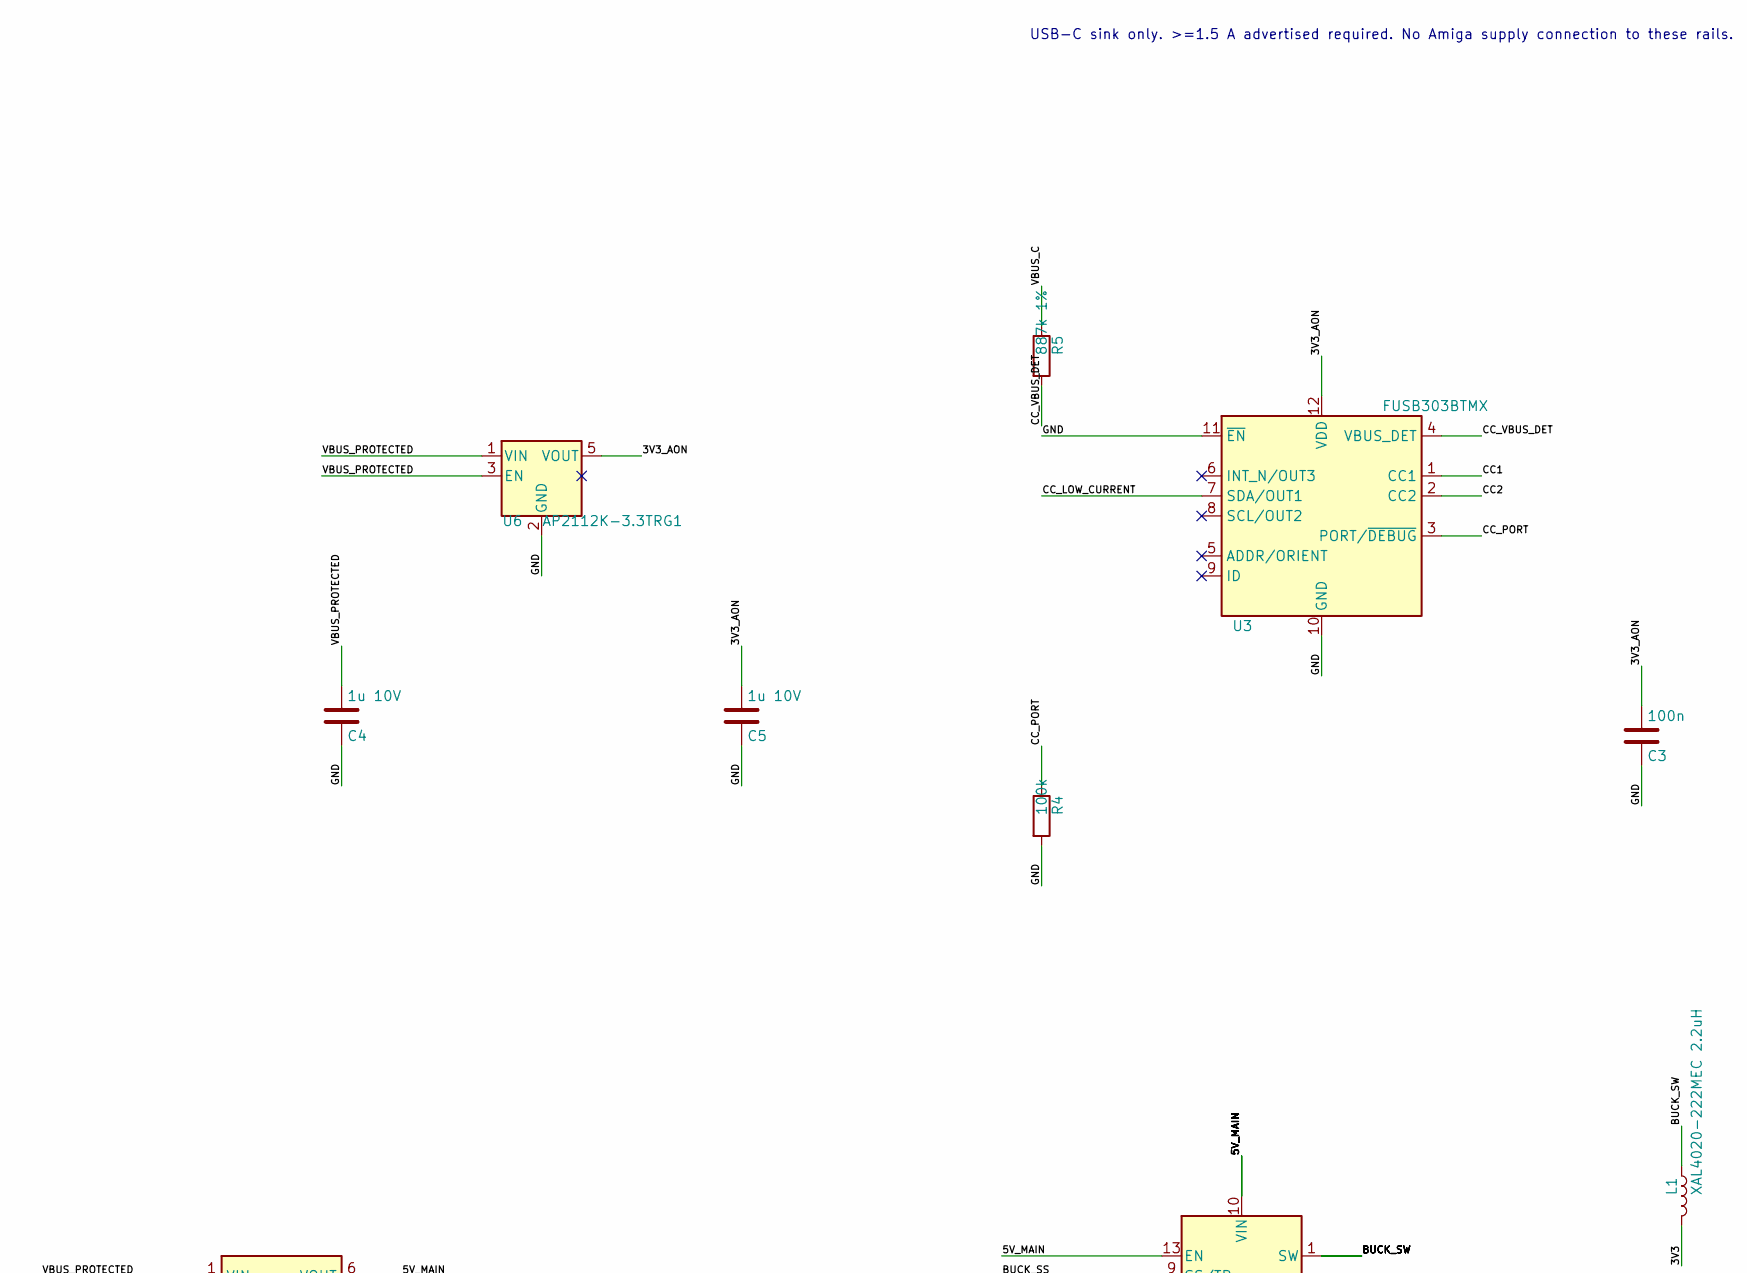
[picture p78: schematic power.kicad_sch, USB-C power and qualification, part in row 1, column 1]

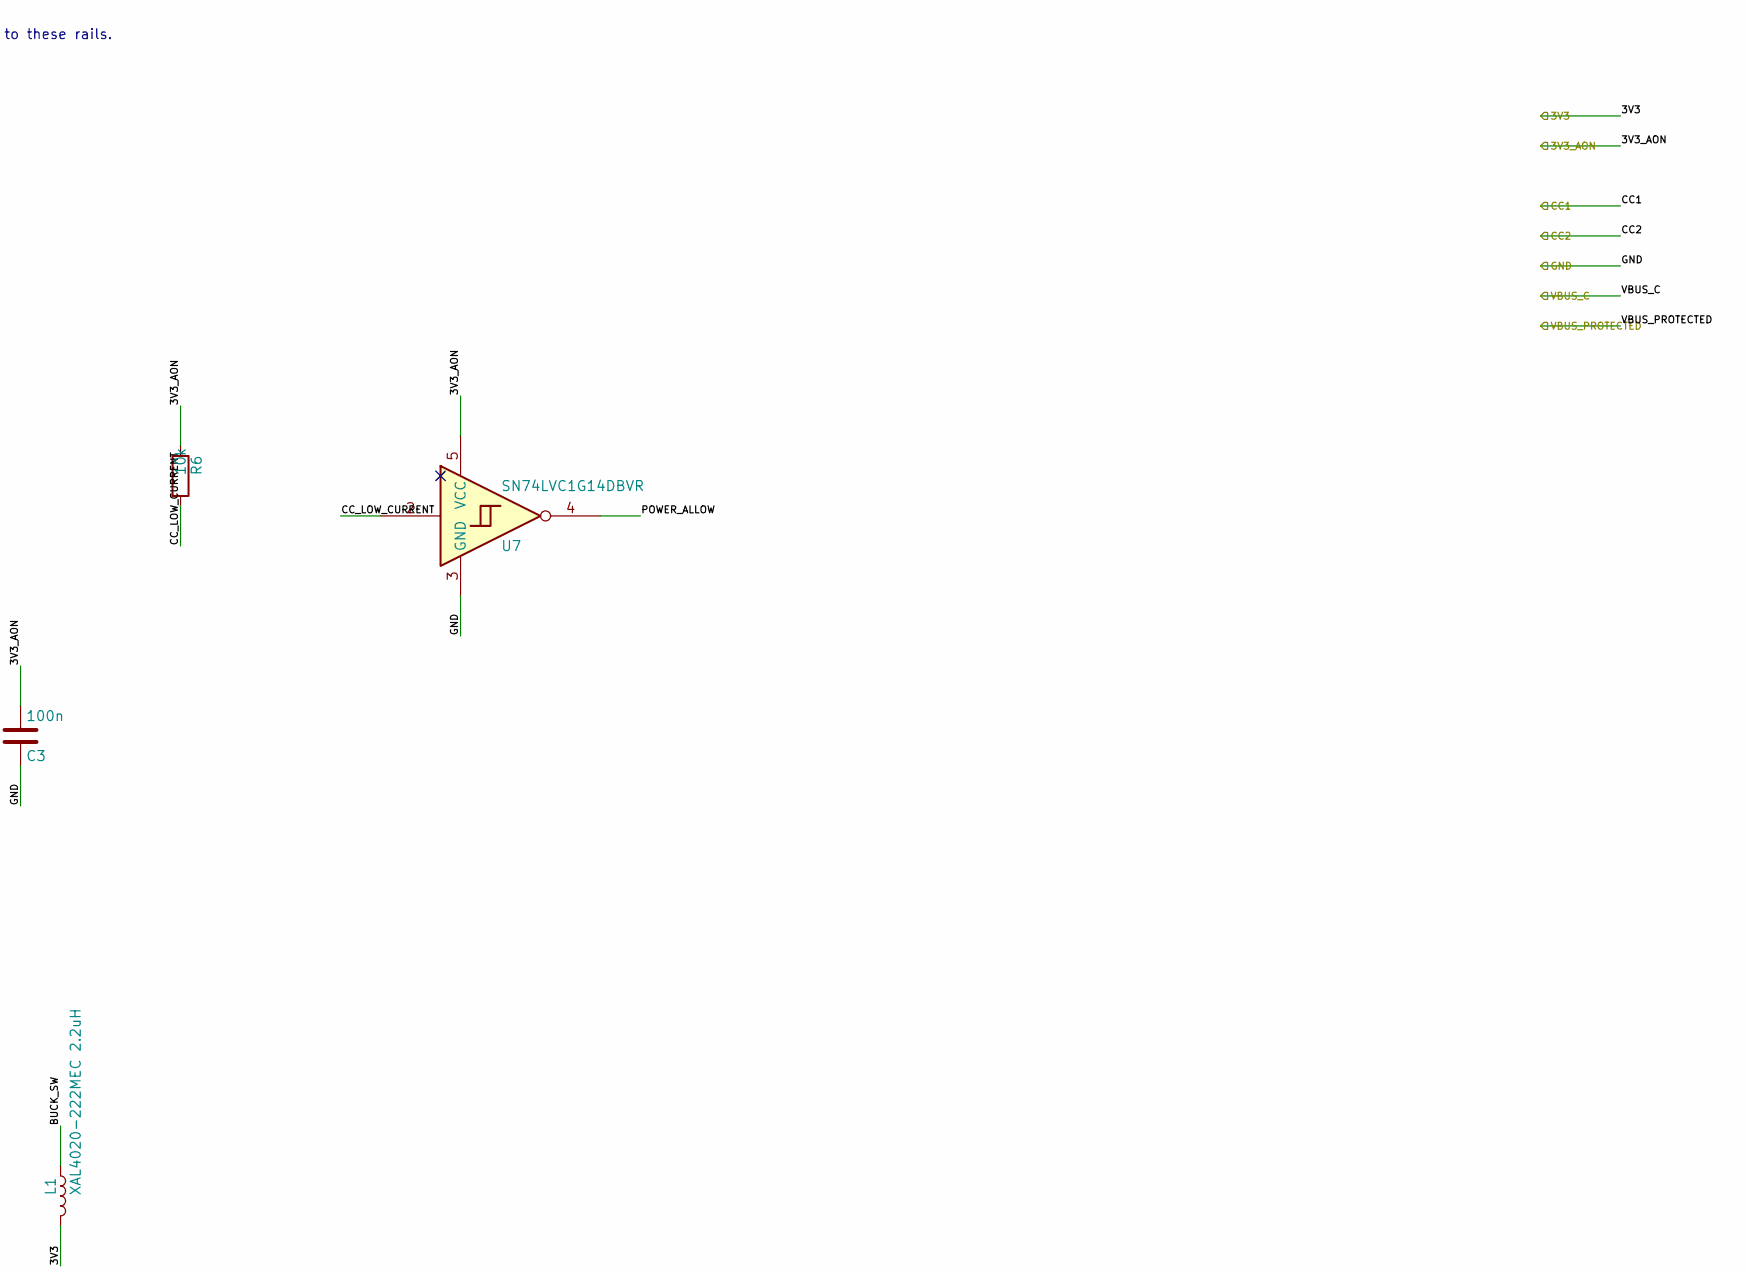
[picture p79: schematic power.kicad_sch, USB-C power and qualification, part in row 1, column 2]

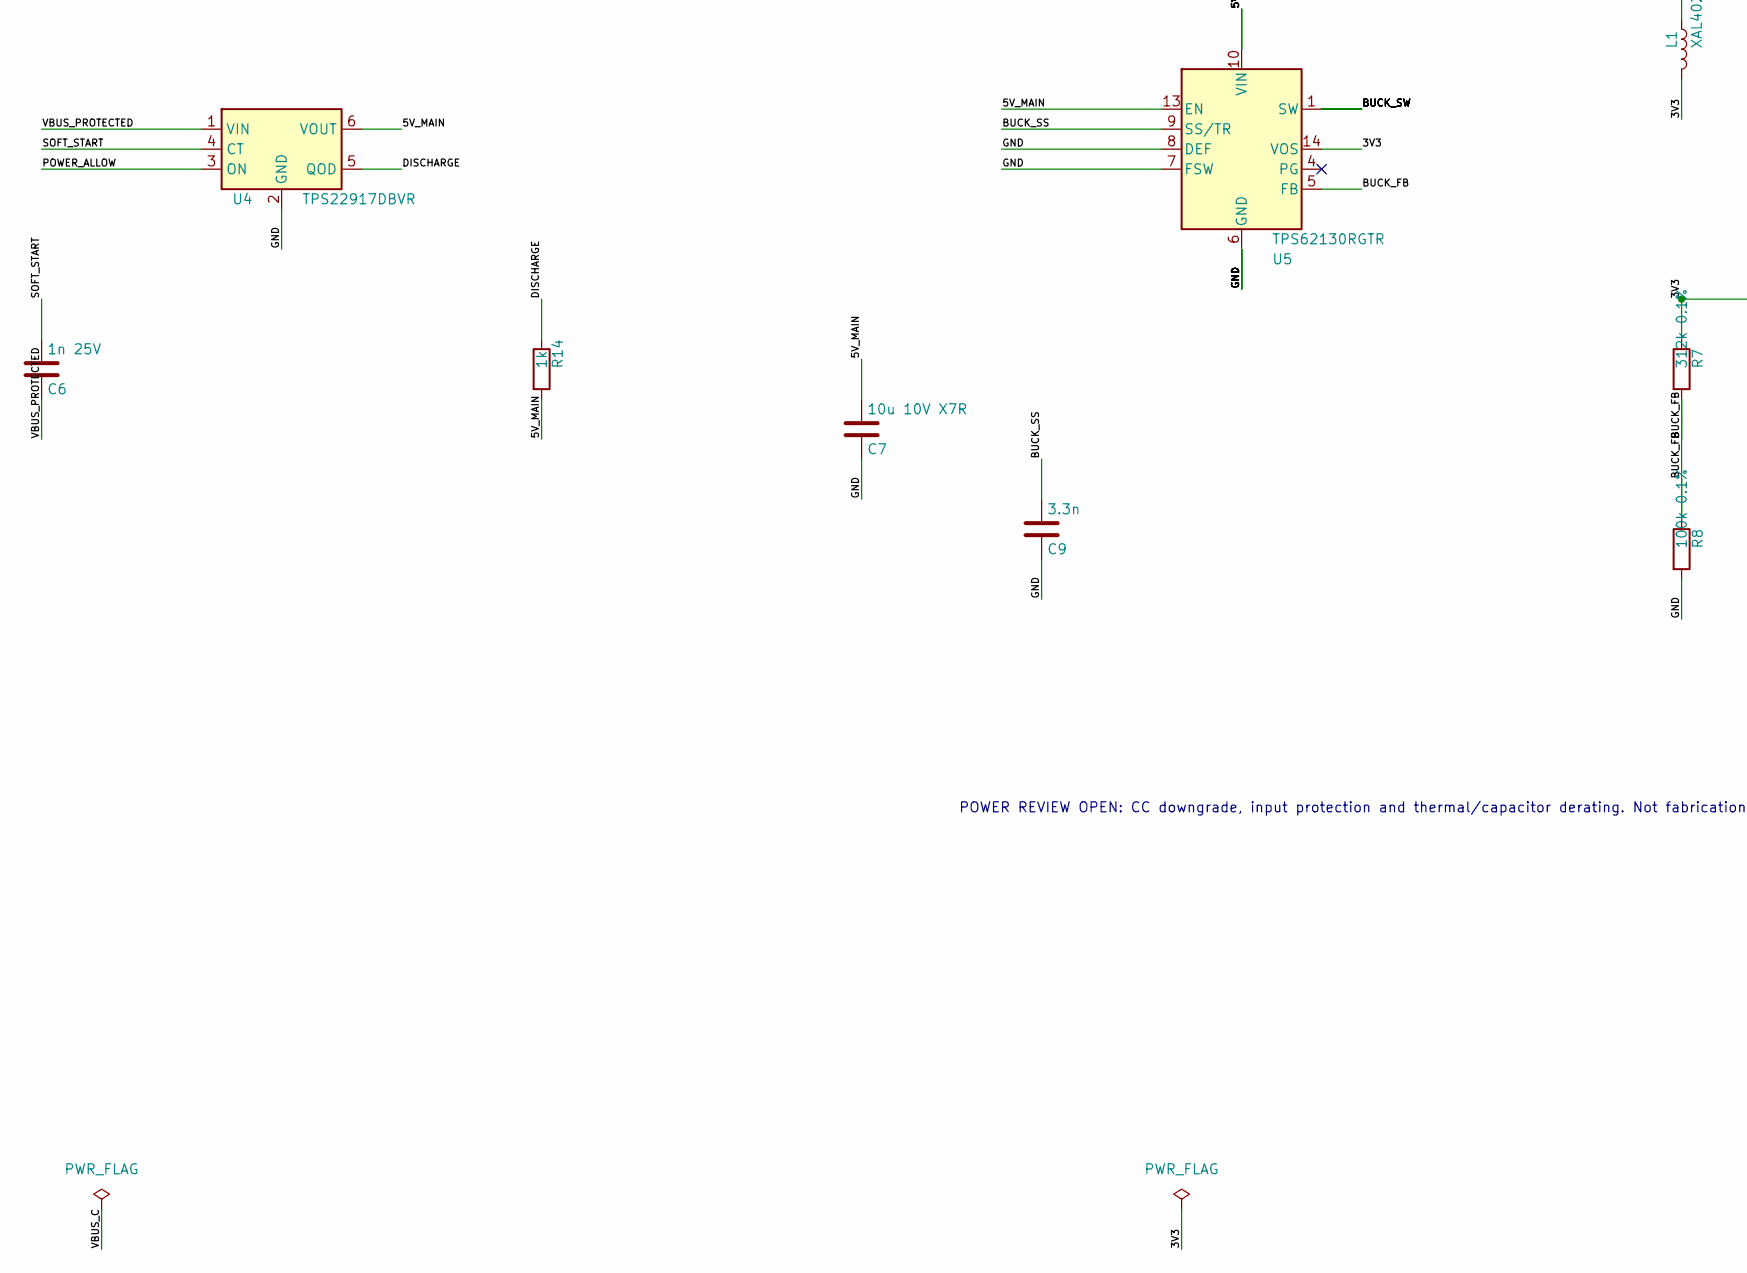
[picture p80: schematic power.kicad_sch, USB-C power and qualification, part in row 2, column 1]

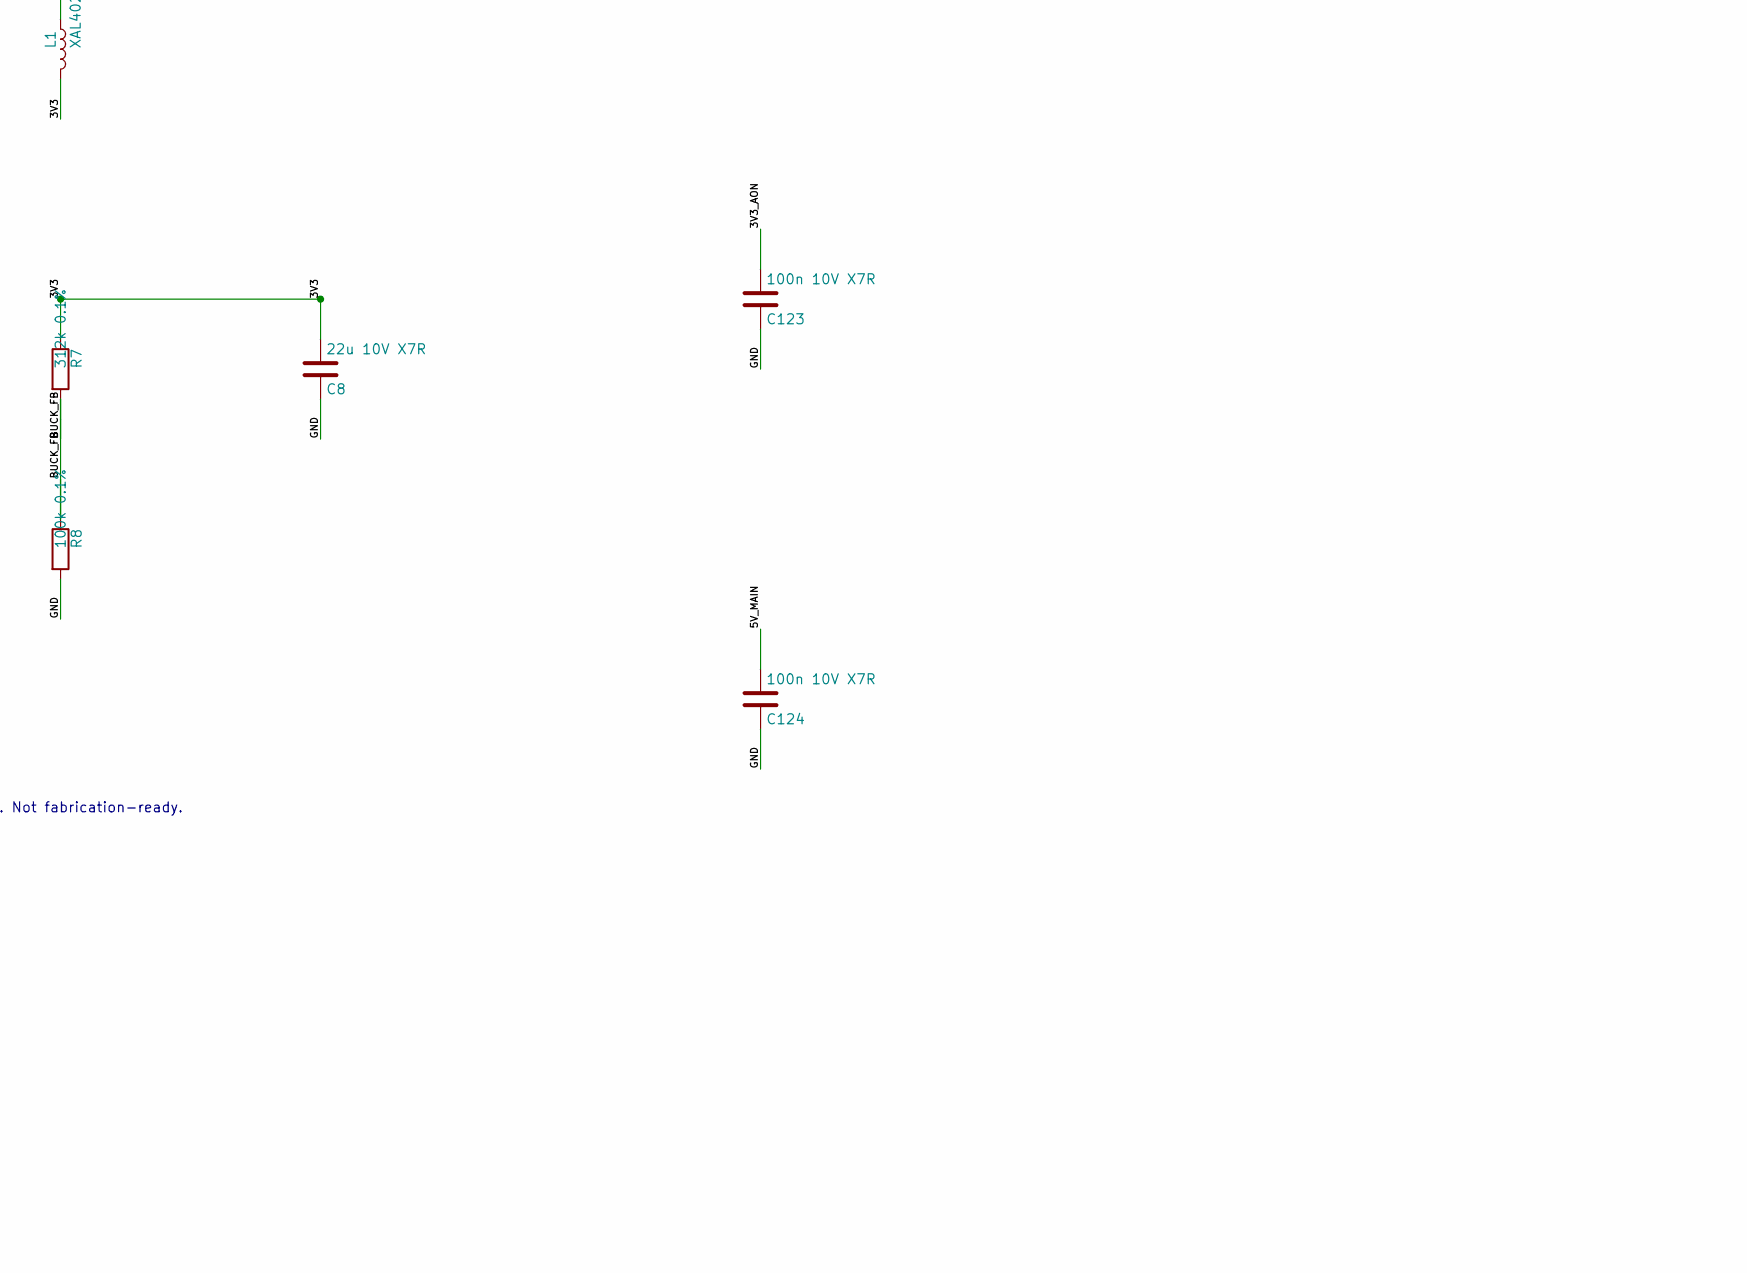
[picture p81: schematic power.kicad_sch, USB-C power and qualification, part in row 2, column 2]

Parts:
C3: 100n; C_0603_1608Metric
C4, C5: 1u 10V; C_0603_1608Metric
C6: 1n 25V; C_0603_1608Metric
C7: 10u 10V X7R; C_1206_3216Metric
C8: 22u 10V X7R; C_1206_3216Metric
C9: 3.3n; C_0603_1608Metric
C123, C124: 100n 10V X7R; C_0603_1608Metric
L1: XAL4020-222MEC 2.2uH; L_Coilcraft_XAL4020-XXX
R4: 100k; R_0603_1608Metric
R5: 887k 1%; R_0603_1608Metric
R6: 10k; R_0603_1608Metric
R7: 312k 0.1%; R_0603_1608Metric
R8: 100k 0.1%; R_0603_1608Metric
R14: 1k; R_0603_1608Metric
U3: FUSB303BTMX; Texas_X2QFN-12_1.6x1.6mm_P0.4mm
U4: TPS22917DBVR; SOT-23-6
U5: TPS62130RGTR; VQFN-16-1EP_3x3mm_P0.5mm_EP1.68x1.68mm_ThermalVias
U6: AP2112K-3.3TRG1; SOT-23-5
U7: SN74LVC1G14DBVR; SOT-23-5

Connections:
/3V3: C8.1, L1.2, R7.1, U5.14 (VOS); also elsewhere on the board
/3V3_AON: C3.1, C5.1, C123.1, R6.1, U3.12 (VDD), U6.5 (VOUT), U7.5 (VCC); also elsewhere on the board
/CC1: U3.1 (CC1); also elsewhere on the board
/CC2: U3.2 (CC2); also elsewhere on the board
/USB-C power and qualification/5V_MAIN: C7.1, C124.1, R14.2, U4.6 (VOUT), U5.10 (VIN), U5.11 (VIN), U5.12 (VIN), U5.13 (EN)
/USB-C power and qualification/BUCK_FB: R7.2, R8.1, U5.5 (FB)
/USB-C power and qualification/BUCK_SS: C9.1, U5.9 (SS/TR)
/USB-C power and qualification/BUCK_SW: L1.1, U5.1 (SW), U5.2 (SW), U5.3 (SW)
/USB-C power and qualification/CC_LOW_CURRENT: R6.2, U3.7 (SDA/OUT1), U7.2
/USB-C power and qualification/CC_PORT: R4.1, U3.3 (PORT/~DEBUG)
/USB-C power and qualification/CC_VBUS_DET: R5.2, U3.4 (VBUS_DET)
/USB-C power and qualification/DISCHARGE: R14.1, U4.5 (QOD)
/USB-C power and qualification/POWER_ALLOW: U4.3 (ON), U7.4
/USB-C power and qualification/SOFT_START: C6.1, U4.4 (CT)

Notes on the sheet:
USB-C sink only. >=1.5 A advertised required. No Amiga supply connection to these rails.
POWER REVIEW OPEN: CC downgrade, input protection and thermal/capacitor derating. Not fabrication-ready.
