markjfisher/fujinet-nio-hardware/amiga/integrated-a500-r4/integrated-a500-r4.kicad_pcb

## KiCad design amiga/integrated-a500-r4/integrated-a500-r4.kicad_pcb (continued)

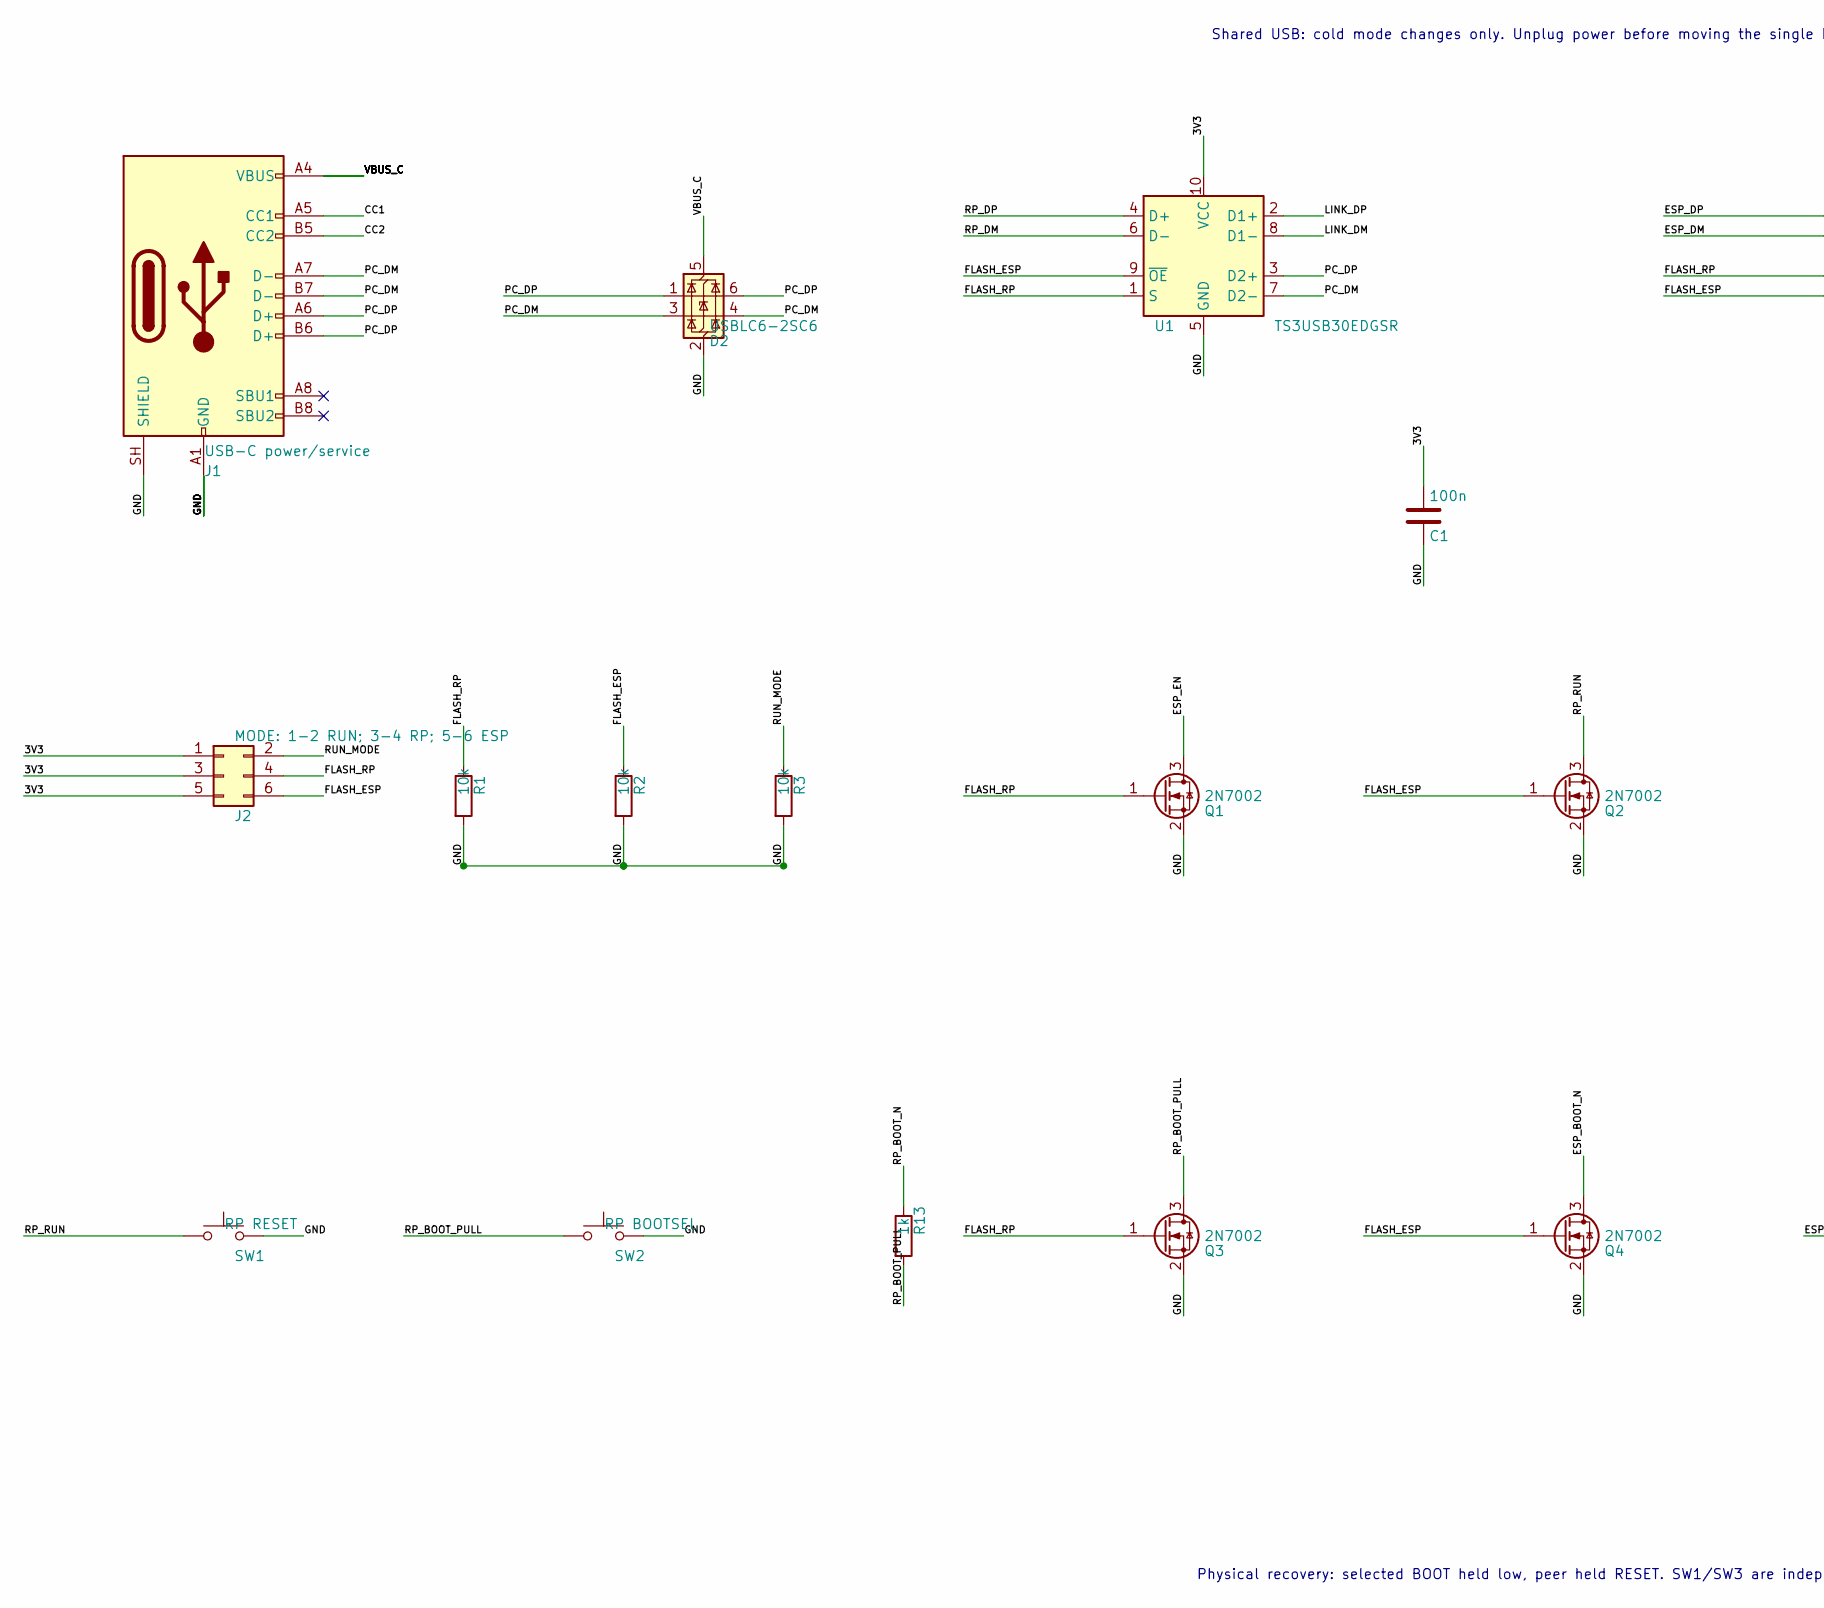
[picture p82: schematic usb.kicad_sch, USB routing and physical recovery, part in row 1, column 1]

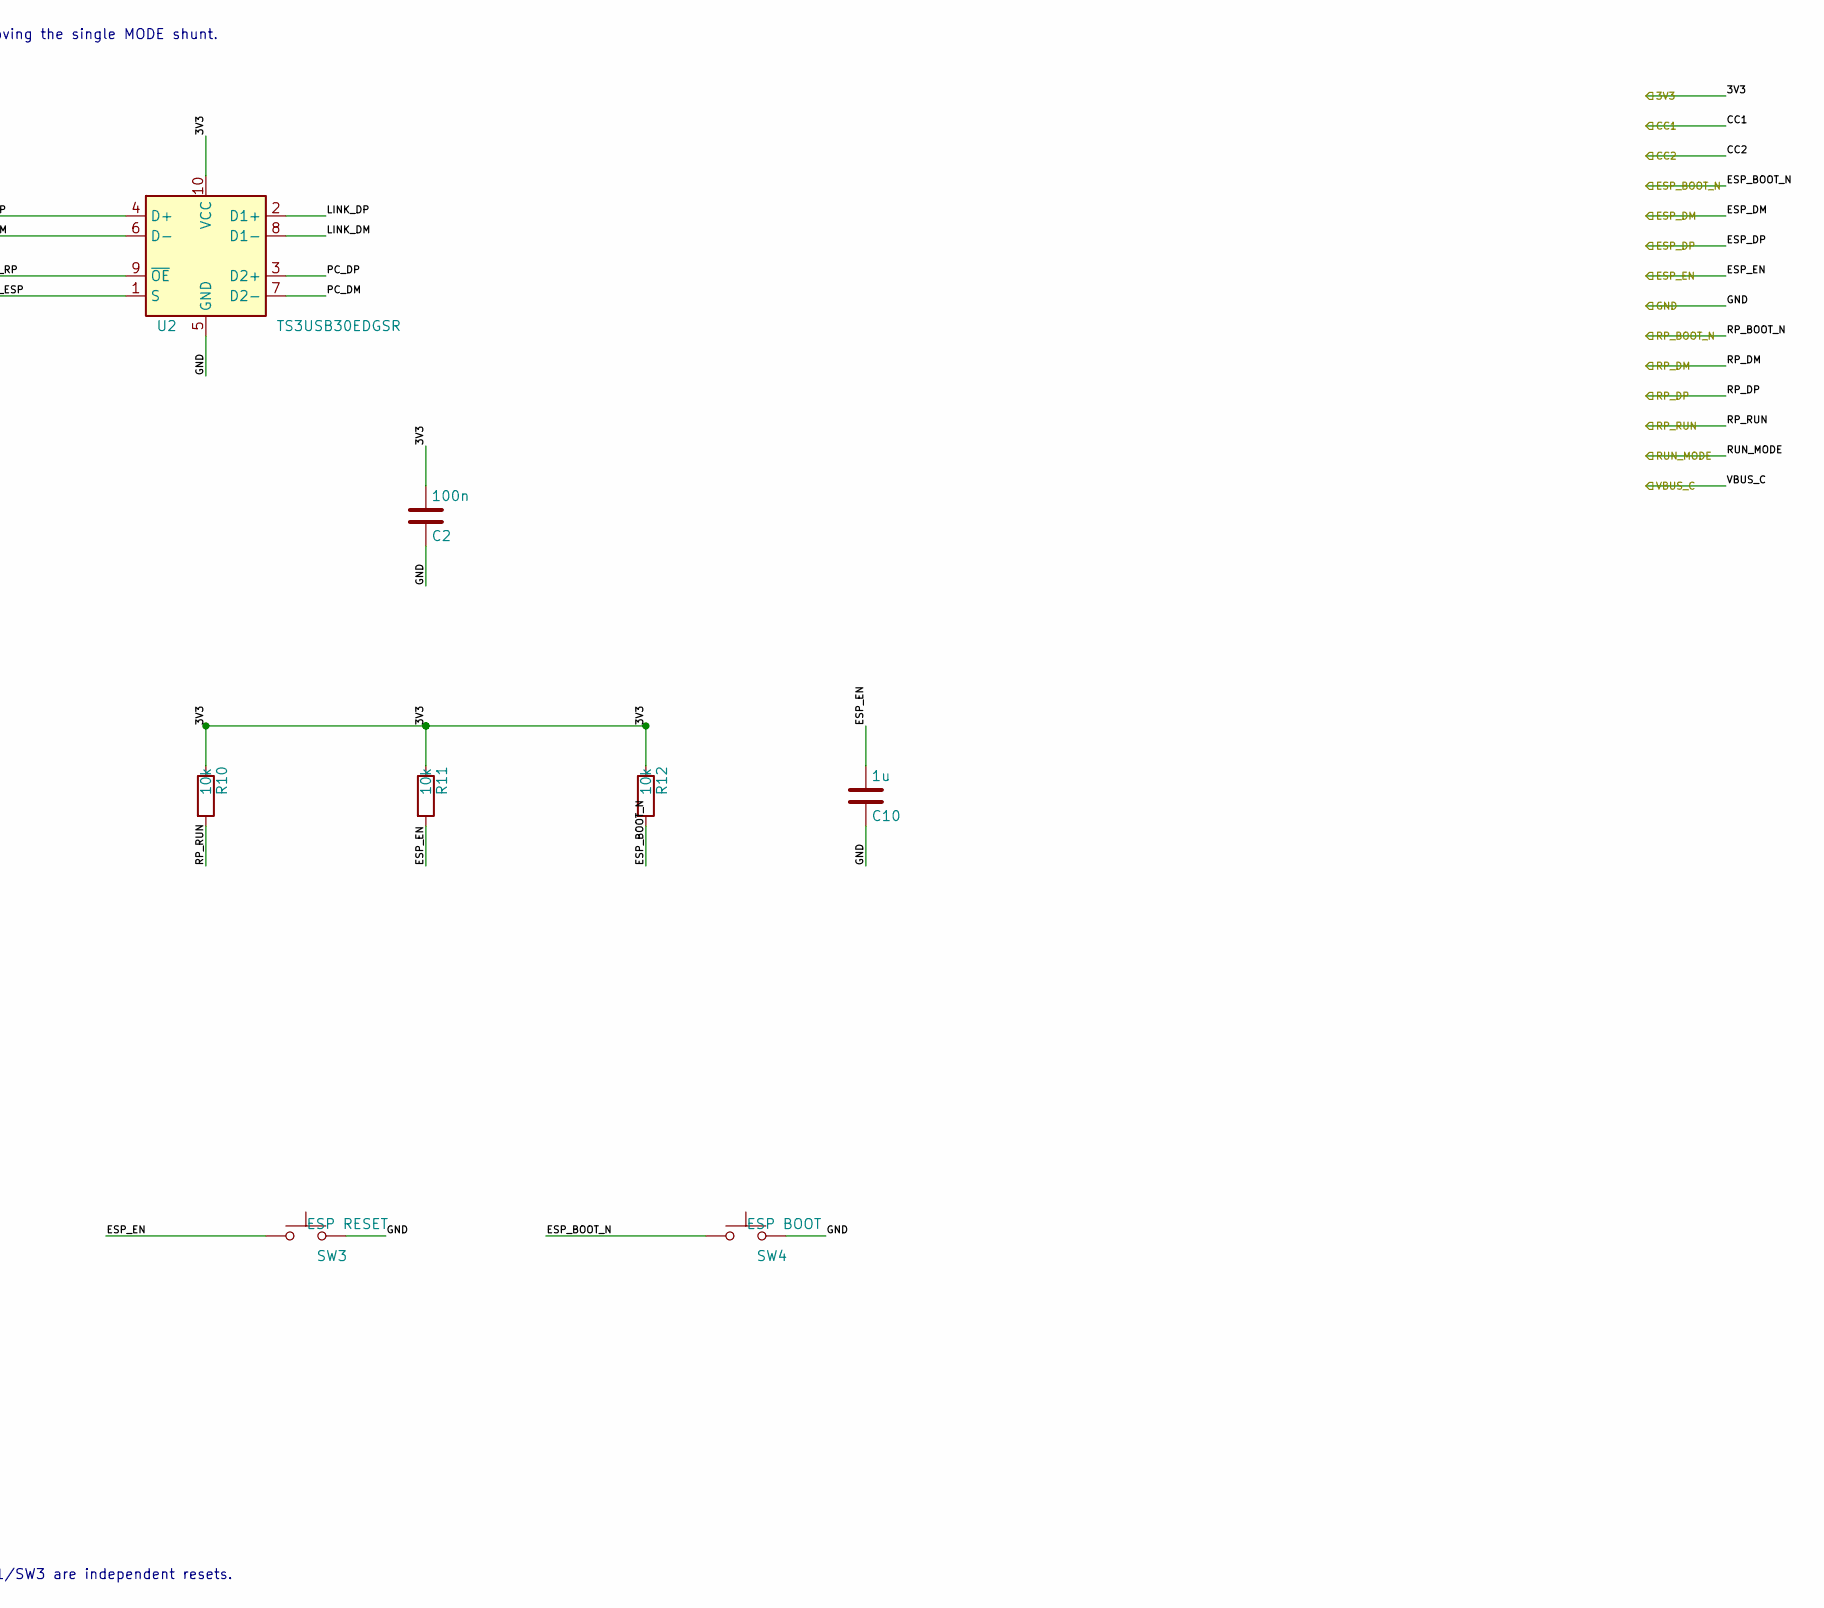
[picture p83: schematic usb.kicad_sch, USB routing and physical recovery, part in row 1, column 2]

Parts:
C1, C2: 100n; C_0603_1608Metric
C10: 1u; C_0603_1608Metric
D2: USBLC6-2SC6
J1: USB-C power/service
J2: MODE: 1-2 RUN; 3-4 RP; 5-6 ESP
Q1, Q2, Q3, Q4: 2N7002
R1, R2, R3, R10, R11, R12: 10k; R_0603_1608Metric
R13: 1k; R_0603_1608Metric
SW1: RP RESET
SW2: RP BOOTSEL
SW3: ESP RESET
SW4: ESP BOOT
U1, U2: TS3USB30EDGSR

Connections:
/3V3: C1.1, C2.1, J2.1, J2.3, J2.5, R10.1, R11.1, R12.1, U1.10 (VCC), U2.10 (VCC); also elsewhere on the board
/CC1: J1.A5 (CC1); also elsewhere on the board
/CC2: J1.B5 (CC2); also elsewhere on the board
/ESP_BOOT_N: Q4.3 (D), R12.2, SW4.1; also elsewhere on the board
/ESP_DM: U2.6 (D-); also elsewhere on the board
/ESP_DP: U2.4 (D+); also elsewhere on the board
/ESP_EN: C10.1, Q1.3 (D), R11.2, SW3.1; also elsewhere on the board
/RP_BOOT_N: R13.1; also elsewhere on the board
/RP_DM: U1.6 (D-); also elsewhere on the board
/RP_DP: U1.4 (D+); also elsewhere on the board
/RP_RUN: Q2.3 (D), R10.2, SW1.1; also elsewhere on the board
/RUN_MODE: J2.2, R3.1; also elsewhere on the board
/USB routing and physical recovery/FLASH_ESP: J2.6, Q2.1 (G), Q4.1 (G), R2.1, U1.9 (~OE), U2.1 (S)
/USB routing and physical recovery/FLASH_RP: J2.4, Q1.1 (G), Q3.1 (G), R1.1, U1.1 (S), U2.9 (~OE)
/USB routing and physical recovery/LINK_DM: U1.8 (D1-), U2.8 (D1-)
/USB routing and physical recovery/LINK_DP: U1.2 (D1+), U2.2 (D1+)
/USB routing and physical recovery/PC_DM: D2.3 (I/O2), D2.4 (I/O2), J1.A7 (D-), J1.B7 (D-), U1.7 (D2-), U2.7 (D2-)
/USB routing and physical recovery/PC_DP: D2.1 (I/O1), D2.6 (I/O1), J1.A6 (D+), J1.B6 (D+), U1.3 (D2+), U2.3 (D2+)
/USB routing and physical recovery/RP_BOOT_PULL: Q3.3 (D), R13.2, SW2.1

Notes on the sheet:
Shared USB: cold mode changes only. Unplug power before moving the single MODE shunt.
Physical recovery: selected BOOT held low, peer held RESET. SW1/SW3 are independent resets.

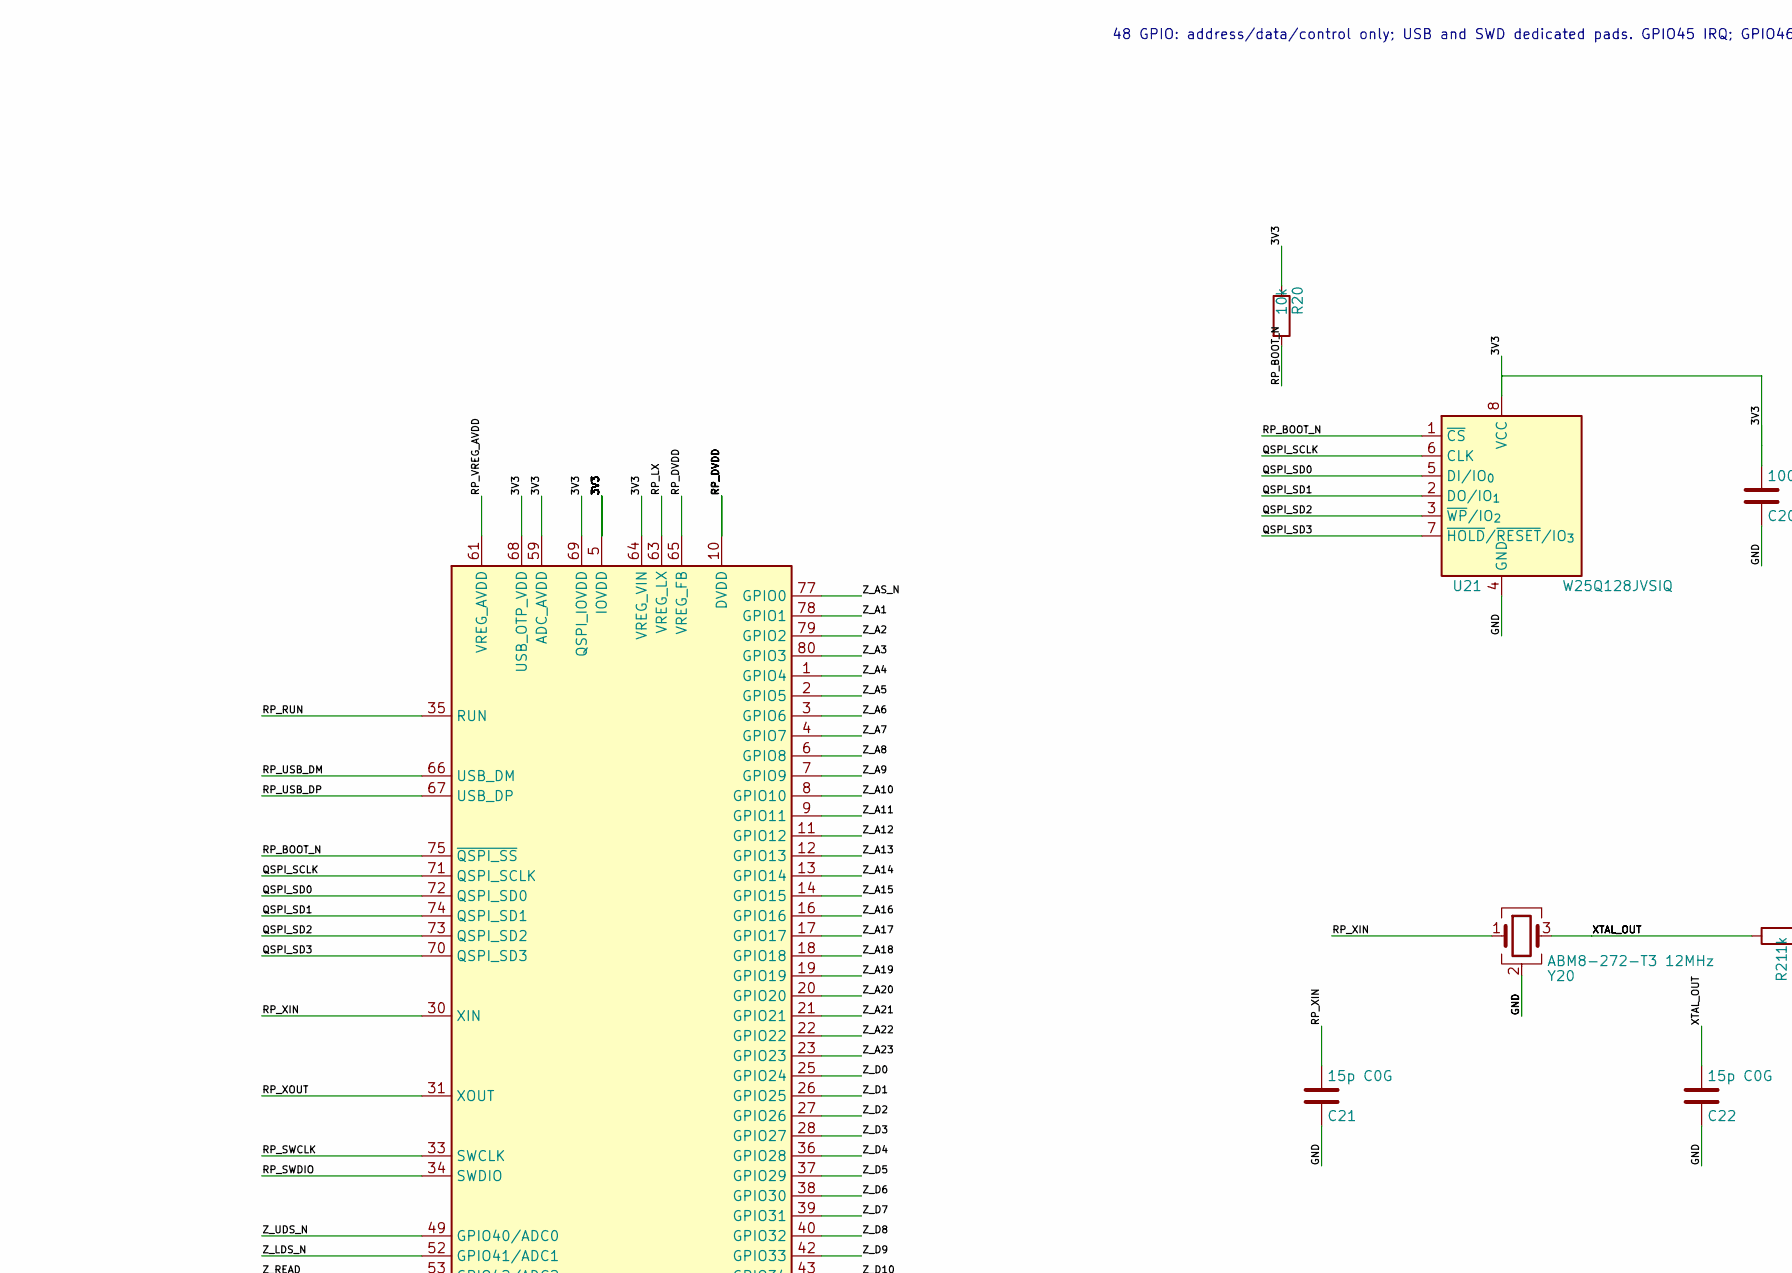
[picture p84: schematic rp.kicad_sch, RP2350B and support, part in row 1, column 1]

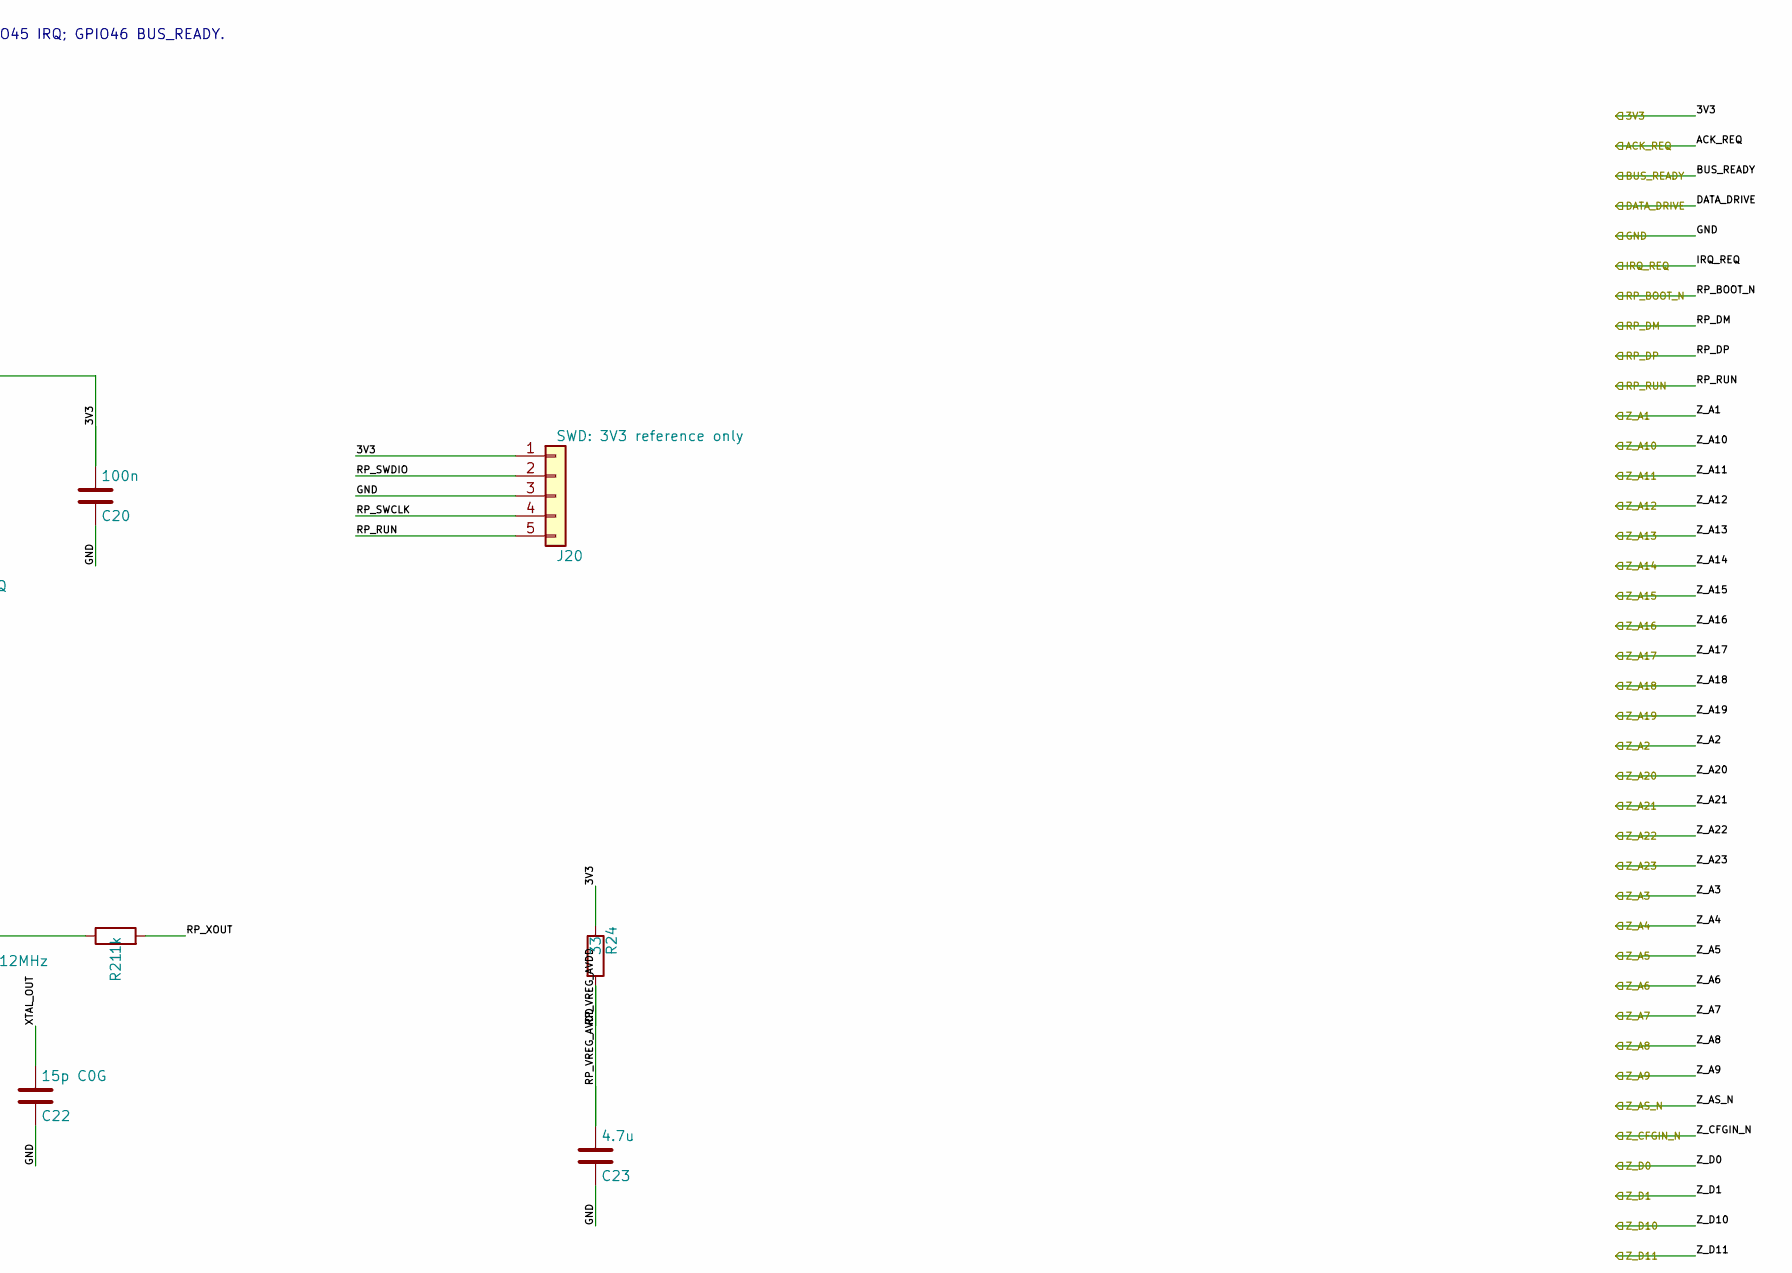
[picture p85: schematic rp.kicad_sch, RP2350B and support, part in row 1, column 2]

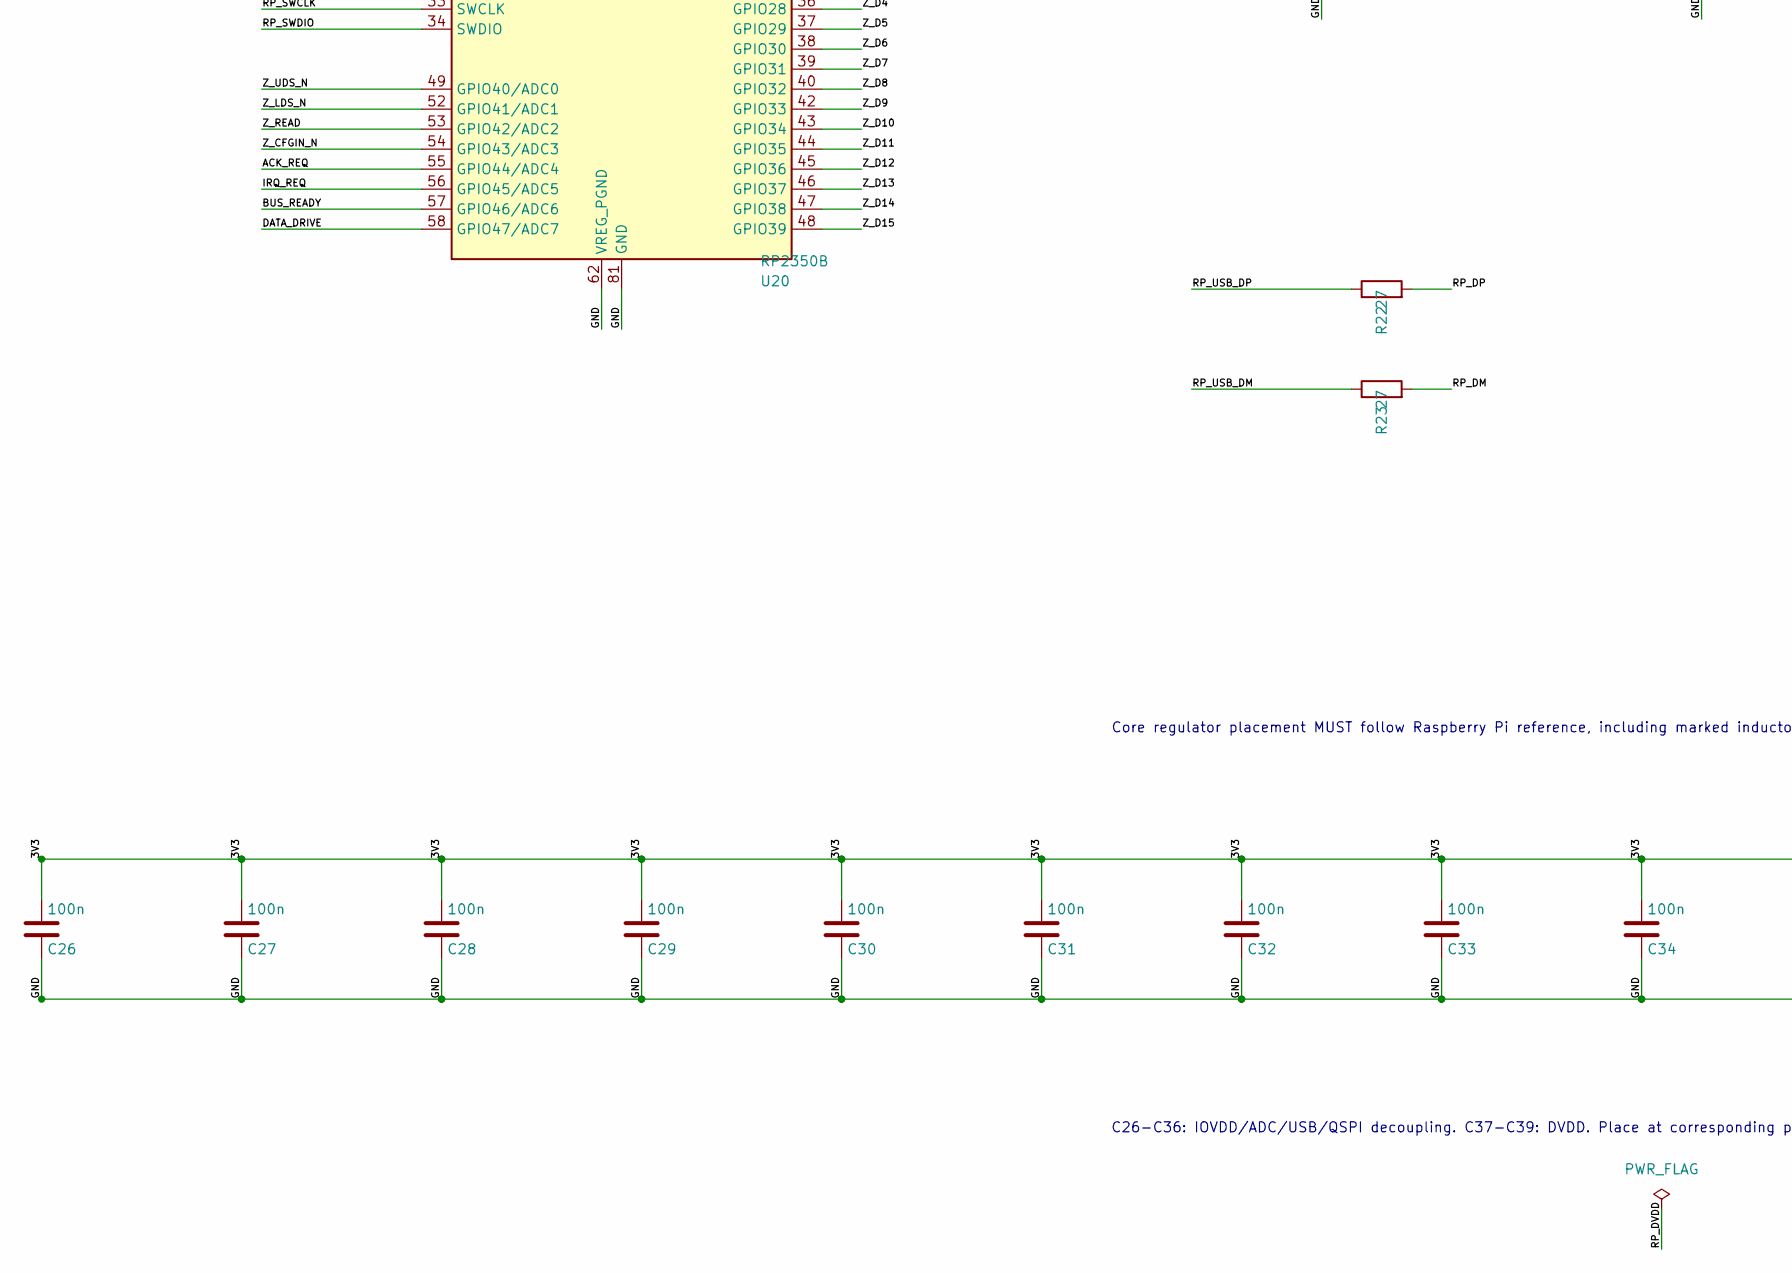
[picture p86: schematic rp.kicad_sch, RP2350B and support, part in row 2, column 1]

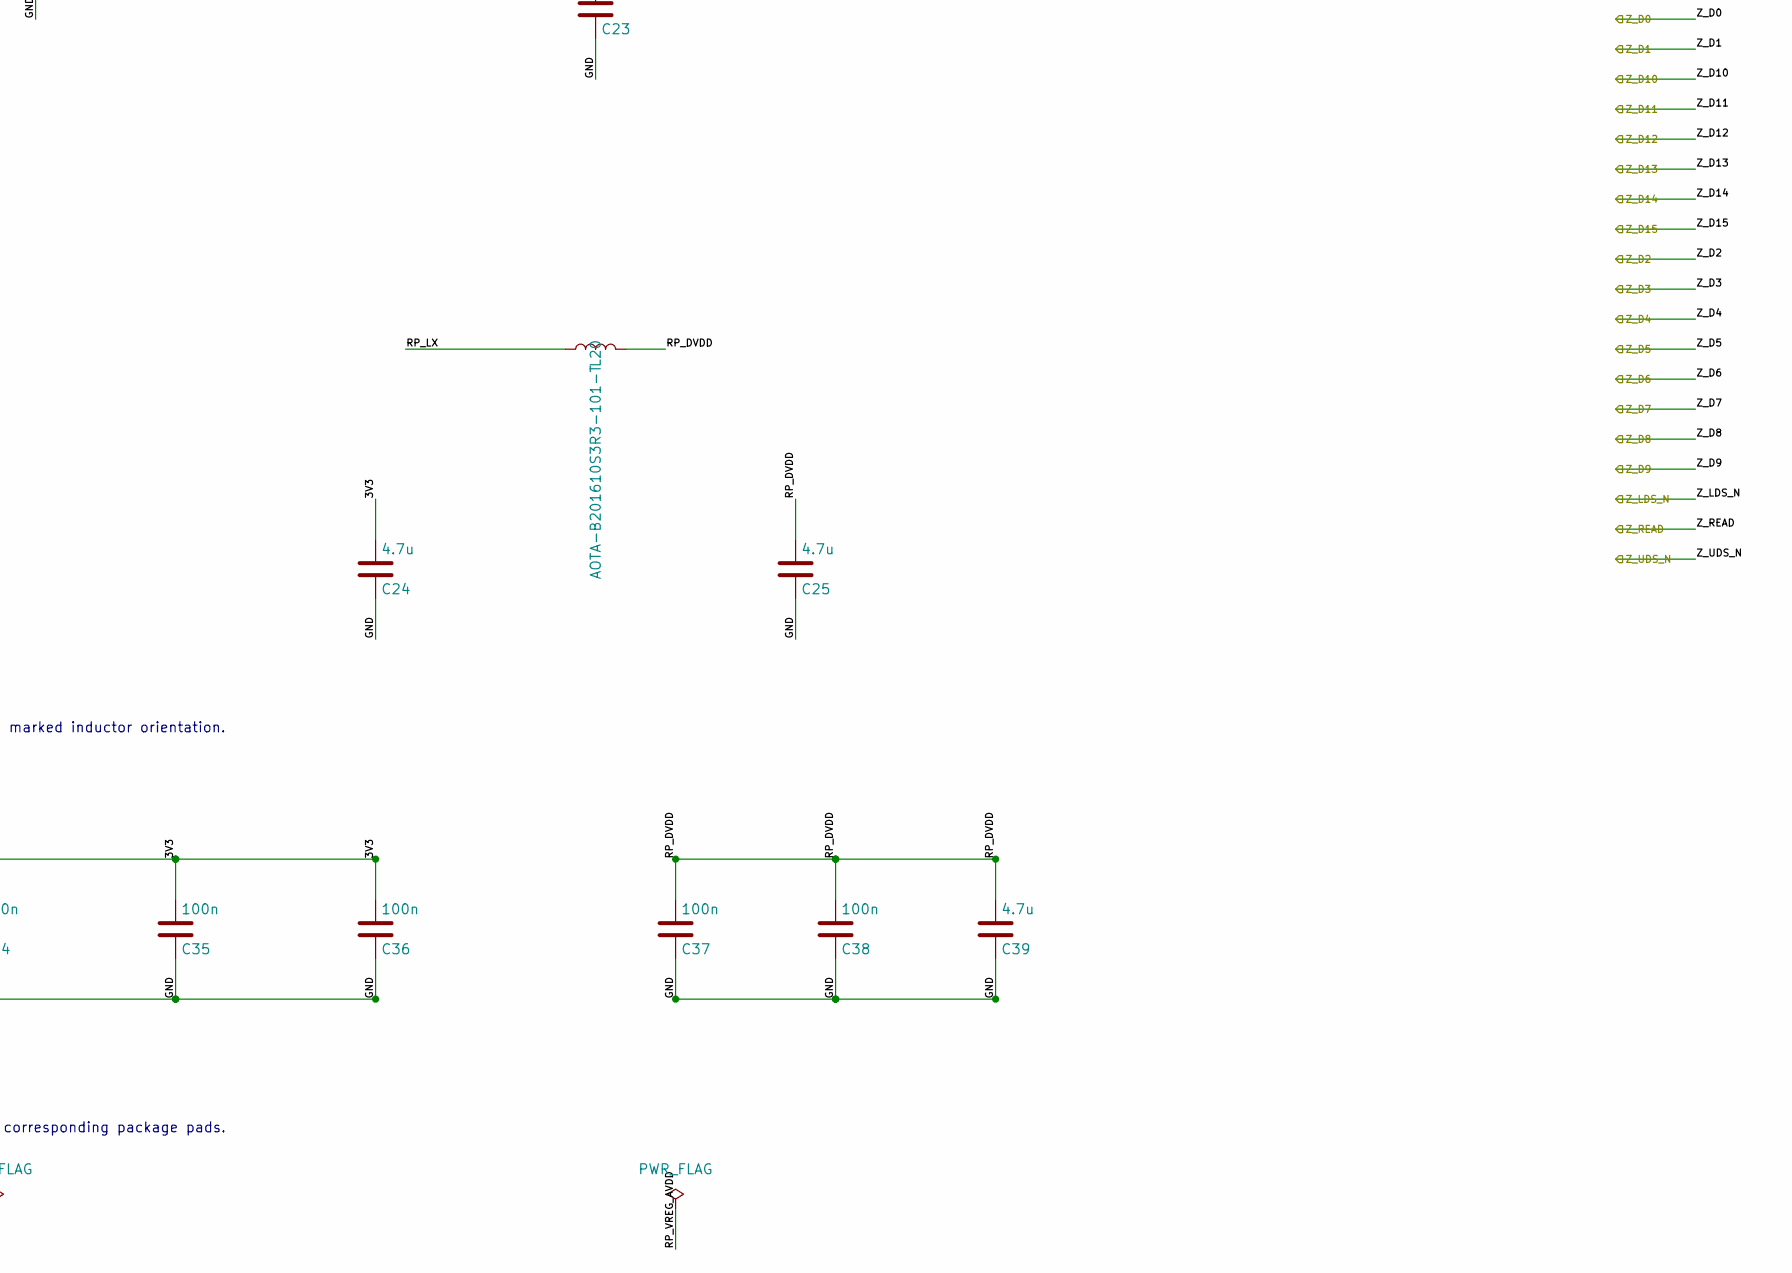
[picture p87: schematic rp.kicad_sch, RP2350B and support, part in row 2, column 2]

Parts:
C20, C26, C27, C28, C29, C30, C31, C32, C33, C34, C35, C36, C37, C38: 100n; C_0603_1608Metric
C21, C22: 15p C0G; C_0603_1608Metric
C23: 4.7u; RP_Reference_C9
C24: 4.7u; RP_Reference_C6
C25: 4.7u; RP_Reference_C7
C39: 4.7u; C_0603_1608Metric
J20: SWD: 3V3 reference only; PinHeader_1x05_P2.54mm_Vertical
L20: AOTA-B201610S3R3-101-T; RP_Reference_L1
R20: 10k; R_0603_1608Metric
R21: 1k; R_0603_1608Metric
R22, R23: 27; R_0603_1608Metric
R24: 33; RP_Reference_R3
U20: RP2350B; RP_Reference_U1
U21: W25Q128JVSIQ; SOIC-8_5.3x5.3mm_P1.27mm
Y20: ABM8-272-T3 12MHz; Crystal_SMD_3225-4Pin_3.2x2.5mm

Connections:
/3V3: C20.1, C24.1, C26.1, C27.1, C28.1, C29.1, C30.1, C31.1, C32.1, C33.1, C34.1, C35.1, C36.1, J20.1, R20.1, R24.1, U20.5 (IOVDD), U20.15 (IOVDD), U20.24 (IOVDD), U20.29 (IOVDD), U20.41 (IOVDD), U20.50 (IOVDD), U20.59 (ADC_AVDD), U20.60 (IOVDD), U20.64 (VREG_VIN), U20.68 (USB_OTP_VDD), U20.69 (QSPI_IOVDD), U20.76 (IOVDD), U21.8 (VCC); also elsewhere on the board
/ACK_REQ: U20.55 (GPIO44/ADC4); also elsewhere on the board
/BUS_READY: U20.57 (GPIO46/ADC6); also elsewhere on the board
/IRQ_REQ: U20.56 (GPIO45/ADC5); also elsewhere on the board
/RP2350B and support/QSPI_SCLK: U20.71 (QSPI_SCLK), U21.6 (CLK)
/RP2350B and support/QSPI_SD0: U20.72 (QSPI_SD0), U21.5 (DI/IO_{0})
/RP2350B and support/QSPI_SD1: U20.74 (QSPI_SD1), U21.2 (DO/IO_{1})
/RP2350B and support/QSPI_SD2: U20.73 (QSPI_SD2), U21.3 (~WP/IO_{2})
/RP2350B and support/QSPI_SD3: U20.70 (QSPI_SD3), U21.7 (~HOLD/~RESET/IO_{3})
/RP2350B and support/RP_DVDD: C25.1, C37.1, C38.1, C39.1, L20.2, U20.10 (DVDD), U20.32 (DVDD), U20.51 (DVDD), U20.65 (VREG_FB)
/RP2350B and support/RP_LX: L20.1, U20.63 (VREG_LX)
/RP2350B and support/RP_SWCLK: J20.4, U20.33 (SWCLK)
/RP2350B and support/RP_SWDIO: J20.2, U20.34 (SWDIO)
/RP2350B and support/RP_USB_DM: R23.1, U20.66 (USB_DM)
/RP2350B and support/RP_USB_DP: R22.1, U20.67 (USB_DP)
/RP2350B and support/RP_VREG_AVDD: C23.1, R24.2, U20.61 (VREG_AVDD)
/RP2350B and support/RP_XIN: C21.1, U20.30 (XIN), Y20.1
/RP2350B and support/RP_XOUT: R21.2, U20.31 (XOUT)
/RP2350B and support/XTAL_OUT: C22.1, R21.1, Y20.3
/RP_BOOT_N: R20.2, U20.75 (~QSPI_SS), U21.1 (~CS); also elsewhere on the board
/RP_DM: R23.2; also elsewhere on the board
/RP_DP: R22.2; also elsewhere on the board
/RP_RUN: J20.5, U20.35 (RUN); also elsewhere on the board
/Z_A1: U20.78 (GPIO1); also elsewhere on the board
/Z_A2: U20.79 (GPIO2); also elsewhere on the board
/Z_A3: U20.80 (GPIO3); also elsewhere on the board
/Z_A4: U20.1 (GPIO4); also elsewhere on the board
/Z_A5: U20.2 (GPIO5); also elsewhere on the board
/Z_A6: U20.3 (GPIO6); also elsewhere on the board
/Z_A7: U20.4 (GPIO7); also elsewhere on the board
/Z_A8: U20.6 (GPIO8); also elsewhere on the board
/Z_A9: U20.7 (GPIO9); also elsewhere on the board
/Z_A10: U20.8 (GPIO10); also elsewhere on the board
/Z_A11: U20.9 (GPIO11); also elsewhere on the board
/Z_A12: U20.11 (GPIO12); also elsewhere on the board
/Z_A13: U20.12 (GPIO13); also elsewhere on the board
/Z_A14: U20.13 (GPIO14); also elsewhere on the board
/Z_A15: U20.14 (GPIO15); also elsewhere on the board
/Z_A16: U20.16 (GPIO16); also elsewhere on the board
/Z_A17: U20.17 (GPIO17); also elsewhere on the board
/Z_A18: U20.18 (GPIO18); also elsewhere on the board
/Z_A19: U20.19 (GPIO19); also elsewhere on the board
/Z_A20: U20.20 (GPIO20); also elsewhere on the board
/Z_A21: U20.21 (GPIO21); also elsewhere on the board
/Z_A22: U20.22 (GPIO22); also elsewhere on the board
/Z_A23: U20.23 (GPIO23); also elsewhere on the board
/Z_AS_N: U20.77 (GPIO0); also elsewhere on the board
/Z_CFGIN_N: U20.54 (GPIO43/ADC3); also elsewhere on the board
/Z_D0: U20.25 (GPIO24); also elsewhere on the board
/Z_D1: U20.26 (GPIO25); also elsewhere on the board
/Z_D2: U20.27 (GPIO26); also elsewhere on the board
/Z_D3: U20.28 (GPIO27); also elsewhere on the board
/Z_D4: U20.36 (GPIO28); also elsewhere on the board
/Z_D5: U20.37 (GPIO29); also elsewhere on the board
/Z_D6: U20.38 (GPIO30); also elsewhere on the board
/Z_D7: U20.39 (GPIO31); also elsewhere on the board
/Z_D8: U20.40 (GPIO32); also elsewhere on the board
/Z_D9: U20.42 (GPIO33); also elsewhere on the board
/Z_D10: U20.43 (GPIO34); also elsewhere on the board
/Z_D11: U20.44 (GPIO35); also elsewhere on the board
/Z_D12: U20.45 (GPIO36); also elsewhere on the board
/Z_D13: U20.46 (GPIO37); also elsewhere on the board
/Z_D14: U20.47 (GPIO38); also elsewhere on the board
/Z_D15: U20.48 (GPIO39); also elsewhere on the board
/Z_LDS_N: U20.52 (GPIO41/ADC1); also elsewhere on the board
/Z_READ: U20.53 (GPIO42/ADC2); also elsewhere on the board
/Z_UDS_N: U20.49 (GPIO40/ADC0); also elsewhere on the board

Notes on the sheet:
48 GPIO: address/data/control only; USB and SWD dedicated pads. GPIO45 IRQ; GPIO46 BUS_READY.
Core regulator placement MUST follow Raspberry Pi reference, including marked inductor orientation.
C26-C36: IOVDD/ADC/USB/QSPI decoupling. C37-C39: DVDD. Place at corresponding package pads.
