markjfisher/fujinet-nio-hardware/amiga/integrated-a500-r4/integrated-a500-r4.kicad_pcb

## KiCad design amiga/integrated-a500-r4/integrated-a500-r4.kicad_pcb (continued)

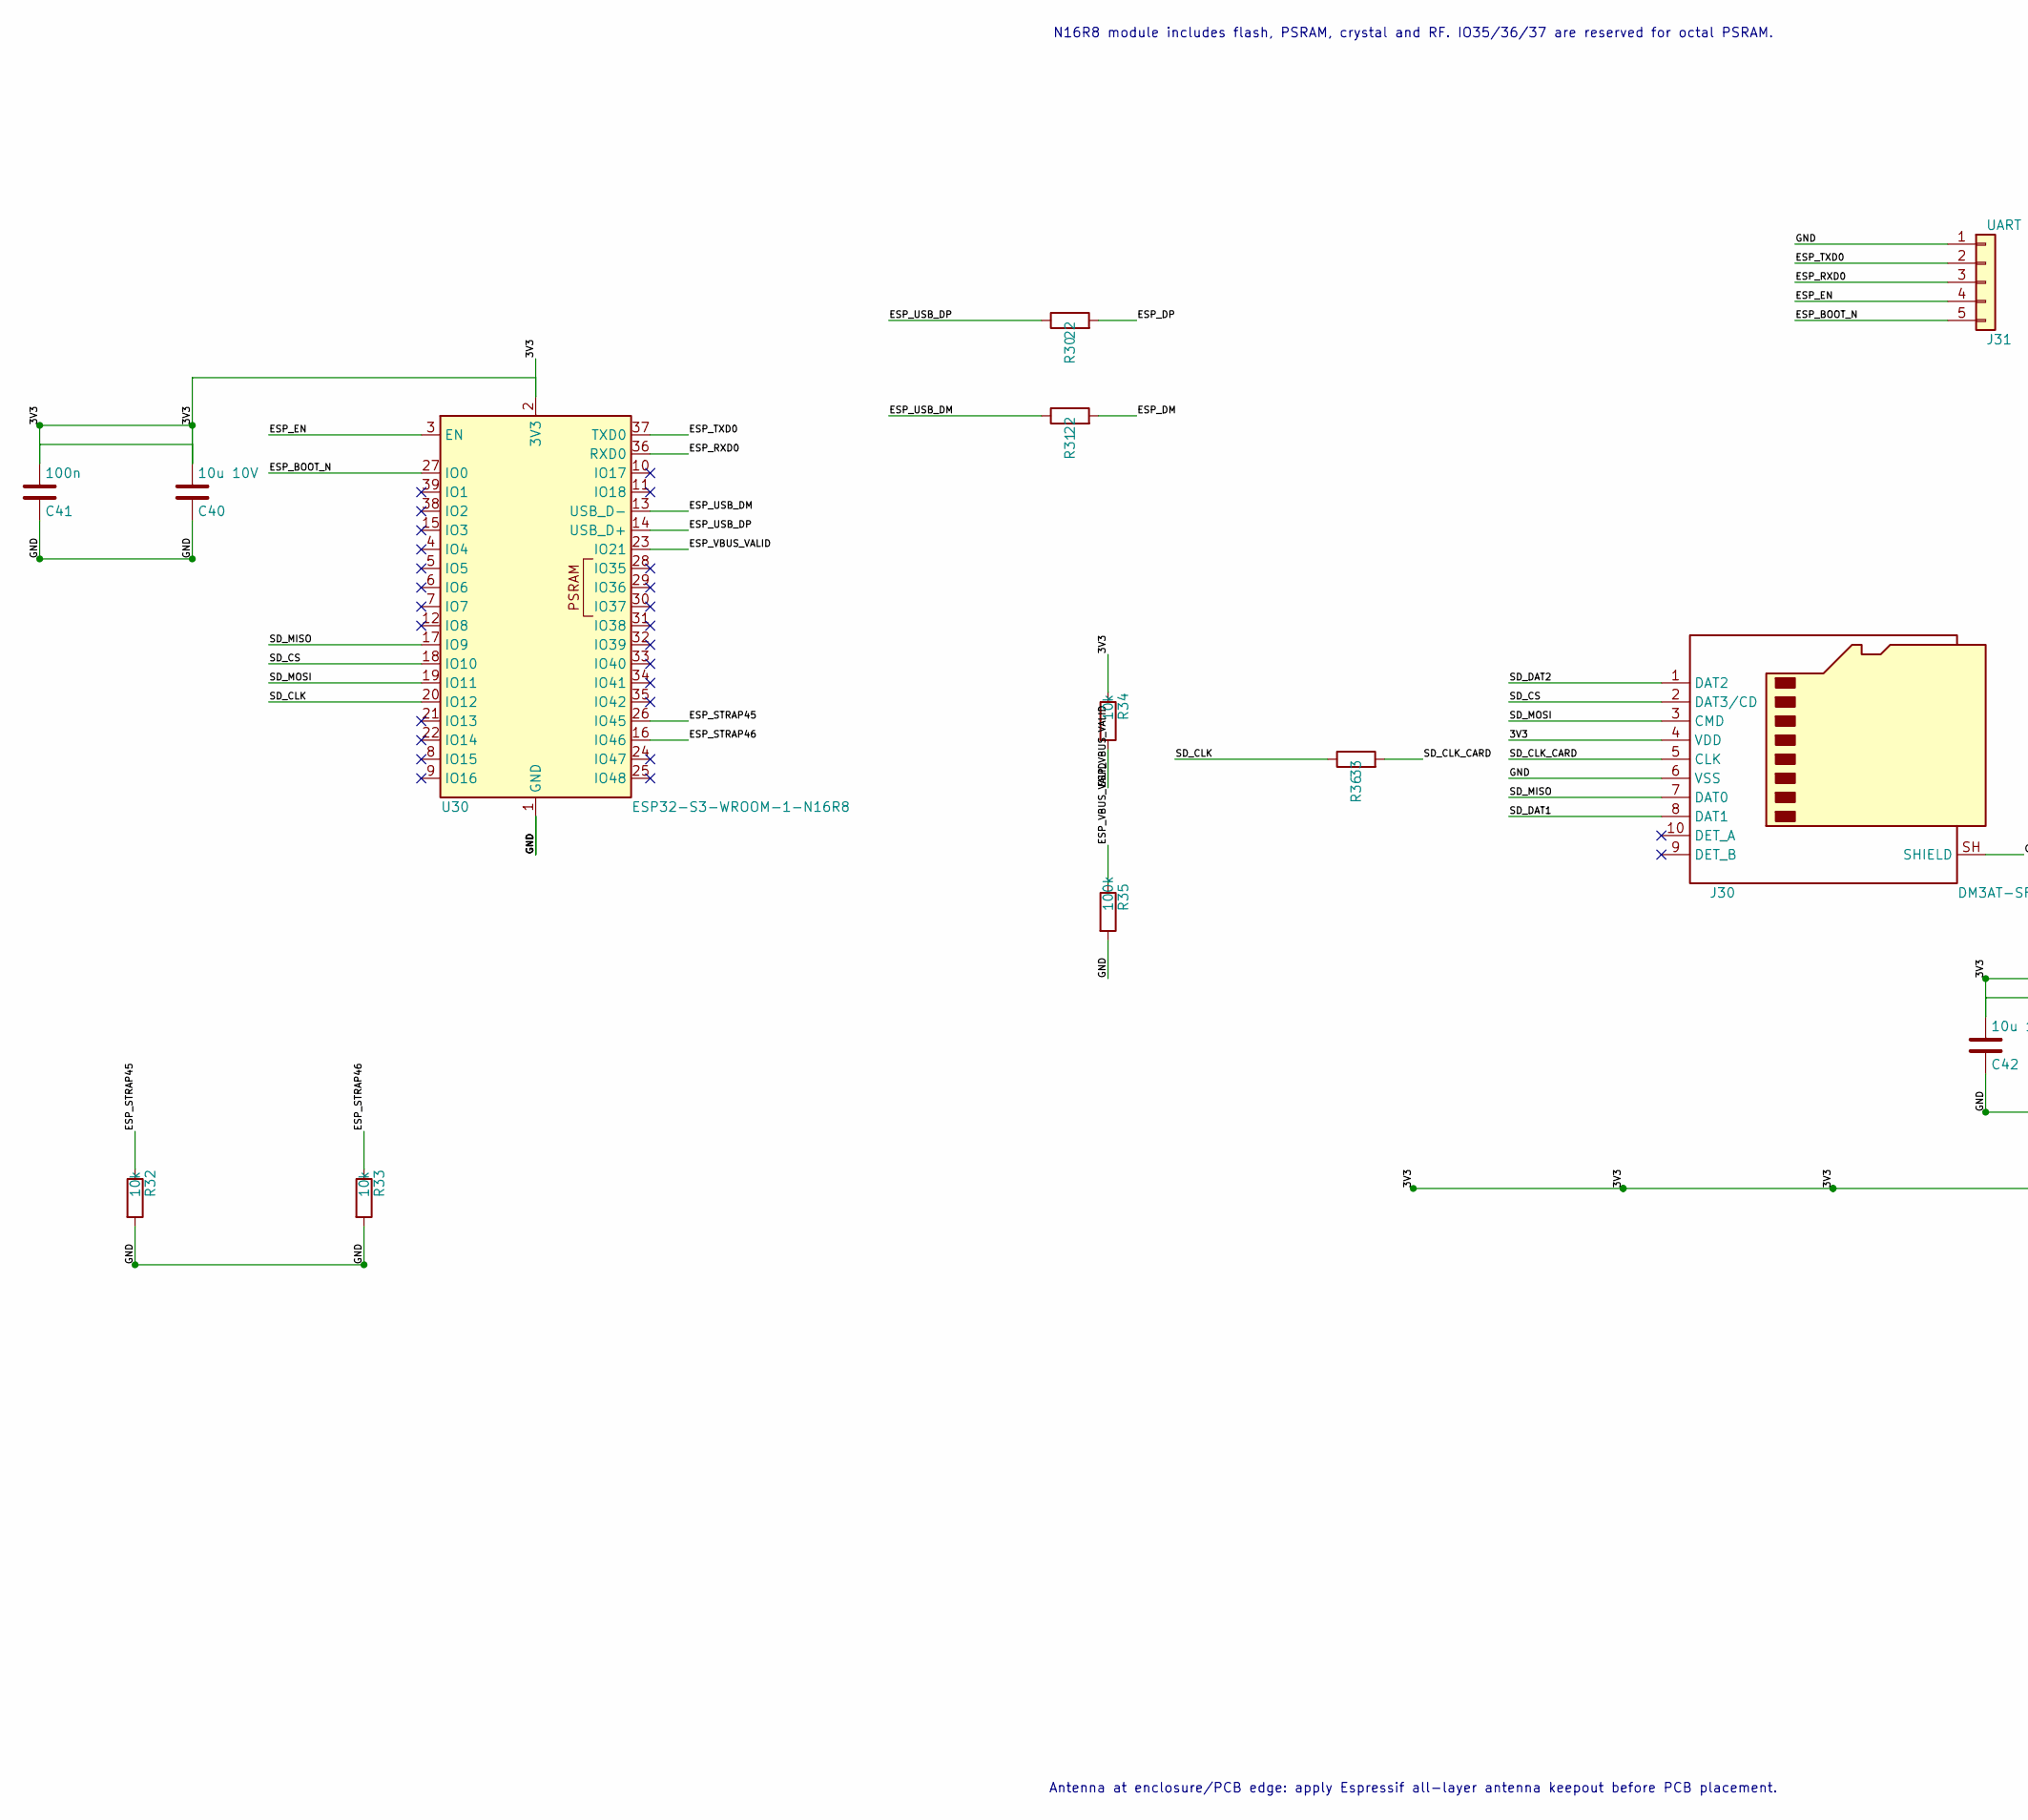
[picture p88: schematic esp.kicad_sch, ESP32-S3 module and microSD, part in row 1, column 1]

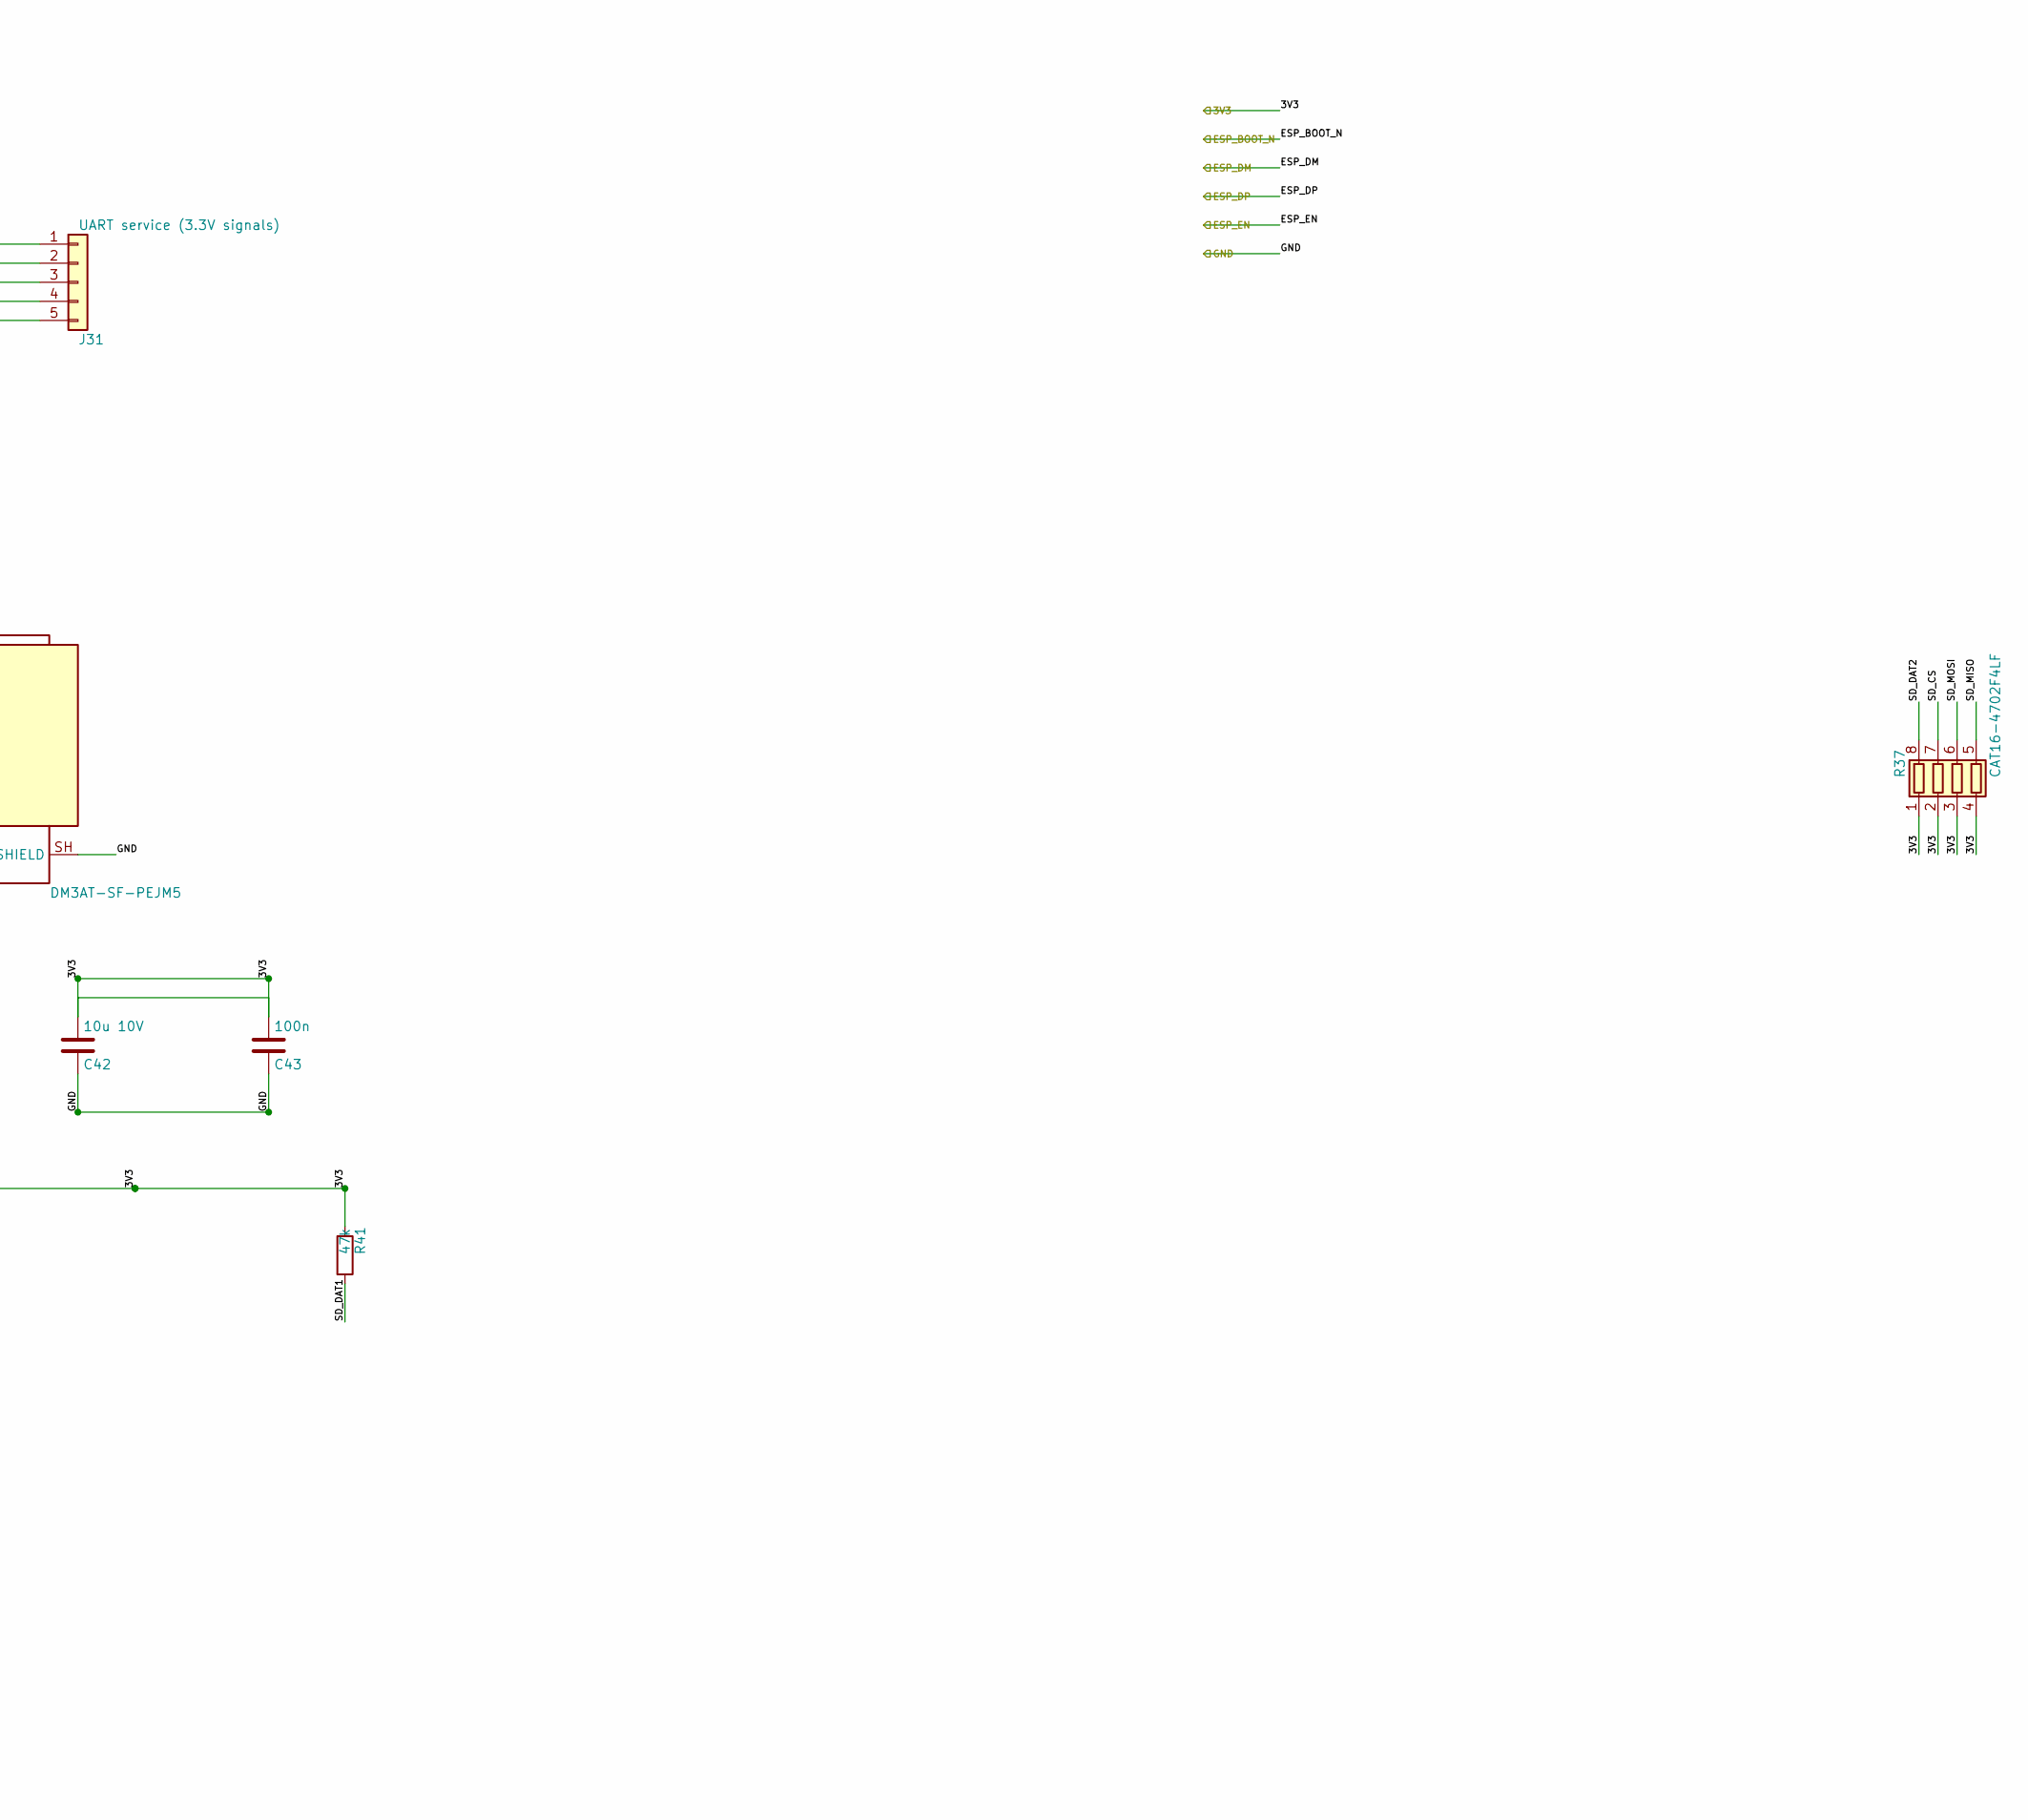
[picture p89: schematic esp.kicad_sch, ESP32-S3 module and microSD, part in row 1, column 2]

Parts:
C40, C42: 10u 10V; C_0603_1608Metric
C41, C43: 100n; C_0603_1608Metric
J30: DM3AT-SF-PEJM5; microSD_HC_Hirose_DM3AT-SF-PEJM5
J31: UART service (3.3V signals); PinHeader_1x05_P2.54mm_Vertical
R30, R31: 22; R_0603_1608Metric
R32, R33, R34: 10k; R_0603_1608Metric
R35: 100k; R_0603_1608Metric
R36: 33; R_0603_1608Metric
R37: CAT16-4702F4LF; R_Array_Concave_4x0603
R41: 47k; R_0603_1608Metric
U30: ESP32-S3-WROOM-1-N16R8; ESP32-S3-WROOM-1

Connections:
/3V3: C40.1, C41.1, C42.1, C43.1, J30.4 (VDD), R34.1, R37.1 (R1.1), R37.2 (R2.1), R37.3 (R3.1), R37.4 (R4.1), R41.1, U30.2 (3V3); also elsewhere on the board
/ESP32-S3 module and microSD/ESP_RXD0: J31.3, U30.36 (RXD0)
/ESP32-S3 module and microSD/ESP_STRAP45: R32.1, U30.26 (IO45)
/ESP32-S3 module and microSD/ESP_STRAP46: R33.1, U30.16 (IO46)
/ESP32-S3 module and microSD/ESP_TXD0: J31.2, U30.37 (TXD0)
/ESP32-S3 module and microSD/ESP_USB_DM: R31.1, U30.13 (USB_D-)
/ESP32-S3 module and microSD/ESP_USB_DP: R30.1, U30.14 (USB_D+)
/ESP32-S3 module and microSD/ESP_VBUS_VALID: R34.2, R35.1, U30.23 (IO21)
/ESP32-S3 module and microSD/SD_CLK: R36.1, U30.20 (IO12)
/ESP32-S3 module and microSD/SD_CLK_CARD: J30.5 (CLK), R36.2
/ESP32-S3 module and microSD/SD_CS: J30.2 (DAT3/CD), R37.7 (R2.2), U30.18 (IO10)
/ESP32-S3 module and microSD/SD_DAT1: J30.8 (DAT1), R41.2
/ESP32-S3 module and microSD/SD_DAT2: J30.1 (DAT2), R37.8 (R1.2)
/ESP32-S3 module and microSD/SD_MISO: J30.7 (DAT0), R37.5 (R4.2), U30.17 (IO9)
/ESP32-S3 module and microSD/SD_MOSI: J30.3 (CMD), R37.6 (R3.2), U30.19 (IO11)
/ESP_BOOT_N: J31.5, U30.27 (IO0); also elsewhere on the board
/ESP_DM: R31.2; also elsewhere on the board
/ESP_DP: R30.2; also elsewhere on the board
/ESP_EN: J31.4, U30.3 (EN); also elsewhere on the board

Notes on the sheet:
N16R8 module includes flash, PSRAM, crystal and RF. IO35/36/37 are reserved for octal PSRAM.
Antenna at enclosure/PCB edge: apply Espressif all-layer antenna keepout before PCB placement.

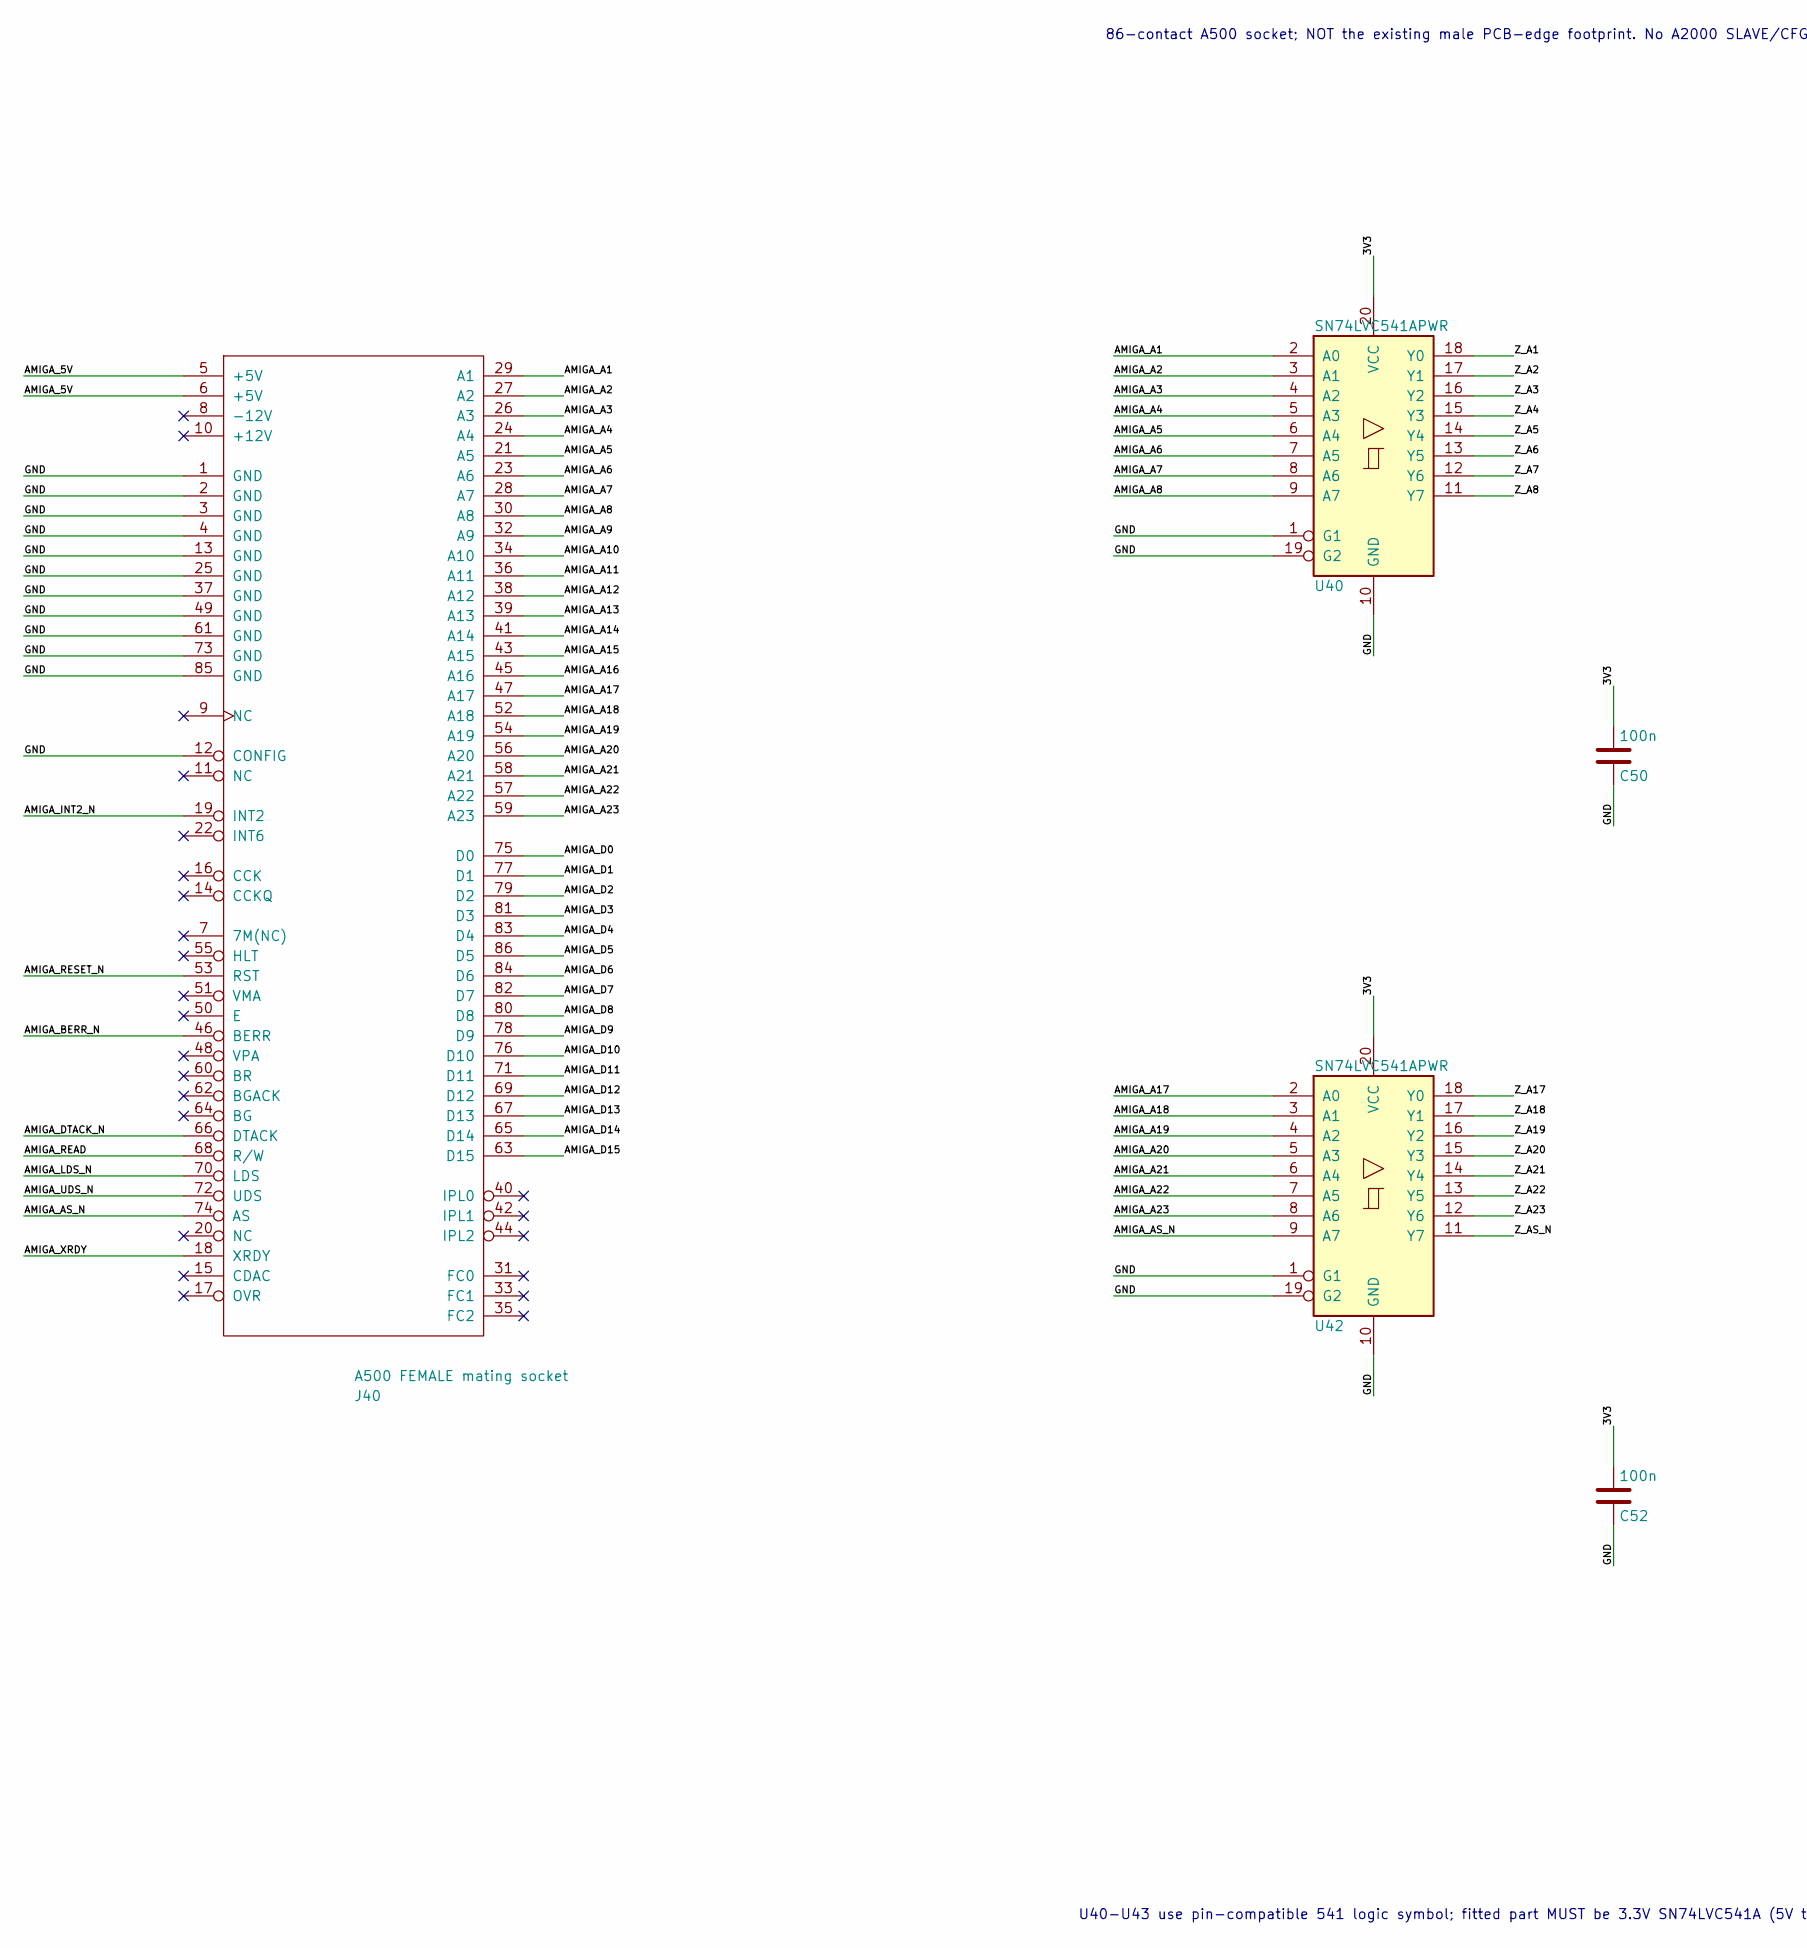
[picture p90: schematic address.kicad_sch, A500 socket and input buffers, part in row 1, column 1]

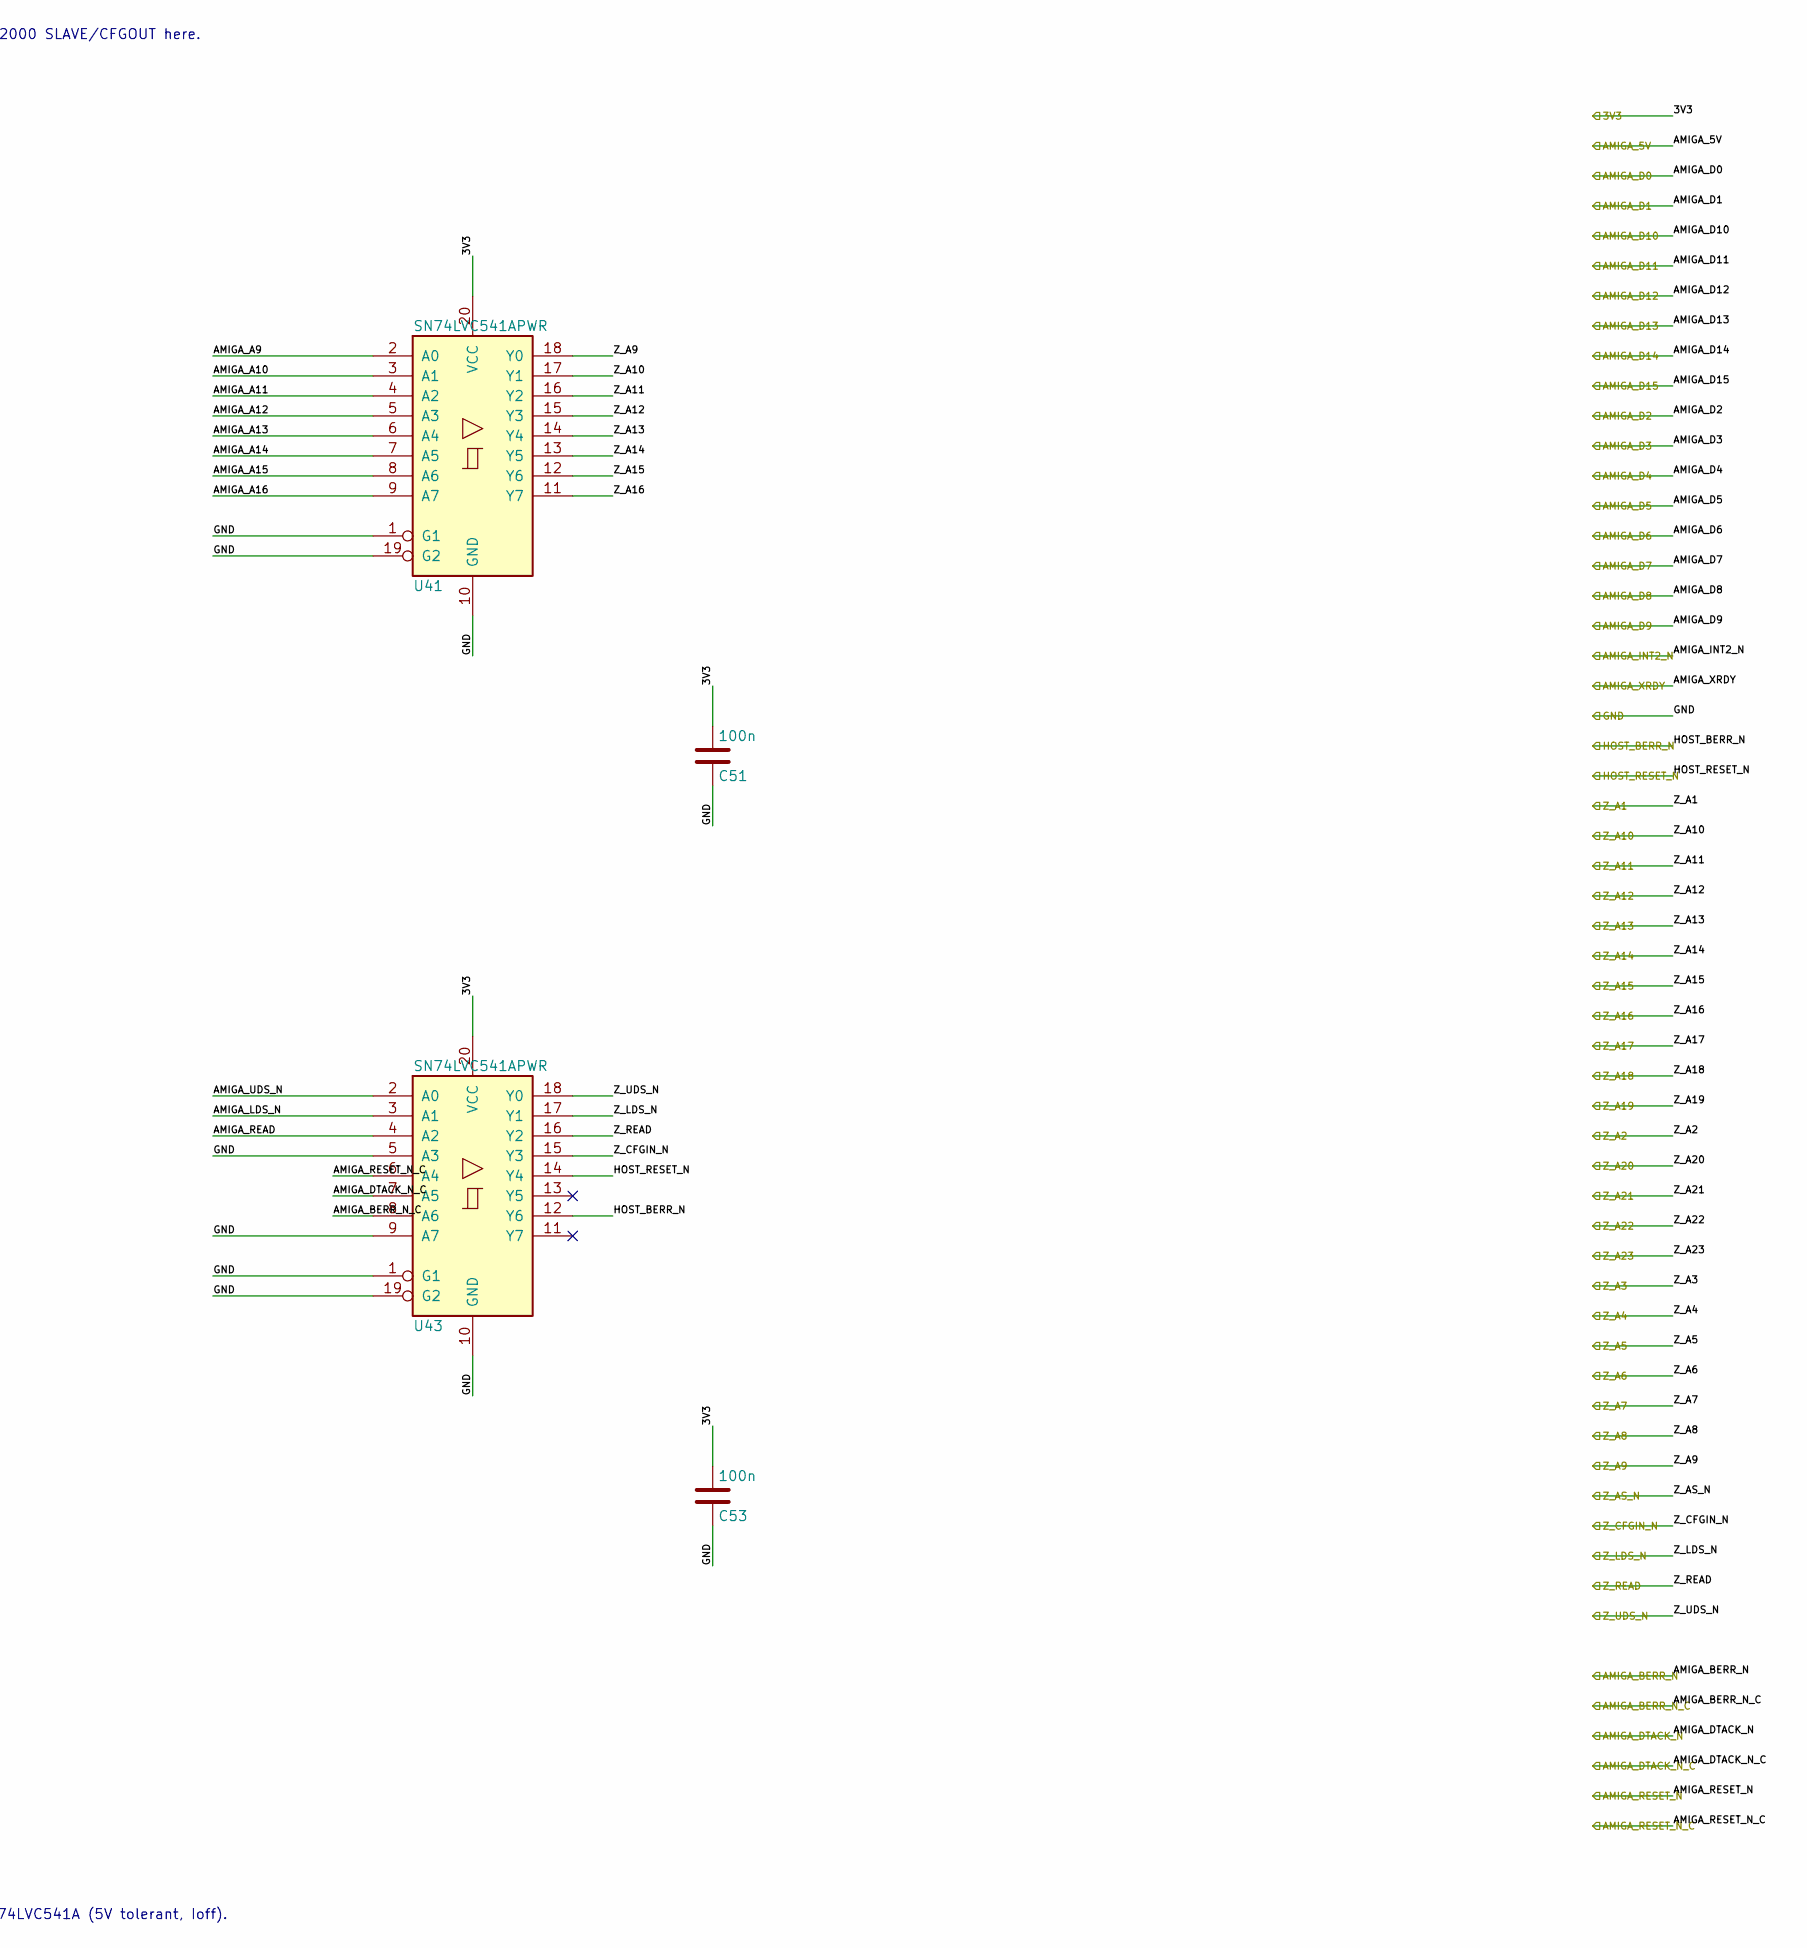
[picture p91: schematic address.kicad_sch, A500 socket and input buffers, part in row 1, column 2]

Parts:
C50, C51, C52, C53: 100n; C_0603_1608Metric
J40: A500 FEMALE mating socket; A500_ED86_EdgeSolder
U40, U41, U42, U43: SN74LVC541APWR; TSSOP-20_4.4x6.5mm_P0.65mm

Connections:
/3V3: C50.1, C51.1, C52.1, C53.1, U40.20 (VCC), U41.20 (VCC), U42.20 (VCC), U43.20 (VCC); also elsewhere on the board
/A500 socket and input buffers/AMIGA_A1: J40.29 (A1), U40.2 (A0)
/A500 socket and input buffers/AMIGA_A2: J40.27 (A2), U40.3 (A1)
/A500 socket and input buffers/AMIGA_A3: J40.26 (A3), U40.4 (A2)
/A500 socket and input buffers/AMIGA_A4: J40.24 (A4), U40.5 (A3)
/A500 socket and input buffers/AMIGA_A5: J40.21 (A5), U40.6 (A4)
/A500 socket and input buffers/AMIGA_A6: J40.23 (A6), U40.7 (A5)
/A500 socket and input buffers/AMIGA_A7: J40.28 (A7), U40.8 (A6)
/A500 socket and input buffers/AMIGA_A8: J40.30 (A8), U40.9 (A7)
/A500 socket and input buffers/AMIGA_A9: J40.32 (A9), U41.2 (A0)
/A500 socket and input buffers/AMIGA_A10: J40.34 (A10), U41.3 (A1)
/A500 socket and input buffers/AMIGA_A11: J40.36 (A11), U41.4 (A2)
/A500 socket and input buffers/AMIGA_A12: J40.38 (A12), U41.5 (A3)
/A500 socket and input buffers/AMIGA_A13: J40.39 (A13), U41.6 (A4)
/A500 socket and input buffers/AMIGA_A14: J40.41 (A14), U41.7 (A5)
/A500 socket and input buffers/AMIGA_A15: J40.43 (A15), U41.8 (A6)
/A500 socket and input buffers/AMIGA_A16: J40.45 (A16), U41.9 (A7)
/A500 socket and input buffers/AMIGA_A17: J40.47 (A17), U42.2 (A0)
/A500 socket and input buffers/AMIGA_A18: J40.52 (A18), U42.3 (A1)
/A500 socket and input buffers/AMIGA_A19: J40.54 (A19), U42.4 (A2)
/A500 socket and input buffers/AMIGA_A20: J40.56 (A20), U42.5 (A3)
/A500 socket and input buffers/AMIGA_A21: J40.58 (A21), U42.6 (A4)
/A500 socket and input buffers/AMIGA_A22: J40.57 (A22), U42.7 (A5)
/A500 socket and input buffers/AMIGA_A23: J40.59 (A23), U42.8 (A6)
/A500 socket and input buffers/AMIGA_AS_N: J40.74 (AS), U42.9 (A7)
/A500 socket and input buffers/AMIGA_LDS_N: J40.70 (LDS), U43.3 (A1)
/A500 socket and input buffers/AMIGA_READ: J40.68 (R/W), U43.4 (A2)
/A500 socket and input buffers/AMIGA_UDS_N: J40.72 (UDS), U43.2 (A0)
/AMIGA_5V: J40.5 (+5V), J40.6 (+5V); also elsewhere on the board
/AMIGA_BERR_N: J40.46 (BERR); also elsewhere on the board
/AMIGA_BERR_N_C: U43.8 (A6); also elsewhere on the board
/AMIGA_D0: J40.75 (D0); also elsewhere on the board
/AMIGA_D1: J40.77 (D1); also elsewhere on the board
/AMIGA_D2: J40.79 (D2); also elsewhere on the board
/AMIGA_D3: J40.81 (D3); also elsewhere on the board
/AMIGA_D4: J40.83 (D4); also elsewhere on the board
/AMIGA_D5: J40.86 (D5); also elsewhere on the board
/AMIGA_D6: J40.84 (D6); also elsewhere on the board
/AMIGA_D7: J40.82 (D7); also elsewhere on the board
/AMIGA_D8: J40.80 (D8); also elsewhere on the board
/AMIGA_D9: J40.78 (D9); also elsewhere on the board
/AMIGA_D10: J40.76 (D10); also elsewhere on the board
/AMIGA_D11: J40.71 (D11); also elsewhere on the board
/AMIGA_D12: J40.69 (D12); also elsewhere on the board
/AMIGA_D13: J40.67 (D13); also elsewhere on the board
/AMIGA_D14: J40.65 (D14); also elsewhere on the board
/AMIGA_D15: J40.63 (D15); also elsewhere on the board
/AMIGA_DTACK_N: J40.66 (DTACK); also elsewhere on the board
/AMIGA_DTACK_N_C: U43.7 (A5); also elsewhere on the board
/AMIGA_INT2_N: J40.19 (INT2); also elsewhere on the board
/AMIGA_RESET_N: J40.53 (RST); also elsewhere on the board
/AMIGA_RESET_N_C: U43.6 (A4); also elsewhere on the board
/AMIGA_XRDY: J40.18 (XRDY); also elsewhere on the board
/HOST_BERR_N: U43.12 (Y6); also elsewhere on the board
/HOST_RESET_N: U43.14 (Y4); also elsewhere on the board
/Z_A1: U40.18 (Y0); also elsewhere on the board
/Z_A2: U40.17 (Y1); also elsewhere on the board
/Z_A3: U40.16 (Y2); also elsewhere on the board
/Z_A4: U40.15 (Y3); also elsewhere on the board
/Z_A5: U40.14 (Y4); also elsewhere on the board
/Z_A6: U40.13 (Y5); also elsewhere on the board
/Z_A7: U40.12 (Y6); also elsewhere on the board
/Z_A8: U40.11 (Y7); also elsewhere on the board
/Z_A9: U41.18 (Y0); also elsewhere on the board
/Z_A10: U41.17 (Y1); also elsewhere on the board
/Z_A11: U41.16 (Y2); also elsewhere on the board
/Z_A12: U41.15 (Y3); also elsewhere on the board
/Z_A13: U41.14 (Y4); also elsewhere on the board
/Z_A14: U41.13 (Y5); also elsewhere on the board
/Z_A15: U41.12 (Y6); also elsewhere on the board
/Z_A16: U41.11 (Y7); also elsewhere on the board
/Z_A17: U42.18 (Y0); also elsewhere on the board
/Z_A18: U42.17 (Y1); also elsewhere on the board
/Z_A19: U42.16 (Y2); also elsewhere on the board
/Z_A20: U42.15 (Y3); also elsewhere on the board
/Z_A21: U42.14 (Y4); also elsewhere on the board
/Z_A22: U42.13 (Y5); also elsewhere on the board
/Z_A23: U42.12 (Y6); also elsewhere on the board
/Z_AS_N: U42.11 (Y7); also elsewhere on the board
/Z_CFGIN_N: U43.15 (Y3); also elsewhere on the board
/Z_LDS_N: U43.17 (Y1); also elsewhere on the board
/Z_READ: U43.16 (Y2); also elsewhere on the board
/Z_UDS_N: U43.18 (Y0); also elsewhere on the board

Notes on the sheet:
86-contact A500 socket; NOT the existing male PCB-edge footprint. No A2000 SLAVE/CFGOUT here.
U40-U43 use pin-compatible 541 logic symbol; fitted part MUST be 3.3V SN74LVC541A (5V tolerant, Ioff).
