markjfisher/fujinet-nio-hardware/amiga/integrated-a500-r4/integrated-a500-r4.kicad_pcb

## KiCad design amiga/integrated-a500-r4/integrated-a500-r4.kicad_pcb (continued)

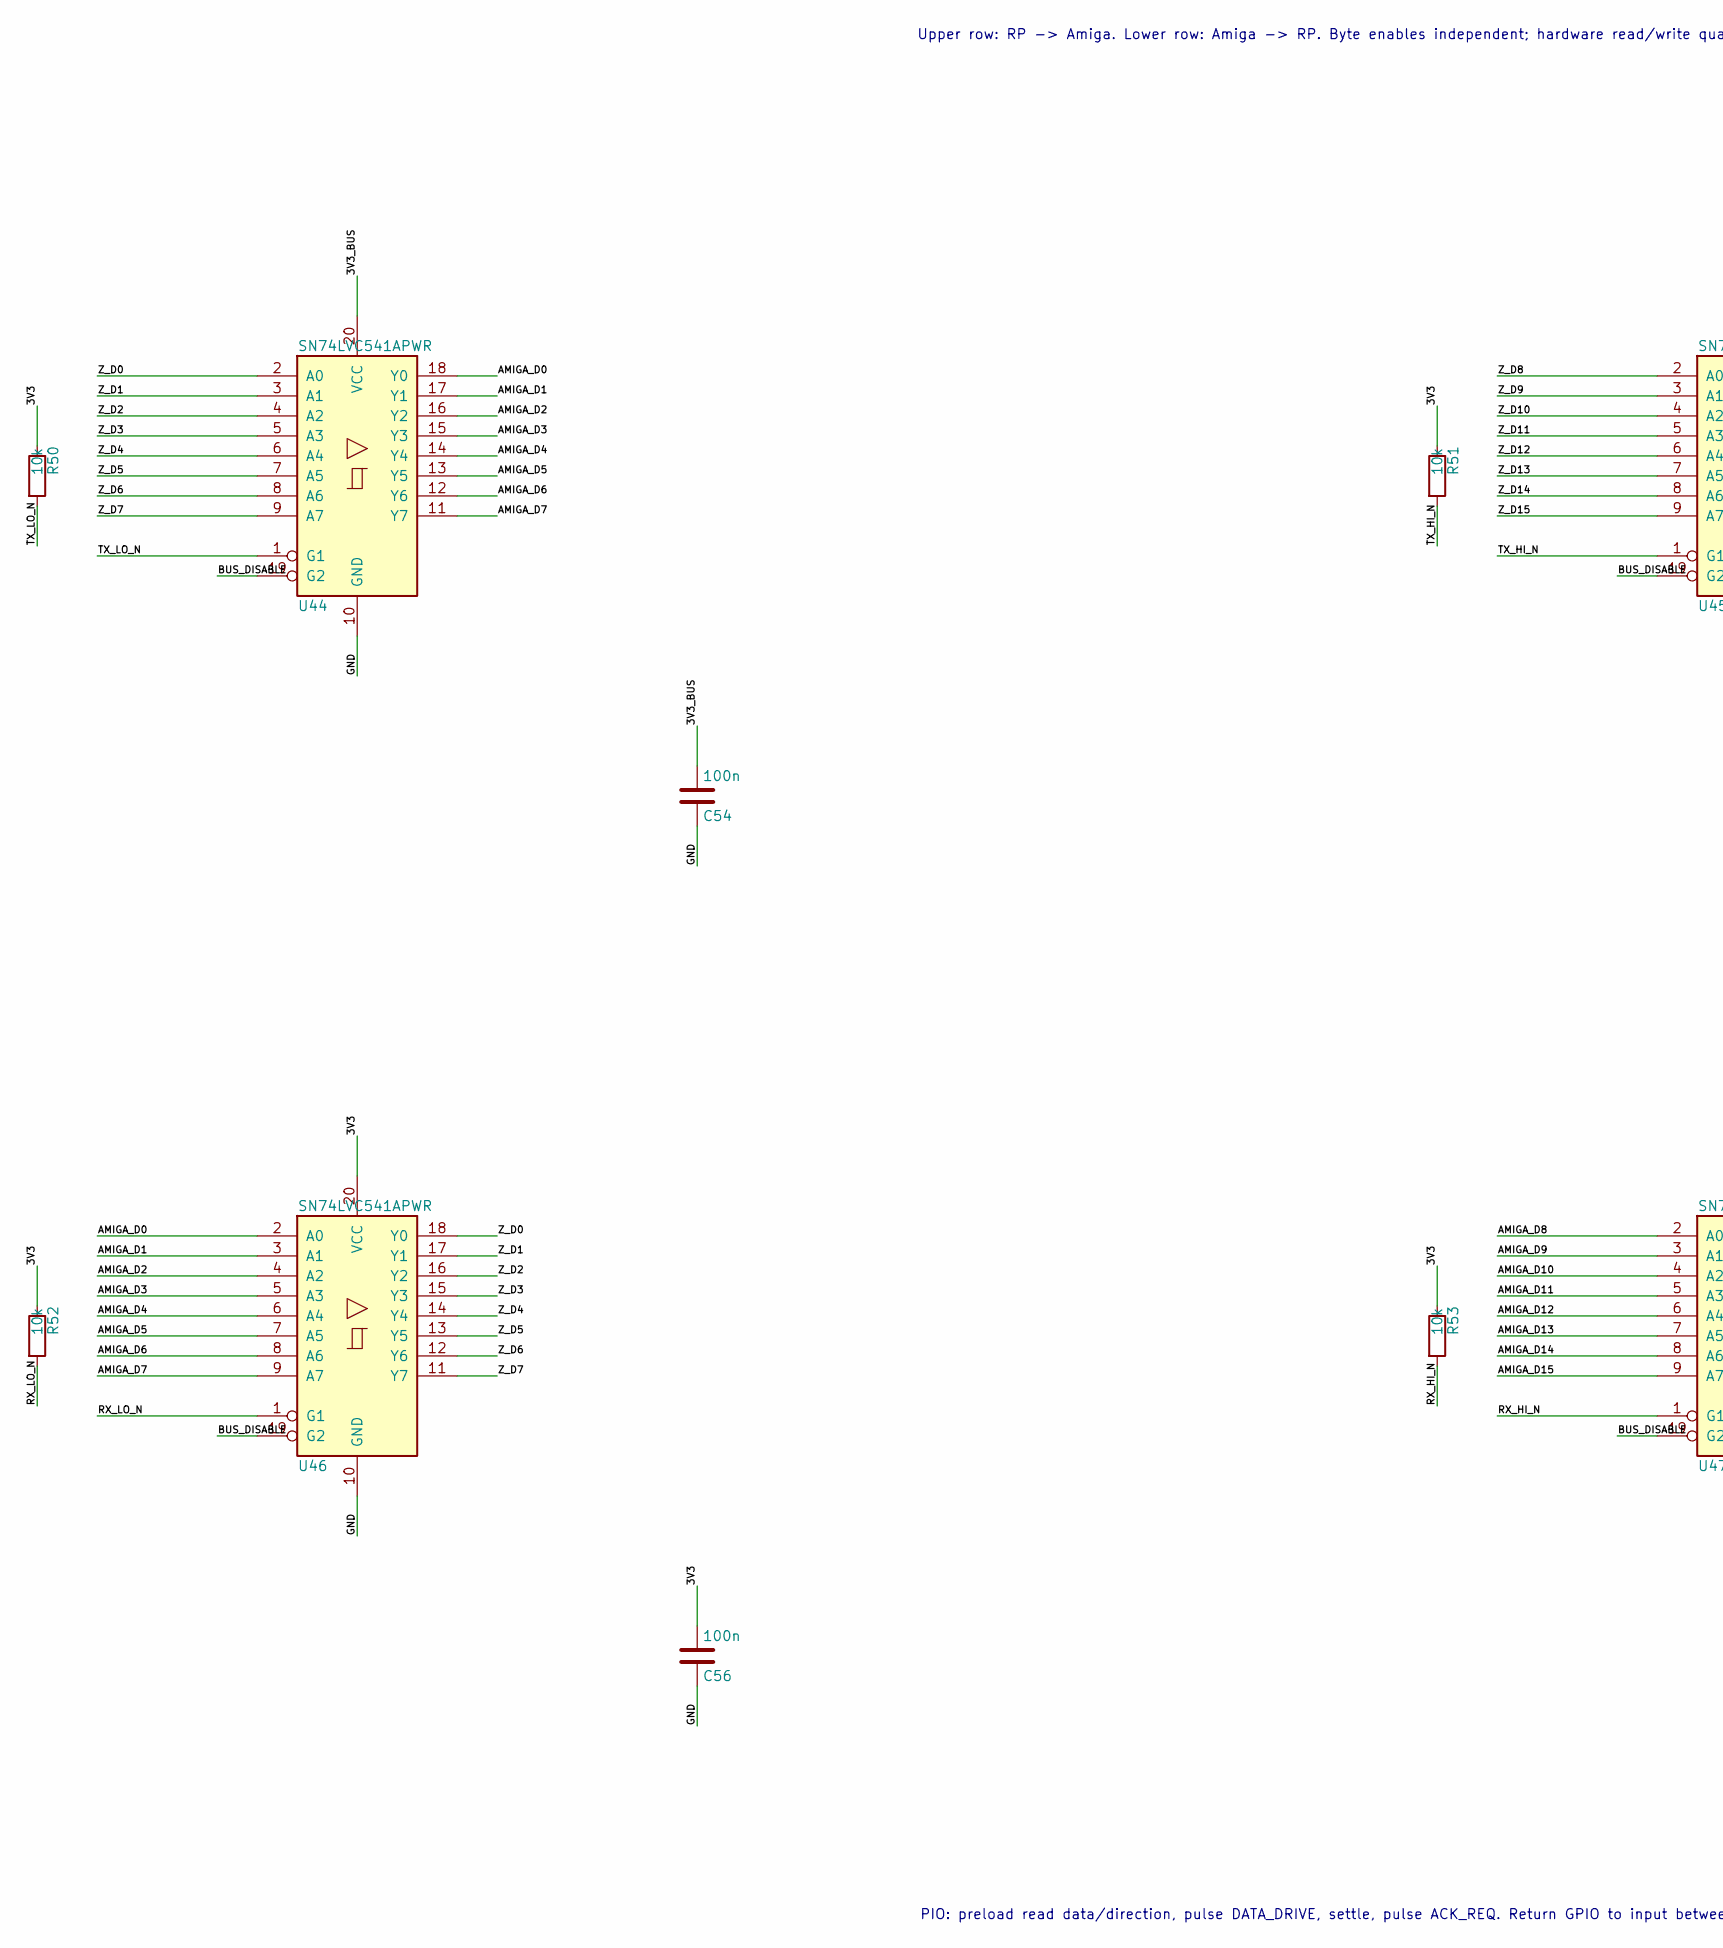
[picture p92: schematic data.kicad_sch, Independent byte-lane data buffers, part in row 1, column 1]

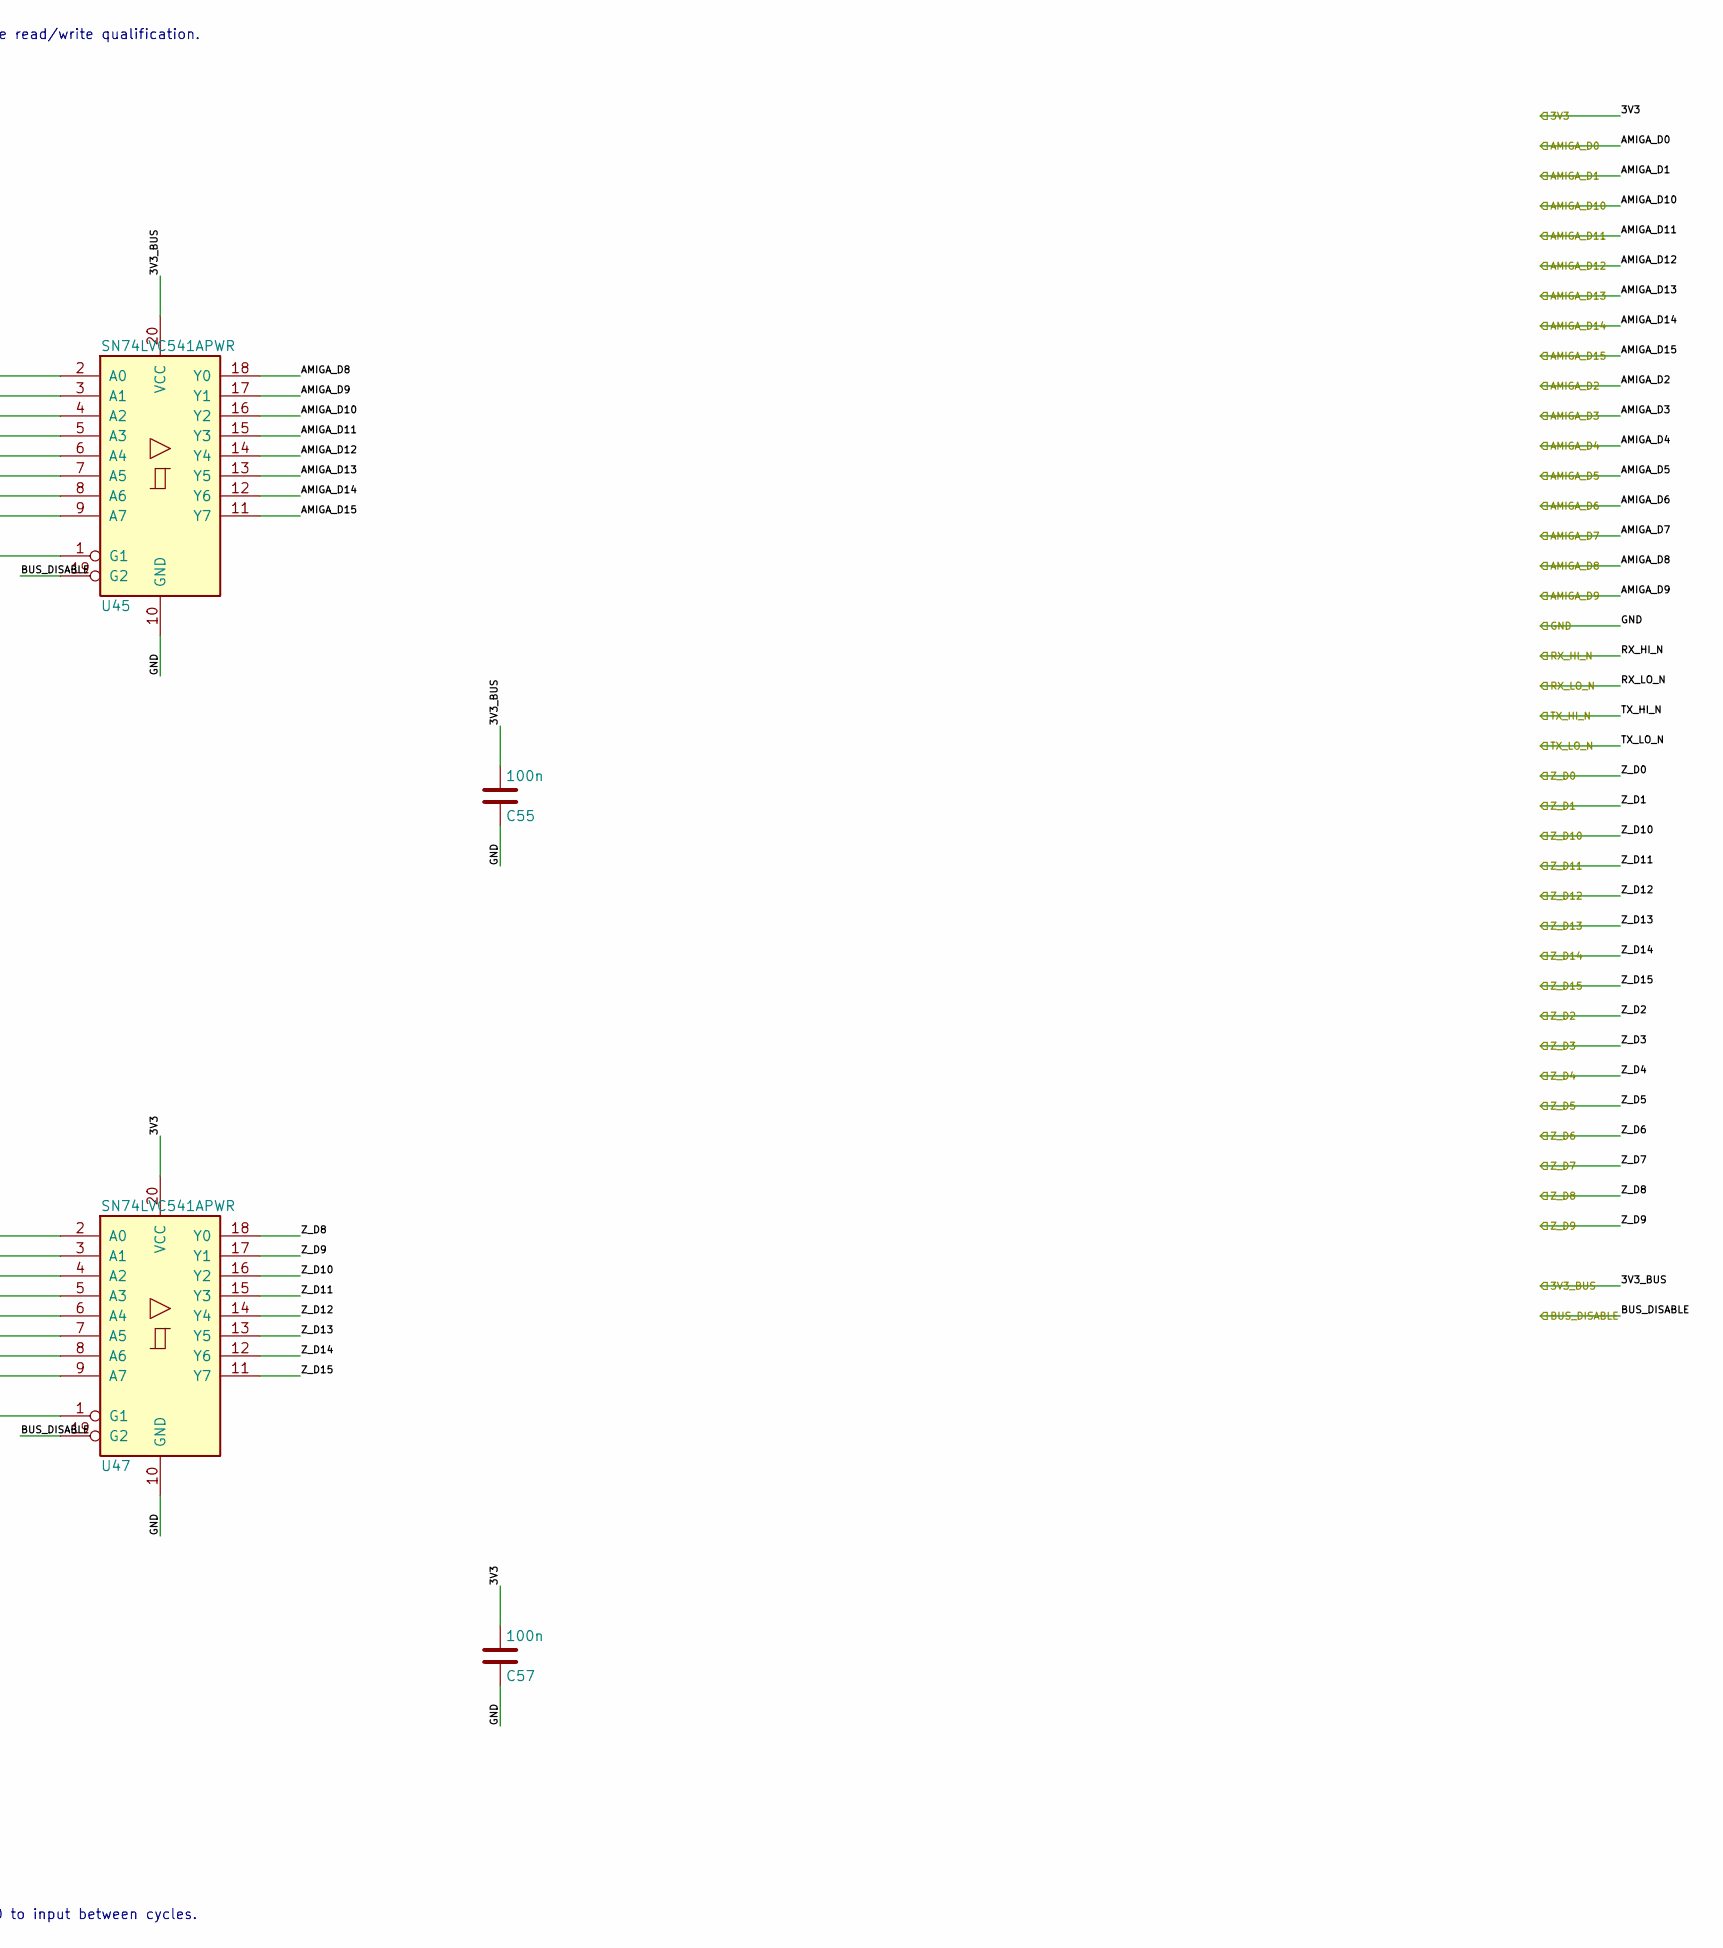
[picture p93: schematic data.kicad_sch, Independent byte-lane data buffers, part in row 1, column 2]

Parts:
C54, C55, C56, C57: 100n; C_0603_1608Metric
R50, R51, R52, R53: 10k; R_0603_1608Metric
U44, U45, U46, U47: SN74LVC541APWR; TSSOP-20_4.4x6.5mm_P0.65mm

Connections:
/3V3: C56.1, C57.1, R50.1, R51.1, R52.1, R53.1, U46.20 (VCC), U47.20 (VCC); also elsewhere on the board
/3V3_BUS: C54.1, C55.1, U44.20 (VCC), U45.20 (VCC); also elsewhere on the board
/AMIGA_D0: U44.18 (Y0), U46.2 (A0); also elsewhere on the board
/AMIGA_D1: U44.17 (Y1), U46.3 (A1); also elsewhere on the board
/AMIGA_D2: U44.16 (Y2), U46.4 (A2); also elsewhere on the board
/AMIGA_D3: U44.15 (Y3), U46.5 (A3); also elsewhere on the board
/AMIGA_D4: U44.14 (Y4), U46.6 (A4); also elsewhere on the board
/AMIGA_D5: U44.13 (Y5), U46.7 (A5); also elsewhere on the board
/AMIGA_D6: U44.12 (Y6), U46.8 (A6); also elsewhere on the board
/AMIGA_D7: U44.11 (Y7), U46.9 (A7); also elsewhere on the board
/AMIGA_D8: U45.18 (Y0), U47.2 (A0); also elsewhere on the board
/AMIGA_D9: U45.17 (Y1), U47.3 (A1); also elsewhere on the board
/AMIGA_D10: U45.16 (Y2), U47.4 (A2); also elsewhere on the board
/AMIGA_D11: U45.15 (Y3), U47.5 (A3); also elsewhere on the board
/AMIGA_D12: U45.14 (Y4), U47.6 (A4); also elsewhere on the board
/AMIGA_D13: U45.13 (Y5), U47.7 (A5); also elsewhere on the board
/AMIGA_D14: U45.12 (Y6), U47.8 (A6); also elsewhere on the board
/AMIGA_D15: U45.11 (Y7), U47.9 (A7); also elsewhere on the board
/BUS_DISABLE: U44.19 (G2), U45.19 (G2), U46.19 (G2), U47.19 (G2); also elsewhere on the board
/RX_HI_N: R53.2, U47.1 (G1); also elsewhere on the board
/RX_LO_N: R52.2, U46.1 (G1); also elsewhere on the board
/TX_HI_N: R51.2, U45.1 (G1); also elsewhere on the board
/TX_LO_N: R50.2, U44.1 (G1); also elsewhere on the board
/Z_D0: U44.2 (A0), U46.18 (Y0); also elsewhere on the board
/Z_D1: U44.3 (A1), U46.17 (Y1); also elsewhere on the board
/Z_D2: U44.4 (A2), U46.16 (Y2); also elsewhere on the board
/Z_D3: U44.5 (A3), U46.15 (Y3); also elsewhere on the board
/Z_D4: U44.6 (A4), U46.14 (Y4); also elsewhere on the board
/Z_D5: U44.7 (A5), U46.13 (Y5); also elsewhere on the board
/Z_D6: U44.8 (A6), U46.12 (Y6); also elsewhere on the board
/Z_D7: U44.9 (A7), U46.11 (Y7); also elsewhere on the board
/Z_D8: U45.2 (A0), U47.18 (Y0); also elsewhere on the board
/Z_D9: U45.3 (A1), U47.17 (Y1); also elsewhere on the board
/Z_D10: U45.4 (A2), U47.16 (Y2); also elsewhere on the board
/Z_D11: U45.5 (A3), U47.15 (Y3); also elsewhere on the board
/Z_D12: U45.6 (A4), U47.14 (Y4); also elsewhere on the board
/Z_D13: U45.7 (A5), U47.13 (Y5); also elsewhere on the board
/Z_D14: U45.8 (A6), U47.12 (Y6); also elsewhere on the board
/Z_D15: U45.9 (A7), U47.11 (Y7); also elsewhere on the board

Notes on the sheet:
Upper row: RP -> Amiga. Lower row: Amiga -> RP. Byte enables independent; hardware read/write qualification.
PIO: preload read data/direction, pulse DATA_DRIVE, settle, pulse ACK_REQ. Return GPIO to input between cycles.

Schematic: control.kicad_sch, Hardware bus interlocks

Parts:
C70, C73, C75, C80, C81, C82, C86, C87, C88, C91, C93, C94, C95: 100n; C_0603_1608Metric
J60: BUS ARM (normally OPEN); PinHeader_1x02_P2.54mm_Vertical
R63, R64, R65, R66, R67: 10k; R_0603_1608Metric
U61, U66, U71: SN74LVC11APWR; TSSOP-14_4.4x5mm_P0.65mm
U64: SN74LVC04APWR; TSSOP-14_4.4x5mm_P0.65mm
U72, U73, U77, U78: SN74LVC1G10DBVR; SOT-23-6
U79: SN74LVC1G32DBVR; SOT-23-5
U82, U85: SN74LVC1G08DBVR; SOT-23-5
U84, U86: SN74LVC1G74DCUR; VSSOP-8_2.3x2mm_P0.5mm

Connections:
/3V3: C70.1, C73.1, C75.1, C80.1, C81.1, C82.1, C86.1, C87.1, C88.1, C91.1, C93.1, C94.1, C95.1, J60.1, U61.14 (VCC), U64.14 (VCC), U66.14 (VCC), U71.11 (3C), U71.14 (VCC), U72.5 (VCC), U72.6, U73.5 (VCC), U73.6, U77.5 (VCC), U77.6, U78.5 (VCC), U78.6, U79.5 (VCC), U82.5 (VCC), U84.7 (~PRE), U84.8 (VCC), U85.5 (VCC), U86.2 (D), U86.7 (~PRE), U86.8 (VCC); also elsewhere on the board
/ACK_REQ: R64.3; also elsewhere on the board
/ACK_REQ_C: U84.1 (C); also elsewhere on the board
/BUS_ARM: J60.2, R63.1; also elsewhere on the board
/BUS_ARM_C: U61.5 (2C); also elsewhere on the board
/BUS_PERMIT: U61.1 (1A), U61.2 (1B); also elsewhere on the board
/BUS_READY: R64.1; also elsewhere on the board
/BUS_READY_C: U61.11 (3C); also elsewhere on the board
/DATA_DRIVE_C: U86.1 (C); also elsewhere on the board
/HOST_BERR_N: U85.2; also elsewhere on the board
/HOST_RESET_N: U61.13 (1C); also elsewhere on the board
/Hardware bus interlocks/A20_LOW: U64.4 (2Y), U66.4 (2B)
/Hardware bus interlocks/ANY_LANE: U79.4, U84.2 (D)
/Hardware bus interlocks/AS_ACTIVE: U64.2 (1Y), U66.10 (3B)
/Hardware bus interlocks/CYCLE_OK: U66.8 (3Y), U71.1 (1A), U71.3 (2A), U71.9 (3A), U84.6 (~CLR), U86.6 (~CLR)
/Hardware bus interlocks/DATA_RECEIVE: U64.12 (6Y), U71.5 (2C)
/Hardware bus interlocks/DATA_VALID: U64.13 (6A), U71.13 (1C), U86.5 (Q)
/Hardware bus interlocks/HI_ACTIVE: U64.8 (4Y), U73.3, U78.3, U79.2
/Hardware bus interlocks/IO_TOP: U66.3 (2A), U66.12 (1Y)
/Hardware bus interlocks/IO_WINDOW: U66.6 (2Y), U66.11 (3C)
/Hardware bus interlocks/LO_ACTIVE: U64.6 (3Y), U72.3, U77.3, U79.1
/Hardware bus interlocks/READ_DRIVE: U71.12 (1Y), U72.1, U73.1
/Hardware bus interlocks/SAFE: U66.9 (3A), U82.1, U85.4
/Hardware bus interlocks/SAFE_BASE: U61.8 (3Y), U85.1
/Hardware bus interlocks/SAFE_MODE: U61.6 (2Y), U61.10 (3B)
/Hardware bus interlocks/SAFE_POWER: U61.9 (3A), U61.12 (1Y)
/Hardware bus interlocks/WAIT_PENDING: U71.10 (3B), U84.3 (~Q)
/Hardware bus interlocks/WRITE_CYCLE: U64.10 (5Y), U71.4 (2B)
/Hardware bus interlocks/WRITE_RECEIVE: U71.6 (2Y), U77.1, U78.1
/IRQ_REQ: R64.4; also elsewhere on the board
/IRQ_REQ_C: U82.2; also elsewhere on the board
/IRQ_SINK: U82.4; also elsewhere on the board
/RP_RUN_C: U61.3 (2A); also elsewhere on the board
/RUN_MODE_C: U61.4 (2B); also elsewhere on the board
/RX_HI_N: U78.4; also elsewhere on the board
/RX_LO_N: U77.4; also elsewhere on the board
/TX_HI_N: U73.4; also elsewhere on the board
/TX_LO_N: U72.4; also elsewhere on the board
/WAIT_SINK: U71.8 (3Y); also elsewhere on the board
/Z_A19: U66.5 (2C); also elsewhere on the board
/Z_A20: U64.3 (2A); also elsewhere on the board
/Z_A21: U66.13 (1C); also elsewhere on the board
/Z_A22: U66.2 (1B); also elsewhere on the board
/Z_A23: U66.1 (1A); also elsewhere on the board
/Z_AS_N: U64.1 (1A); also elsewhere on the board
/Z_LDS_N: U64.5 (3A); also elsewhere on the board
/Z_READ: U64.11 (5A), U71.2 (1B); also elsewhere on the board
/Z_UDS_N: U64.9 (4A); also elsewhere on the board

Notes on the sheet:
Host monitor: 0.405V x 11 = 4.455V nominal trip; CT open = 20ms release delay. No host supply drawn for operation.
XRDY wait starts in hardware for E80000-EFFFFF; rising ACK_REQ releases this cycle. No local DTACK driver.
U84/U86 clear between cycles: stale ACK/DATA_DRIVE cannot carry into next cycle. BERR disables all outputs.

Schematic: guard.kicad_sch

Parts:
C60, C111, C112, C118, C119: 1u 10V X7R; C_0603_1608Metric
C110, C120, C121, C122, C125, C126, C127, C128: 100n 10V X7R; C_0603_1608Metric
C113: 100u 6.3V polymer 20% ESR<=50m; CP_Elec_6.3x5.8
C114, C115, C116: 100p 25V C0G 5%; C_0603_1608Metric
C117: 220u 6.3V polymer 20% ESR<=50m; CP_Elec_6.3x5.8
D4: SS14-13-F; D_SMA
Q5: MMBT3904-7-F; SOT-23
R60: 102k 0.1%; R_0603_1608Metric
R61, R113, R115: 10k 0.1%; R_0603_1608Metric
R110: 133k 1%; R_0603_1608Metric
R111: 4.7k 1%; R_0603_1608Metric
R112, R114: 67.5k 0.1%; R_0603_1608Metric
R116, R122: 10k 1%; R_0603_1608Metric
R117, R118, R119, R121: 100k 1%; R_0603_1608Metric
R120: 22k 1%; R_0603_1608Metric
U60, U90, U91: MIC2790H-04VD6-TR; TSOT-23-6
U92: SN74LVC2G14DBVR; SOT-23-6
U93: SN74LVC2G132DCUR; VSSOP-8_2.3x2mm_P0.5mm
U94: SN74LVC2G125DCUR; VSSOP-8_2.3x2mm_P0.5mm
U95: TPS2553DBVR; SOT-23-6
U96: AP2112K-3.3TRG1; SOT-23-5
U97, U98, U100: 74LVC3G17DC,125; VSSOP-8_2.3x2mm_P0.5mm
U99: SN74LVC1G17DBVR; SOT-23-5

Connections:
/3V3: C117.1, C125.1, C126.1, C127.1, C128.1, R112.1, U97.8 (VCC), U98.8 (VCC), U99.5 (VCC), U100.8 (VCC); also elsewhere on the board
/3V3_BUS: C60.1, C112.1, C113.1, C118.1, C119.1, C120.1, C121.1, C122.1, R111.1, R114.1, R116.1, R117.1, R118.1, R119.1, U60.3 (~MR), U60.6 (VDD), U90.3 (~MR), U90.6 (VDD), U91.3 (~MR), U91.6 (VDD), U92.5 (VCC), U93.8 (VCC), U94.8 (VCC), U96.5 (VOUT); also elsewhere on the board
/ACK_REQ: U98.6 (3A); also elsewhere on the board
/ACK_REQ_C: U98.2 (3Y); also elsewhere on the board
/AMIGA_5V: C110.1, R60.1, U95.1 (IN), U95.3 (EN); also elsewhere on the board
/AMIGA_BERR_N: U100.3 (2A); also elsewhere on the board
/AMIGA_BERR_N_C: U100.5 (2Y); also elsewhere on the board
/AMIGA_DTACK_N: U100.6 (3A); also elsewhere on the board
/AMIGA_DTACK_N_C: U100.2 (3Y); also elsewhere on the board
/AMIGA_INT2_N: U94.3 (2Y); also elsewhere on the board
/AMIGA_RESET_N: U100.1 (1A); also elsewhere on the board
/AMIGA_RESET_N_C: U100.7 (1Y); also elsewhere on the board
/AMIGA_XRDY: U94.6 (1Y); also elsewhere on the board
/BUS_ARM: U97.6 (3A); also elsewhere on the board
/BUS_ARM_C: U97.2 (3Y); also elsewhere on the board
/BUS_DISABLE: R117.2, R120.1, U92.3 (2A), U92.6 (1Y); also elsewhere on the board
/BUS_PERMIT: R122.1, U92.4 (2Y), U93.1 (1A), U93.5 (2A); also elsewhere on the board
/BUS_READY: U98.1 (1A); also elsewhere on the board
/BUS_READY_C: U98.7 (1Y); also elsewhere on the board
/DATA_DRIVE_C: U98.5 (2Y); also elsewhere on the board
/Host interface power guard/BUS_CT: C116.1, U91.4 (CTH)
/Host interface power guard/BUS_SENSE: R114.2, R115.1, U91.5 (SNS)
/Host interface power guard/GUARD_OK_RAW: R116.2, U60.1 (~RESET), U90.1 (~RESET), U91.1 (~RESET), U92.1 (1A)
/Host interface power guard/GUARD_RESET_BASE: Q5.1 (B), R120.2, R121.1
/Host interface power guard/HOST_5V_LIMITED: D4.2 (A), U95.6 (OUT)
/Host interface power guard/HOST_CT: C114.1, U60.4 (CTH)
/Host interface power guard/HOST_ILIM: R110.1, U95.5 (ILIM)
/Host interface power guard/HOST_LDO_IN: C111.1, D4.1 (K), U96.1 (VIN), U96.3 (EN)
/Host interface power guard/HOST_SENSE: R60.2, R61.1, U60.5 (SNS)
/Host interface power guard/IRQ_OE_N: R119.2, U93.3 (2Y), U94.7 (~2OE)
/Host interface power guard/MAIN_CT: C115.1, U90.4 (CTH)
/Host interface power guard/MAIN_SENSE: R112.2, R113.1, U90.5 (SNS)
/Host interface power guard/WAIT_OE_N: R118.2, U93.7 (1Y), U94.1 (~1OE)
/IRQ_REQ: U99.2; also elsewhere on the board
/IRQ_REQ_C: U99.4; also elsewhere on the board
/IRQ_SINK: U93.6 (2B); also elsewhere on the board
/RP_RUN: Q5.3 (C), U97.1 (1A); also elsewhere on the board
/RP_RUN_C: U97.7 (1Y); also elsewhere on the board
/RUN_MODE: U97.3 (2A); also elsewhere on the board
/RUN_MODE_C: U97.5 (2Y); also elsewhere on the board
/WAIT_SINK: U93.2 (1B); also elsewhere on the board

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
Board: 4 copper layers, 203 parts (2 on the bottom side), 218 nets, no tracks yet.

Other parts of the board:
H1, H2, H3, H4: MountingHole_3.2mm_M3
