markjfisher/fujinet-nio-hardware/amiga/prototyping-board/kicad/zorro-breakout.kicad_pcb

## KiCad design amiga/prototyping-board/kicad/zorro-breakout.kicad_pcb (2026-09-11)

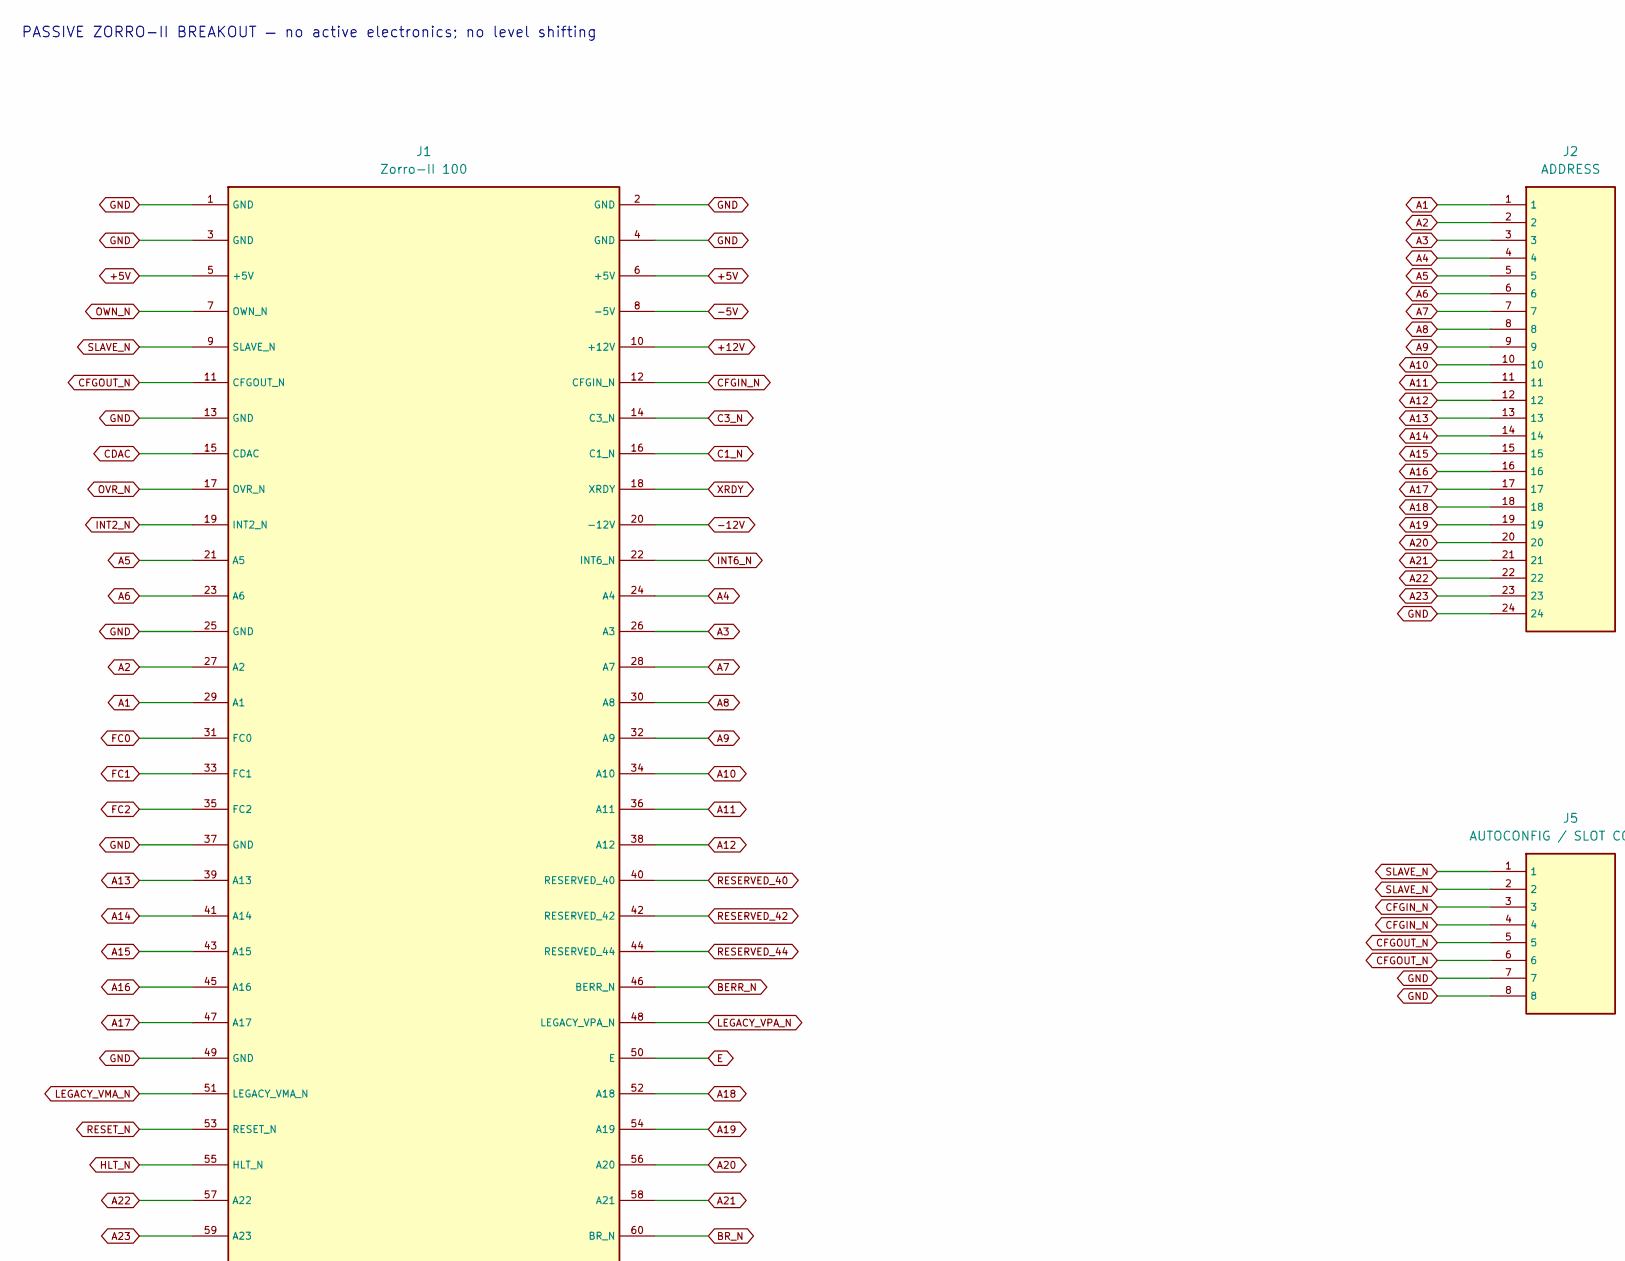
[picture p94: schematic zorro-breakout.kicad_sch, Passive Zorro-II development breakout, part in row 1, column 1]

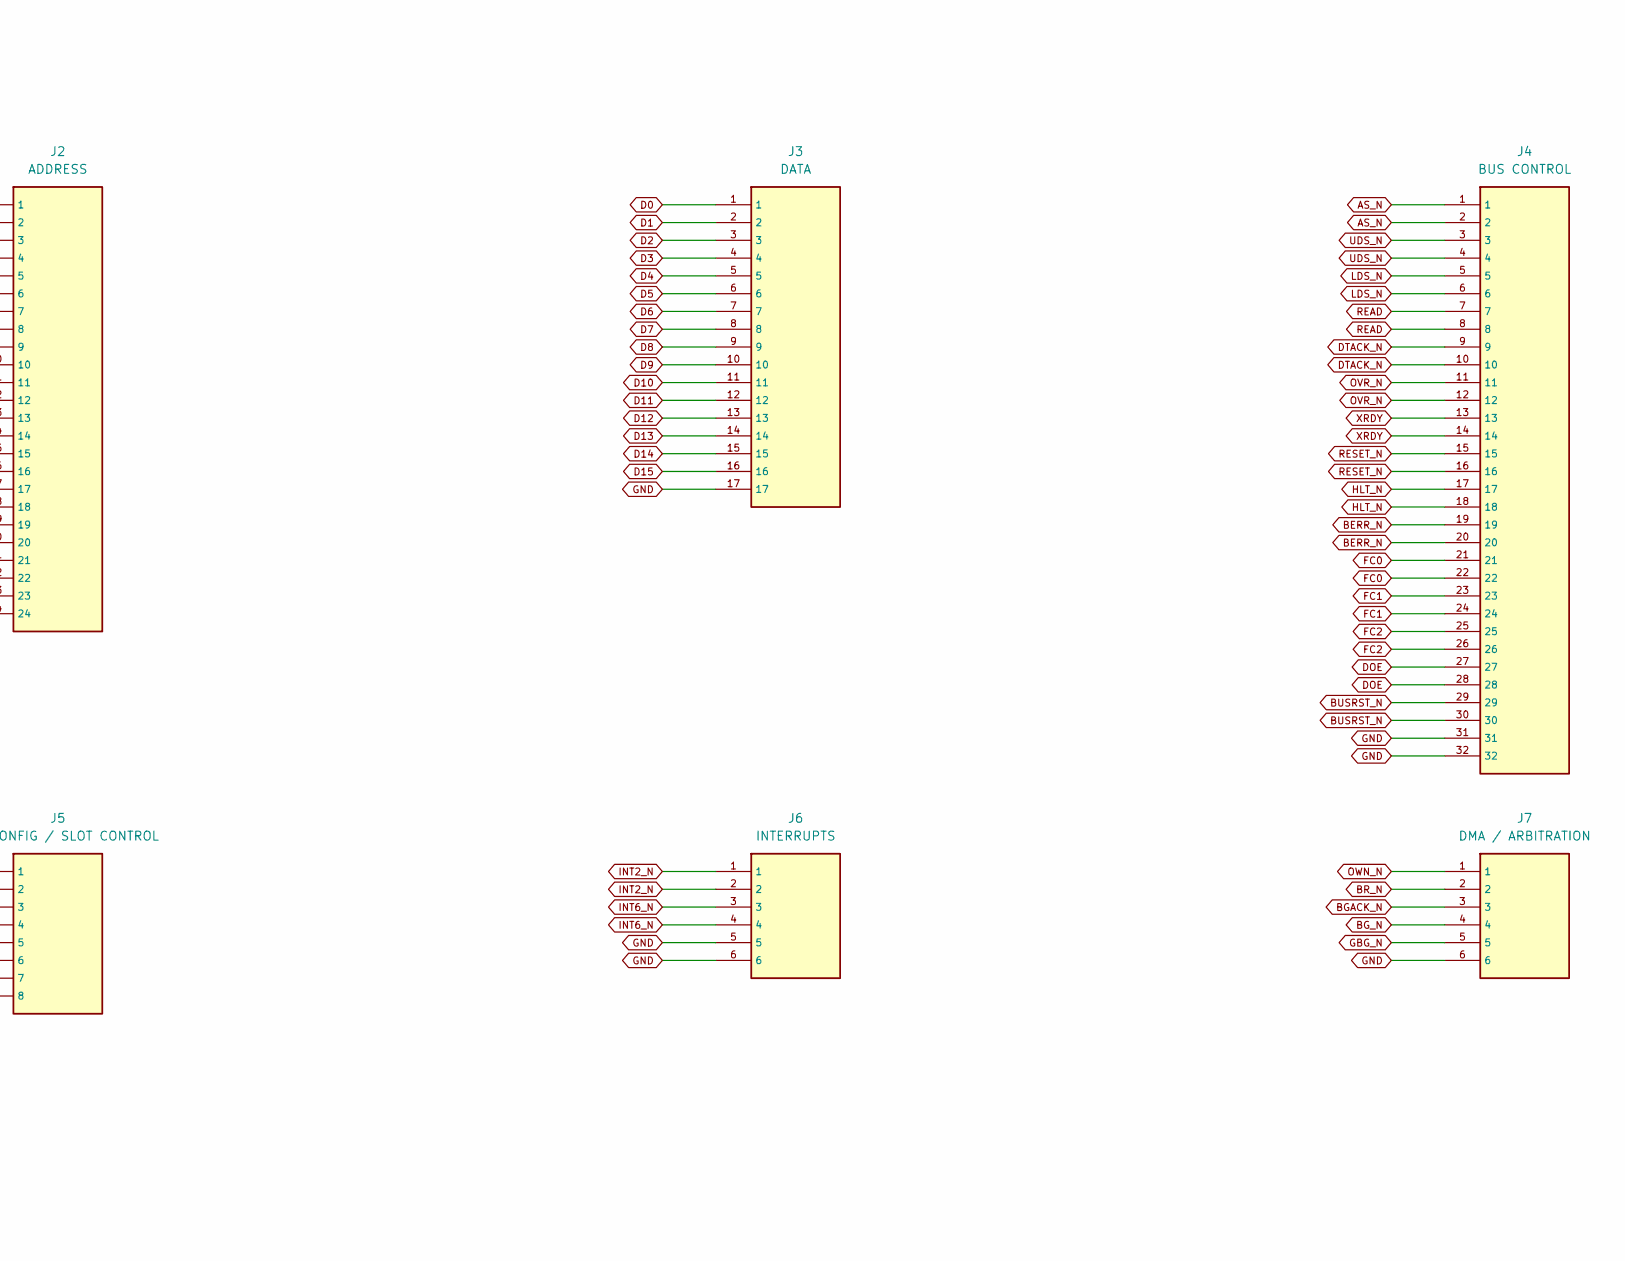
[picture p95: schematic zorro-breakout.kicad_sch, Passive Zorro-II development breakout, part in row 1, column 2]

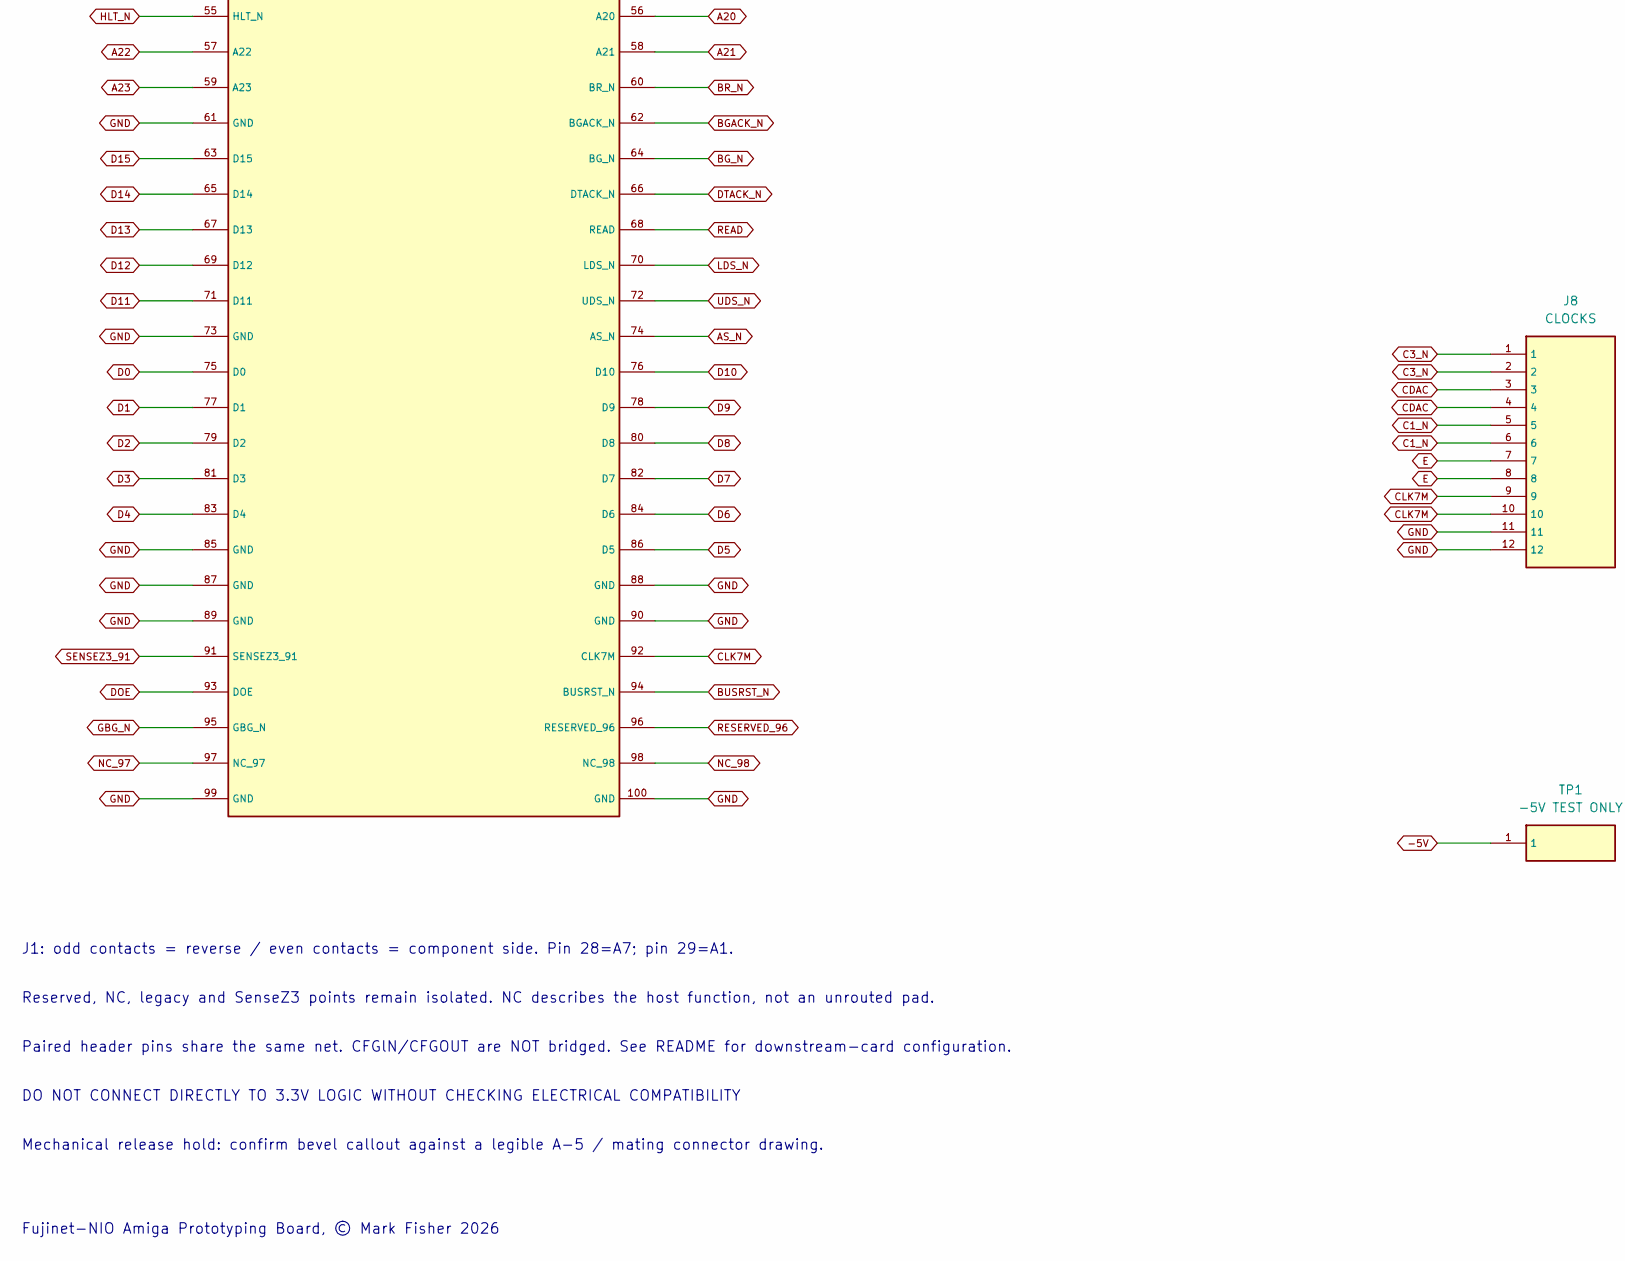
[picture p96: schematic zorro-breakout.kicad_sch, Passive Zorro-II development breakout, part in row 2, column 1]

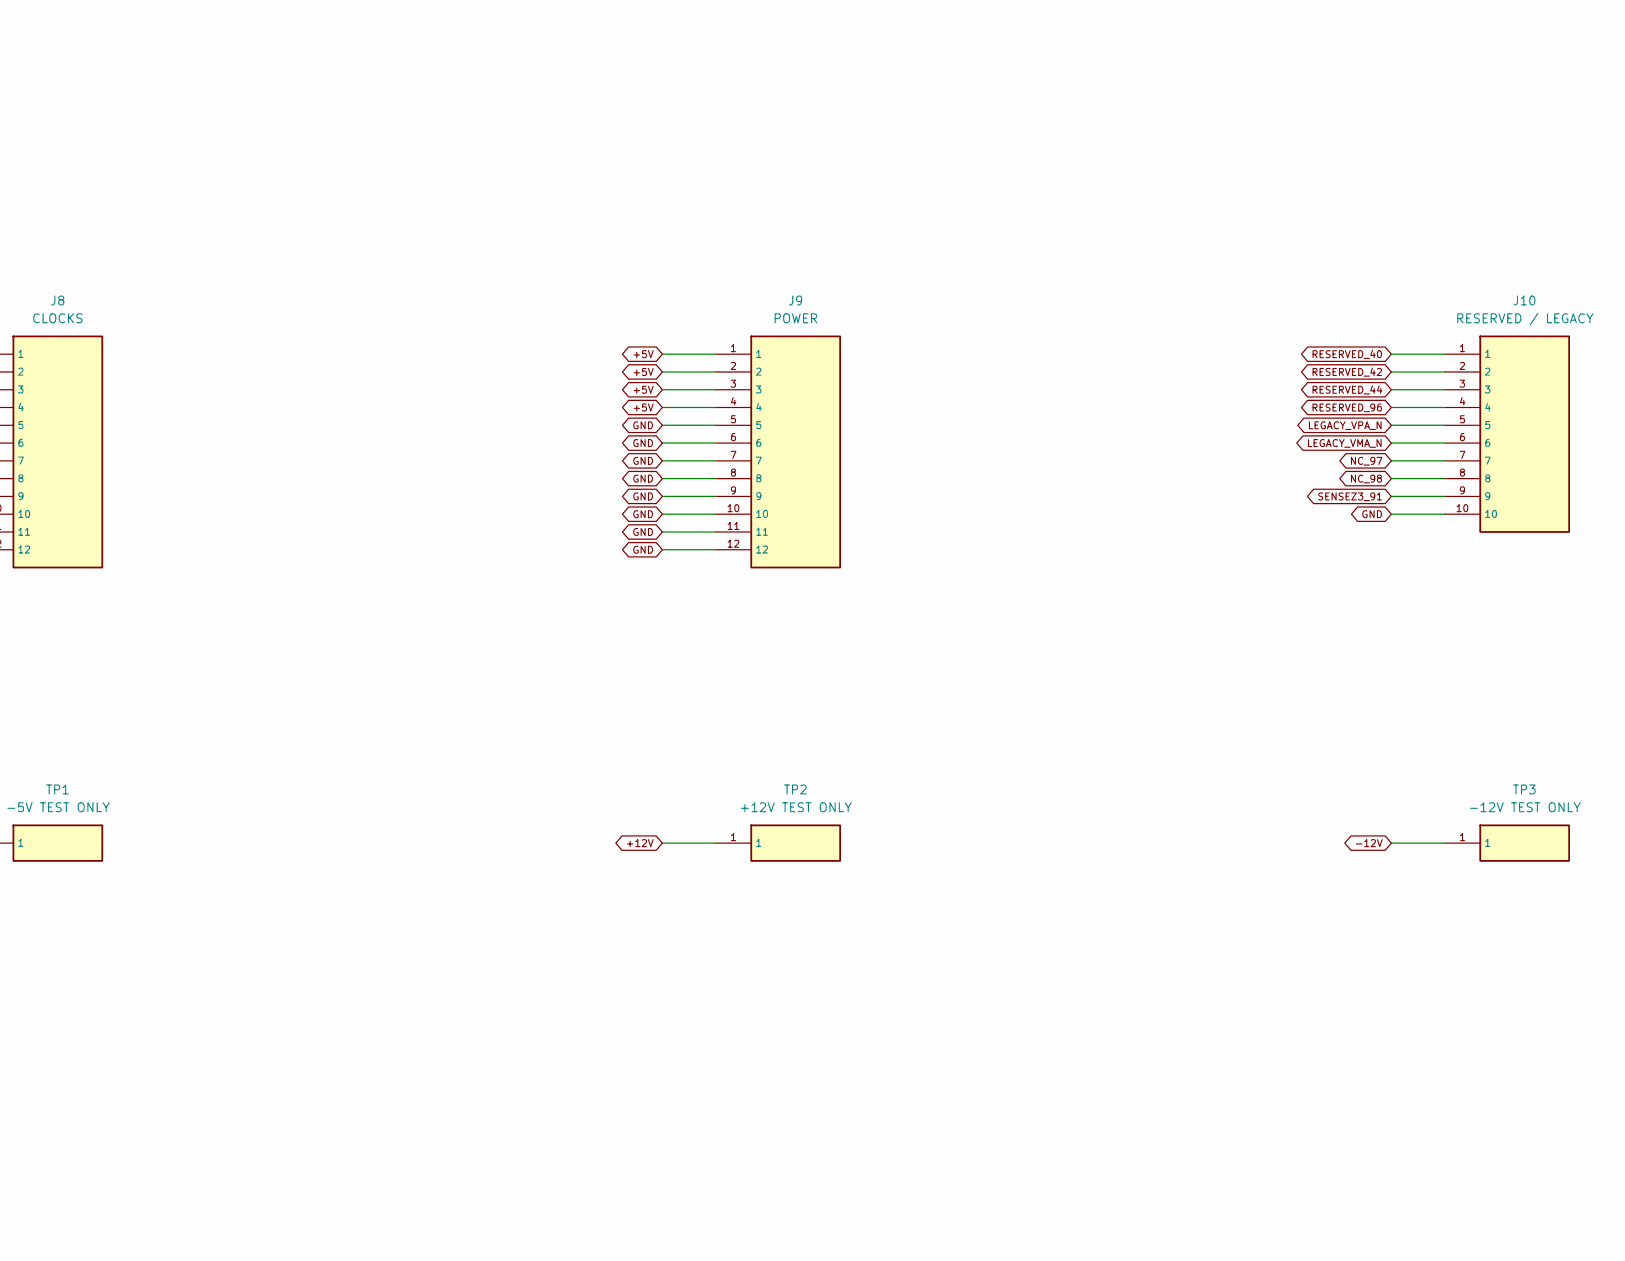
[picture p97: schematic zorro-breakout.kicad_sch, Passive Zorro-II development breakout, part in row 2, column 2]

Parts:
J1: Zorro-II 100; Zorro_II_100
J2: ADDRESS; Header_1x24
J3: DATA; Header_1x17
J4: BUS CONTROL; Header_2x16
J5: AUTOCONFIG / SLOT CONTROL; Header_2x04
J6: INTERRUPTS; Header_2x03
J7: DMA / ARBITRATION; Header_1x06
J8: CLOCKS; Header_2x06
J9: POWER; Header_2x06
J10: RESERVED / LEGACY; Header_1x10
TP1: -5V TEST ONLY; Header_1x01
TP2: +12V TEST ONLY; Header_1x01
TP3: -12V TEST ONLY; Header_1x01

Connections:
+5V: J1.5 (+5V), J1.6 (+5V), J9.1, J9.2, J9.3, J9.4
+12V: J1.10 (+12V), TP2.1
-5V: J1.8 (-5V), TP1.1
-12V: J1.20 (-12V), TP3.1
A1: J1.29 (A1), J2.1
A2: J1.27 (A2), J2.2
A3: J1.26 (A3), J2.3
A4: J1.24 (A4), J2.4
A5: J1.21 (A5), J2.5
A6: J1.23 (A6), J2.6
A7: J1.28 (A7), J2.7
A8: J1.30 (A8), J2.8
A9: J1.32 (A9), J2.9
A10: J1.34 (A10), J2.10
A11: J1.36 (A11), J2.11
A12: J1.38 (A12), J2.12
A13: J1.39 (A13), J2.13
A14: J1.41 (A14), J2.14
A15: J1.43 (A15), J2.15
A16: J1.45 (A16), J2.16
A17: J1.47 (A17), J2.17
A18: J1.52 (A18), J2.18
A19: J1.54 (A19), J2.19
A20: J1.56 (A20), J2.20
A21: J1.58 (A21), J2.21
A22: J1.57 (A22), J2.22
A23: J1.59 (A23), J2.23
AS_N: J1.74 (AS_N), J4.1, J4.2
BERR_N: J1.46 (BERR_N), J4.19, J4.20
BGACK_N: J1.62 (BGACK_N), J7.3
BG_N: J1.64 (BG_N), J7.4
BR_N: J1.60 (BR_N), J7.2
BUSRST_N: J1.94 (BUSRST_N), J4.29, J4.30
C1_N: J1.16 (C1_N), J8.5, J8.6
C3_N: J1.14 (C3_N), J8.1, J8.2
CDAC: J1.15 (CDAC), J8.3, J8.4
CFGIN_N: J1.12 (CFGIN_N), J5.3, J5.4
CFGOUT_N: J1.11 (CFGOUT_N), J5.5, J5.6
CLK7M: J1.92 (CLK7M), J8.9, J8.10
D0: J1.75 (D0), J3.1
D1: J1.77 (D1), J3.2
D2: J1.79 (D2), J3.3
D3: J1.81 (D3), J3.4
D4: J1.83 (D4), J3.5
D5: J1.86 (D5), J3.6
D6: J1.84 (D6), J3.7
D7: J1.82 (D7), J3.8
D8: J1.80 (D8), J3.9
D9: J1.78 (D9), J3.10
D10: J1.76 (D10), J3.11
D11: J1.71 (D11), J3.12
D12: J1.69 (D12), J3.13
D13: J1.67 (D13), J3.14
D14: J1.65 (D14), J3.15
D15: J1.63 (D15), J3.16
DOE: J1.93 (DOE), J4.27, J4.28
DTACK_N: J1.66 (DTACK_N), J4.9, J4.10
E: J1.50 (E), J8.7, J8.8
FC0: J1.31 (FC0), J4.21, J4.22
FC1: J1.33 (FC1), J4.23, J4.24
FC2: J1.35 (FC2), J4.25, J4.26
GBG_N: J1.95 (GBG_N), J7.5
GND: J1.1 (GND), J1.2 (GND), J1.3 (GND), J1.4 (GND), J1.13 (GND), J1.25 (GND), J1.37 (GND), J1.49 (GND), J1.61 (GND), J1.73 (GND), J1.85 (GND), J1.87 (GND), J1.88 (GND), J1.89 (GND), J1.90 (GND), J1.99 (GND), J1.100 (GND), J2.24, J3.17, J4.31, J4.32, J5.7, J5.8, J6.5, J6.6, J7.6, J8.11, J8.12, J9.5, J9.6, J9.7, J9.8, J9.9, J9.10, J9.11, J9.12, J10.10
HLT_N: J1.55 (HLT_N), J4.17, J4.18
INT2_N: J1.19 (INT2_N), J6.1, J6.2
INT6_N: J1.22 (INT6_N), J6.3, J6.4
LDS_N: J1.70 (LDS_N), J4.5, J4.6
LEGACY_VMA_N: J1.51 (LEGACY_VMA_N), J10.6
LEGACY_VPA_N: J1.48 (LEGACY_VPA_N), J10.5
NC_97: J1.97 (NC_97), J10.7
NC_98: J1.98 (NC_98), J10.8
OVR_N: J1.17 (OVR_N), J4.11, J4.12
OWN_N: J1.7 (OWN_N), J7.1
READ: J1.68 (READ), J4.7, J4.8
RESERVED_40: J1.40 (RESERVED_40), J10.1
RESERVED_42: J1.42 (RESERVED_42), J10.2
RESERVED_44: J1.44 (RESERVED_44), J10.3
RESERVED_96: J1.96 (RESERVED_96), J10.4
RESET_N: J1.53 (RESET_N), J4.15, J4.16
SENSEZ3_91: J1.91 (SENSEZ3_91), J10.9
SLAVE_N: J1.9 (SLAVE_N), J5.1, J5.2
UDS_N: J1.72 (UDS_N), J4.3, J4.4
XRDY: J1.18 (XRDY), J4.13, J4.14

Notes on the sheet:
PASSIVE ZORRO-II BREAKOUT — no active electronics; no level shifting
J1: odd contacts = reverse / even contacts = component side. Pin 28=A7; pin 29=A1.
Reserved, NC, legacy and SenseZ3 points remain isolated. NC describes the host function, not an unrouted pad.
Paired header pins share the same net. CFGlN/CFGOUT are NOT bridged. See README for downstream-card configuration.
DO NOT CONNECT DIRECTLY TO 3.3V LOGIC WITHOUT CHECKING ELECTRICAL COMPATIBILITY
Mechanical release hold: confirm bevel callout against a legible A-5 / mating connector drawing.
Fujinet-NIO Amiga Prototyping Board, © Mark Fisher 2026

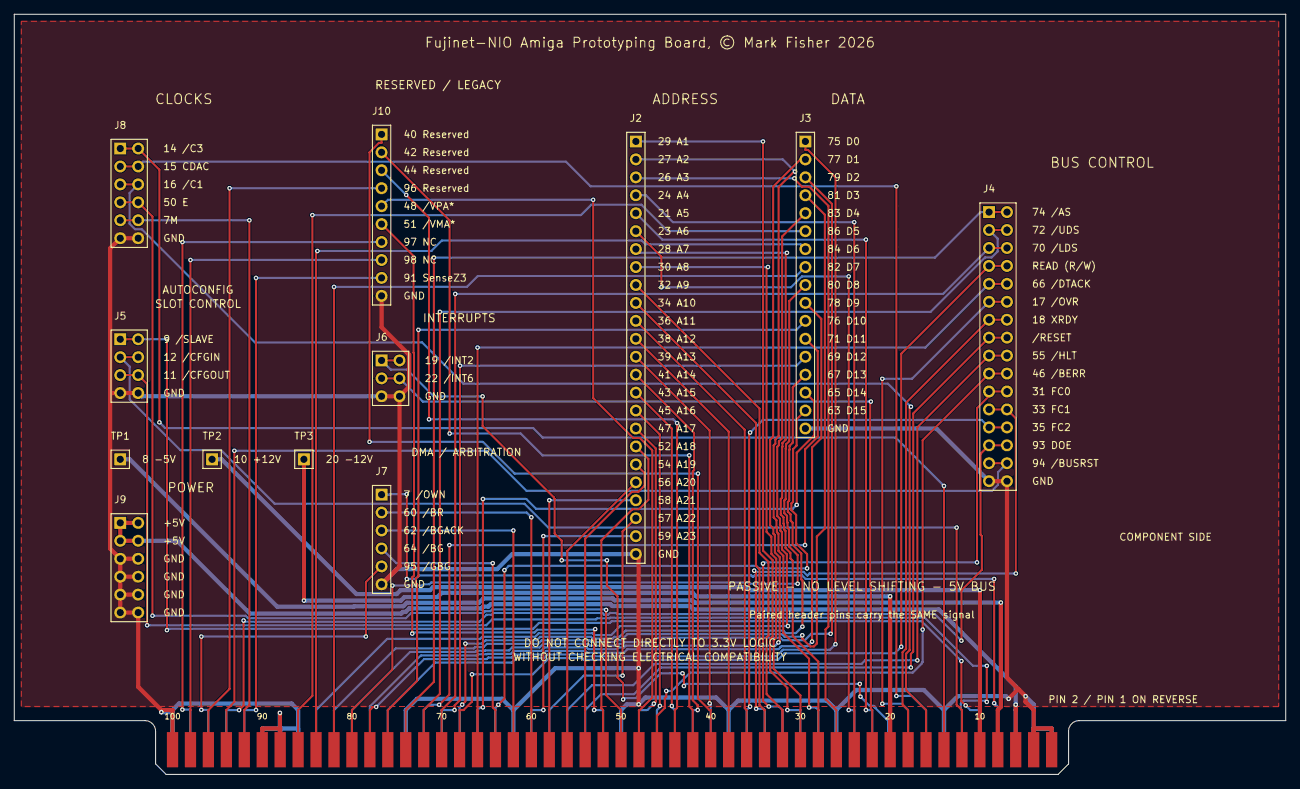
[picture p98: board zorro-breakout.kicad_pcb from above]

Board: 2 copper layers, 180.0 x 107.6 mm, 13 parts (0 on the bottom side), 83 nets.
