markjfisher/fujinet-nio-hardware/(commit log)

2026-09-10 Add the prototype board spec for the agent to use
2026-09-10 Add prototype board for zorro-ii on amiga
    [bom.csv, pin-map.csv, verification.csv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]
2026-09-10 Updated with EDAC 100 pin part
2026-09-11 Another round based on correct adapter being inserted into
2026-09-11 Fabrication ready stage
    [zorro-breakout-B_Cu.gbl, zorro-breakout-B_Mask.gbs, zorro-breakout-B_Silkscreen.gbo, zorro-breakout-Edge_Cuts.gm1, zorro-breakout-F_Cu.gtl, zorro-breakout-F_Mask.gts, zorro-breakout-F_Silkscreen.gto, zorro-breakout-NPTH.drl]
2026-09-11 Changed to 2 layer design
    [zorro-breakout-B_Cu.gbl, zorro-breakout-B_Mask.gbs, zorro-breakout-B_Silkscreen.gbo, zorro-breakout-Edge_Cuts.gm1, zorro-breakout-F_Cu.gtl, zorro-breakout-F_Mask.gts, zorro-breakout-F_Silkscreen.gto, zorro-breakout-NPTH.drl]
2026-09-11 Create script for packaging fabrication assets, and run it (touches all generated files)
    [zorro-breakout-B_Cu.gbl, zorro-breakout-B_Mask.gbs, zorro-breakout-B_Silkscreen.gbo, zorro-breakout-Edge_Cuts.gm1, zorro-breakout-F_Cu.gtl, zorro-breakout-F_Mask.gts, zorro-breakout-F_Silkscreen.gto, zorro-breakout-NPTH.drl]
2026-09-13 Update to be within 10% limits for pcbway instead of crazy 0.1mm
    [zorro-breakout-B_Cu.gbl, zorro-breakout-B_Mask.gbs, zorro-breakout-B_Silkscreen.gbo, zorro-breakout-Edge_Cuts.gm1, zorro-breakout-F_Cu.gtl, zorro-breakout-F_Mask.gts, zorro-breakout-F_Silkscreen.gto, zorro-breakout-NPTH.drl]
2026-09-23 docs(zorro): align prototype specification pin map
2026-09-27 Add pin mapping and some kicad templates for expansion port - WIP
2026-09-27 Update pin map doc with link to zorro pins
2026-09-30 fix: remove hardcoded developer paths from the prototyping board
    - check.py rewrites the absolute schematic path kicad-cli records in
    review/schematic.net.xml to a repo-relative one; the committed netlist
    gets the same one-line change
    - READMEs source env.sh by relative path, which finds the workspace
    itself, instead of exporting one machine's NIO_WORKSPACE
    [check.py]
2026-10-27 docs: capture RP2350 ESP32 link options
2026-11-09 Set up pinned KiCad MCP workflow and verify local CAD operations
2026-11-09 Add integrated R0 USB power and recovery schematic candidate
    Verify 170 pin assignments, four USB switch states and the 81-pad RP2350 allocation with independent KiCad export; ERC has zero findings. Keep processor/Zorro implementation and PCB layout explicitly open.
2026-11-09 Add direct A500 integrated circuit candidate with native net and logic checks
2026-11-09 Correct A500 candidate handshake with XRDY and per-cycle latches
    Preserve R1 and released hardware. Validate R2 with native KiCad whole-net checks, 65536 static cases and 65536 latch sequences; retain 32 external-host ERC findings. Record timing allocation and remaining electrical/layout gates.
2026-11-09 Add A500 R3 protected-input circuit and native power checks
2026-11-09 Record PCBWay adapter files and observed connector mounting uncertainty
2026-11-09 Verify A500 socket signal numbering against supplied Matze schematic
2026-11-09 Verify supplied Matze Gerbers and record edge-solder connector geometry
2026-11-09 Select owner-identified Wing Tat connector as horizontal sidecar reference
2026-11-09 Record exact Wing Tat ED86BGFBK supplier lead
2026-11-09 Add A500 R4 socket footprint and checked PCB placement
    Verify 864 functional pin assignments, 86 socket lands and zero native schematic/PCB parity findings. Retain unrouted status, ERC model findings and outstanding USB hole-clearance and antenna silk DRC findings.
2026-11-09 Fit A500 placement to measured adapter envelope
    Use a 111 by 117 mm rectangle with an 18 mm component-free connector band. Preserve socket geometry and relative critical-cell placement; verify native parity, full-band clearance and unchanged retained DRC findings.
2026-11-09 Group A500 circuit cells and restore readable PCB references
    Relocate supply capacitors, organize the buck cell, and retain all reference labels at a consistent size. Native checks preserve 864 assignments, zero schematic parity findings, and the existing six DRC findings. Inspect top and bottom placement previews; board remains unrouted.
2026-11-09 Clarify A500 component labels and refine reviewed placement areas
    Separate ambiguous references, align R53 and centre SW4, and space RP support components while preserving reference regulator geometry. Native parity remains zero with the original six DRC findings; inspect updated placement preview and confirm five-pin gate packages.
2026-11-10 First pass at optimisation documentation for amiga board
2026-11-10 Audit A500 slow inputs and propose conditioning with power-state blockers
2026-11-10 Revise dual-source power proposal and document A500 current-budget blocker
2026-11-10 Record mandatory USB power and isolate host-interface supervision blocker
2026-11-10 Checkpoint authoritative R4 CAD before bus protection and Phase 1 substitutions
2026-11-10 Add incremental Phase 1 CAD migrations and native verification gates
2026-11-10 Supervise host and both logic rails with hardware bus disable and hold-up
2026-11-10 Document Phase 1 protection limits, verification results and preserved PCB staging
2026-11-10 Prepare R4 placement constraints and bulk-capacitor selection; resolve Q5 ERC warning
2026-11-10 Apply approved Panasonic hold-up capacitor footprints without moving components
2026-11-10 Document pinned CadMust-Neo integration and read-only KiCad 10 compatibility checks
2026-11-10 After loading in kicad
2026-11-10 Place R5 USB power review candidate with pad-level checks
    Preserve approved RP baseline and all 167 unselected footprints. MCP placement, native DRC/ERP parity and via-access checks; no routing.
2026-11-10 Transfer approved R5 USB power placement through MCP
2026-11-10 Place R5 ESP32 and microSD candidate for visual review; verify isolation and parity
2026-11-11 Transfer approved R5 ESP32 microSD placement and retain access constraints
2026-11-11 Add R5 PWR NET DISK indicator candidate with alternative LED assemblies and verified netlist
2026-11-11 Transfer approved R5 LED and service placement; verify schematic parity
2026-11-11 Propose front-side R5 microSD capacitors; verify nets and placement preservation
2026-11-11 Accept R5 front-side capacitor placement and record single-sided population
2026-11-11 Update gitignore to remove kicad temp files
